besm6/micro-besm/README.md

# micro-besm
Replica of micro-BESM computer

Visit the [Wiki section](https://github.com/besm6/micro-besm/wiki) for details.
