besm6/micro-besm/doc/microbesm-spec.odt

| | | | | | | | | | Микро-БЭСМ Технический проект Ревизия Дата A0 9 октября 2016 г. Авторы: Сергей Вакуленко

# Назначение

Микро-БЭСМ, она же МКБ-8601, она же Ретро-86 — настольный компьютер конца 80-х, совместимый по архитектуре с ЭВМ БЭСМ-6. Он был разработан в конце 80-х в Лаборатории Вычислительной Техники и Автоматизации ОИЯИ в Дубне под руководством Левчановского Ф.В. и Силина И.Н. МКБ-8601 был способен выполнять все программы оригинальной БЭСМ-6, от теста АУ/УУ и до фортранного транслятора. Имел собственную ОС, способную интерпретировать экстракоды ОС Дубна и ОС Диспак. Система команд включала команды старой Б6 и собственный оригинальный набор. Процессор был построен на микросхемах серии K1804 (аналог Am2900).

Настоящий проект ставит задачу повторить микро-БЭСМ на современной элементной базе (FPGA), используя сохранившиеся исходные тексты микрокоманд, тестов и операционной системы.

Миссия проекта:

- Сохранение исторического наследия советской инженерной школы и, в частности, архитектурной линии БЭСМ-6.

Требования к проекту:

- Сохранение программной совместимости, с БЭСМ-6 на уровне системы команд и мониторной системы «Дубна».
- Поддержка 64-битного режима процессора как расширения архитектуры БЭСМ-6.
- Реализация схемотехнической части на языке Verilog (SystemVerilog) и возможность запуска всей системы на симуляторе, включая операционную систему.
- Возможность запуска на современных широко доступных платах FPGA.
- Ценовая доступность компонентов нового БК по цене. Предполагается упор на продажу в виде недорогих комплектов для самостоятельной сборки (конструкторов).
- Открытые исходные тексты и техническая документация;

# Блок-схема процессора

════════100═разрядов═════════════Общая═шина═══════════════════

▲ ▲

х │8 х │64

▼ ▼

┌──────┐ ┌───────────────────────────────┐ ┌────────┐

│ БОИ │ │ Б О И │ │ │

│ тег: │ │ RG0 │ RG1 │ RG2 │ RG3 │ │ ППЗУ │

│1-ком.│ │ физ. │команда│операнд│резуль-│ │ кон- │

│2-oпep│ │ адрес │ л,п │ │ тат │ │ стант │

│3-рез.│ └───────────────────────────────┘ └───┬────┘

└┬───В─┘ ▲ С ▲ В ▲ А │

С│▲ ▲ ┌───┐ │64 │64 │64 │64

││ │ │кэш├─┤ │ ▼ ▼

▼▼ │ └───┘ ▼ ══════Шина═D═══════════════64═разряда════════

прер.│ ┌───────┐ ▲ │ │ ▲ ▲ ▲ ▲

по │ │ станд.│ │ │ │64 │32 │64 │7 │7

тегу │ │команд │ │ │ ▼ │ │ │ │

│ └┬─┬──┬─┘ │ │ ┌─────────┐ ┌─┴─┐ ┌──┴──┐ ┌──┴──┐ ┌──┴──┐

│ │ │ │ 32│ │ │ МПС │ │OЗY│ │сдвиг│ │поиск│ │номер│

│ │4│ │ │ │ │ РЗУ:АЛУ │ │moд│ │ │ │л.ед.│ │ ед. │

│ ▼ │ │20 │ │ ├─────┬┬┬┬┘ └───┘ └─────┘ └─────┘ └─────┘

│ ИP│ ▼ │ │ │ ││││ ▲ ▲ ▲ ▲ ▲

│ │ ┌───┤ │ │ ▼▼▼▼ │ │ │ │ │

│ │ │АК │ │ │ D ┌────┐ │ │ ┌┴─┐ │ │

│8 │8 └───┘ │ │ ◄─┤CYCC│ │32 │64│ПC│ │64 │32

│ │ │ │64 └────┘ │ │ └──┘ │ │

│ │ │ │ ▲ │ │ ▲ │ │

▼ │ ▼ ▼ │4 │ │ │7 │ │

╤═╤════════════Шина═Y═══╤═══╤╧═══╤═╧═64═разряда═══╧═══════╧═══

│ │ ▲ │ ▲ │ │ │ ▲

│ │32 │ └────────│────│───│──┐ │ ┌───┐ │

│ │ │ │ ▼8 │5 │ └►│ ШФ├──┬────┐ ▼

│ │ ┌─┴─┐ ┌───┐ │ ┌───┐ │ │ ├───┤ │ ▼12 ┌──────┐

│ │ │РГ.│ │ │ │ │PHП│ │ └──►│ПHA│ │ ┌────┐ │ ОЗУ │

│ └►│иcп├──►│OЗY│◄─┘ └─┬─┘ ▼ │KOП├──┤ │CYAM│ │oбмена│

│ │aдp│ │пр.│ │ ┌───┐ ├───┤ │ └────┘ └──────┘

│ └─┬─┘ └───┘ ▼ │PHГ│ │ПHA│ │ │◄───┐ ▲

│ │ ┌──────────┐ D └─┬─┘ │i/o├──┤ ▼ │ │

│ └─►│ост.по aдp├──► │ ├───┤ │ ┌────┐ │ ▼

│10 └──────────┘halt 6▼ ┌──►│ПHA│ │ │ППЗY│ │ ┌──────┐

│ ┌►D D vect│int├──┤ │ OЗY│ │ │ блок │

│ │ ┌──────┐ ├───┤ │ │ МП │ ├─┤ связи│

│ │ │ БОБР │ 2 │ПHA│ │ └─┬──┘ │ │ с ПП │

│ ┌──┴──┐ │ БИЗМ │◄───►D │гр.├──┘ │◄───┘ └───┬──┘

└►│ РФС ├──►│──────│ 1 └───┘ ▼ │

└──┬──┘ │ БМСП │◄───►D ┌────┐ ▼

│ └──────┘ │ КР │ к ПП

│ ┌─────┐ ├────┤

│ │ ОЗУ │◄───Y │....│

└─────►│пpиop├───►D ▼....▼

│ стр.│ управление

└─────┘

┌────┐ Y ┌─────┐ КОП ┌──────┐ упр-е

──►│блoк│ ──►│ тай-│ арб.│ │ БОИ,

...│пре-│ │ мер,├─►D ───►│apбитр├──────►

──►│рыв.├───► │часы ├──► │ │магист-

└────┘vест └─────┘прер. └──────┘ ралью

# Формат микрокомандного слова

112 | 111 | 110 | 109 | 108 | 107 | 106 | 105 | 104 | 103 | 102 | 101 | 100 | 99 | 98 | 97 | 96 | 95 | 94 | 93 | 92 | 91 | 90 | 89 | 88 | 87 | 86 | 85
SQI | | | | А | | | | | | | | | | | | МАР | | ALU | ALUD | | | FUNC | | | ALUS

84 | 83 | 82 | 81 | 80 | 79 | 78 | 77 | 76 | 75 | 74 | 73 | 72 | 71 | 70 | 69 | 68 | 67 | 66 | 65 | 64 | 63 | 62 | 61 | 60 | 59 | 58 | 57 | 56
Н | RВ | | | | RА | | | | CI | | SHMUX | | | | SТОРС | | | | | | MOD | MNSA | | MODNM
| | | | | | | | | | | | | | | | | | | | | | PSHF

55 | 54 | 53 | 52 | 51 | 50 | 49 | 48 | 47 | 46 | 45 | 44 | 43 | 42 | 41 | 40 | 39 | 38 | 37 | 36 | 35 | 34 | 33 | 32 | 31 | 30 | 29
DSRC RTIME WTIME | | | | YDST | | | | SHF | | ARBI | | | | RLD | LЕТС | CYSTR | | | SCI | ICI | IСС | ISE | СЕМ | CEN | CSM | WЕМ

28 | 27 | 26 | 25 | 24 | 23 | 22 | 21 | 20 | 19 | 18 | 17 | 16 | 15 | 14 | 13 | 12 | 11 | 10 | 9 | 8 | 7 | 6 | 5 | 4 | 3 | 2 | 1
ЕСВ | WRB | BRA | | ЕСА | WRA | ARA | | YDEV YDEVT | | | WRY | DDEV YDTIM | | | WRD | IОМР | FFCNT | | | | | COND | | | | | MPS
| | | | | | | | | | | | | | | | | | MPADR

Описание полей микрокомандного слова:

Поле | Биты | Ширина | Описание

SQI

112-109

4

Код операции селектора адреса микропрограмм (СУАМ).

0 — JZ, переход по нулевому адресу;

1 — CJS, условный переход к подпрограмме по адресу, подаваемому на вход D СУАМ;

2 — JМАР, переход по адресу D, выработка сигнала /МЕ;

3 — CJP, условный переход по адресу, подаваемому на вход D СУАМ;

4 — PUSH, загрузка стека и условная загрузка счетчика;

5 — JSRP, условный переход к подпрограмме по адресу, выбираемому из регистра/счетчика или со входа D СУАМ;

6 — CJV, условный переход по адресу D, выработка сигнала /VЕ;

7 — JRP, усл. переход по адресу, выбираемому из регистра/счетчика или со входа D СУАМ;

8 — RFCT, повторение цикла, если счетчик не равен 0;

9 — RРСТ, повторение по адресу, подаваемому на вход D СУАМ, если счетчик не равен 0;

10 — CRTN, условный возврат из подпрограммы;

11 — CJPP, условный переход по адресу, подаваемому на вход D СУАМ, и извлечение из стека;

12 — LDCT, загрузка счетчика и последовательная выборка;

13 — LООР, проверка условия окончания цикла;

14 — CONT, последовательная выборка;

15 — TWB, переход по одному из 3 адресов.
A | 108-97 | 12 | Адрес следующей микрокоманды или адрес ПЗУ констант.
МАР | 96-95 | 2 | Выбор источника адреса, поступающего на вход D СУАМ. 0 — РЕ, конвейерный регистр; 1 — МЕ, ПНА КОП основного или дополнительного формата, в зависимости от КОП основного формата (3FН = 077В); 2 — GRP, ПНА групп и микропрограммные признаки "След0" И "След1"; 3 — не используется (по умолчанию).
ALU | 94 | 1 | Разрешение выдачи информации из МПС на шину Y. По умолчанию — нет вывода (0).
ALUD | 93-91 | 3 | Управление приемниками результата АЛУ МПС. По умолчанию — нет загрузки в регистры (1). 0 — Q, загрузка в регистр Q; 1 — NО, выдача результата только на выход У, содержитое регистров не изменяется; 2 — ВА, загрузка в регистр в рзу, на выход У подается значение регистра А; 3 — В, загрузка в регистр в РЗУ; 4 — RSBQ, сдвиг вправо, загрузка F/2 в В, Q/2 в Q; 5 — RSB, сдвиг вправо, загрузка F/2 в В; 6 — LSBQ, сдвиг влево, загрузка 2F в В, 2Q в Q; 7 — LSB, сдвиг влево, загрузка 2F в В.
FUNC | 90-88 | 3 | Код операции АЛУ МПС. 0 — ADD, R + S + С0; 1 — SUBR, S − R − 1 + С0; 2 — SUBS, R − S − 1 + С0; 3 — OR, R | S; 4 — AND, R & S; 5 — NOTRS, ~R & S; 6 — EXOR, R ^ S; 7 — EXNOR, ~(R ^ S).
ALUS | 87-85 | 3 | Управление источниками операндов на входы АЛУ. 0 — AQ; 1 — АВ; 2 — ZQ; 3 — ZВ; 4 — ZА; 5 — DА; 6 — DQ; 7 — DZ.
Н | 84 | 1 | Управление числом разрядов, участвующих в операции АЛУ: 32 или 64. По умолчанию — 32 разряда (0).
RВ | 83-80 | 4 | Адрес регистра канала B МПС. По умолчанию — регистр WR6 (10). 64-разрядные регистры: 0 — А, сумматор; 1 — У, регистр младших разрядов; 2 — INTR, ГРП; 32-разрядные регистры (старшие 32 разряда не используются): 3 — РС, СЧАС; 4 — РССОРУ, РОП; 5 — DADR, ИАОП; Рабочие константы микропрограмм: 6 — HALF, FFFF_FFFF_0000_0000; 7 — ВУТЕ, 0000_0000_0000_00FF; 8 — EXPN, FFF0_0000_0000_0000; 9 — MANT, 000F_FFFF_FFFF_FFFF; Рабочие регистры микропрограмм: 10 — WR6, номер прерывания при внутренних прерываниях; 11 — WR5, данные при чт/зп в часы, таймеры СВ; 12 — WR4; 13 — WR3; 14 — WR2; 15 — WR1.
RА | 79-76 | 4 | Адрес регистра канала A МПС. (Аналогично RB выше)
CI | 75-74 | 2 | Управление входным переносом C0 АЛУ МПС, разряды I12-I11. 0 — CI0, С0 МПС = 0; 1 — CI1, С0 МПС = 1; 2 — CIX, С0 МПС = СХ; 3 — CIC, входной перенос с0 принимает значения NС, /NС, МС, /МС в зависимости от кодов операции I5-I1 СУСС.

SHMUX

73-70

4

Управление организацией сдвигов в МПС, разряды I9-I6 КОП СУСС.

Направление сдвига I10 задается разрядом I7 МПС.

Сдвиги вправо при I10=0:

0 — LSLSL, логический сдвиг вправо одинарный, освобождающийся разряд заполняется "0", МС не изменяется;

1 — NSNSL, сдвиг вправо одинарный, МС не изменяется, освобождающийся разряд заполняется "1";

2 — ASLLS, РЗУ: логический сдвиг вправо, освобождающийся разряд заполняется "0", выдвинутый бит попадает в МС; Q: арифметический сдвиг вправо, освобождающийся разряд заполняется значением MN; используется с К1804ВС2 при операции нормализации чисел обычной длины в качестве последнего шага нормализации (сдвиг в сторону младших разрядов);

3 — NDNS, сдвиг вправо двойной, освобождающиеся разряды заполняются "1", МС не изменяется;

4 — CDLDL, сдвиг вправо двойной, освобождающиеся разряды заполняются значением МС, МС не изменяется;

5 — ADNDL, арифметический сдвиг вправо двойной, МС не изеняется, освобождающиеся разряды заполняются значением MN; используется с К1804ВС2 при нормализации чисел двойной длины;

6 — LDLD, логический сдвиг вправо двойной, освобождающиеся разряды заполняются "0", МС не изменяется;

7 — LDLND, логический сдвиг вправо двойной, освобождающиеся разряды заполняются "0", выдвинутый из Q бит записывается в МС;

8 — RSLRSL, циклический сдвиг вправо одинарный, выдвинутый из РЗУ бит записывается в МС;

9 — RSSRSS, РЗУ: циклический сдвиг вправо совместно с содержимым МС, освобождающийся разряд заполняется значением МС, выдвинутый бит попадает в МС; Q: циклический сдвиг вправо;

10 — RSRS, циклический сдвиг вправо одинарный, МС не изменяется;

11 — IDCS, двойной сдвиг вправо с загрузкой в освобождающийся разряд значения IС (выходной перенос МПС), МС не изменяется; используется в повторяющихся микрокомандах сложения и сдвига при умножении и усреднении в арифметике без знака;

12 — RDSRDS, циклический сдвиг вправо двойной совместно с содержимым МС, освобождающийся разряд заполняется значением МС, выдвинутый разряд попадает в МС;

13 — RDLRDL, Циклический сдвиг вправо двойной, выдвинутый из Q разряд попадает в МС и старший разряд РЗУ;

14 — VDCD, двойной сдвиг вправо с загрузкой значения IN^IV в освобождающийся разряд, МС не изменяется; используется в повторяющихся микрокомандах сложения и сдвига в двоичной дополнительной арифметике (при умножении);

15 — RDRD, циклический сдвиг вправо двойной, МС не изменяется.

Сдвиги влево при I10=1:

0 — LSLSL, логический сдвиг влево одинарный с загрузкой МС, освобождающийся разряд заполняется "0";

1 — NSNSL, сдвиг влево одинарный с загрузкой МС, освобождающийся разряд заполняется "1";

2 — ASLLS, логический сдвиг влево одинарный, МС не изменяется, освобождающиеся разряды заполняются "0";

3 — NDNS, сдвиг влево одинарный, освобождающиеся разряды заполняются "1", МС не изменяется;

4 — CDLDL, сдвиг влево двойной с загрузкой МС, освобожд. разряды заполняются "0";

5 — ADNDL, сдвиг влево двойной с загрузкой МС, освобожд. разряды заполняются "1";

6 — LDLD, сдвиг влево двойной, освобождающиеся разряды заполняются "0", МС не изменяется;

7 — LDLND, сдвиг влево двойной, освобождающиеся разряды заполняются "1", MC не изменяется;

8 — RSLRSL, циклический сдвиг влево одинарный с загрузкой MC;

9 — RSSRSS, циклический сдвиг влево одинарный совместно с MC, освобождающийся разряд заполняется значением MC, выдвинутый разряд попадает в MC;

10 — RSRS, циклический сдвиг влево одинарный, MC не изменяется;

11 — IDCS, сдвиг влево одинарный, MC не изменяется, РЗУ: освобождающийся разряд заполняется значением MC; Q: освобождающийся разряд заполняется "0";

12 — RDSRDS, циклический сдвиг влево двойной совместно с содержимым MC, освобождающийся разряд заполняется значением MC, выдвинутый разряд попадает в MC;

13 — RDLRDL, циклический сдвиг влево двойной, выдвинутый бит попадает в MC и в освобождающийся разряд Q;

14 — VDCD, сдвиг влево двойной, MC не изменяется, освобождающиеся разряды заполняются значением MC;

15 — RDRD, циклический сдвиг влево двойной, MC не изменяется.

SТОРС

69-64

6

Разряды I5-I0 КОП СУСС, управляющие:

- микромашинным статусным регистром N;

- машинным статусным регистром М;

- выходом У;

- выходом кода условия;

- входным переносом С0 АЛУ МПС.

0 — УТОМ, MTON;

1 — SЕТМ, SETN;

2 — MCN, NСМ;

3 — CLRN, CLRM;

5 — INVM;

7 — ОРС7;

8 — CLRNZ;

9 — SETNZ;

10 — CLRNC;

11 — SETNC;

12 — CLRNN;

13 — SETNN;

14 — CLRNV;

15 — SETNV;

18 — ОРС18;

19 — ОРС19;

20 — NZ, по умолчанию;

21 — /NZ;

22 — NV;

23 — /NV;

26 — NС;

27 — /NС;

30 — NN;

31 — /NN;

32 — ОРС32;

33 — ОРС33;

34 — ОРС34;

36 — MZ;

37 — /MZ;

38 — MV;

39 — /MV;

42 — МС;

43 — /МС;

46 — MN;

47 — /MN;

52 — IZ;

53 — /IZ;

54 — IV;

55 — /IV;

58 — IС;

59 — /IС;

62 — IN;

63 — /IN.
MOD | 63 | 1 | Режим привилегированных команд 002 и 032, разрешающий обращение к специальным регистрам.
PSHF | 62-56 | 7 | Параметр сдвига сдвигателя, задающий число сдвигов и направление. 0x40 - SН0, параметр сдвига на 0 разрядов
MNSA | 62-61 | 2 | Адрес источника номера модификатора. По умолчанию — отсутствующий источник (2). 0 — U, регистр исполнительного адреса; 1 — IRA, поле модификатора команды; 3 — МР, микропрограмма.

MODNM

60-56

5

Номер модификатора в группе регистров, используемый в микропрограмме. Регистры 8-3 - область упрятывания регистров общего назначения и рабочие регистры микропрограмм.

0 — MREZ, резерв;

1 — PROCNC, номер процесса, равен содержимому РНП у активного процесса;

2 — SVFA, регистр адреса поля упрятывания;

3 — РССС, РОП;

4 — РСС, СЧаС;

5 — YCR, правая половина РМР;

6 — YCL, левая половина РМР;

7 — ACR, правая половина сумматора;

8 — ACL, левая половина сумматора;

9 — CTR, регистр счетного времени процесса, правая половина;

10 — CTL, регистр счетного времени процесса, левая половина;

11 — СТТ, таймер счетного времени процесса;

12 — SPRADR, указатель стека адресов возврата из подпрограмм РАВ;

13 — RRR, расширение регистра режимов, содержащее область упрятывания тега результата, номер предыдущей группы регистров и номер резервной группы регистров;

14 — RR, регистр режимов;

15 — С, регистр изменения адреса;

16 — SР, указатель магазина;

17 — М14;

18 — М13;

19 — М12;

20 — М11;

21 — М10;

22 — М9;

23 — М8;

24 — М7;

25 — М6;

26 — М5;

27 — М4;

28 — М3;

29 — М2;

30 — М1;

31 — М0.
DSRC | 55-52 | 4 | Управление источниками информации на шину D. 1 — MODGN, регистр номера группы ОЗУ модификаторов; 2 — PROCN, регистр номера процесса; 3 — CNT, триггеры признаков; 4 — PHYSPG, регистр физической страницы; 5 — ARBOPC, регистр КОП арбитра (для анализа при прерываниях); 8 — СОМА, адресная часть команды; 9 — SHIFT, результат сдвига; 10 — ОРС, код операции команды; 11 — LOS, результат поиска левой единицы; 12 — PROM, ППЗУ констант.
RTIME | 55-52 | 4 | Управление чтением информации с часов и таймера счетного времени. 14 — RТ, сигнал чтения часов, таймеров на шину У.
WTIME | 55-52 | 4 | Управление записью информации в часы и таймер счетного времени. 15 — WТ, сигнал записи в часы, таймеры с шины У (совместно с сигналом WRD).
YDST | 51-48 | 4 | Управление приемниками информации с шины Y ЦП. 1 — MODGN, регистр номера группы ОЗУ модификаторов; 2 — PROCN, регистр номера процесса РНП; 3 — CNT, регистр режимов и триггеры признаков; 4 — PHYSPG, регистр физической страницы РФС; 5 — ARBOPC, КОП арбитра (для пультового останова); 8 — ADRREG, регистр исполнительного адреса (запись); 9 — PSHIFT, регистр параметра сдвига (только запись); 10 — CCLR, запуск сброса кэша.
SHF | 47-46 | 2 | Код операции сдвигателя. 0 — CICL, циклический сдвиг вправо; 1 — LOG, логический сдвиг; 2 — ARIPH, арифметический сдвиг; 3 — EMULF, "расхлопывание" - переход к формату БЭСМ-6.
ARBI | 45-42 | 4 | Код операции арбитра общей шины. 1 — CCRD, чтение кэша команд; 2 — CCWR, запись в кэш команд; 3 — DCRD, чтение кэша операндов; 4 — DCWR, запись в кэш операндов; 8 — FЕТСН, чтение команды; 9 — DRD, чтение операнда; 10 — DWR, запись результата (не используется); 11 — RDMWR, чтение-модификация-запись (семафорная); 12 — BTRWR, запись в режиме блочной передачи; 13 — BTRRD, чтение в режиме блочной передачи; 14 — BICLR, сброс прерываний на шине; 15 — BIRD, чтение прерываний с шины.
RLD | 41 | 1 | Управление загрузкой регистра селектора адреса СУАМ и ШФ шин У ЦП и D СУАМ.
LЕТС | 40 | 1 | Управление прохождением признака ПИА на вход ПНА команд.
CYSTR | 39-37 | 3 | Управление длительностью тактового импульса. 1 — NТ3, 3 нанотакта; 0 — NТ4, 4 нанотакта; 4 — NТ5, 5 нанотактов; 6 — NТ6, 6 нанотактов; 2 — NТ7, 7 нанотактов; 3 — NТ8, 8 нанотактов; 7 — NТ9, 9 нанотактов; 5 — NТ10, 10 нанотактов = 500 нсек (по умолчанию).
SCI | 36 | 1 | Управление передачей условия на вход инкрементора регистра адреса микропрограммы. Условие, выбираемое полем COND, подается на вход CI СУАМ ("жду").
ICI | 35 | 1 | Инверсия условия, передаваемого на вход инкрементора регистра адреса микропрограммы (CI) СУАМ.
IСС | 34 | 1 | Инверсия условий, выбираемых полем COND, управляющих последовательностью исполнения микрокоманд.
ISE | 33 | 1 | Разрешение внешних и внутренних прерываний. Признак последней микроинструкции, разрешающий прохождение некоторых прерываний и копирование ТКК в ППК.
СЕМ | 32 | 1 | Разрешение записи в машинный регистр состояния М СУСС.
CEN | 31 | 1 | Разрешение записи в микромашинный регистр состояния N СУСС.
CSM | 30 | 1 | Управление обращением к ОЗУ модификаторов.
WЕМ | 29 | 1 | Разрешение записи в ОЗУ модификаторов.
ЕСВ | 28 | 1 | Выбор канала B БОИ данных.
WRB | 27 | 1 | Запись по каналу B в БОИ данных и БОИ тега.
BRA | 26-25 | 2 | Адрес регистра канала B БОИ даннных и БОИ тега. По умолчанию — 3 (чтобы не было случайной записи в RG0). 0 — RG0, физический адрес, в БОИ тега не используется; 1 — RG1, регистр левой-правой команды, в БОИ тега - тег команды; 2 — RG2, регистр операнда, в БОИ тега - тег операнда; 3 — RG3, регистр результата, в БОИ тега - тег результата (сумматора).
ЕСА | 24 | 1 | Выбор канала A БОИ данных.
WRA | 23 | 1 | Запись по каналу A в БОИ данных.
ARA | 22-21 | 2 | Адрес регистра канала A БОИ даннных. По умолчанию — 3 (чтобы не было случайной записи в RG0). 0 — RG0, физический адрес; 1 — RG1, регистр левой-правой команды; 2 — RG2, регистр операнда; 3 — RG3, регистр результата.
YDEV | 20-18 | 3 | Выбор источника или приемника информации с шины Y, управление — WRY. 2 — PHYSAD, физический адрес (только на чтение); 3 — RADRR, регистр исполнительного адреса (чтение); 4 — PSMEM, ОЗУ приписок (CS); 5 — МРМЕМ, ОЗУ обмена с ПП; 6 — SТОРМ0, ОЗУ останова 0 (только на запись); 7 — SТОРМ1, ОЗУ останова 1 (только на запись). Выборка ОЗУ останова совмещена с сигналом записи.
YDEVT | 20-18 | 3 | Выбор регистров БОИ тега, управление — WRB. 1 — ECBTAG, канал B БОИ тега (сигнал ЕСВ БОИ).
WRY | 17 | 1 | Запись в источники или приемники шины Y.
DDEV | 16-14 | 3 | Выбор источника или приемника информации с шины D, управление — WRD. 1 — ВВ, БОБР, БИЗМ; 2 — MODB, БМСП; 3 — CLRCD, сброс ПИА, дополнительный сигнал; 5 — STATUS, СУСС; 6 — РРМЕМ0, ОЗУ приоритетов страниц 0; 7 — РРМЕМ1, ОЗУ приоритетов страниц 1.
YDTIM | 16-14 | 3 | Выбор часов и таймера счетного времени, управление — RTIME, WTIME, WRD. 4 - CTIME, регистр и таймер счетного времени (сигнал CS).
WRD | 13 | 1 | Управление записью в источники или приемники шины D.
IОМР | 12 | 1 | Выбор дешифратора триггеров признаков или блока обмена с ПП, управляющих сигналов часов и таймера счетного времени (YDTIM=CTIME). 0 — Работает дешифратор триггеров признаков (FFCNT); 1 — Обмен с ПП в соответствии с MPADR, а также обращение к часам и таймеру счетного времени (при YDTIM=CTIME).

FFCNT

11-7

5

Установка/сброс триггеров признаков или управляющие сигналы А1, А0 для обращения к часам и таймеру.

1 — LOGGRP, установка логической группы;

2 — MULGRP, установка группы умножения;

3 — ADDGRP, установка группы сложения;

5 — SЕТС, установка триггера ПИА;

6 — CLRRCB, сброс триггера ППК;

7 — SETRCB, установка триггера ППК;

8 — CLRJMP, сброс триггера ППУ;

9 — SETJMP, установка триггера ППУ;

10 — SETEI, сброс маски прерываний (разрешение прерываний);

11 — CLREI, установка маски прерываний (запрет прерываний);

12 — CLRTR0, сброс микропрограммного признака "След0";

13 — SETTR0, установка мп признака "След0";

14 — CLRTR1, сброс мп признака "След1";

15 — SETTR1, установка мп признака "След1";

16 — CLRCT, сброс прерывания от часов счетного времени;

17 — CLRCTT, сброс прерывания от таймера счетного времени;

18 — CLRTKK, сброс триггера коммутации команд - ТКК (ППК стандартизатора);

19 — SЕТТКК, установка ТКК;

20 — SETNR, установка НР;

21 — STRTLD, запуск загрузки ОЗУ БМСП единицами;

22 — SETER, установка РЭ;

23 — СНТКК, переброс ТКК (работает в счетном режиме!);

24 — SETHLT, установка триггера "Останов" (Halt);

25 — CLRINT, сброс прерываний (кроме прерываний от таймеров);

26 — CLRRUN, сброс триггера "Пуск";

27 — RDMPCP, установка признака "ОЗУ обмена ПП -> ЦП прочитано";

28 — LDMPCP, установка признака "в ОЗУ обмена ПП -> ЦП есть информация";

29 — LDCPMP, установка признака "в ОЗУ обмена ЦП -> ПП есть информация";

30 — PRGINT, установка программного прерывания с номером 31;

31 — EXTINT, установка внешнего прерывания на магистраль.
MPADR | 10-7 | 4 | Адрес регистра в блоке обмена с ПП. Информационные байты обращений ЦП к ПП (используются ОС через WMOD): 0 — INFB1; 1 — INFB2; 2 — FСР, флаг для ПП по инициативе ЦП; 3 — FМР, флаг ПП-ЦП по инициативе ПП. Байты адреса регистра или внутренней памяти ЦП при обращениях ПП (в младшем по номеру регистре - старший байт адреса): 4 — ADRB1; 5 — ADRB2; 6 — ADRB3; 7 — ADRB4. Байты данных при обращениях ПП (в младшем по номеру регистре - старший байт данных): 8 — DАТАВ1; 9 — DАТАВ2; 10 — DАТАВ3; 11 — DАТАВ4; 12 — DАТАВ5; 13 — DАТАВ6; 14 — DАТАВ7; 15 — DАТАВ8.

COND

6-2

5

Выбор условия, подлежащего проверке.

0 — YES, "да";

1 — NORMB, блокировка нормализации (БНОР);

2 — RNDB, блокировка округления (БОКР);

3 — OVRIB, блокировка прерывания по переполнению (БПП);

4 — BNB, блокировка выхода числа за диапазон БЭСМ-6 (ББЧ);

5 — OVRFTB, блокировка проверки переполнения поля упрятывания (БППУ);

6 — DRG, режим диспетчера;

7 — EMLRG, режим эмуляции;

8 — RСВ, ППК;

9 — СВ, ПИА;

10 — CEMLRG, РЭС, 20-й разряд РР (резерв);

11 — СТ, сигнал СТ СУСС;

12 — TR1, След1;

13 — INTSTP, ПОП;

14 — IR15, ИР15;

15 — ТККВ, ТКК;

16 — RUN, "пуск" от ПП;

17 — NMLRDY, отсутствие готовности умножителя;

19 — INT, признак наличия прерываний;

20 — FULMEM, ОЗУ БМСП единицами заполнено;

21 — ARBRDY, готовность арбитра;

22 — TR0, След0;

23 — СРМР, ОЗУ обмена "ЦП -> ПП" свободно.
MPS | 1 | 1 | Управление выбором источника параметра сдвига. Задание параметра сдвига из микропрограммы, 56-62 разряды (1) или из регистра параметра сдвига (0).
