besm6/micro-besm/doc/schematics/page5a.pdf

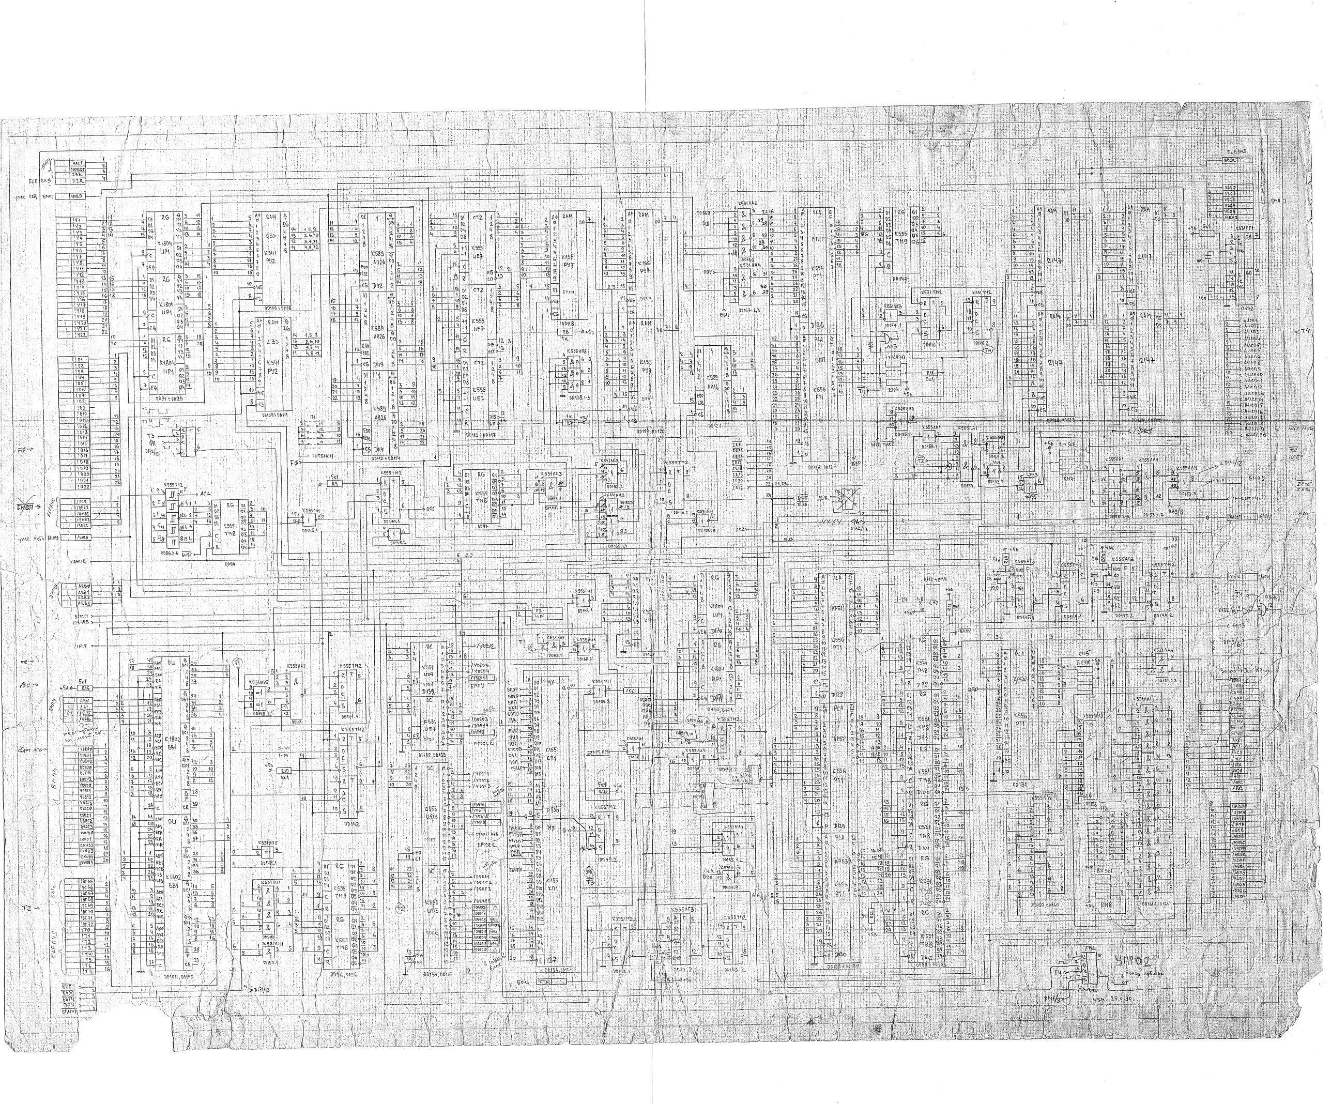
[picture p1: page 1]
