besm6/micro-besm/doc/schematics/page5b.pdf

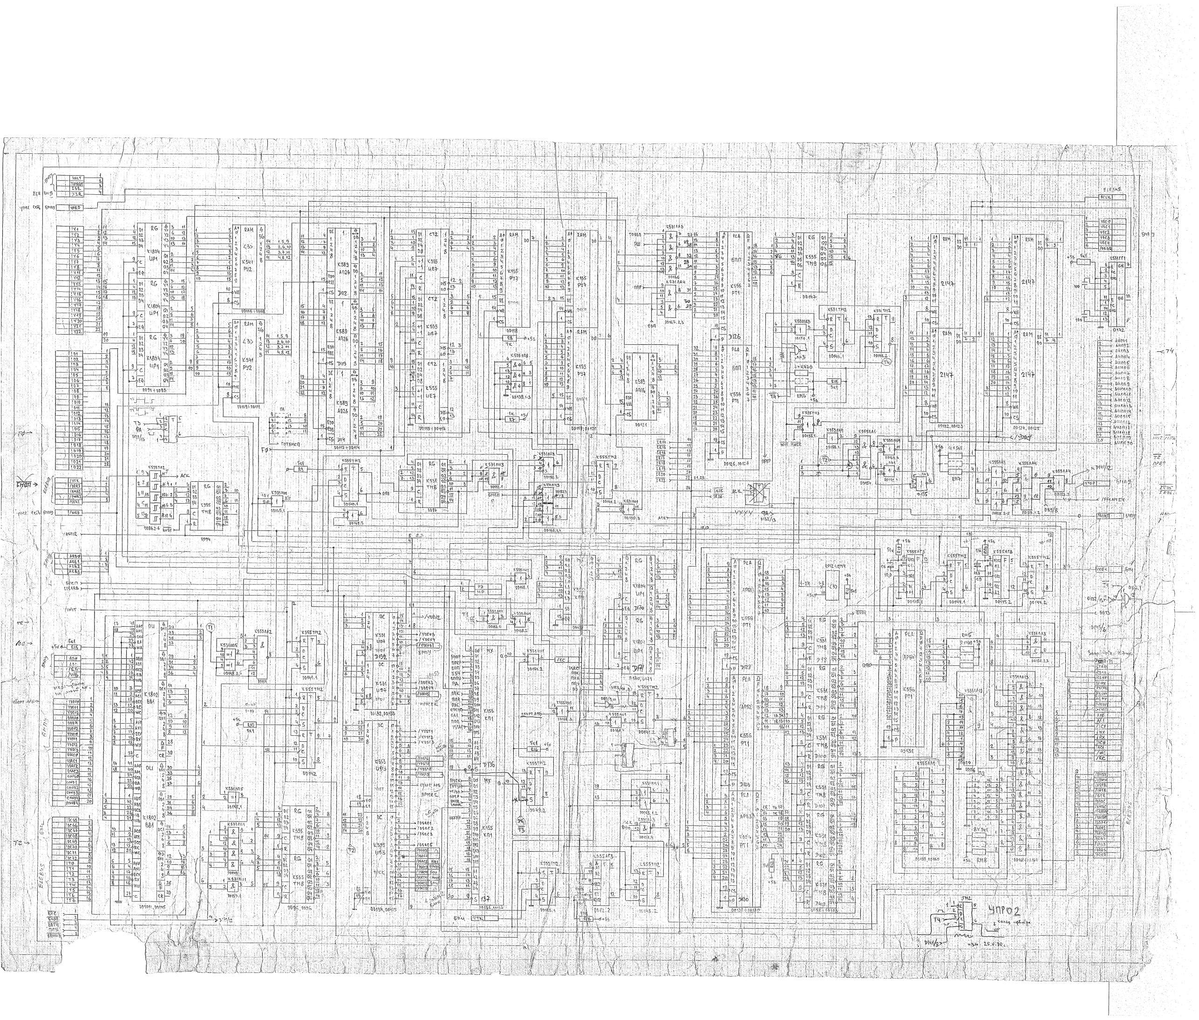
[picture p2: page 1]
