besm6/micro-besm/doc/schematics/page6.pdf

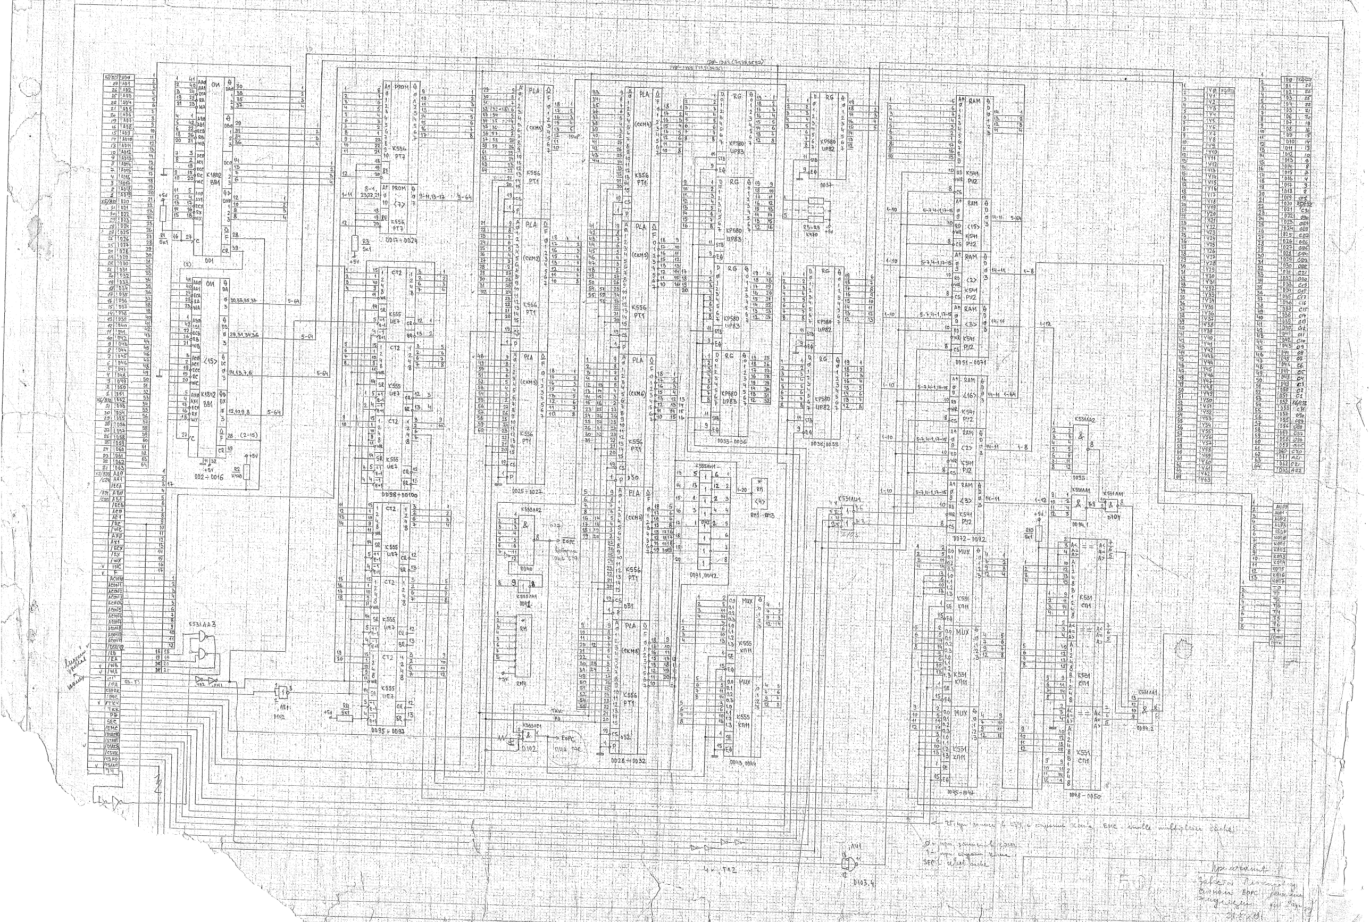
[picture p3: page 1]
