besm6/micro-besm/doc/schematics/page7.pdf

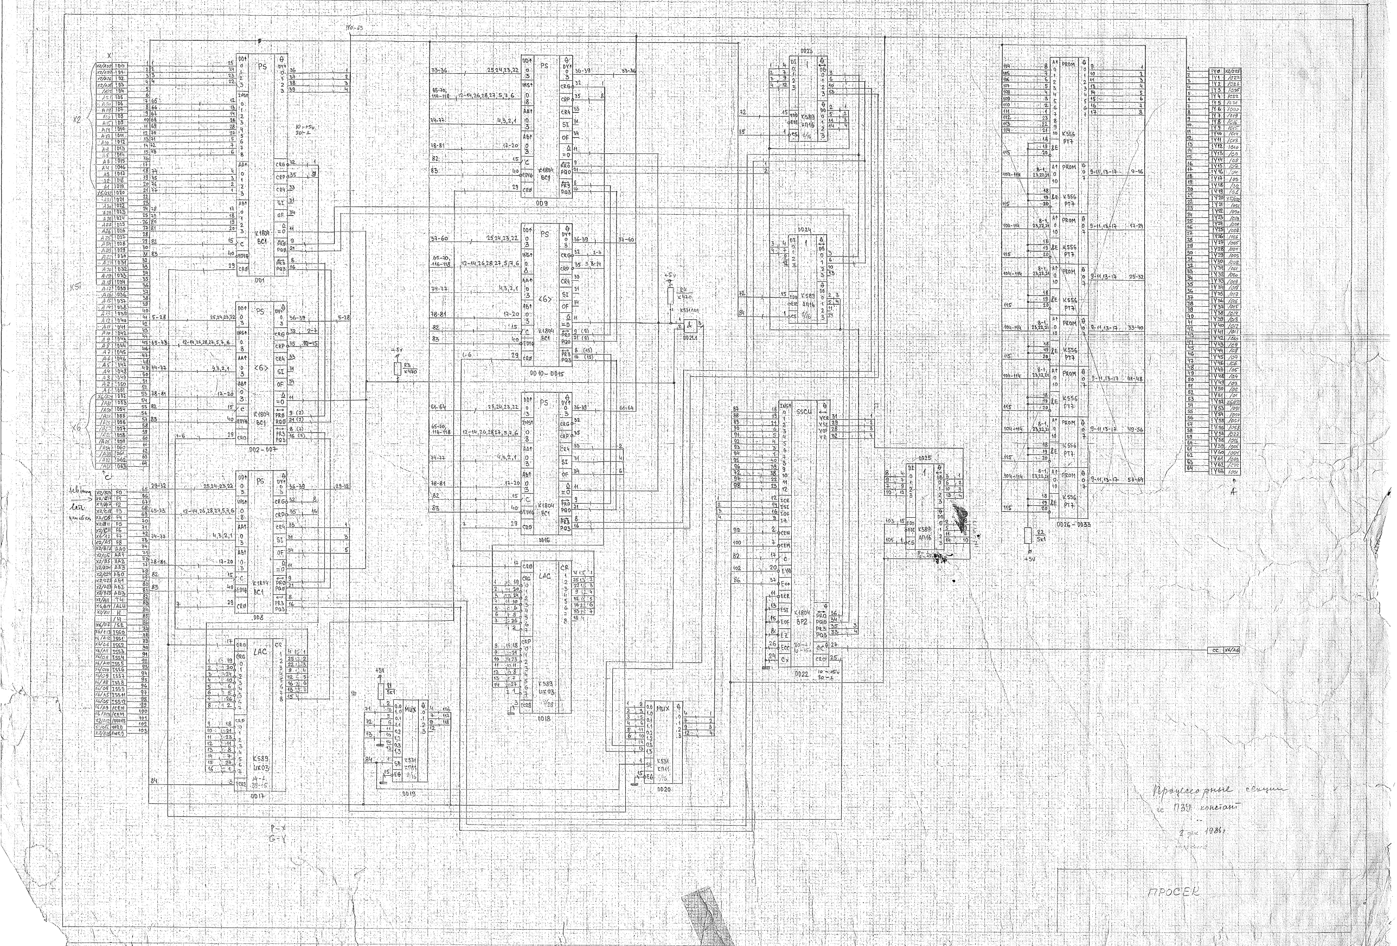
[picture p4: page 1]
