besm6/micro-besm/doc/schematics/page8a1.pdf

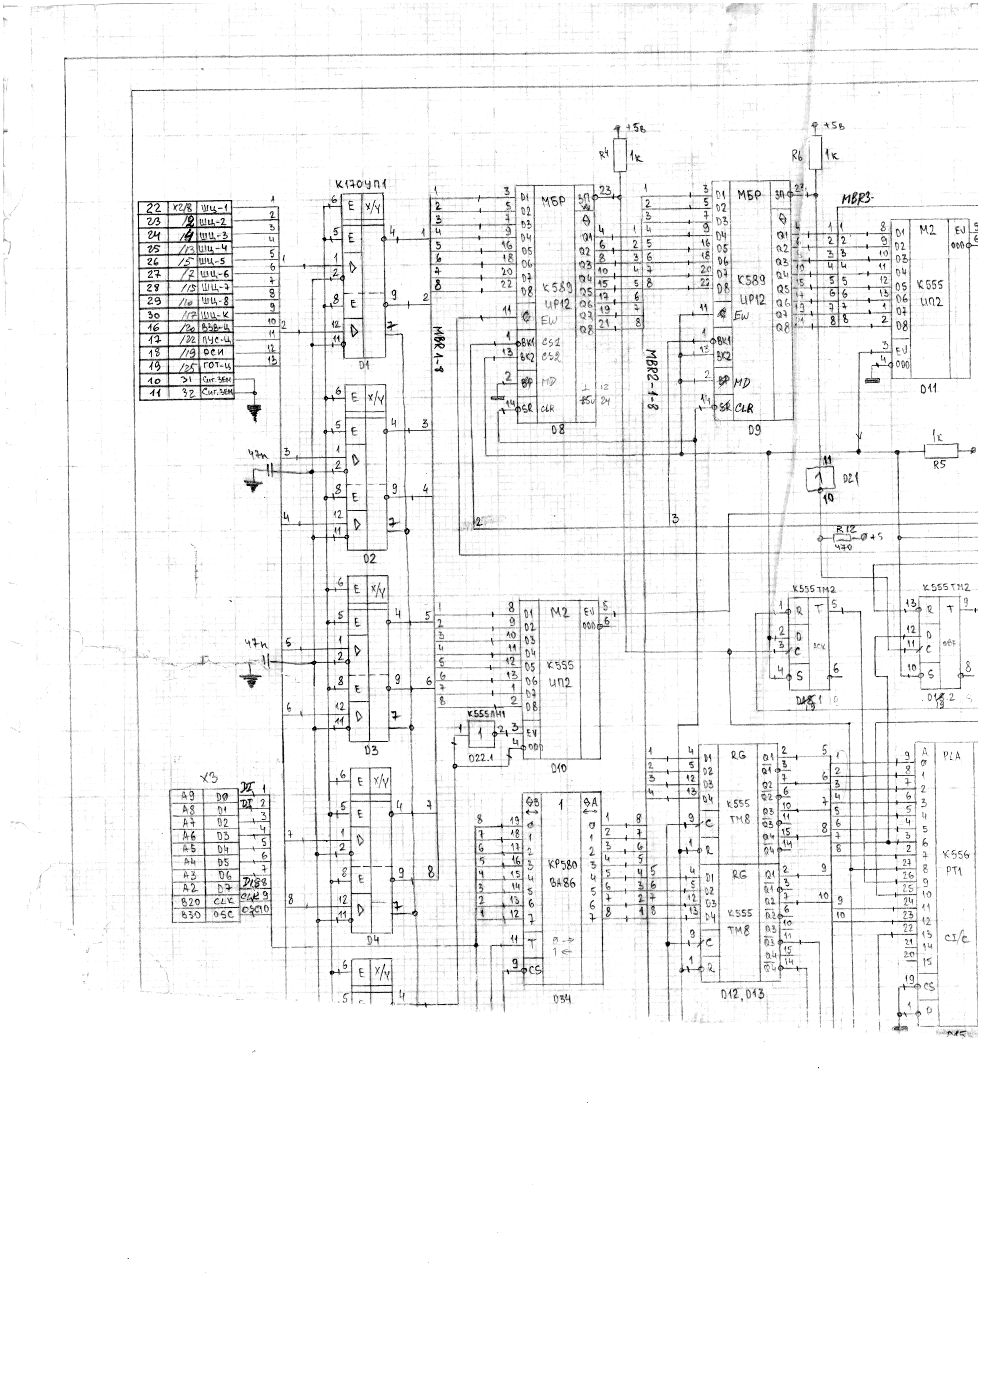
[picture p5: page 1]
