besm6/micro-besm/doc/schematics/page8a2.pdf

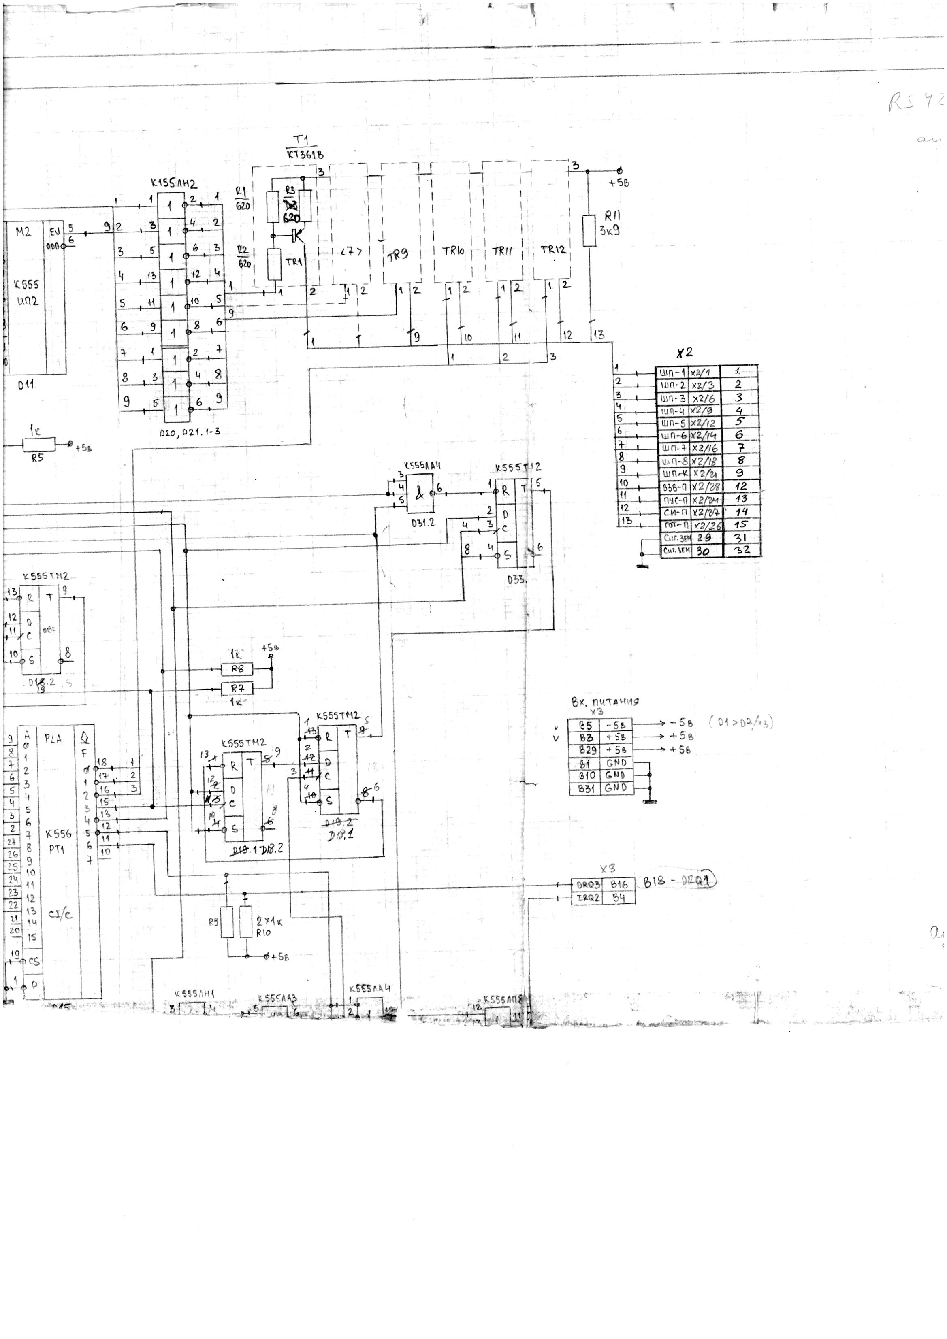
[picture p6: page 1]
