besm6/micro-besm/doc/schematics/page8a3.pdf

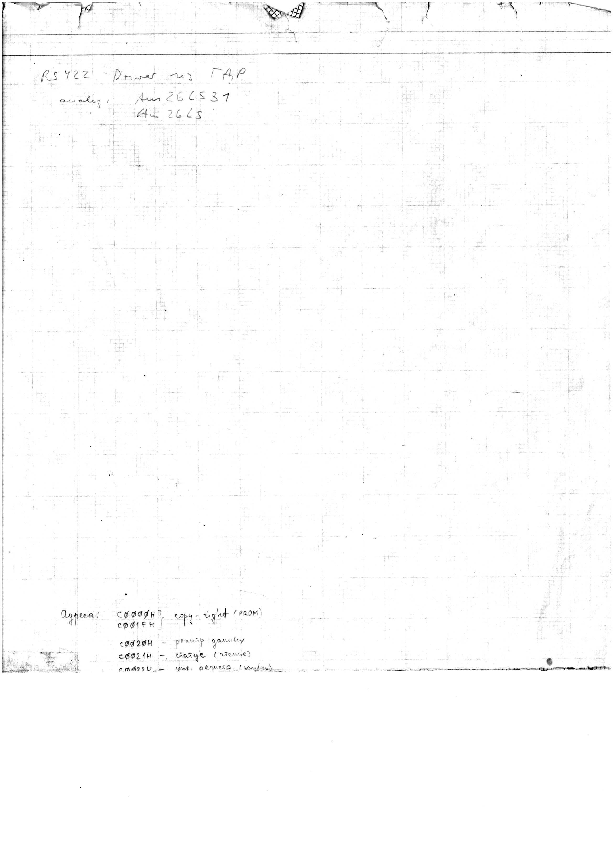
[picture p7: page 1]
