besm6/micro-besm/doc/schematics/page8b1.pdf

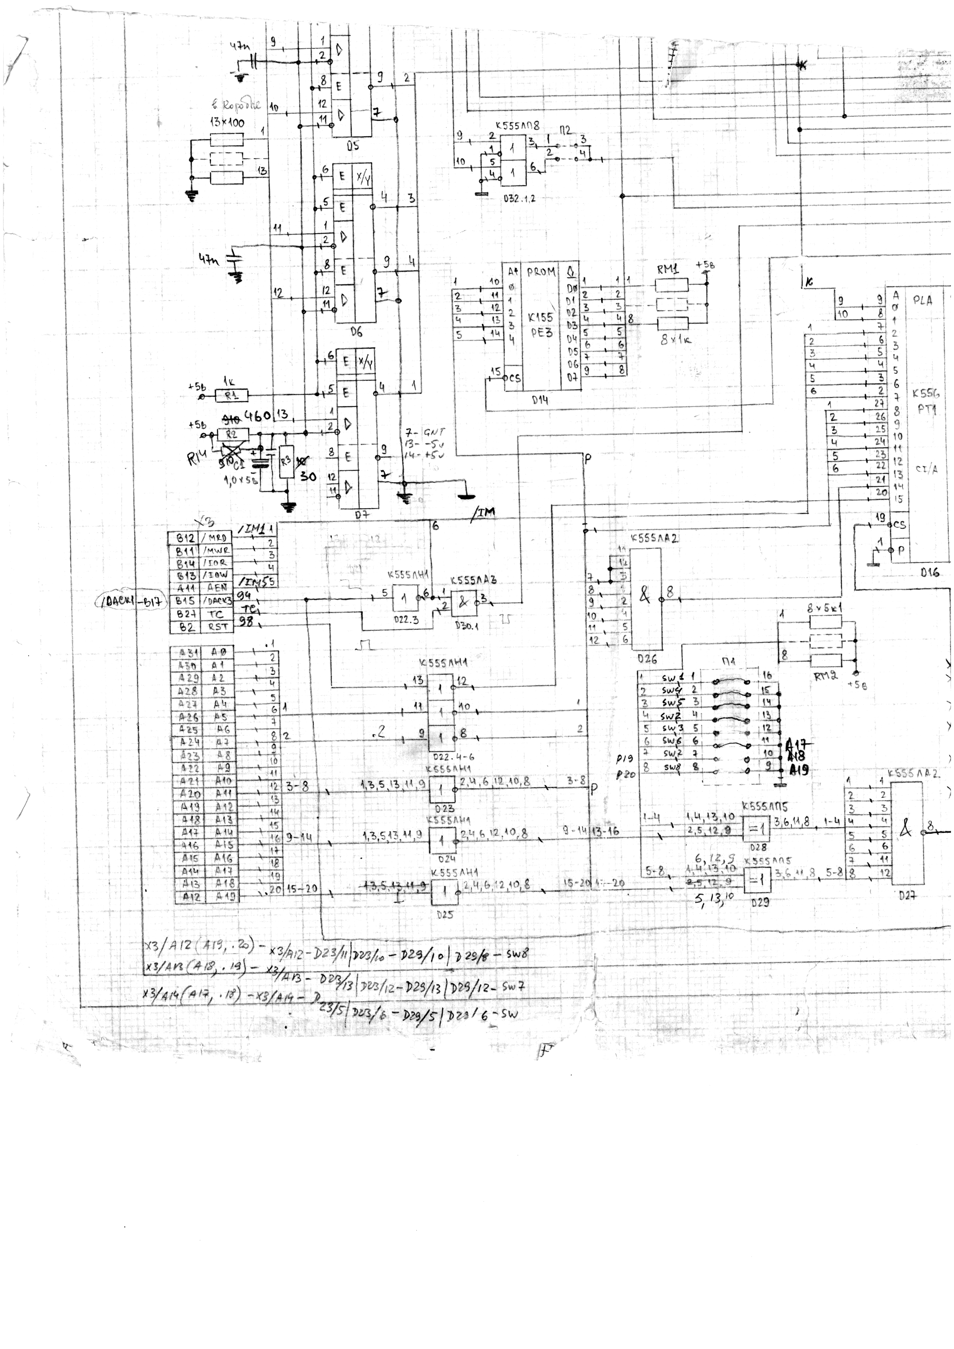
[picture p8: page 1]
