besm6/micro-besm/doc/schematics/page8b2.pdf

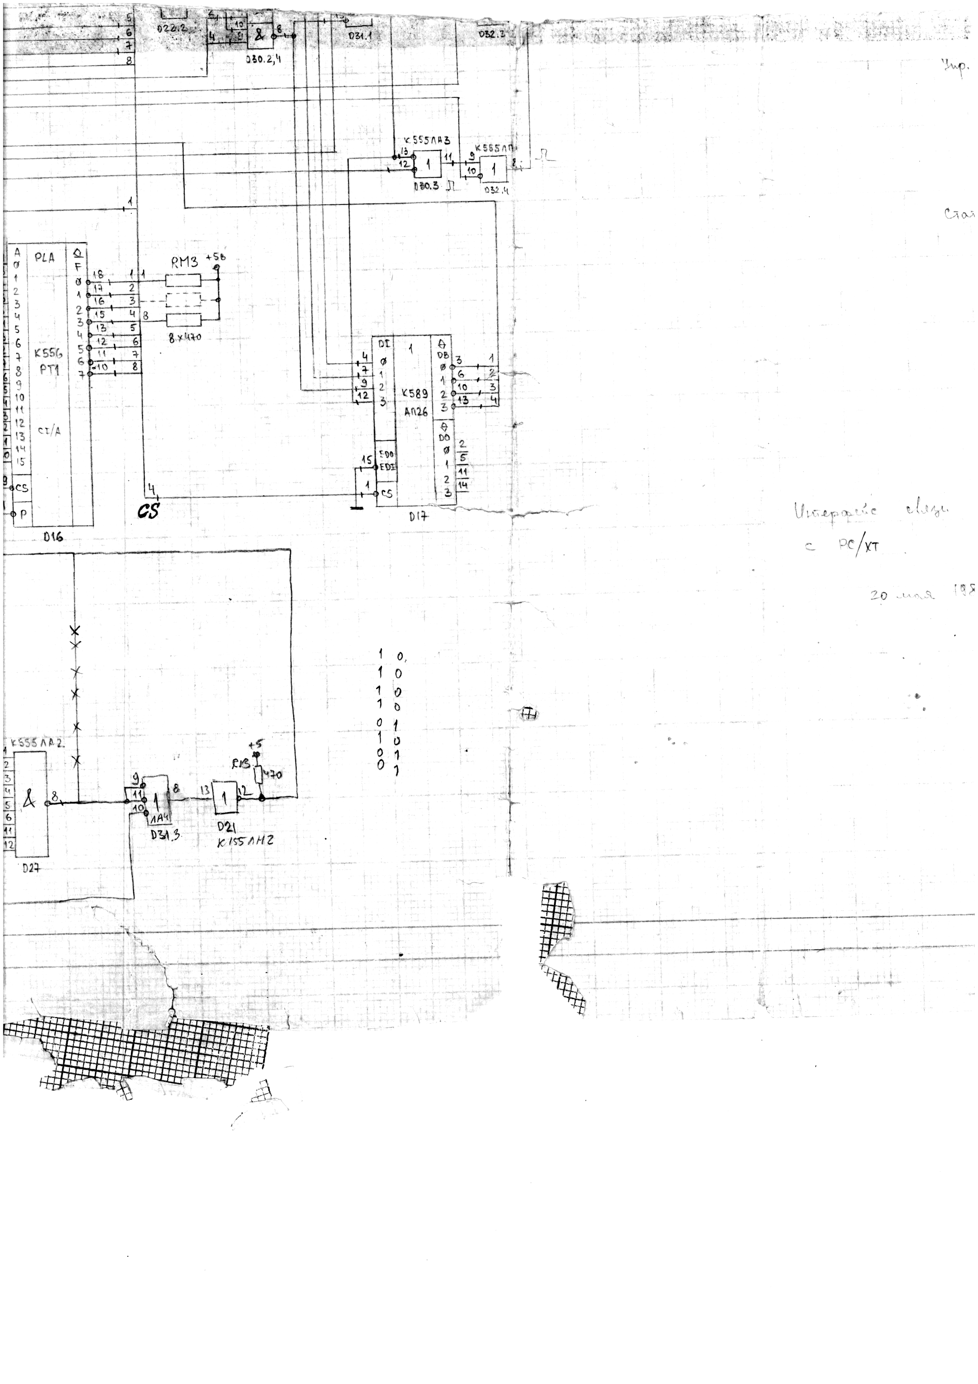
[picture p9: page 1]
