besm6/micro-besm/doc/schematics/page8b3.pdf

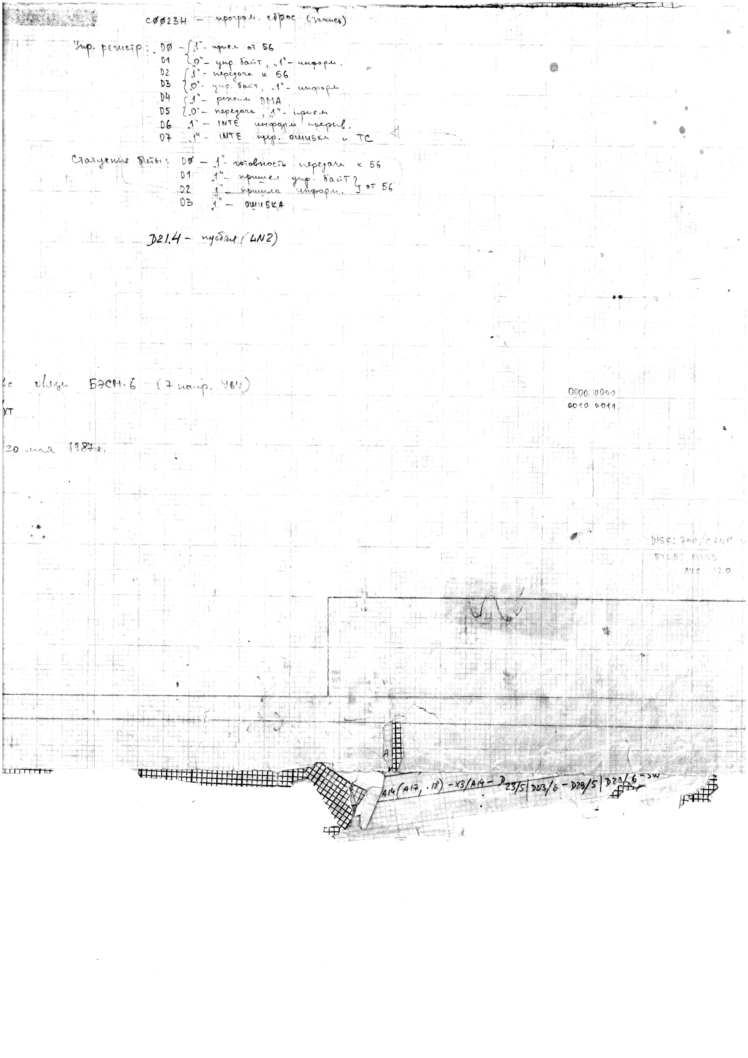
[picture p10: page 1]
