besm6/micro-besm/doc/schematics/page1a1.pdf

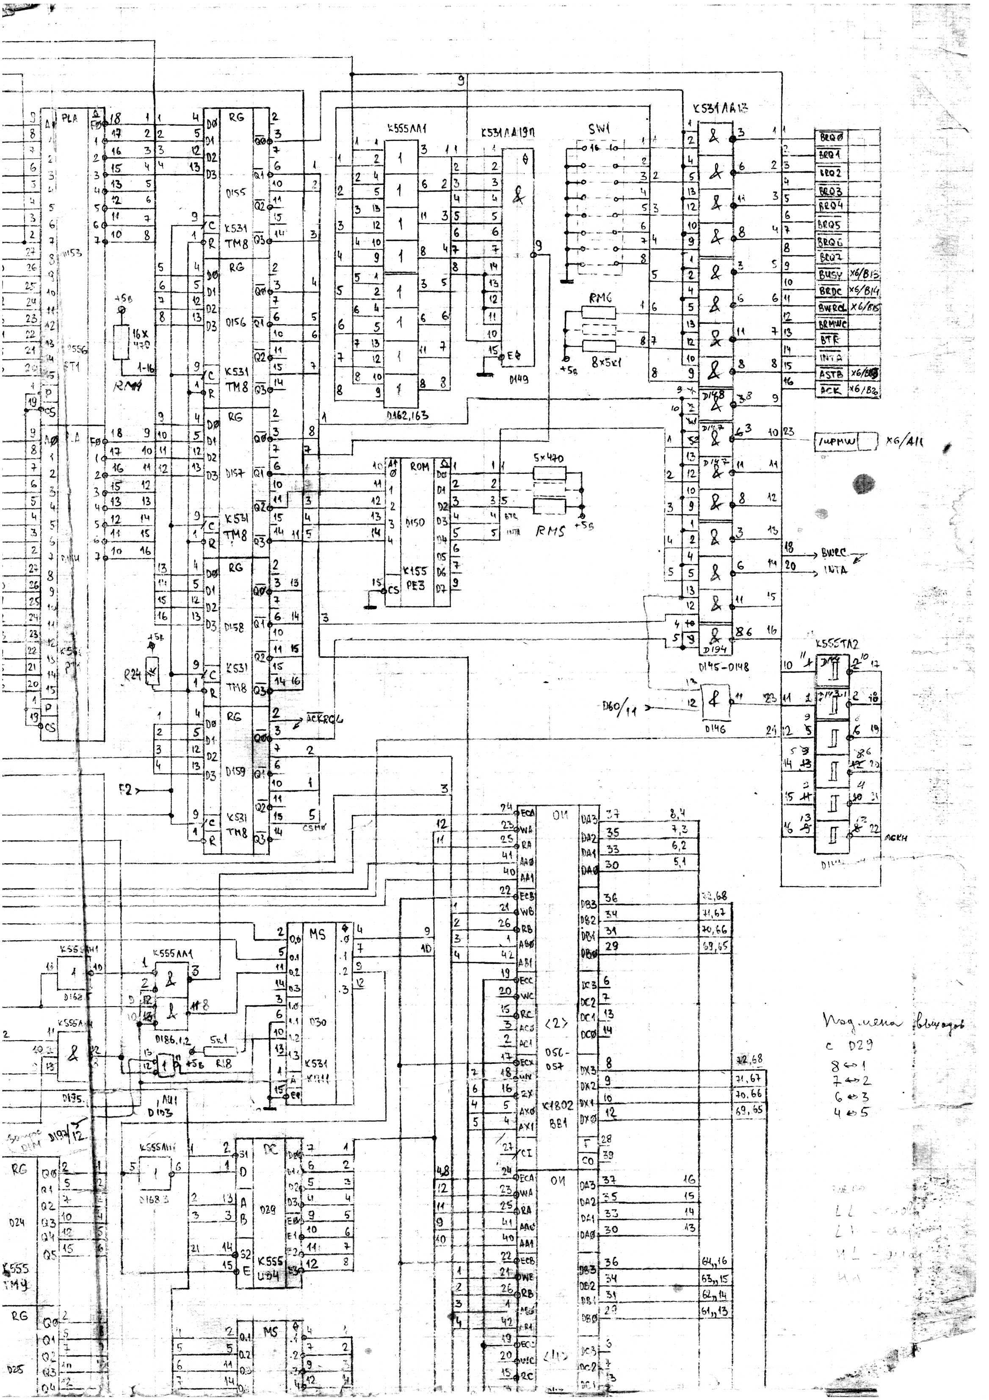
[picture p11: page 1]
