besm6/micro-besm/doc/schematics/page1a2.pdf

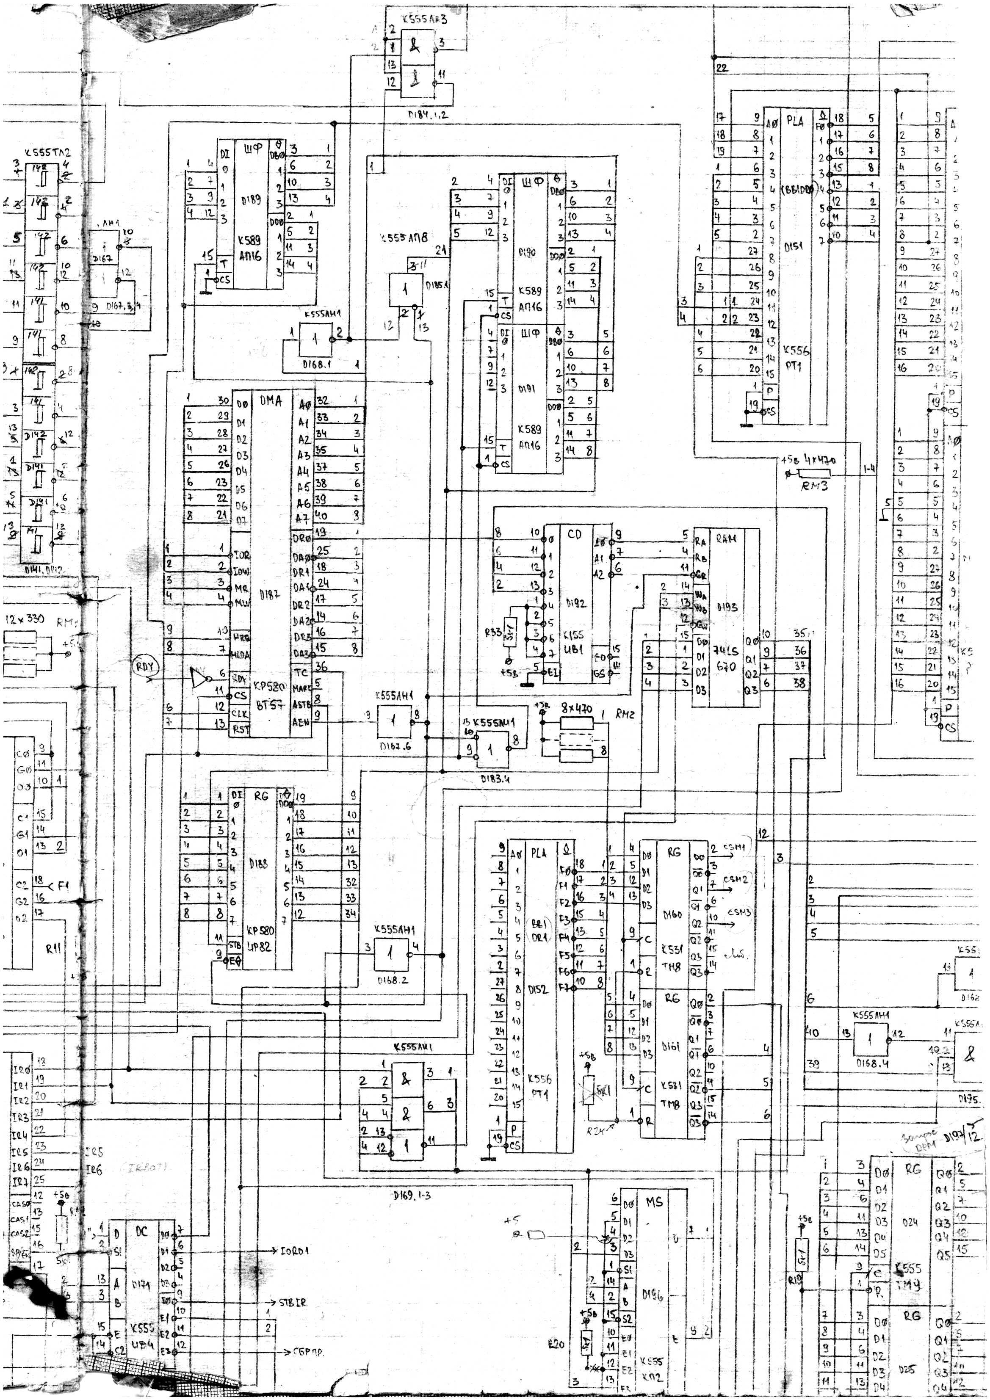
[picture p12: page 1]
