besm6/micro-besm/doc/schematics/page1a3.pdf

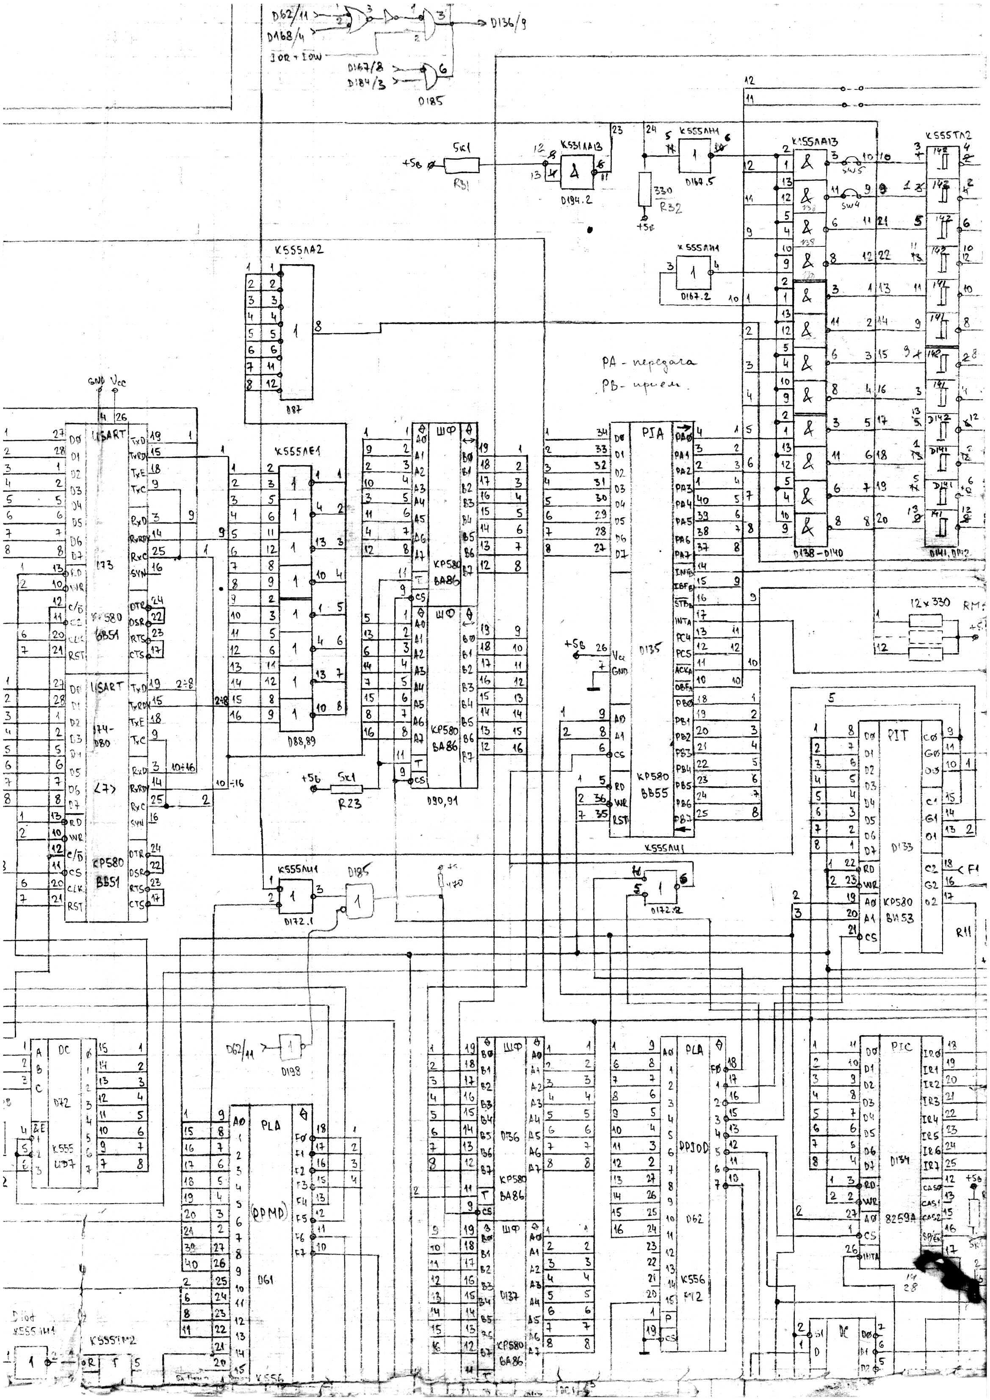
[picture p13: page 1]
