besm6/micro-besm/doc/schematics/page1a4.pdf

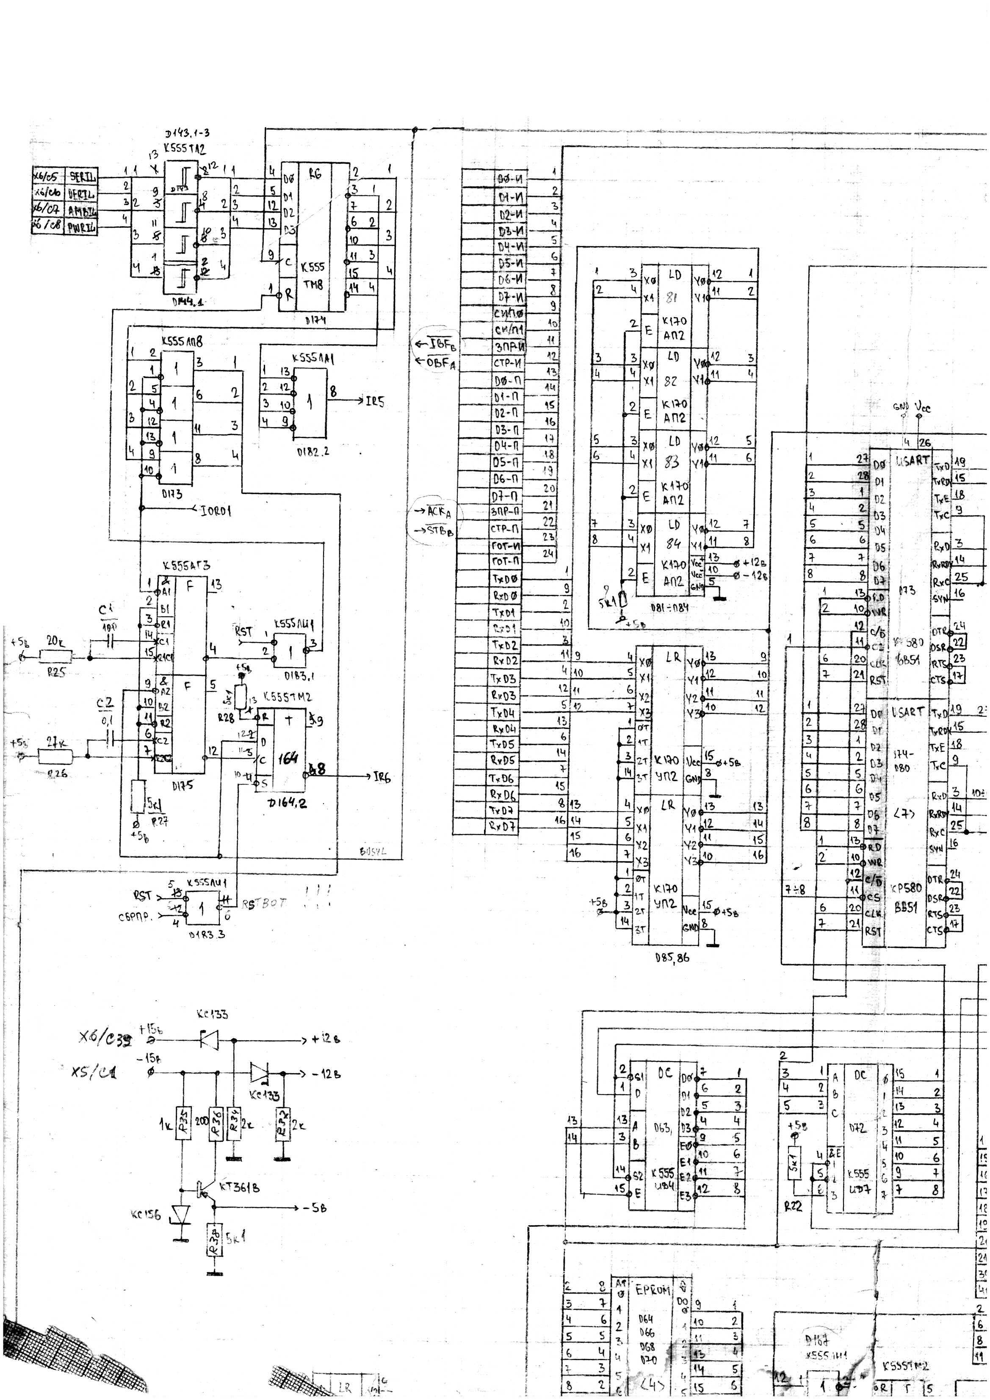
[picture p14: page 1]
