besm6/micro-besm/doc/schematics/page1b1.pdf

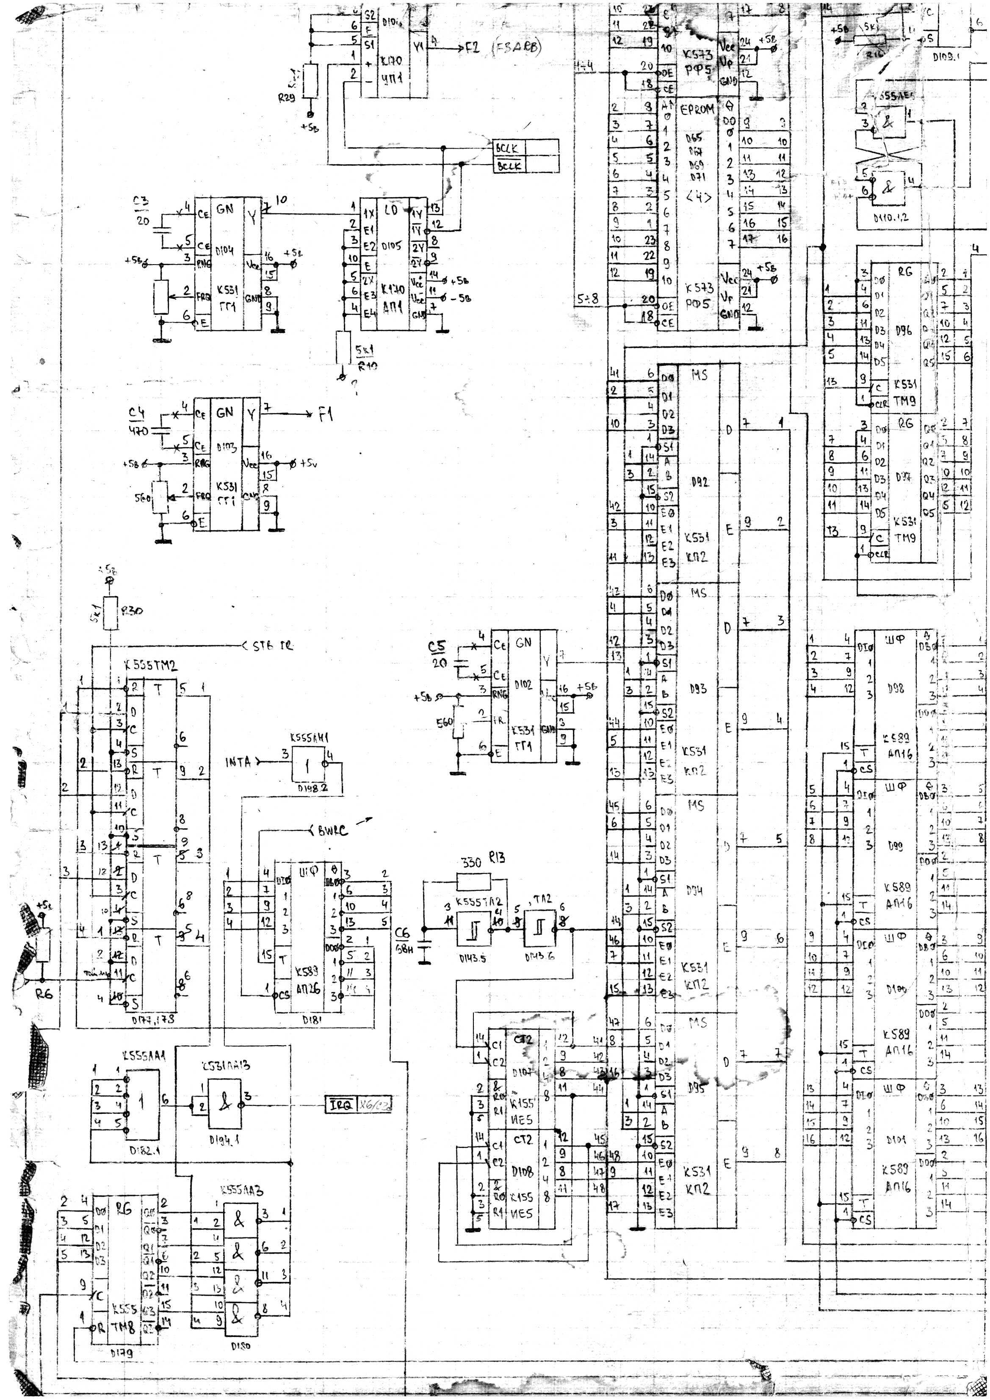
[picture p15: page 1]
