besm6/micro-besm/doc/schematics/page1b2.pdf

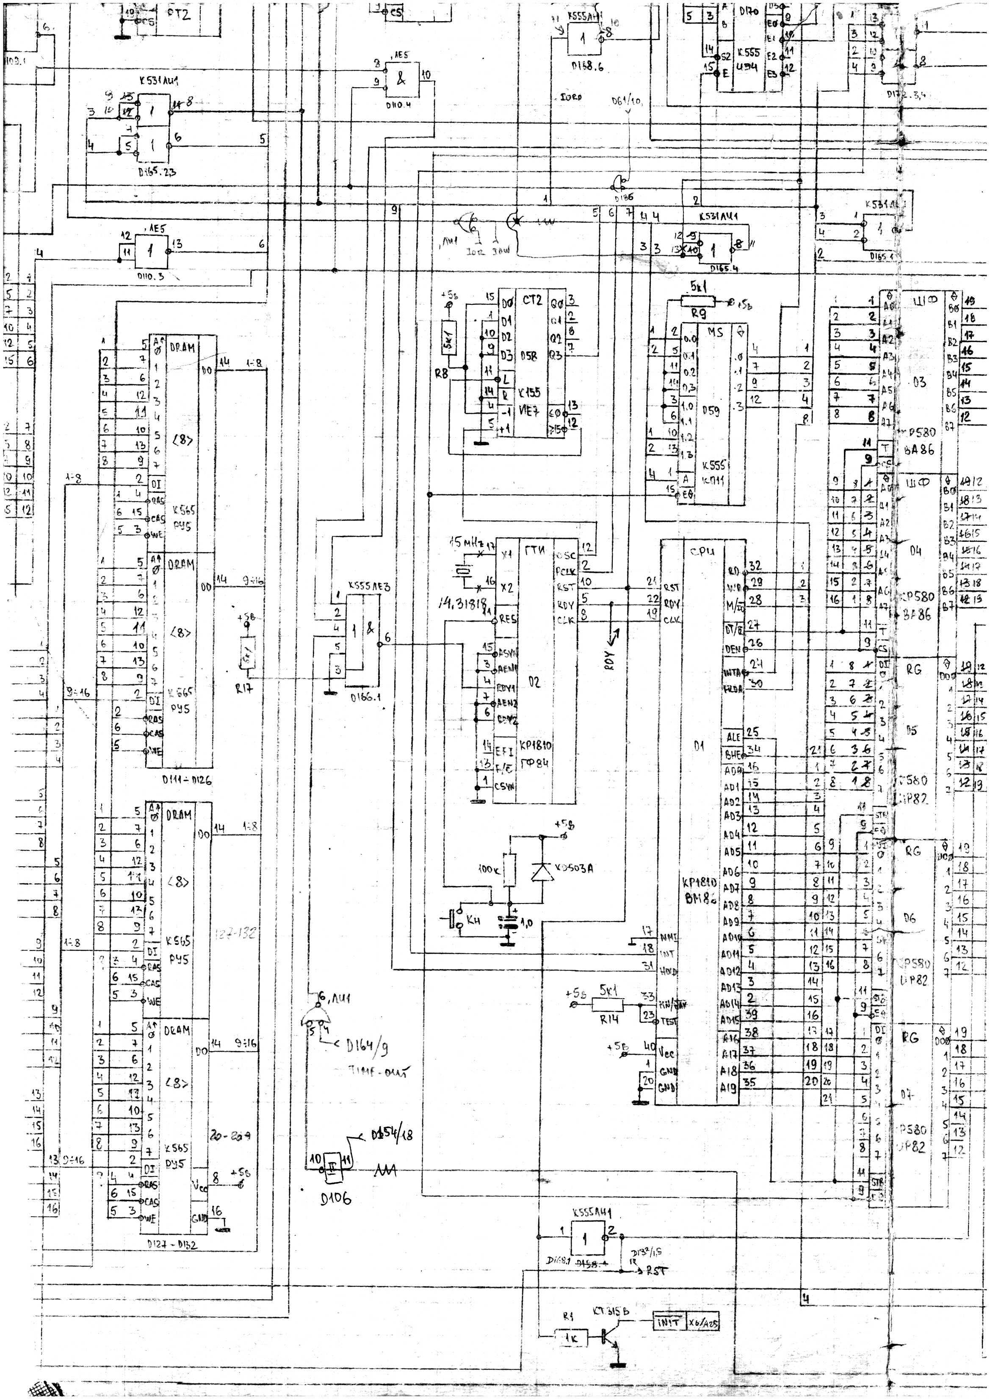
[picture p16: page 1]
