besm6/micro-besm/doc/schematics/page1b3.pdf

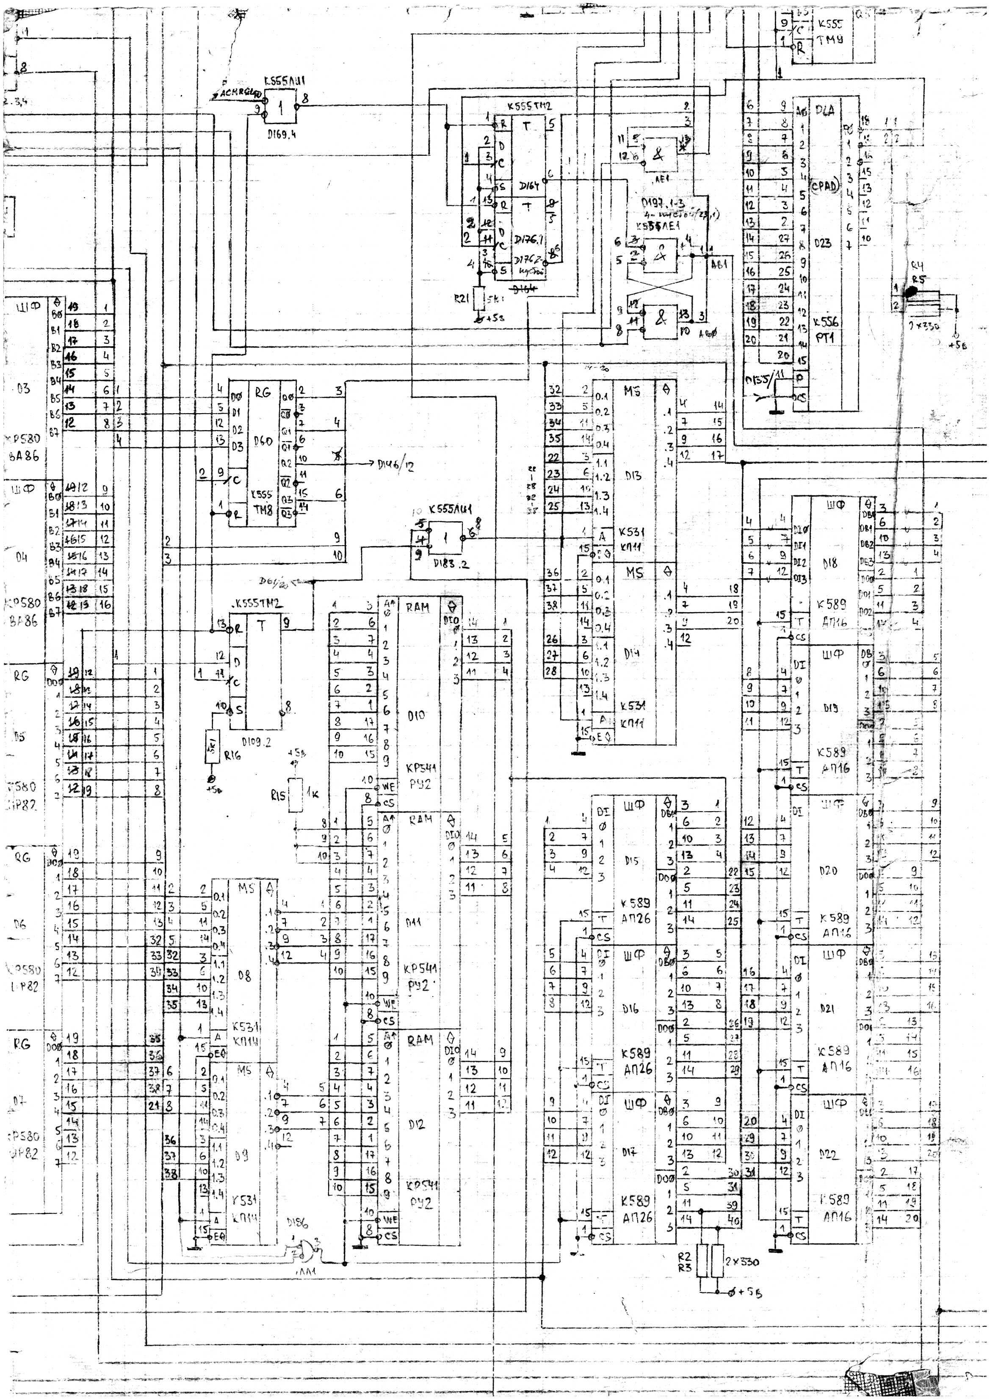
[picture p17: page 1]
