besm6/micro-besm/doc/schematics/page1b4.pdf

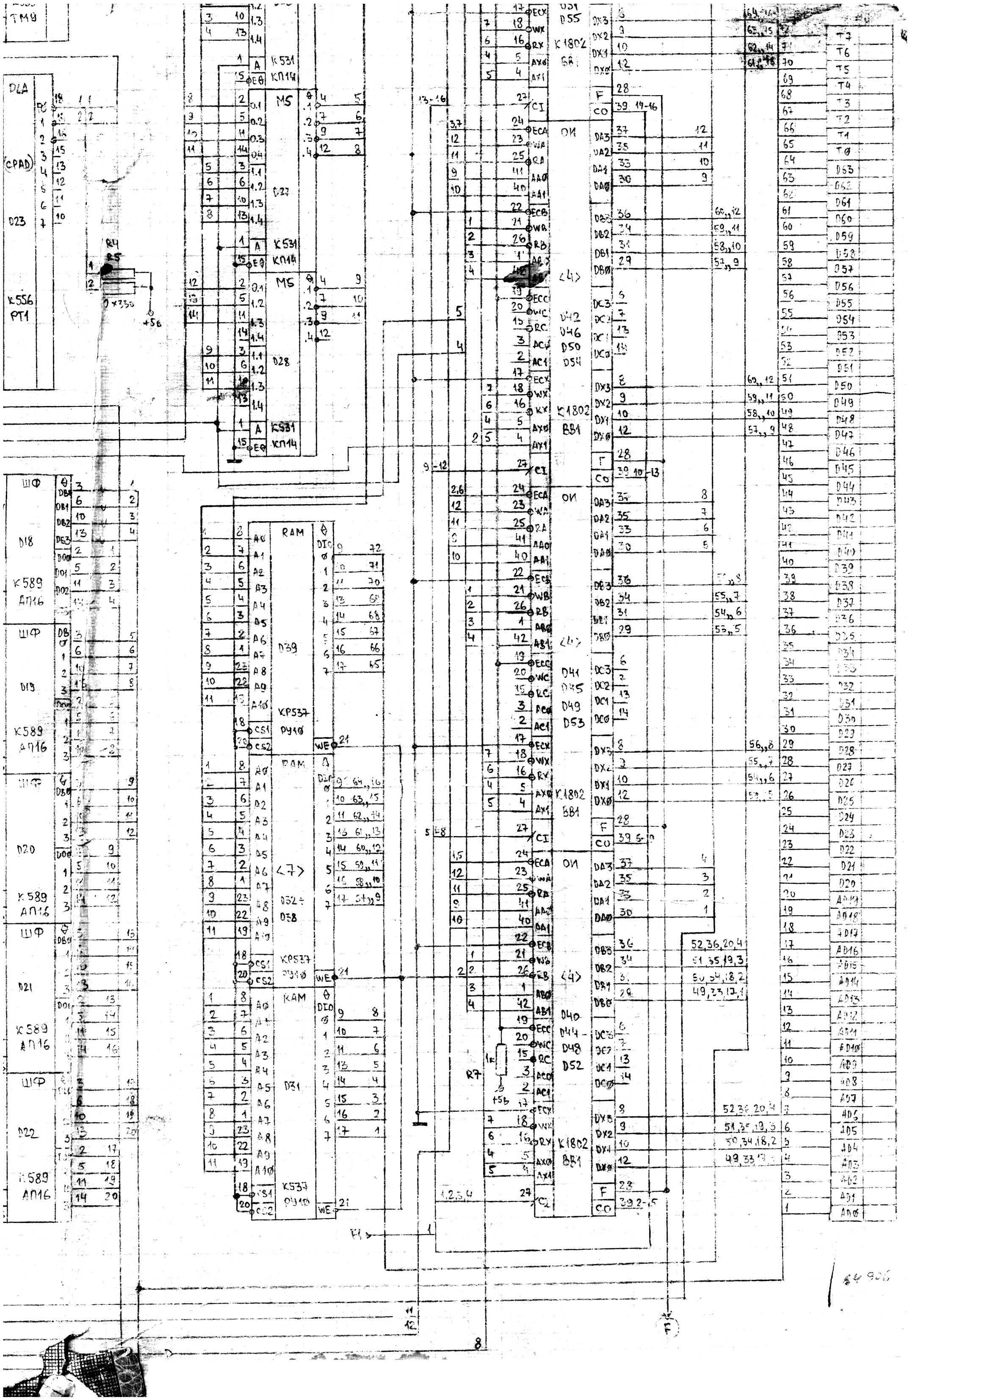
[picture p18: page 1]
