besm6/micro-besm/doc/schematics/page2a.pdf

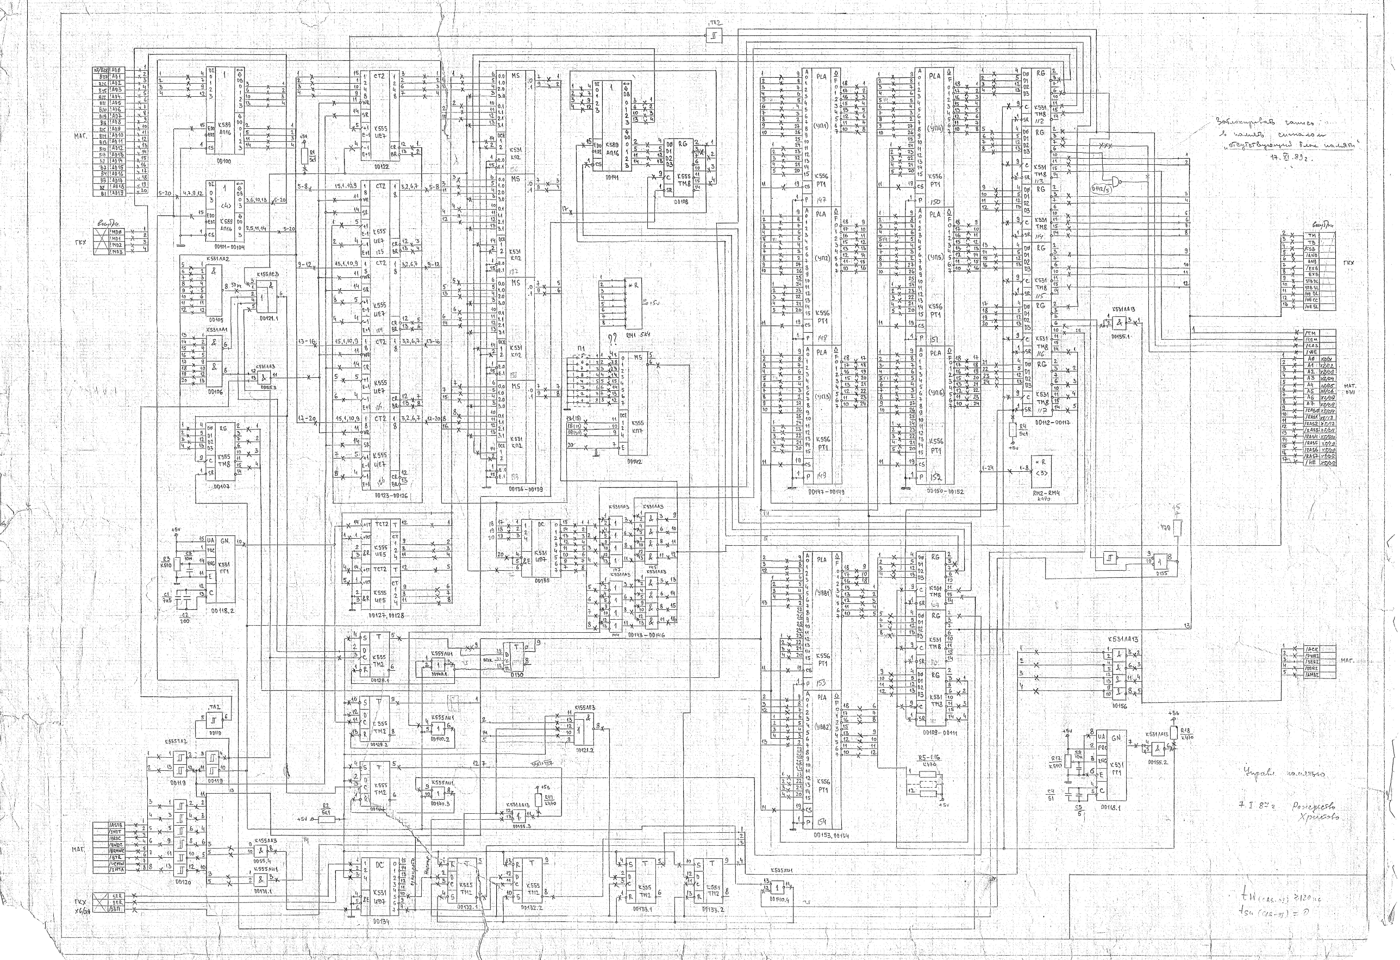
[picture p19: page 1]
