besm6/micro-besm/doc/schematics/page2b.pdf

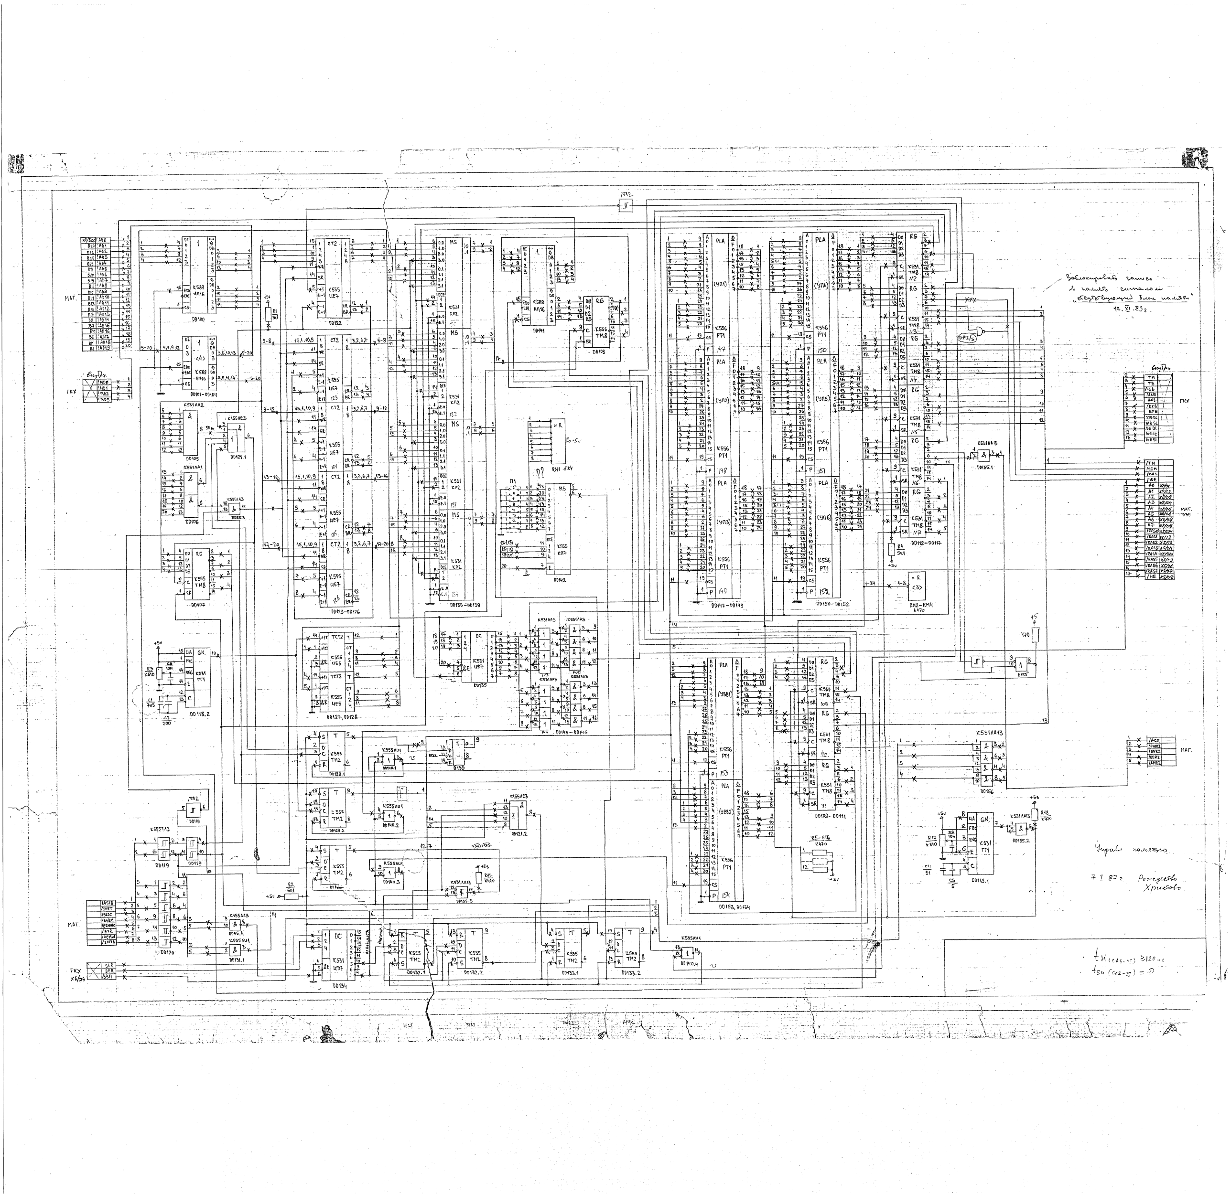
[picture p20: page 1]
