besm6/micro-besm/doc/schematics/page3a.pdf

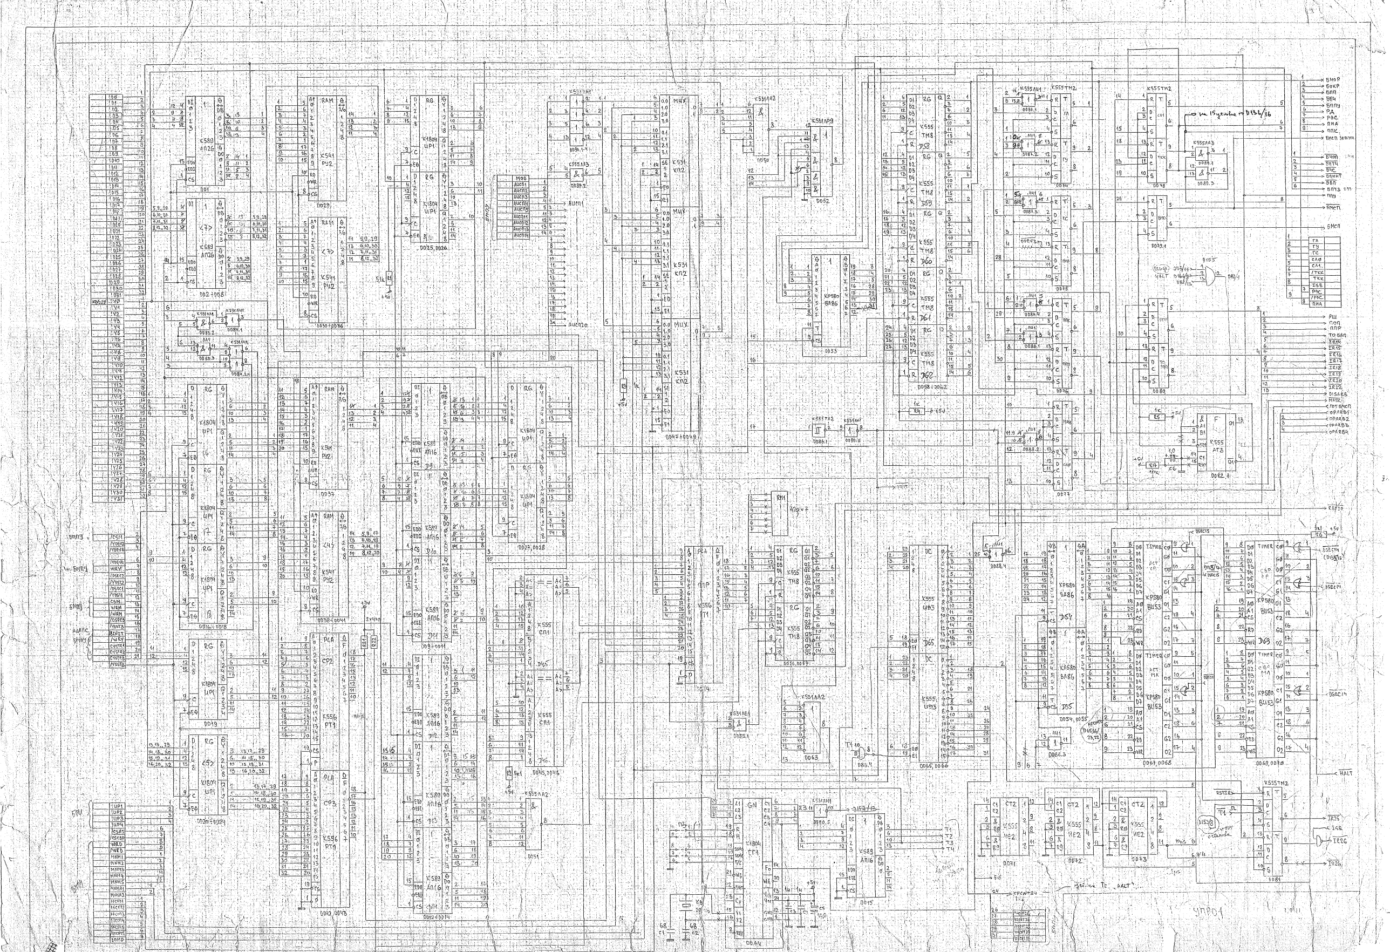
[picture p21: page 1]
