besm6/micro-besm/doc/schematics/page3b.pdf

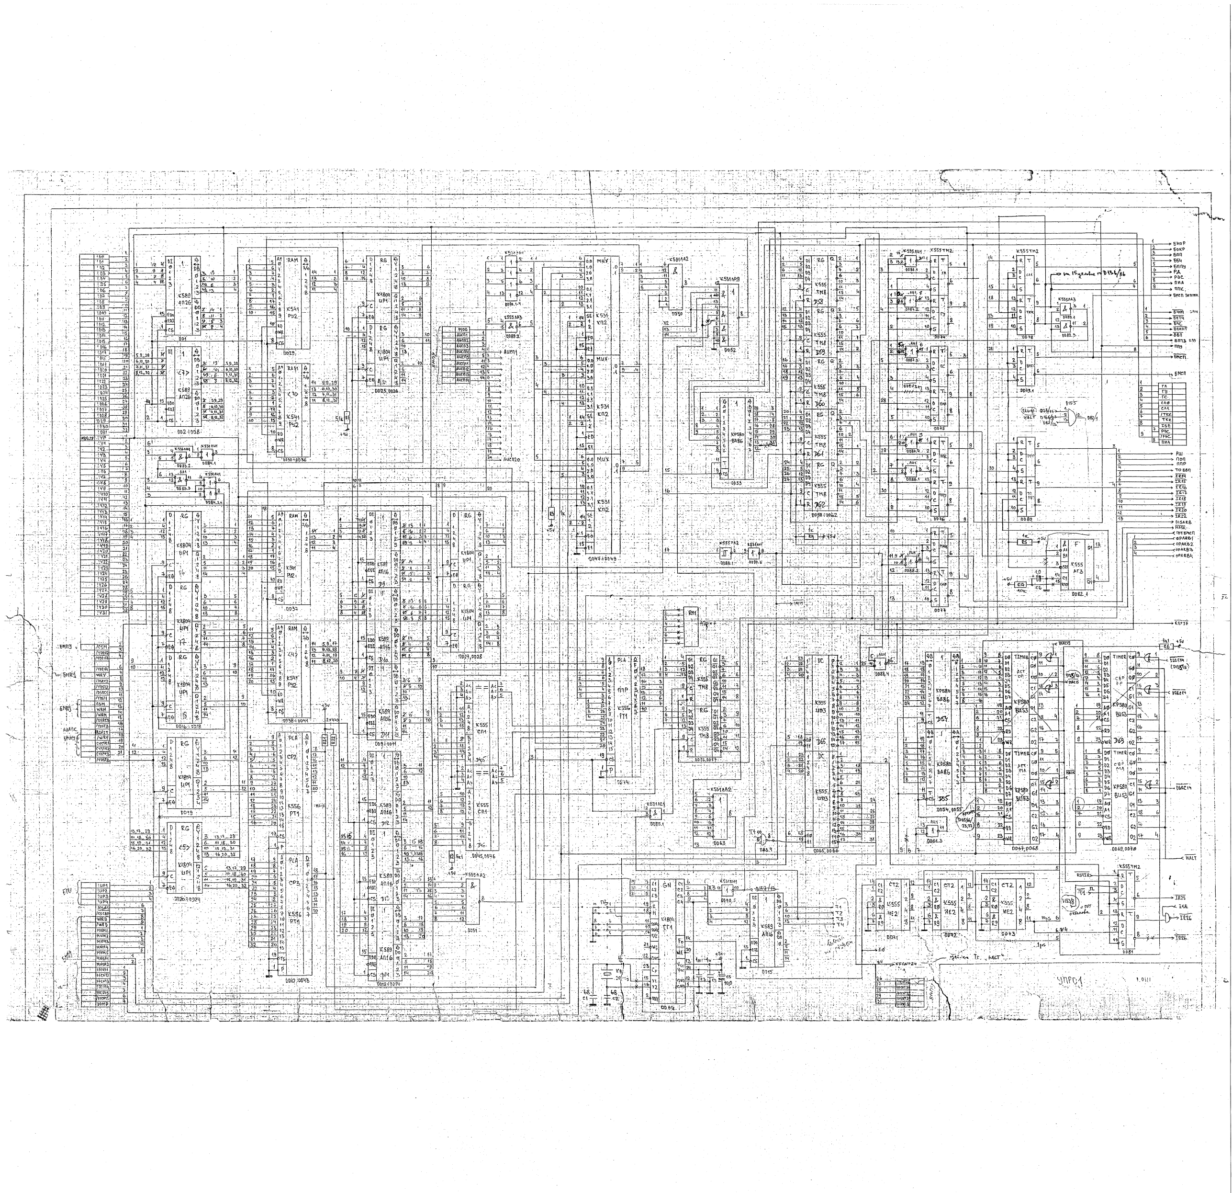
[picture p22: page 1]
