besm6/micro-besm/doc/schematics/page4a.pdf

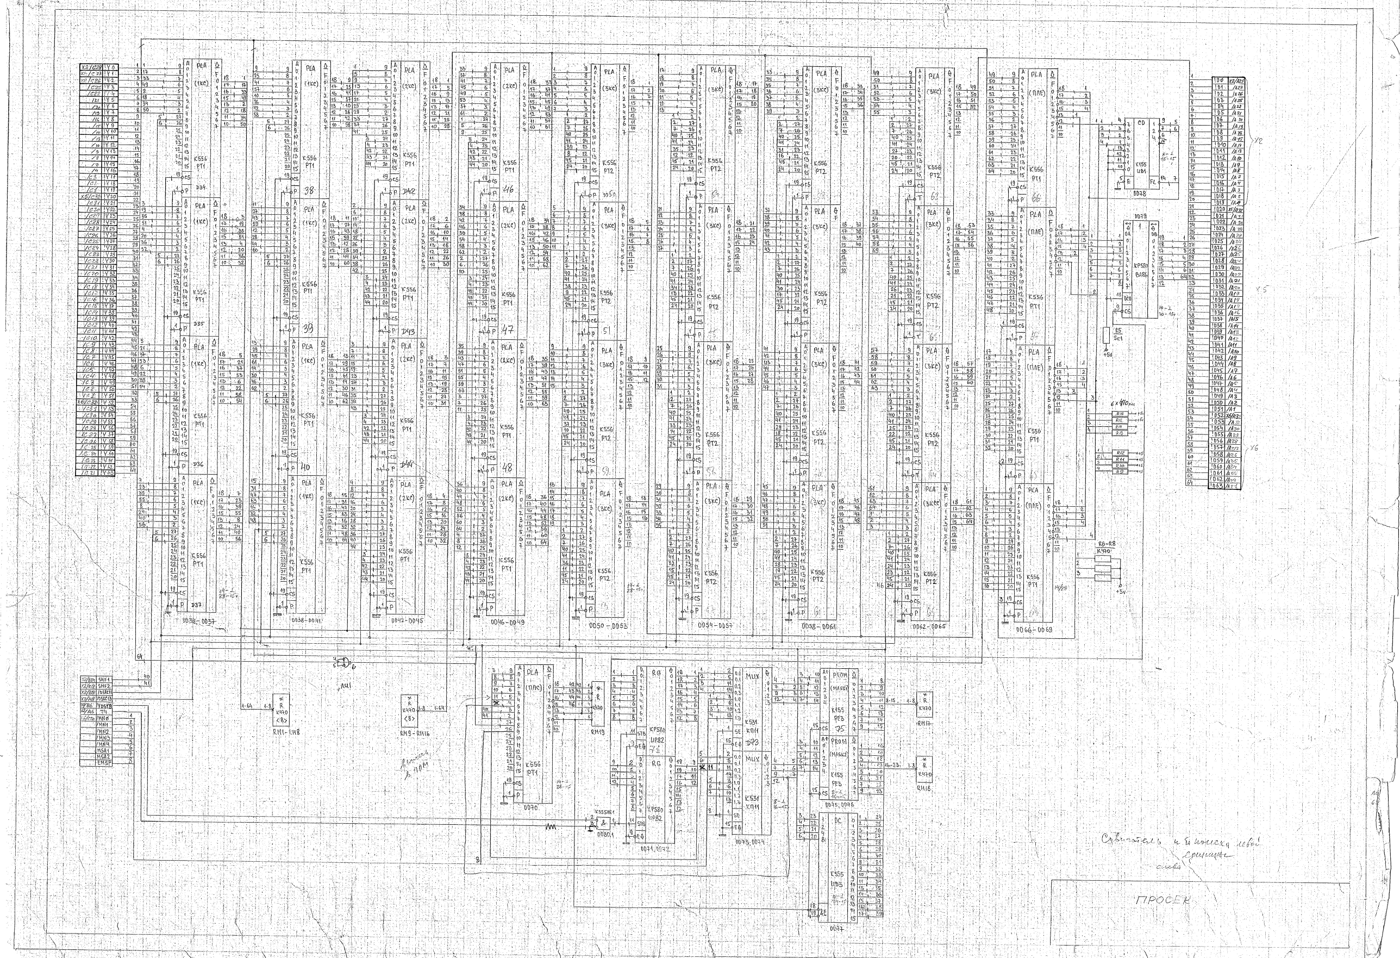
[picture p23: page 1]
