besm6/micro-besm/doc/schematics/page4b.pdf

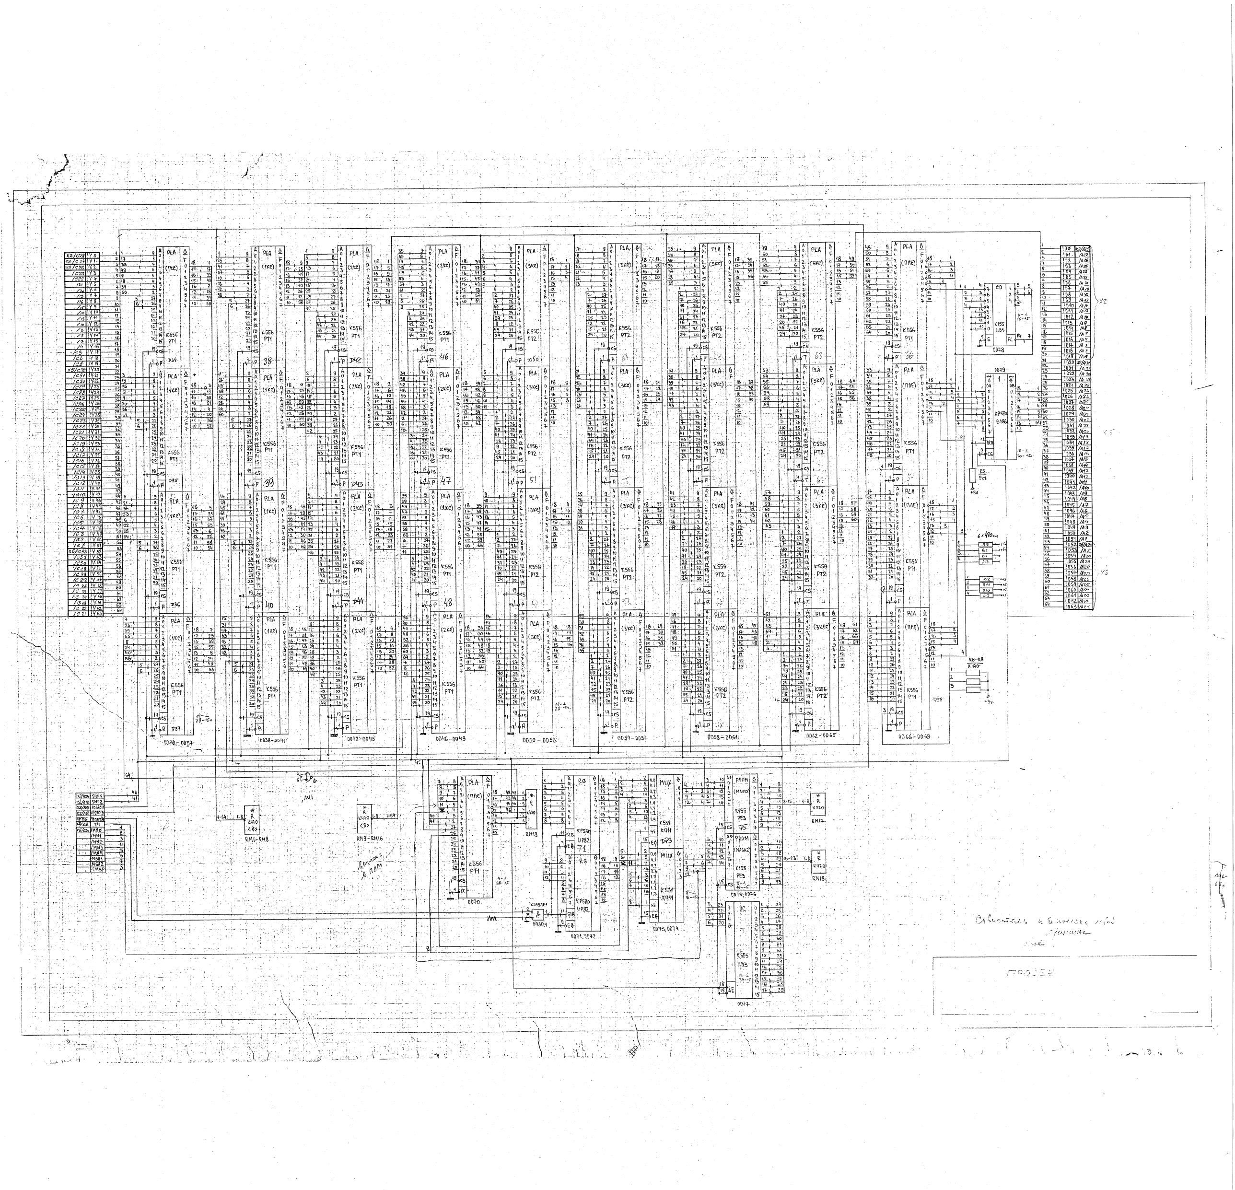
[picture p24: page 1]
