besm6/micro-besm/doc/schematics/page9/tile1a.pdf

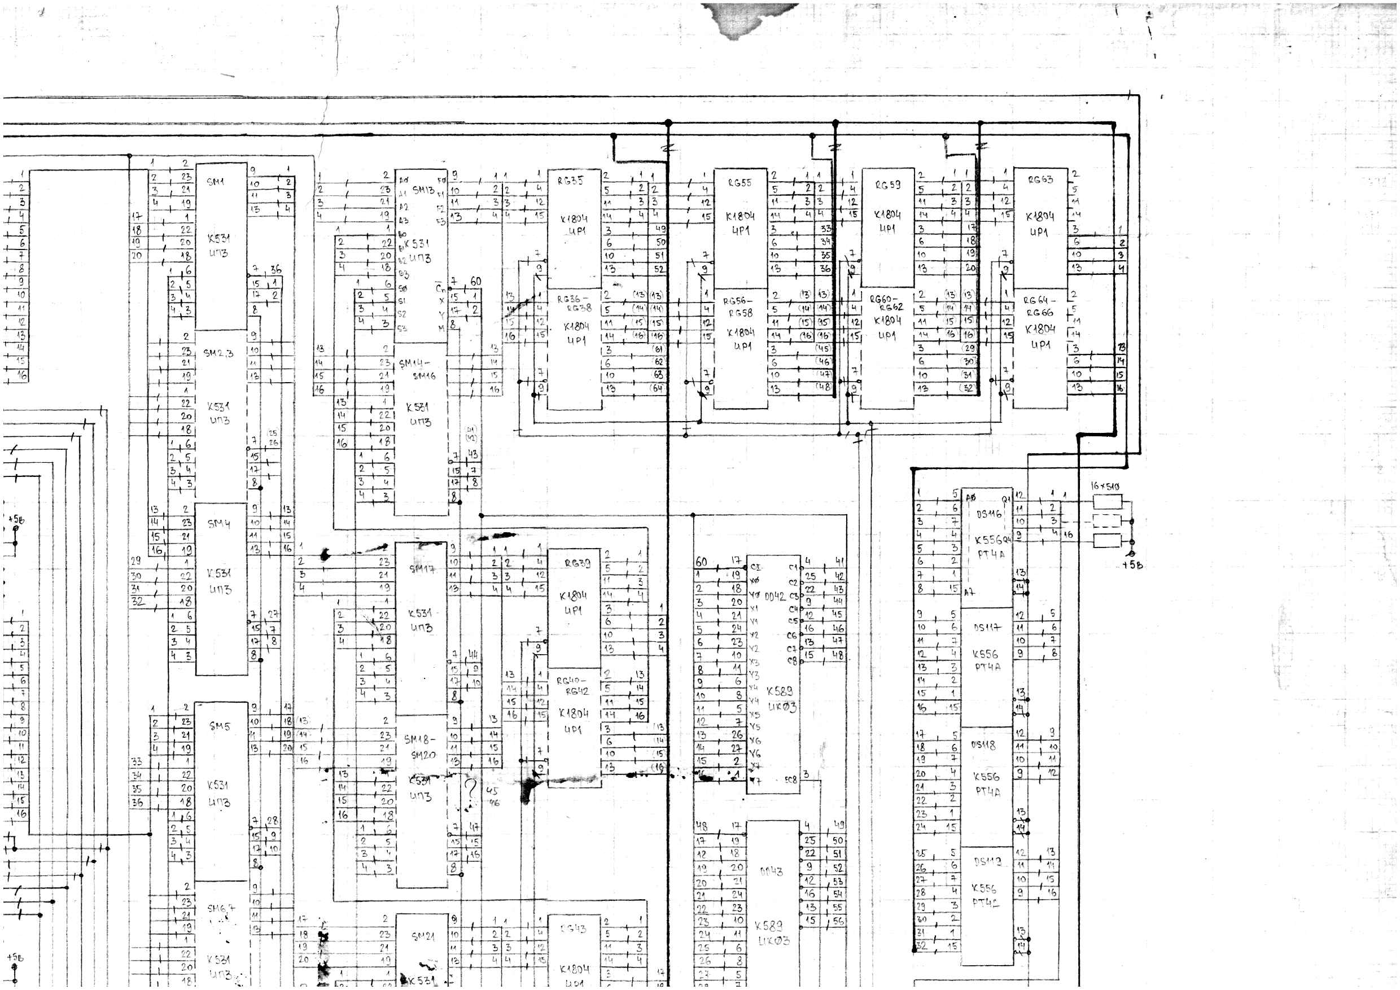
[picture p25: page 1]
