besm6/micro-besm/doc/schematics/page9/tile1b.pdf

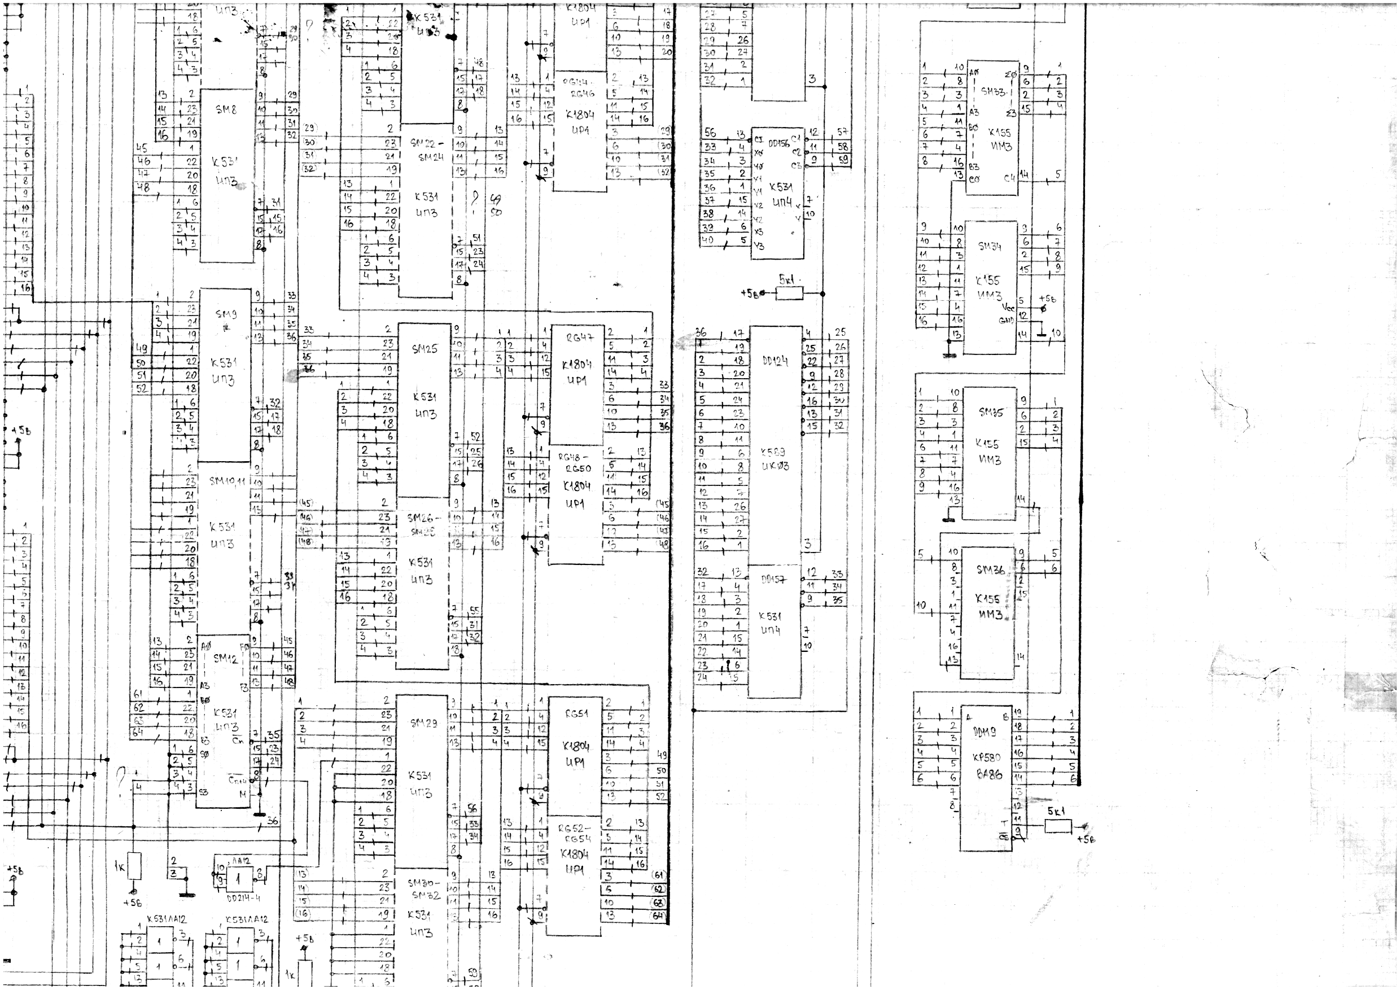
[picture p26: page 1]
