besm6/micro-besm/doc/schematics/page9/tile1c.pdf

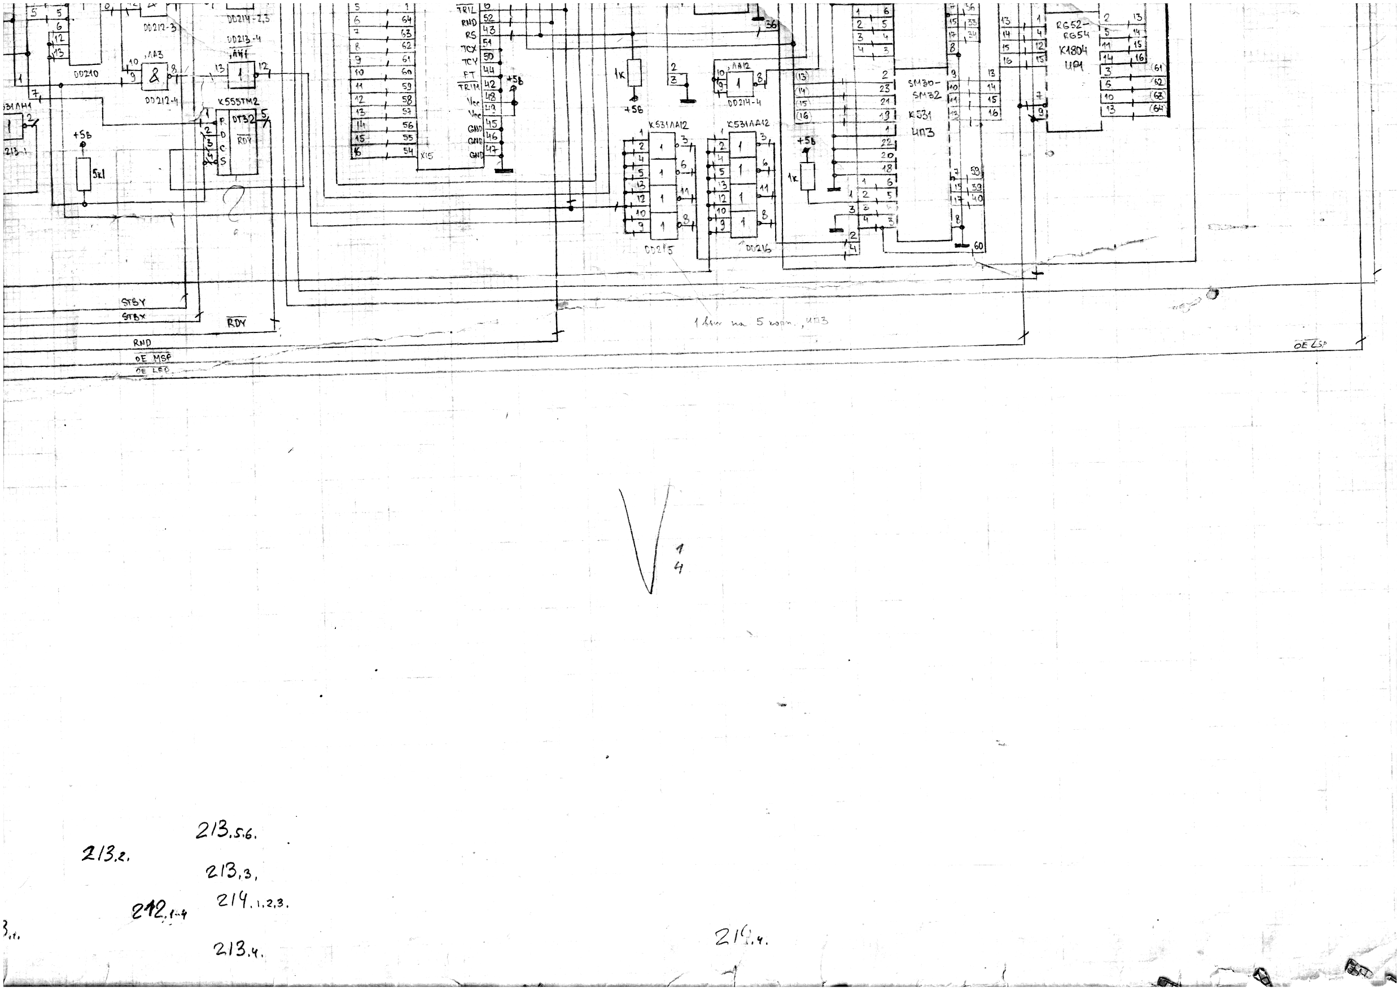
[picture p27: page 1]
