besm6/micro-besm/doc/schematics/page9/tile2a.pdf

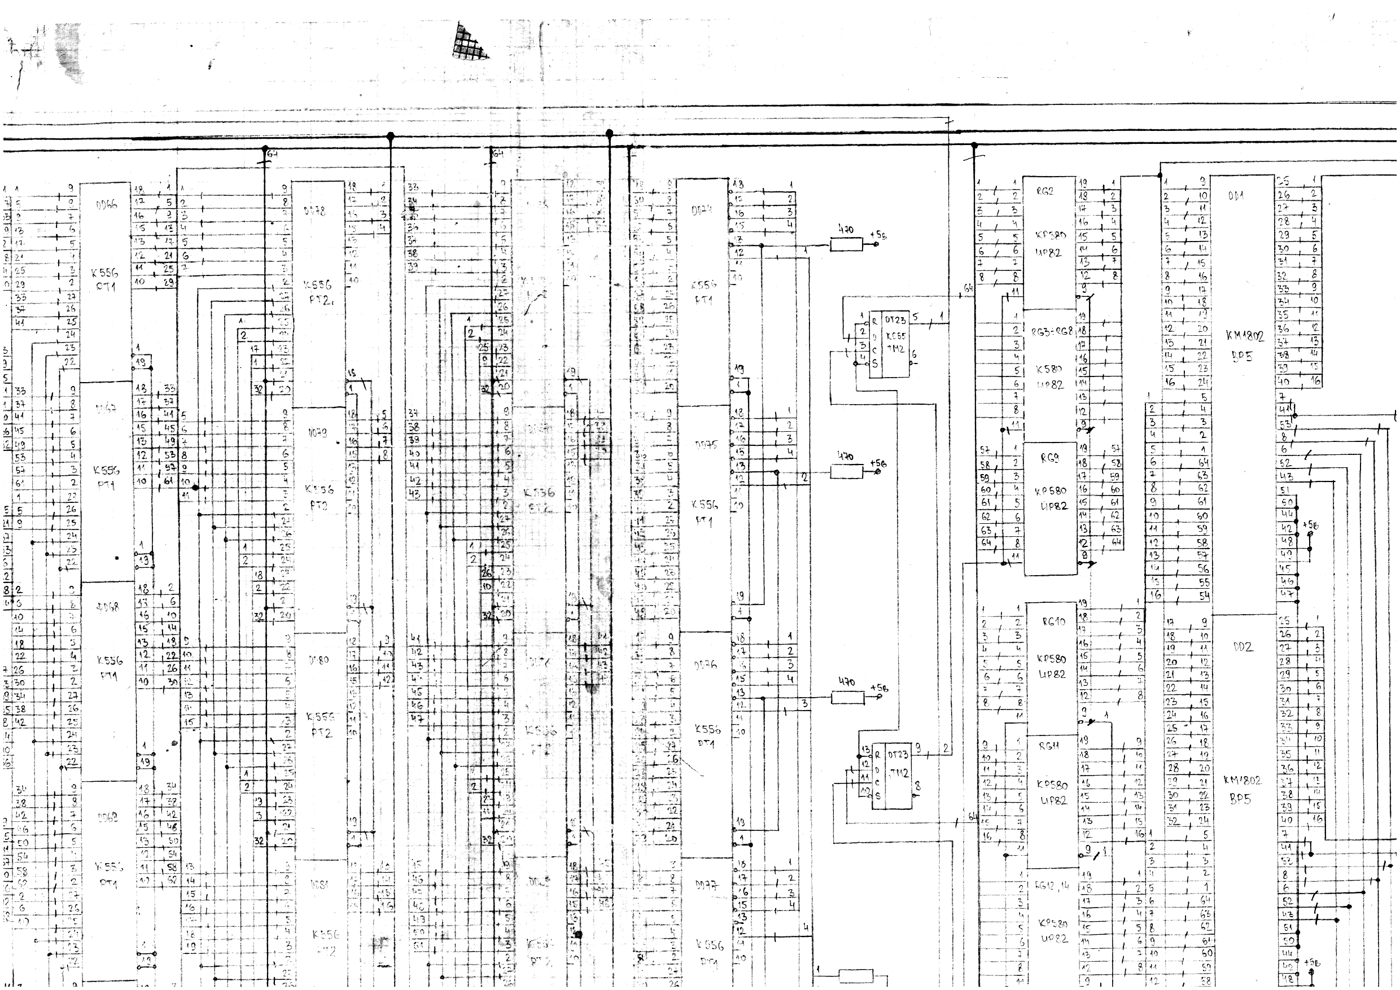
[picture p28: page 1]
