besm6/micro-besm/doc/schematics/page9/tile2b.pdf

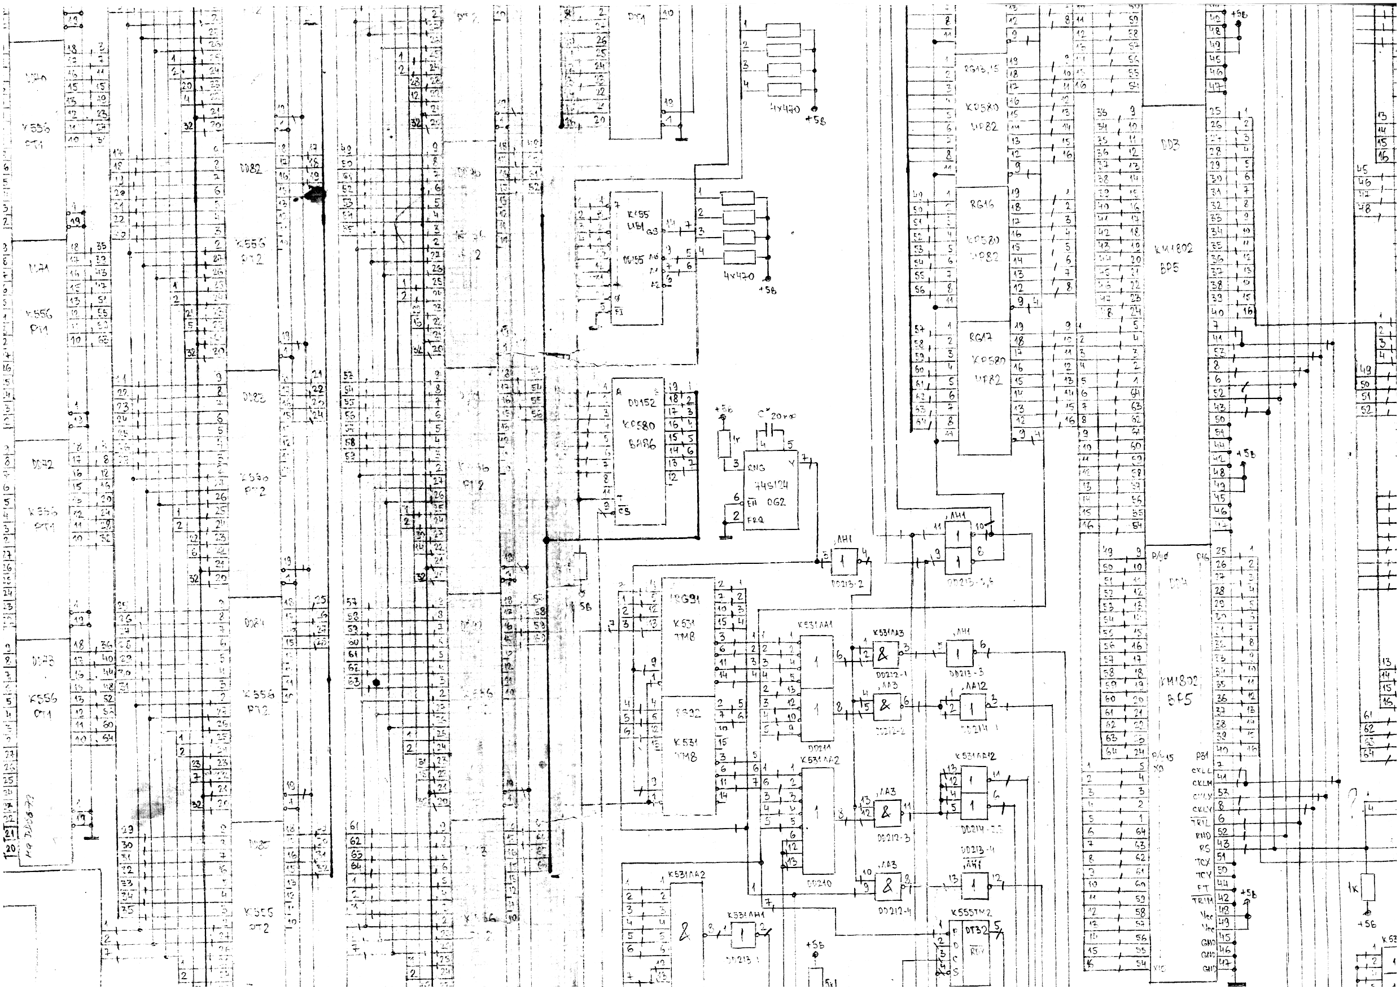
[picture p29: page 1]
