besm6/micro-besm/doc/schematics/page9/tile2c.pdf

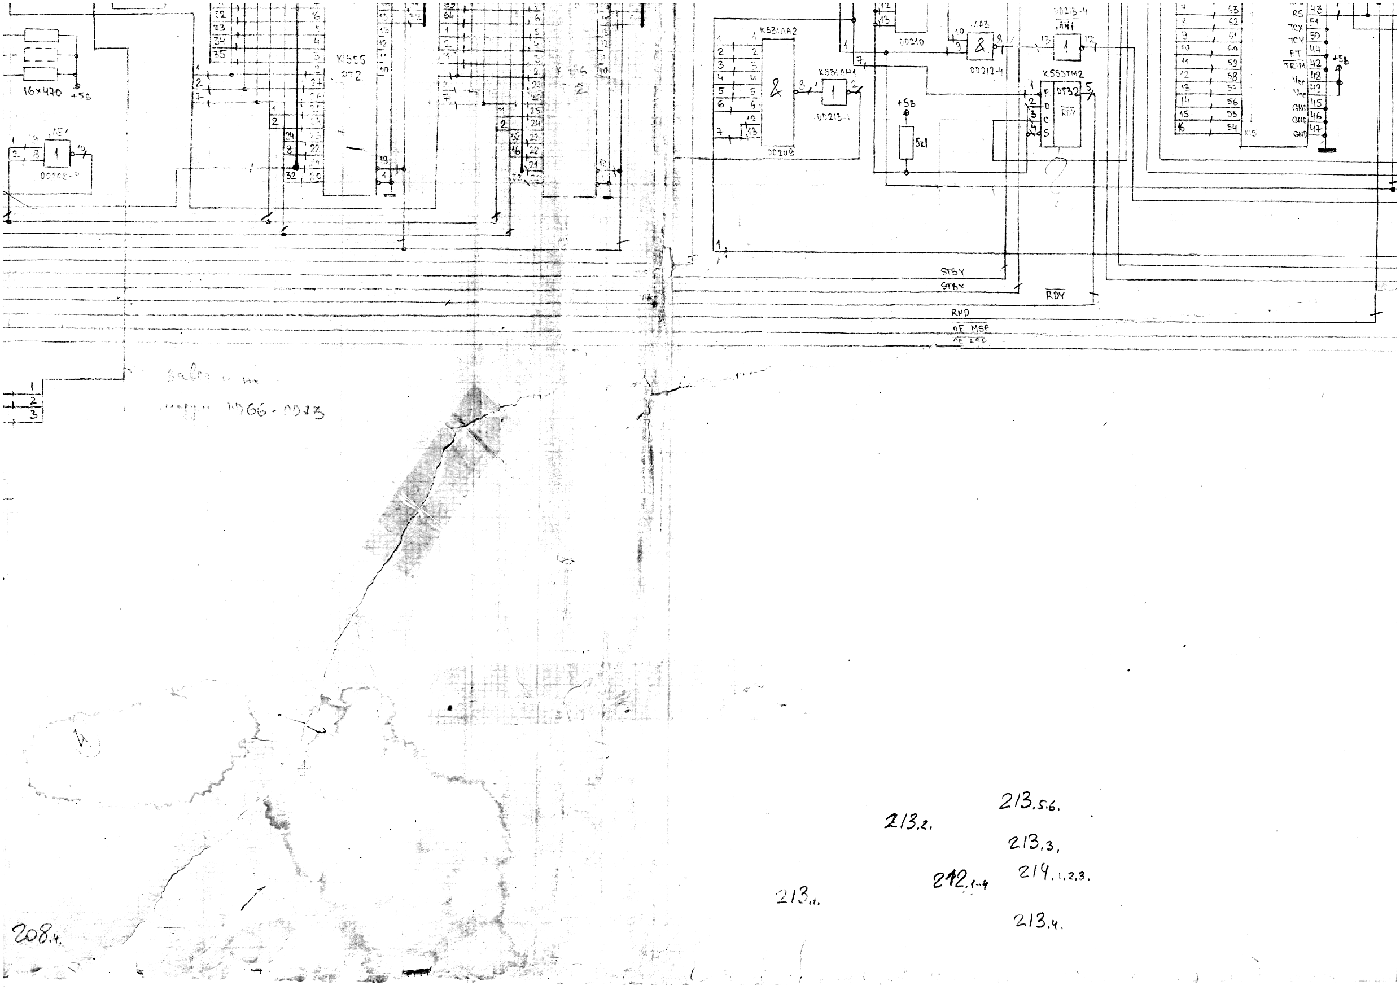
[picture p30: page 1]
