besm6/micro-besm/doc/schematics/page9/tile3a.pdf

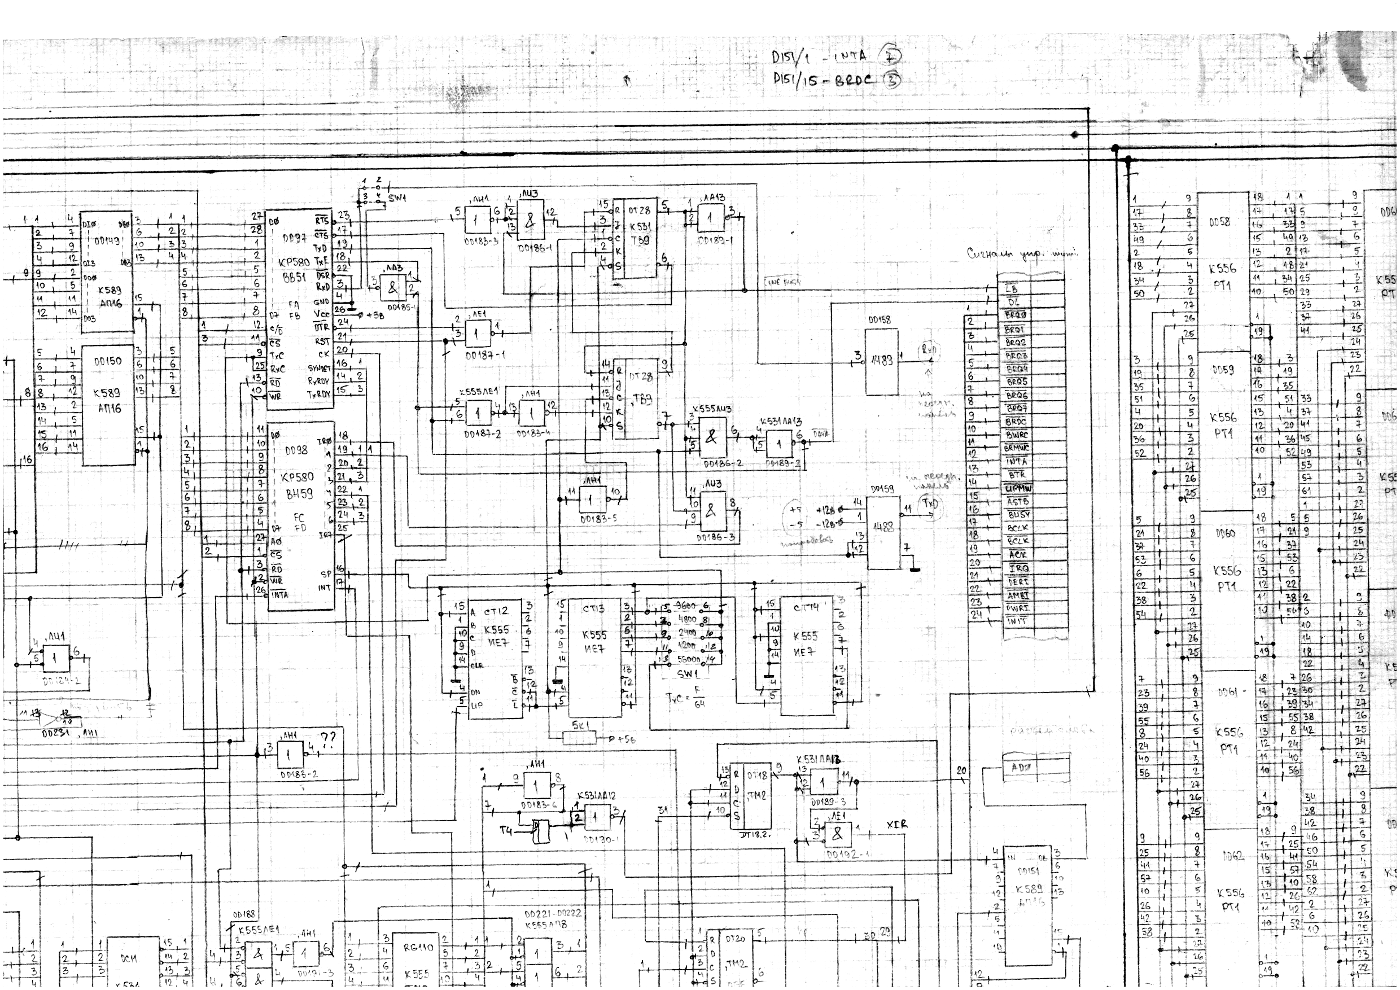
[picture p31: page 1]
