besm6/micro-besm/doc/schematics/page9/tile3b.pdf

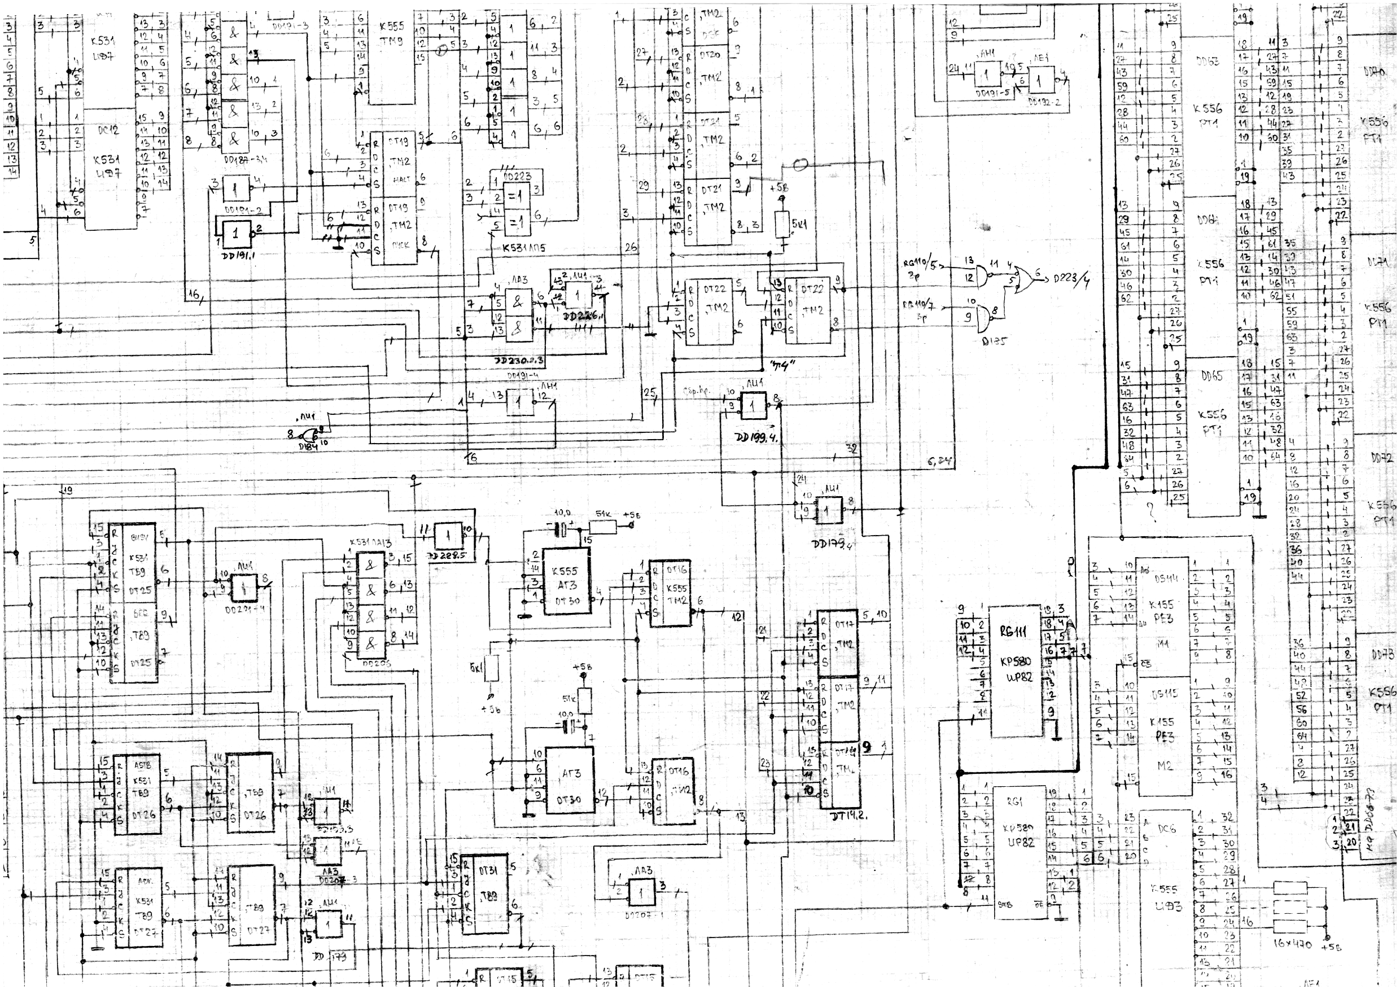
[picture p32: page 1]
