besm6/micro-besm/doc/schematics/page9/tile3c.pdf

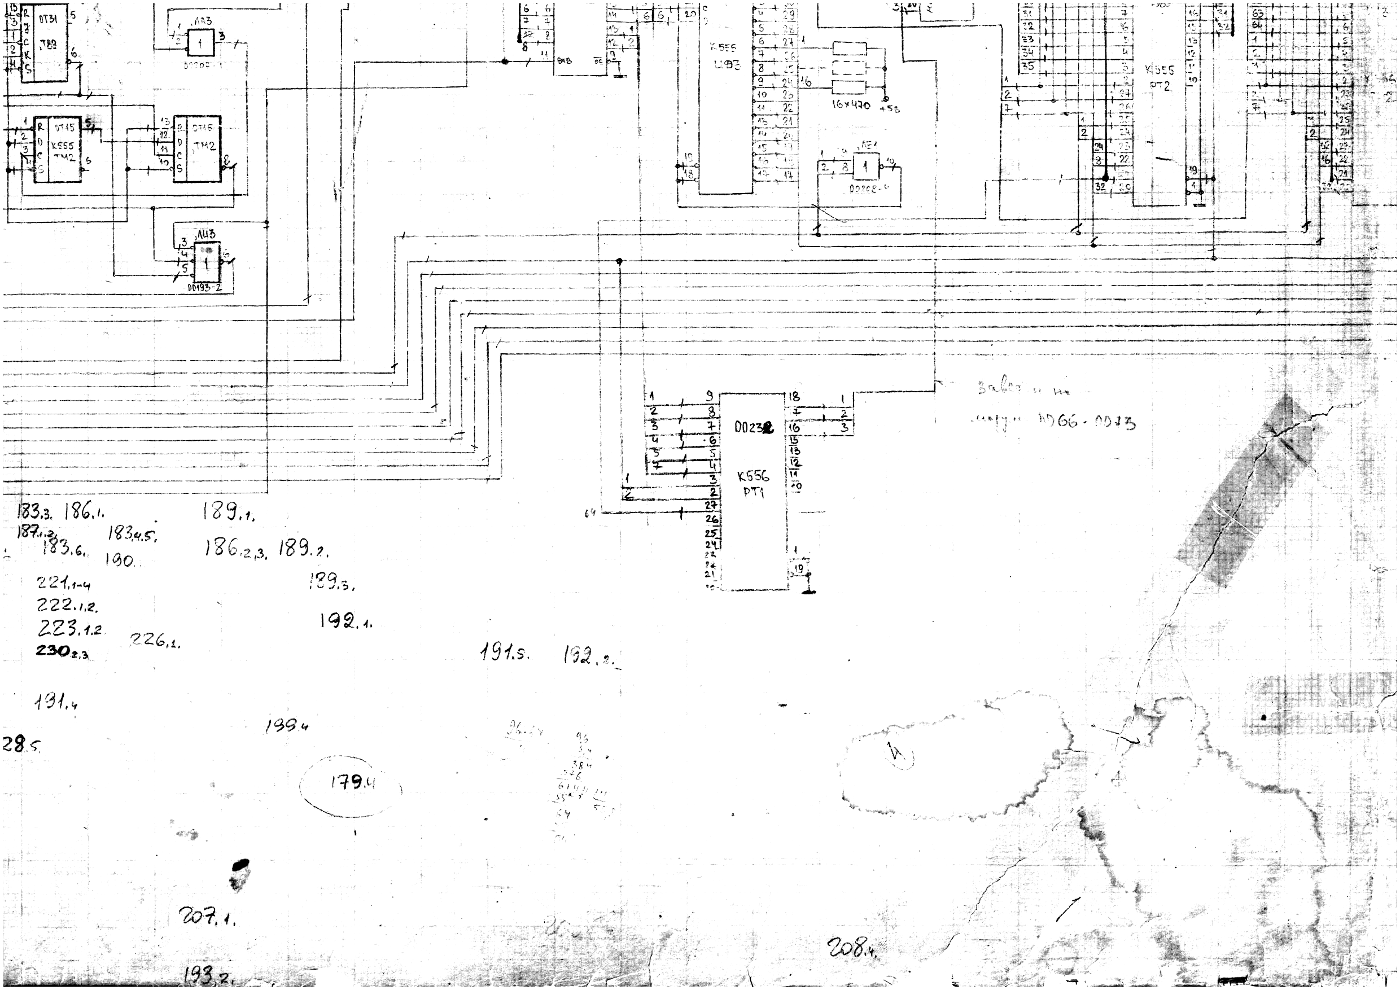
[picture p33: page 1]
