besm6/micro-besm/doc/schematics/page9/tile4a.pdf

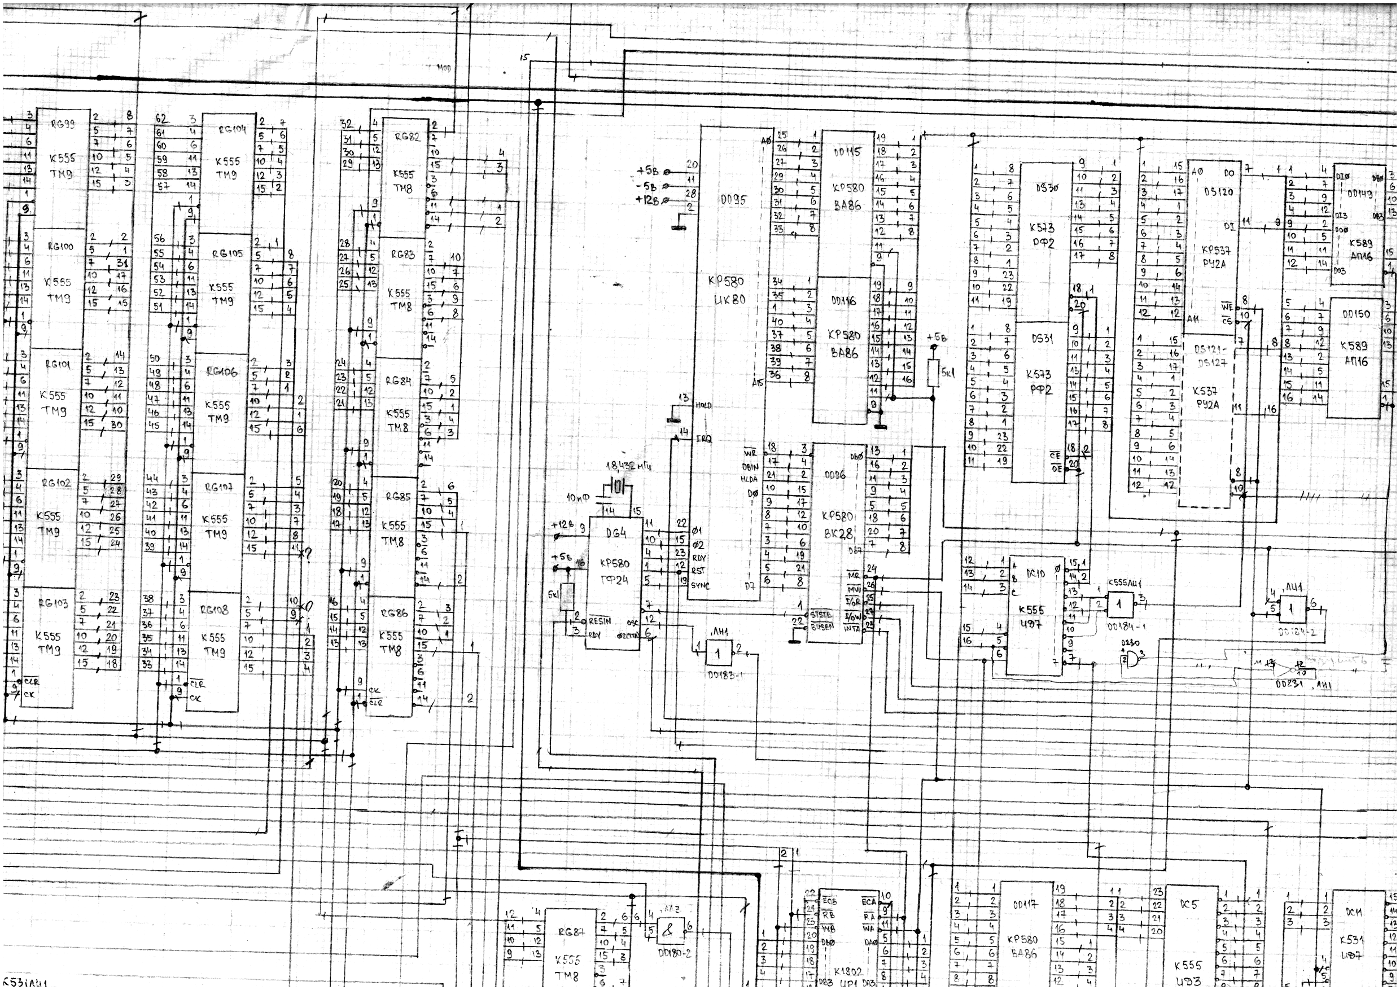
[picture p34: page 1]
