besm6/micro-besm/doc/schematics/page9/tile4b.pdf

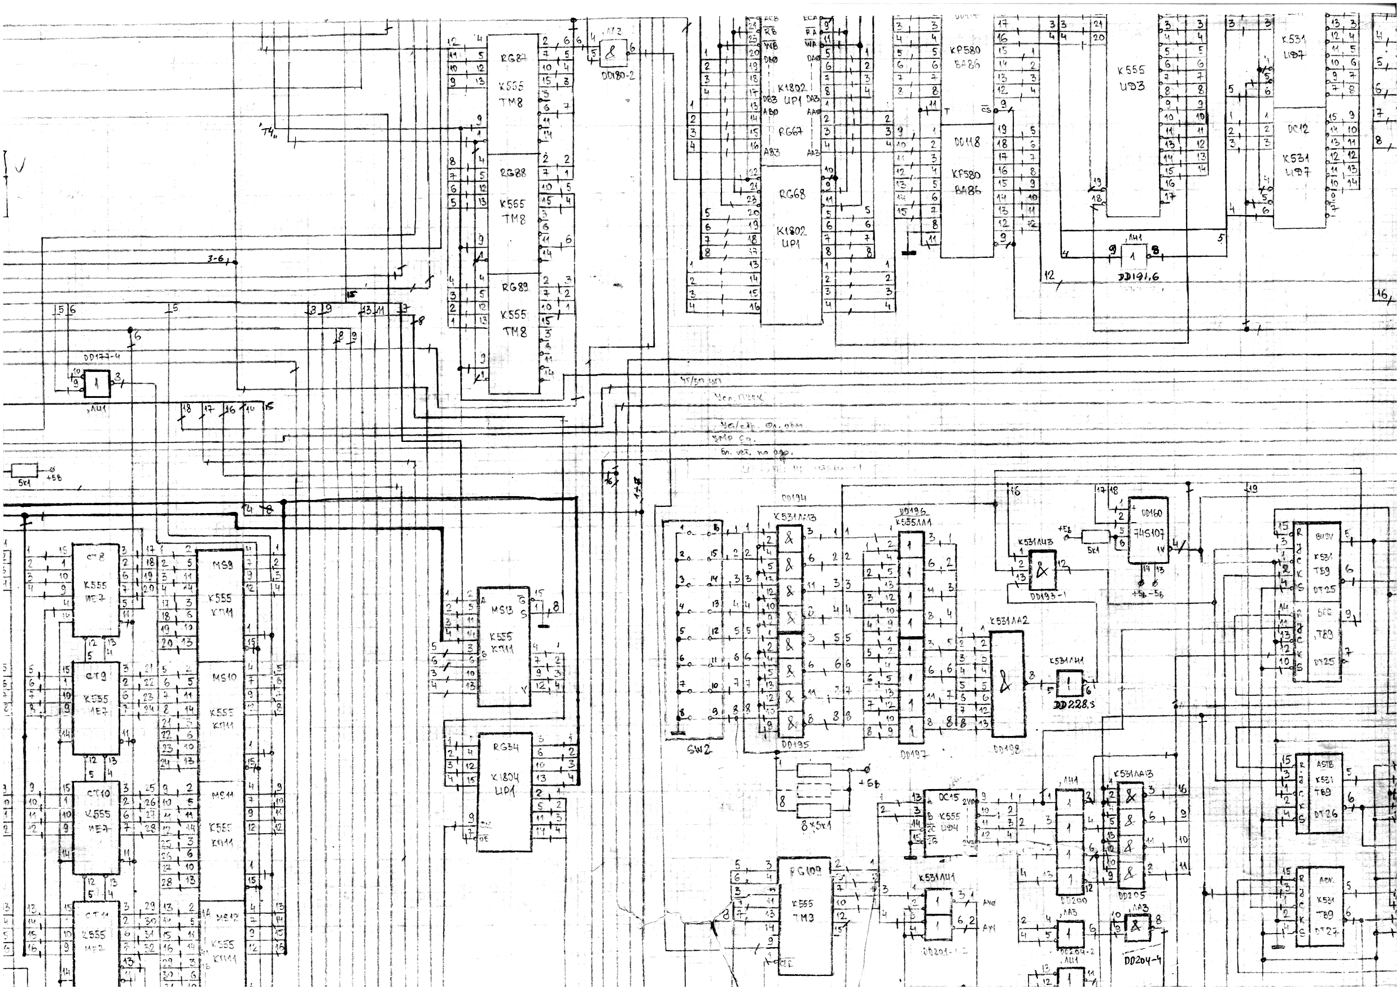
[picture p35: page 1]
