besm6/micro-besm/doc/schematics/page9/tile4c.pdf

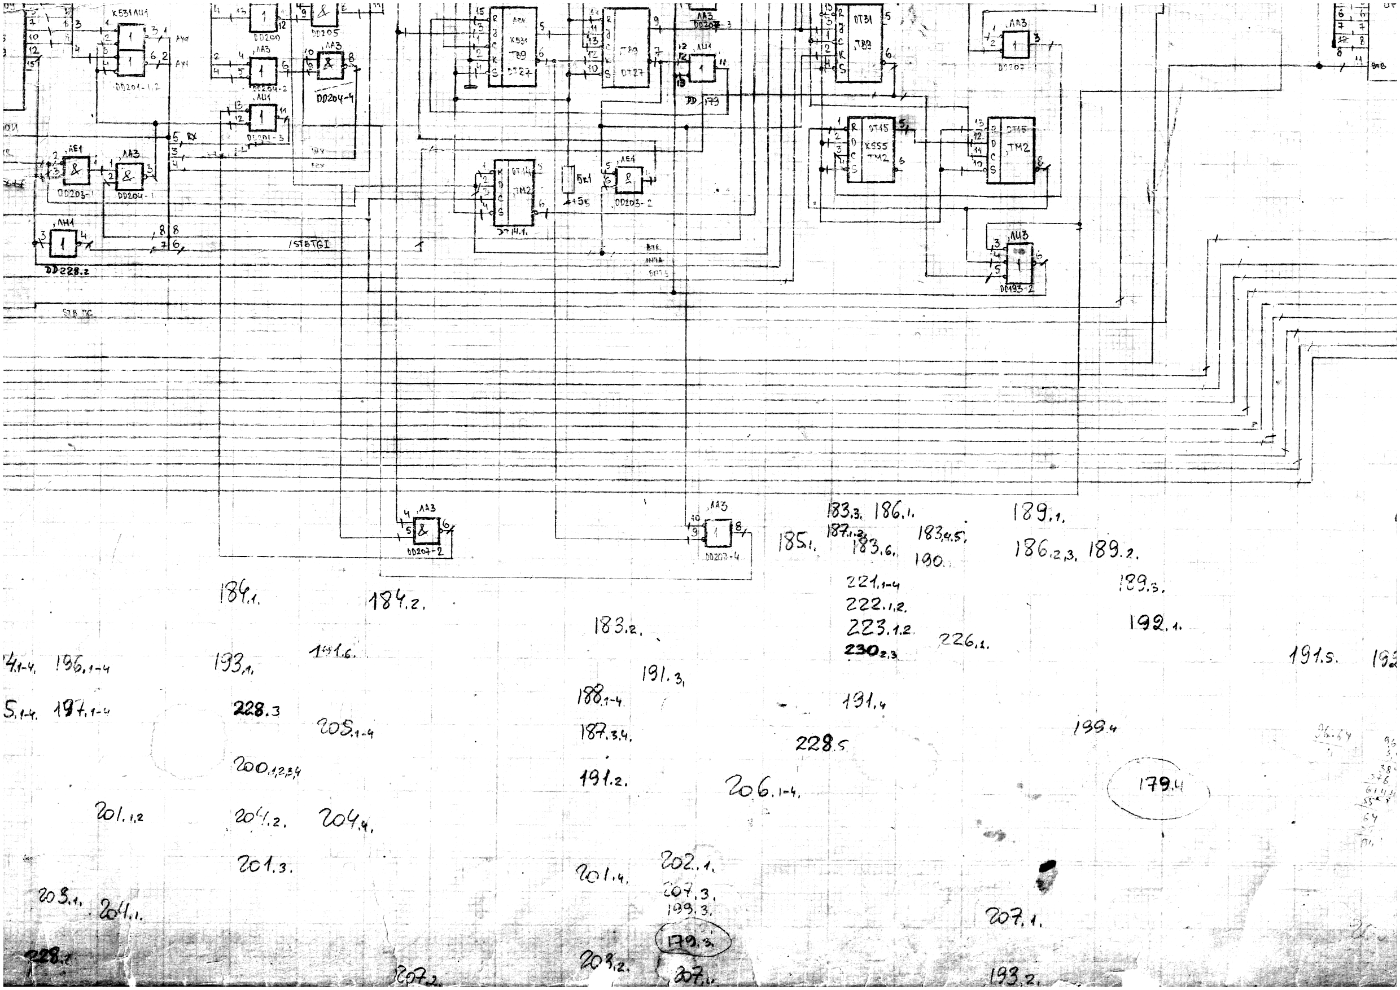
[picture p36: page 1]
