besm6/micro-besm/doc/schematics/page9/tile5a.pdf

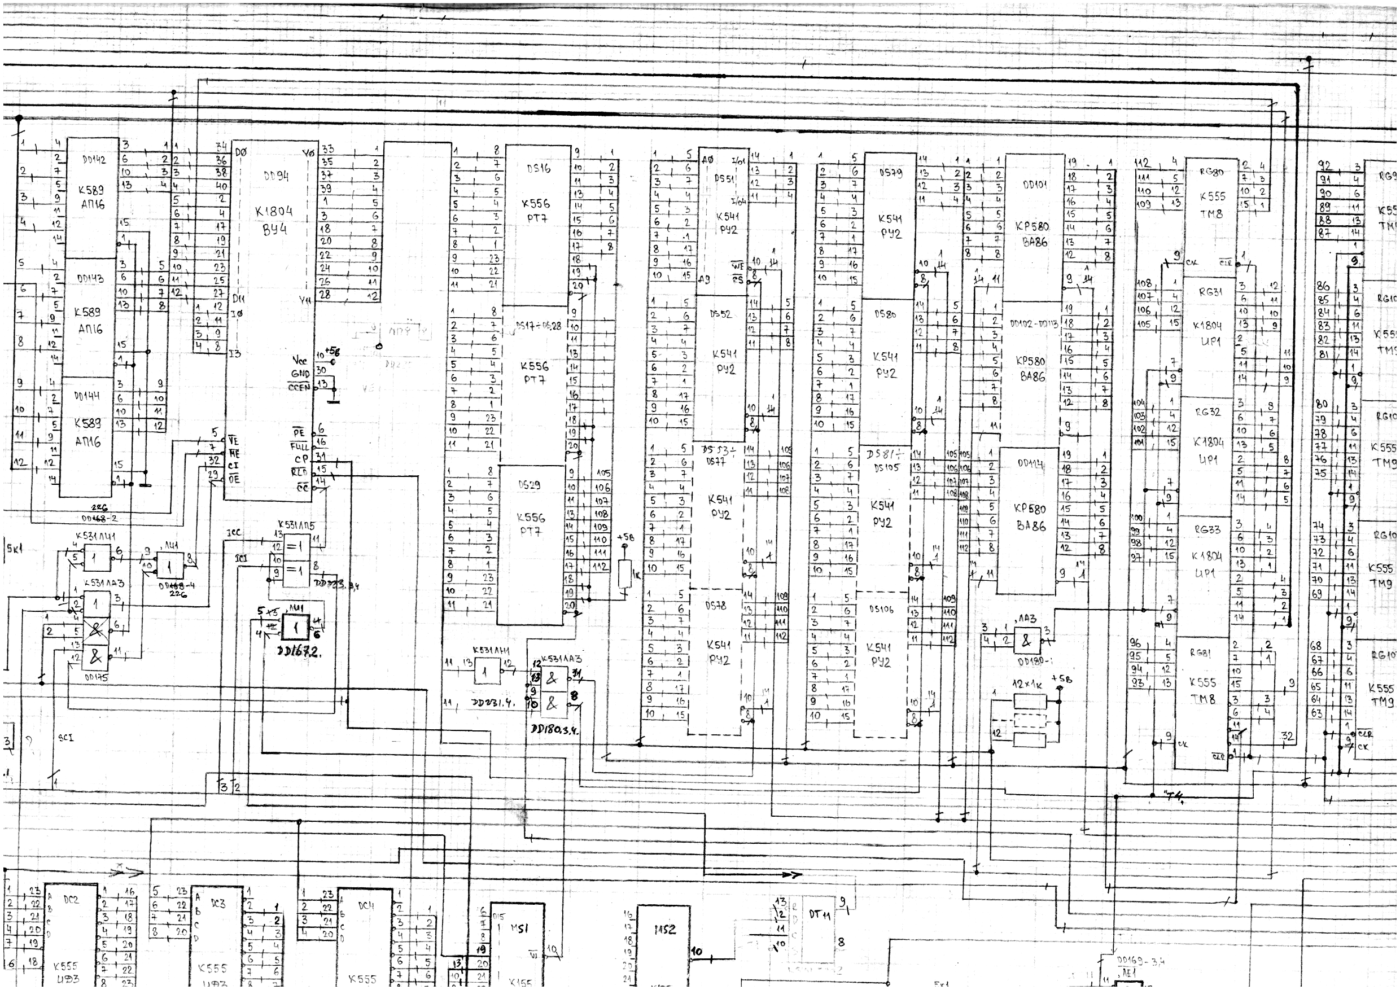
[picture p37: page 1]
