besm6/micro-besm/doc/schematics/page9/tile5b.pdf

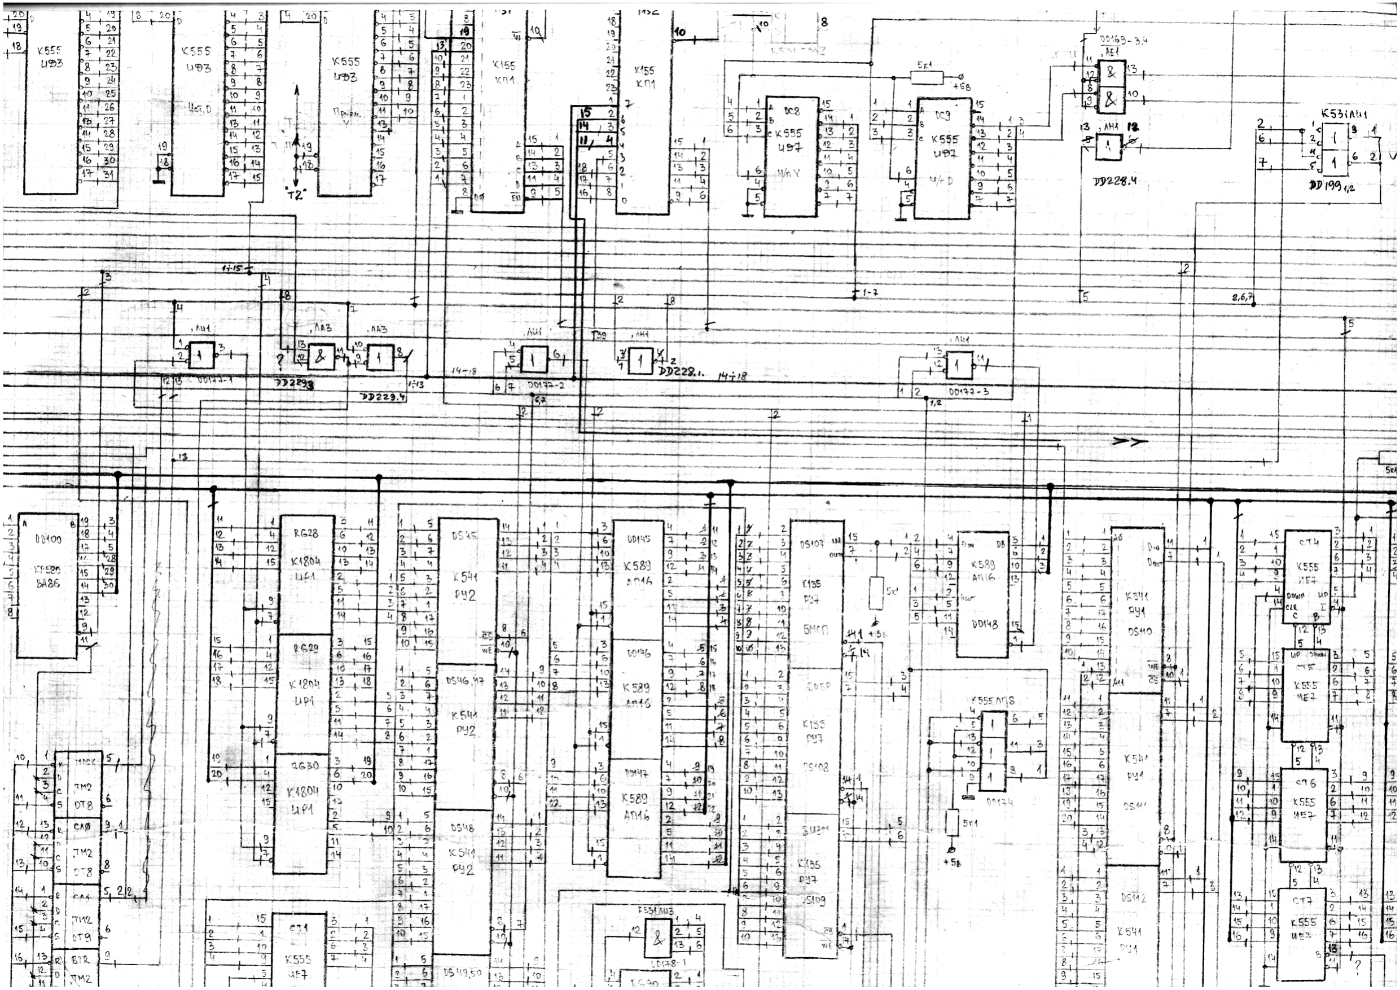
[picture p38: page 1]
