besm6/micro-besm/doc/schematics/page9/tile5c.pdf

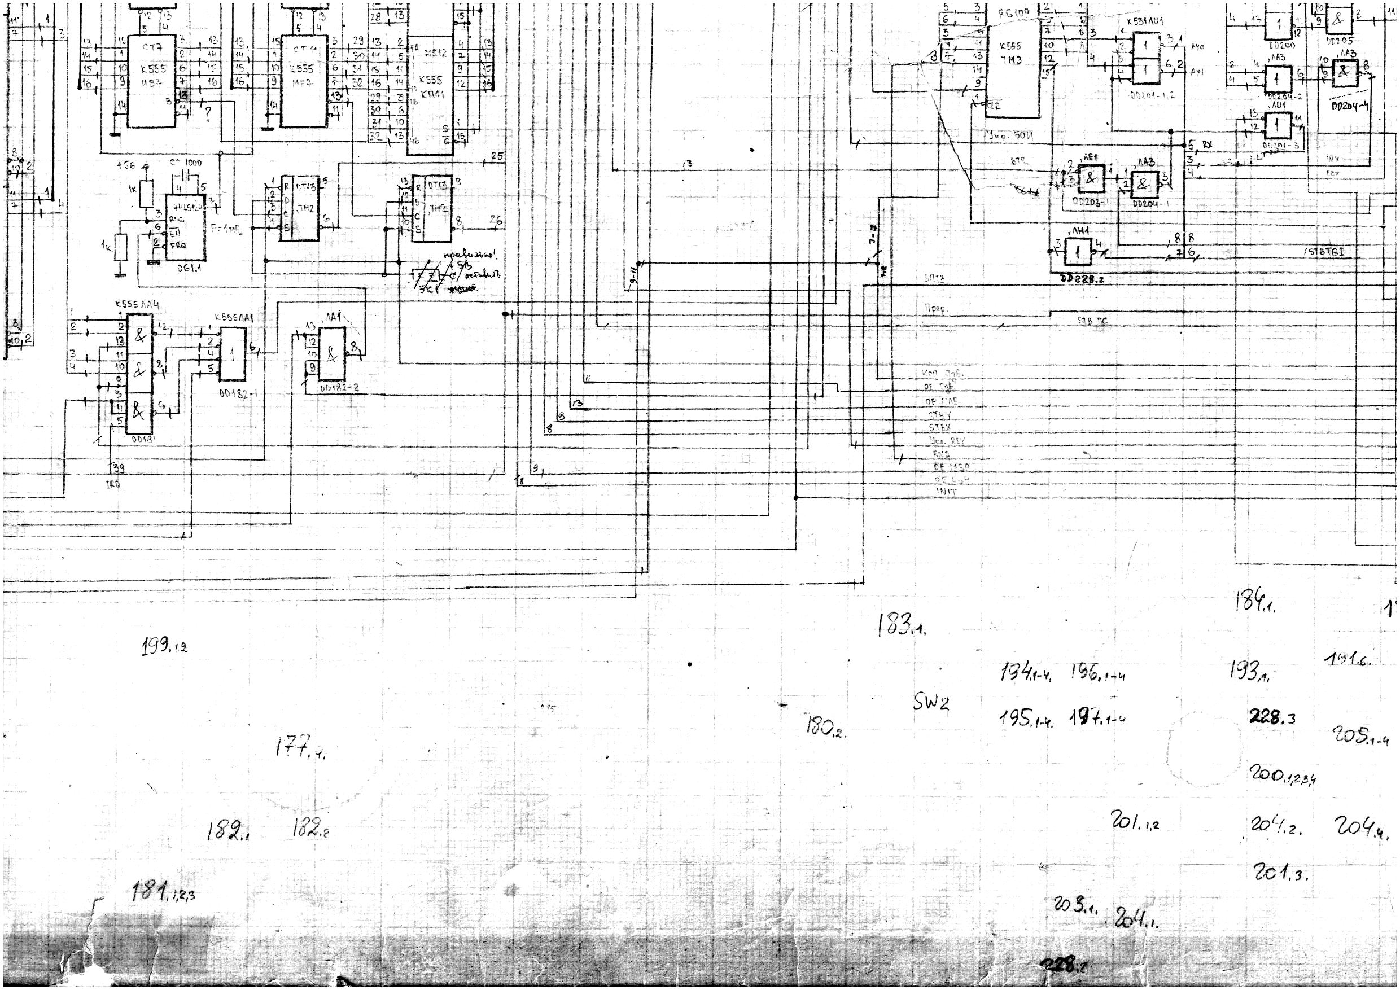
[picture p39: page 1]
