besm6/micro-besm/doc/schematics/page9/tile6a.pdf

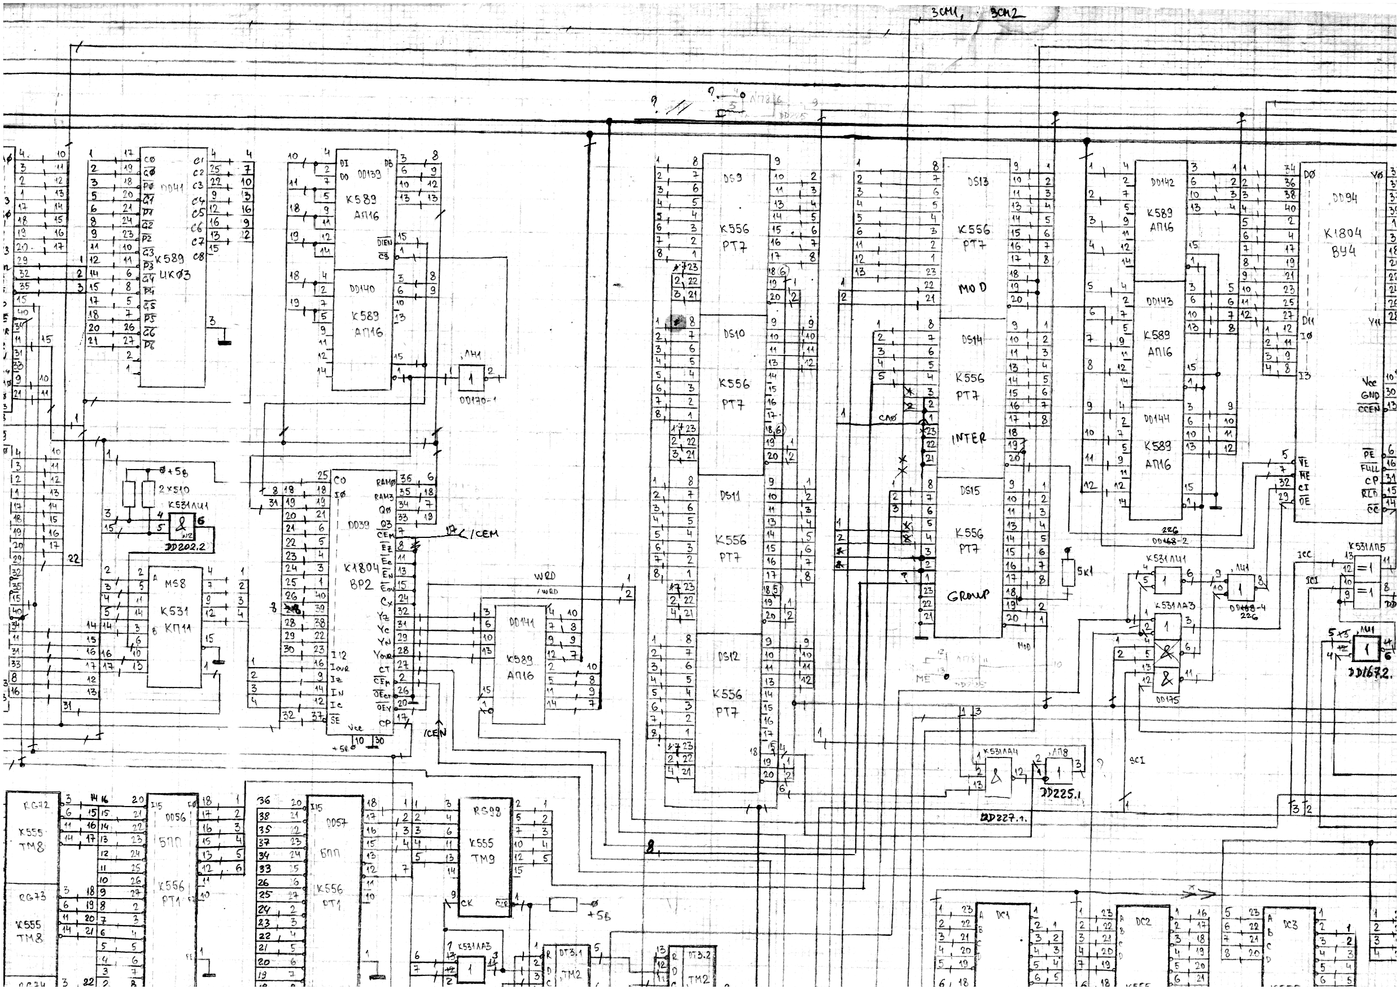
[picture p40: page 1]
