besm6/micro-besm/doc/schematics/page9/tile6b.pdf

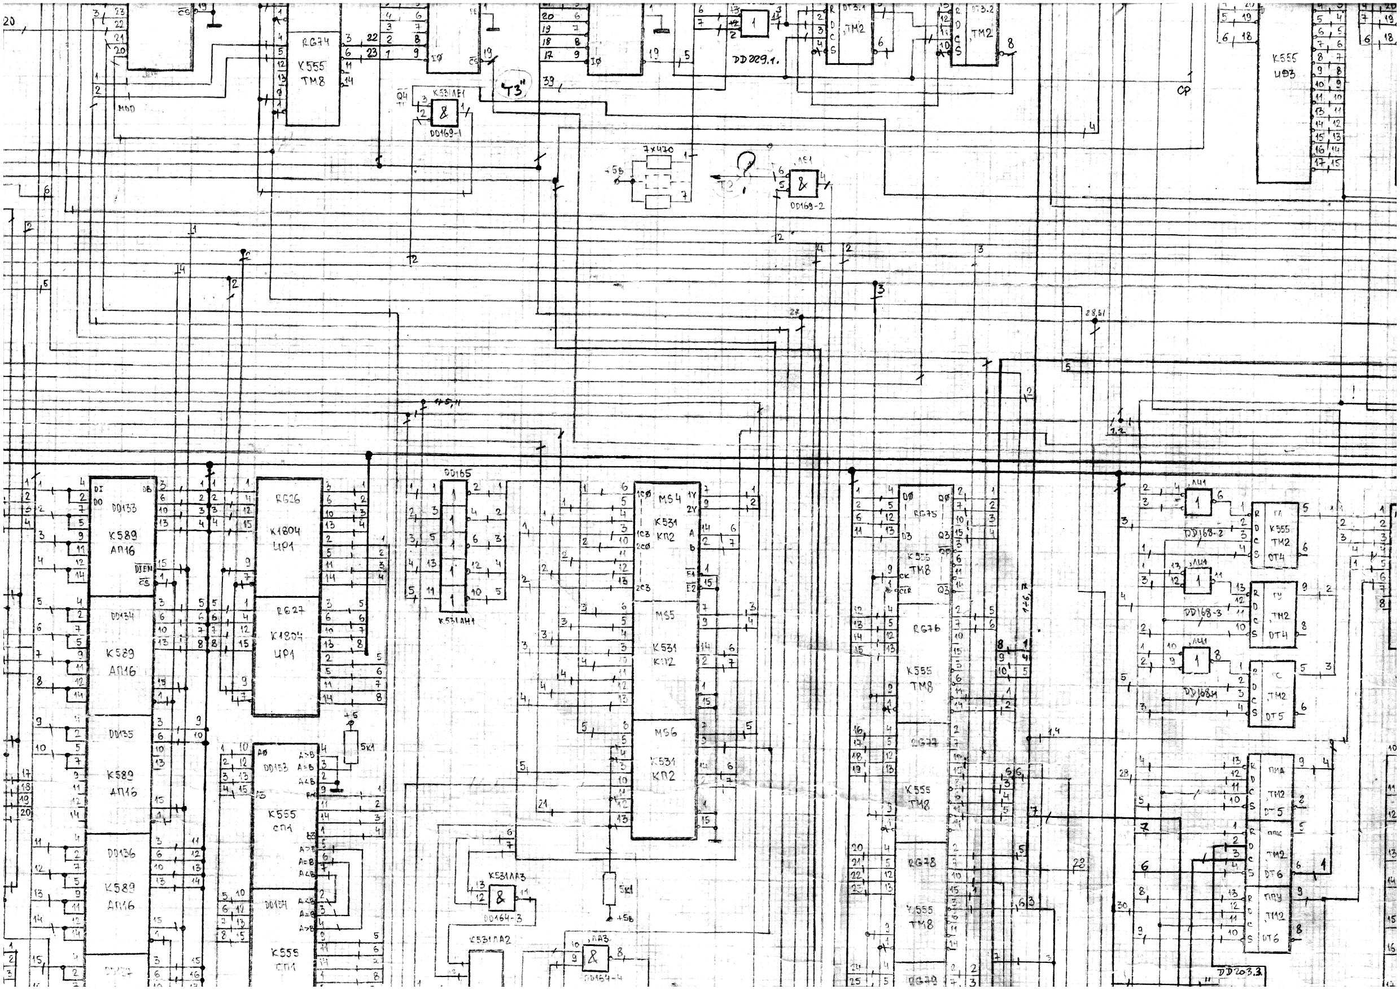
[picture p41: page 1]
