besm6/micro-besm/doc/schematics/page9/tile6c.pdf

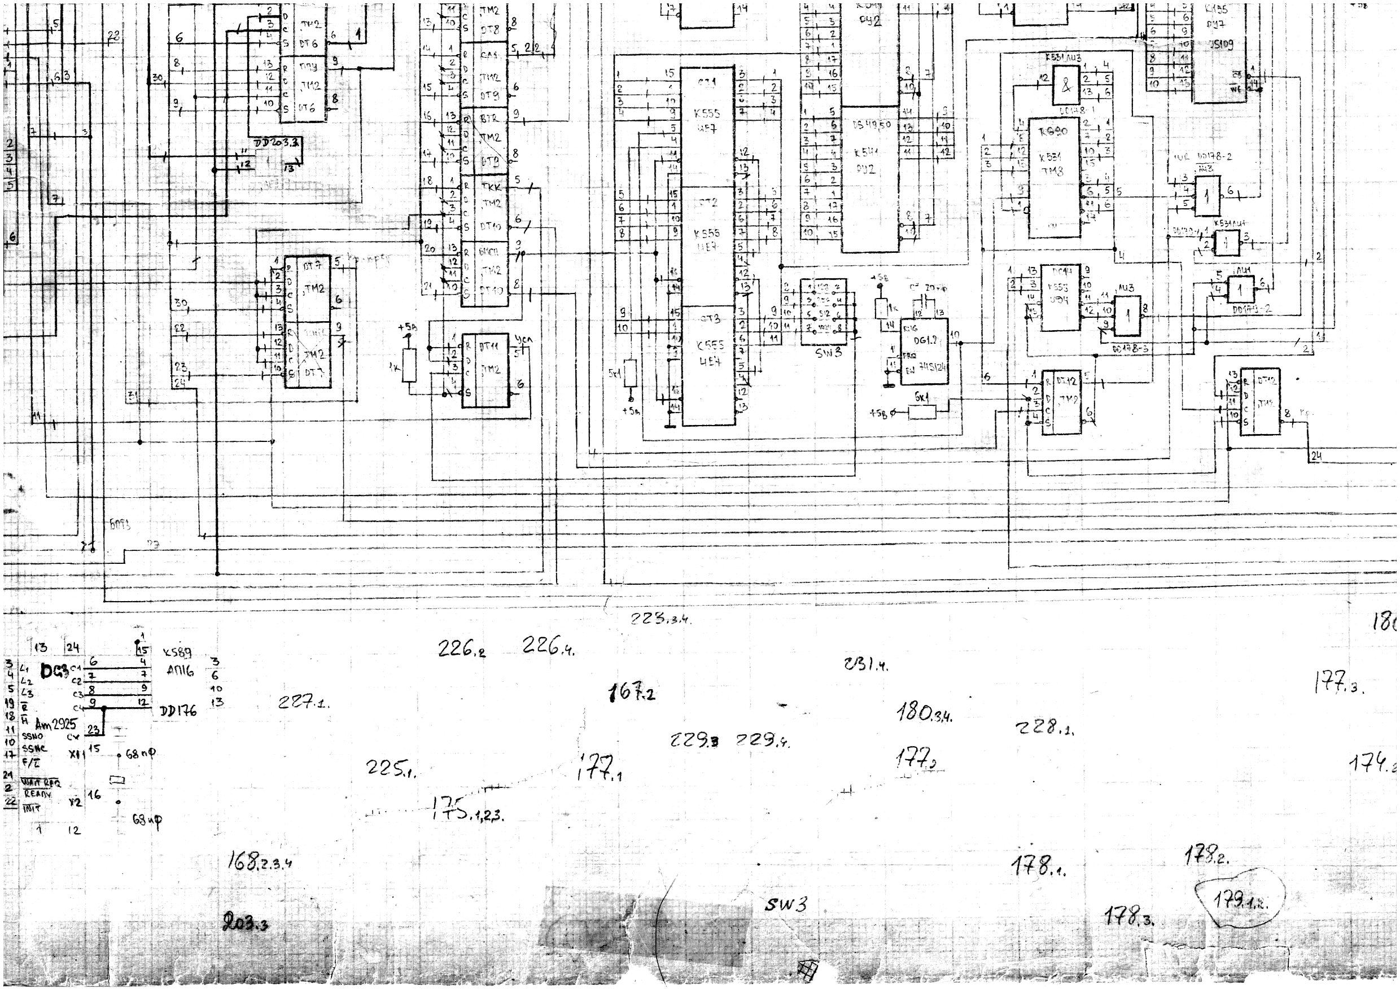
[picture p42: page 1]
