besm6/micro-besm/doc/schematics/page9/tile7a.pdf

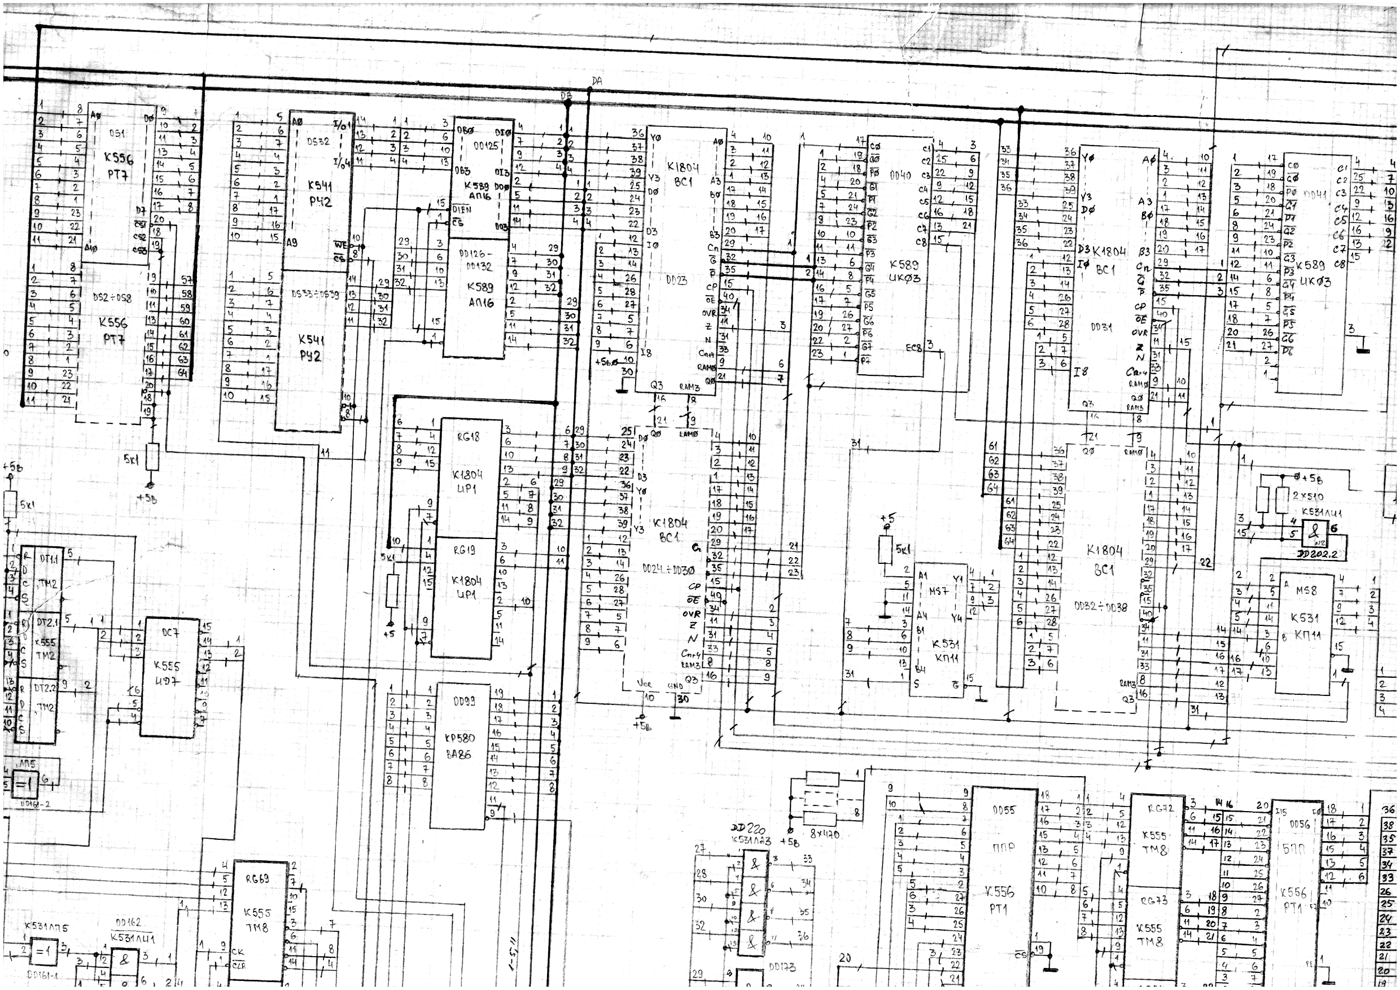
[picture p43: page 1]
