besm6/micro-besm/doc/schematics/page9/tile7b.pdf

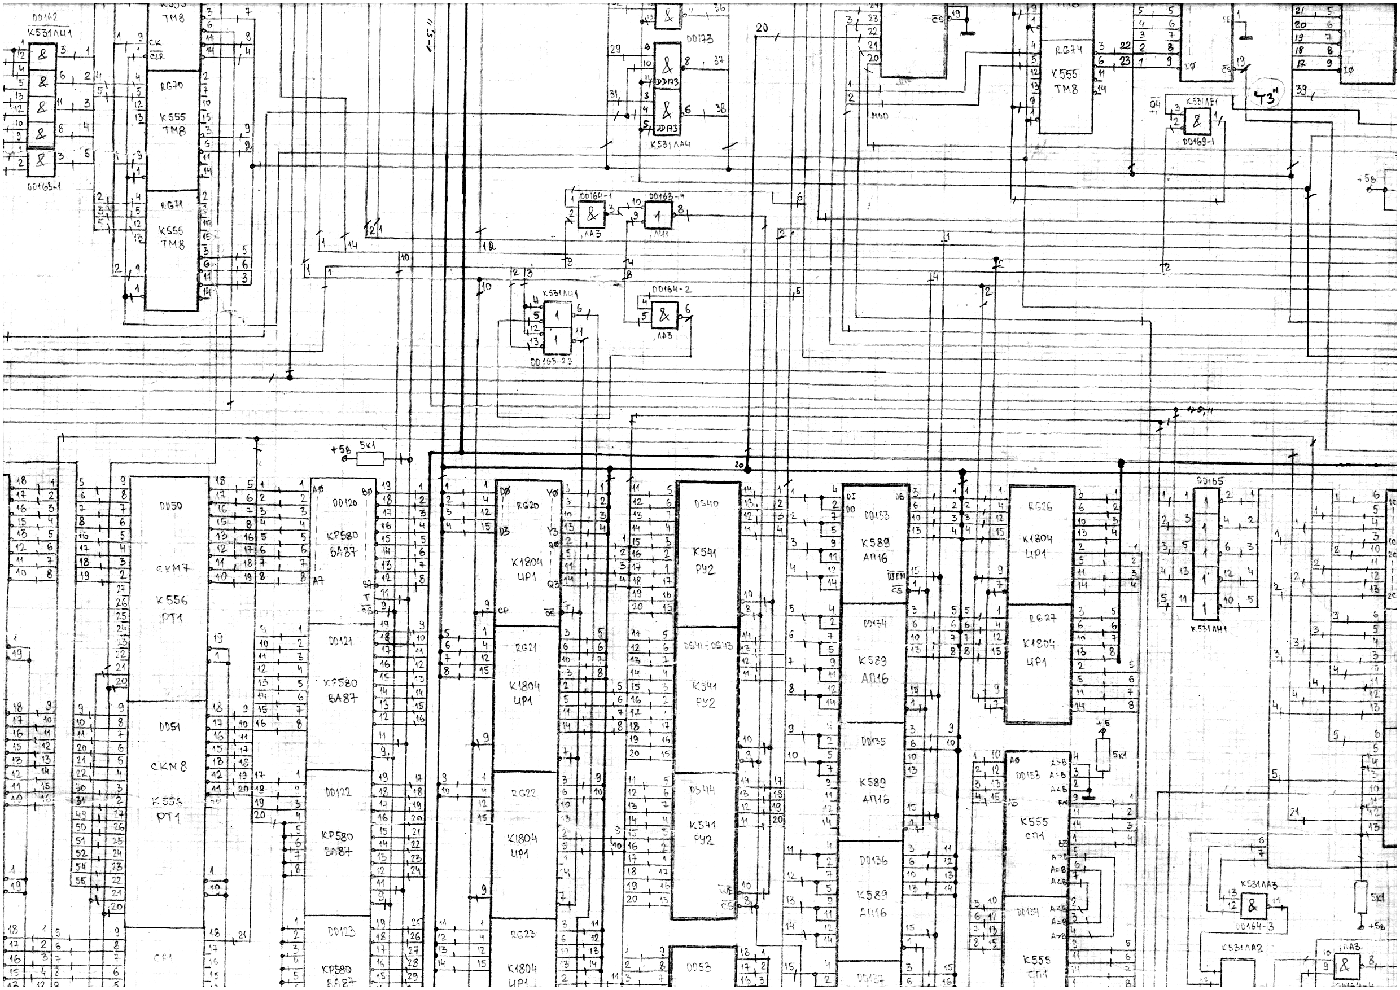
[picture p44: page 1]
