besm6/micro-besm/doc/schematics/page9/tile7c.pdf

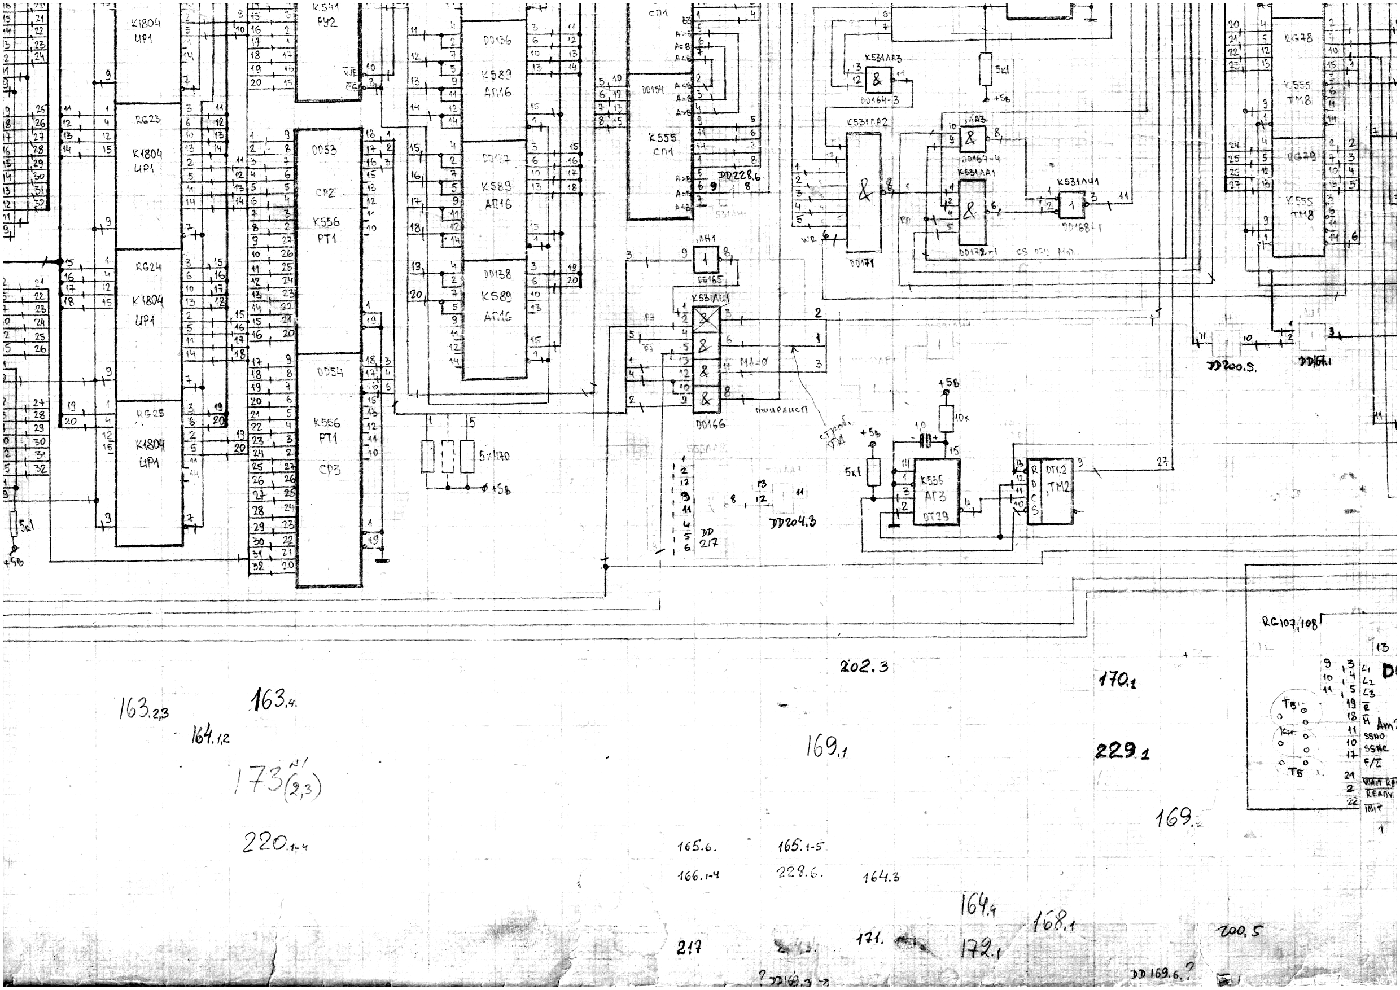
[picture p45: page 1]
