besm6/micro-besm/doc/schematics/page9/tile8a.pdf

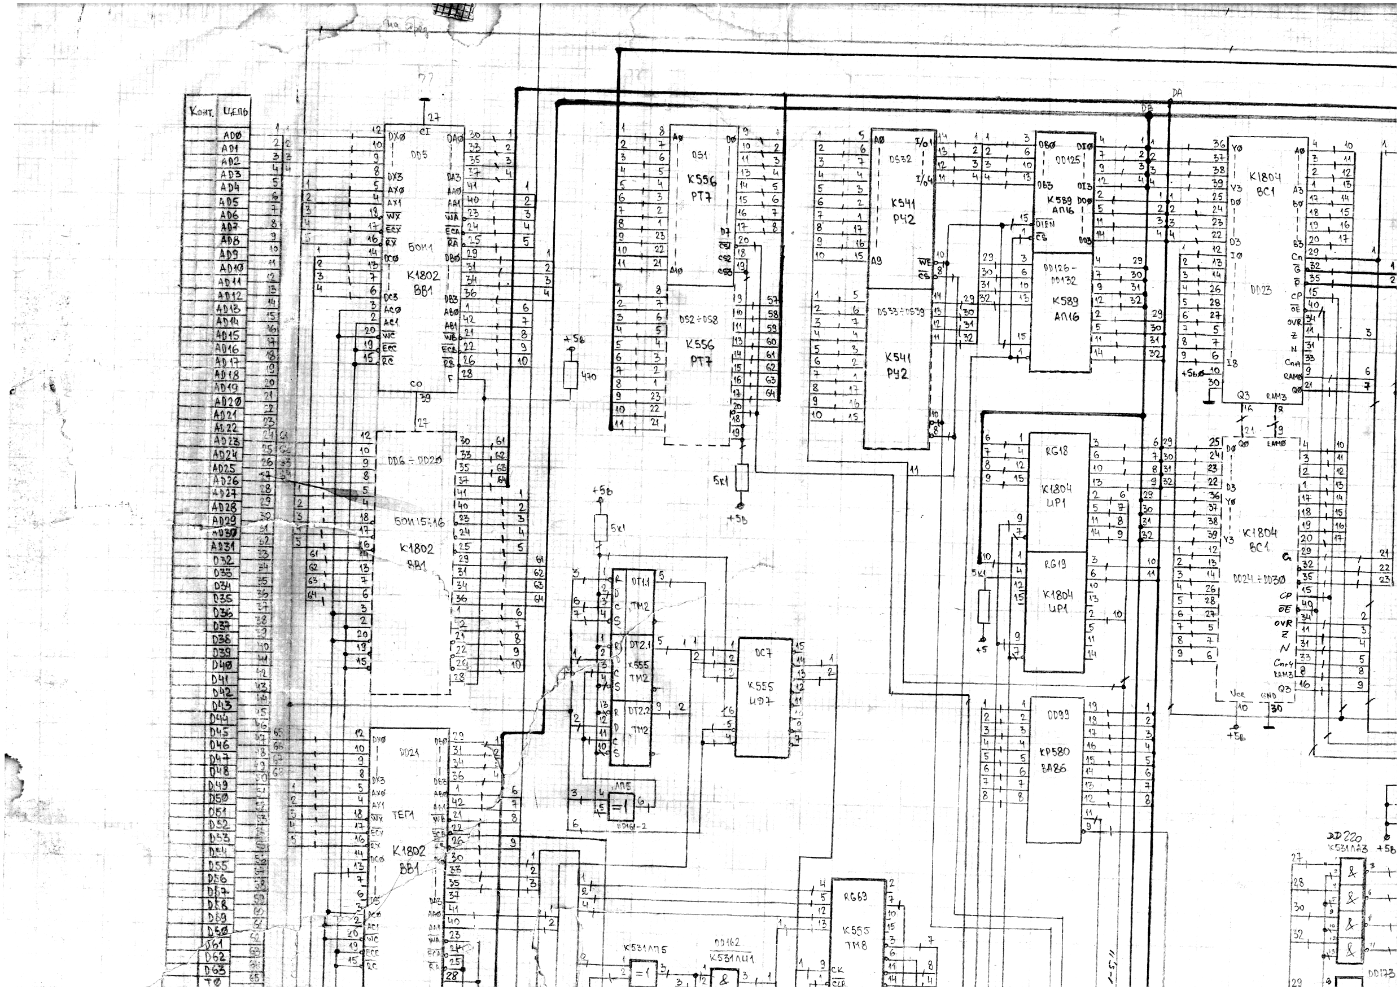
[picture p46: page 1]
