besm6/micro-besm/doc/schematics/page9/tile8b.pdf

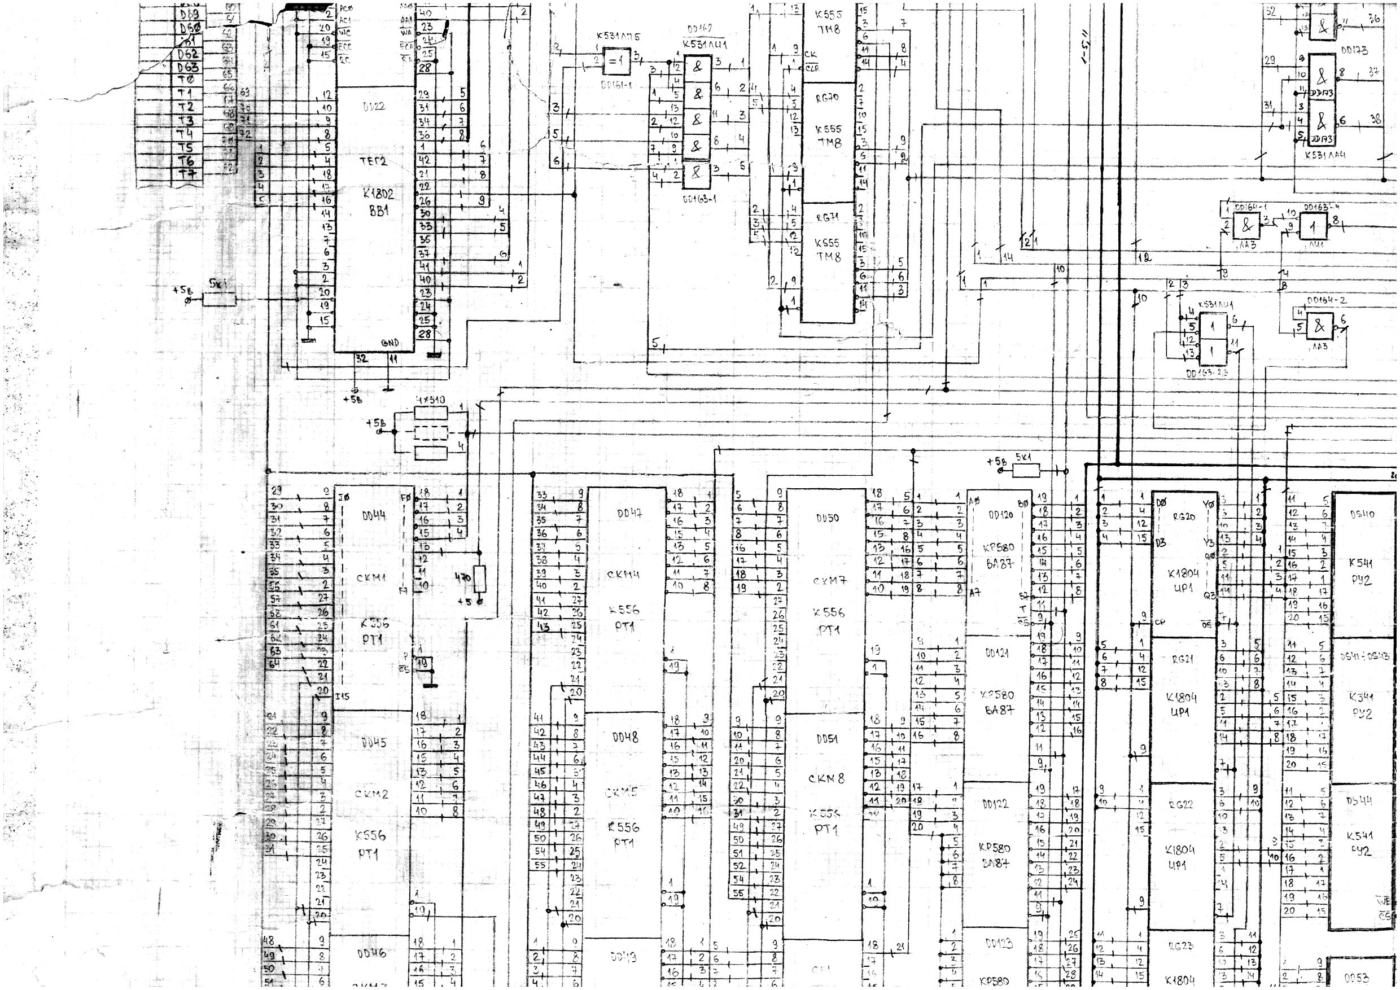
[picture p47: page 1]
