besm6/micro-besm/doc/schematics/page9/tile8c.pdf

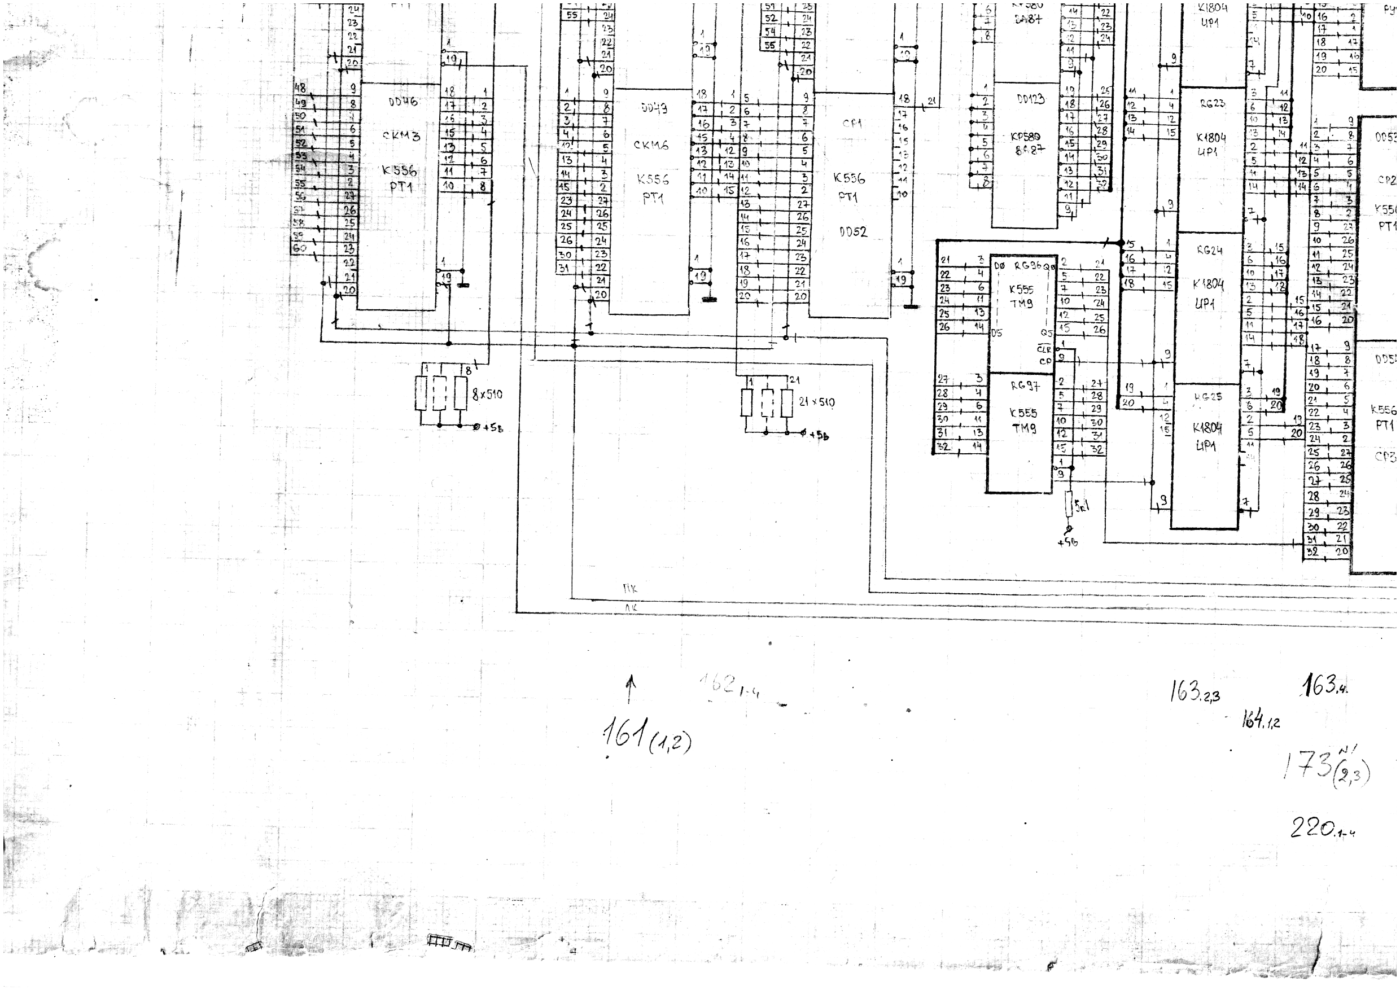
[picture p48: page 1]
