besm6/micro-besm/tests/2901/vhdl/README.md

Sources downloaded from Hamburg VHDL archive:

https://tams-www.informatik.uni-hamburg.de/vhdl/vhdl.html

https://tams-www.informatik.uni-hamburg.de/vhdl/models/29xx/2901.tar.gz
