besm6/micro-besm/microcode/tests/tests.odt

Исходная версия тестов, 1990 г.

Файл | Программы | Что проверяет
arbtest | ARB | Регистр КОП арбитра

iniabt

INIABT

Проверка команд БМПУ

Условные переходы по CT СУСС

Проверка секций МПС + СУСС

32-битный режим МПС

Дополнительные тесты МПС

Проверка регистров/триггеров признаков и условий

ПЗУ констант

Сдвиги в сдвигателе и МПС+СУСС

Поиск левой единицы

Регистр номера группы и память модификаторов

Регистр номера процесса

Регистр исполнительного адреса

Регистр физической страницы

Регистры приписки

БОБР, БИЗМ

БМСП

Память приоритетов страниц

БОИ тега

Регистр КОП арбитра

БОИ данных

БОИ данных и тега

Стандартизатор команд

Память модификаторов с БОИ

Изменение регистра КОП арбитра после физ.адреса

Физ.адрес + запись номера страницы в РФС + изменение БОБР, БИЗМ
initest | INI | Проверка последовательности исполнения команд в БМПУ Проверка всех сигналов, вырабатываемых микропрограммой Проверка дешифраторов, условий, регистров признаков и т.д. на плате УПРО МПС + БОПП ПЗУ Сдвигатель Чтение, запись блока обмена с ПП Автоматические тесты с использованием МПС, СУСС, сдвигателя, БОПП, ПЗУ: Проверка команд БМПУ Условные переходы по CT СУСС Проверка секций МПС + СУСС 32-битный режим МПС Дополнительные тесты МПС Проверка регистров/триггеров признаков и условий ПЗУ констант Сдвиги в сдвигателе и МПС+СУСС
memtest | МЕМ | Статусный регистр ОЗУ Регистр адреса ОЗУ Проверка ОЗУ Кэш команд, кэш данных Режим блочной передачи (BTR) Чтение — модификация — запись Проверка генератора Хемминга
octtest | OCT | БОИ данных БОИ данных и тега Стандартизатор команд Память модификаторов с БОИ Изменение регистра КОП арбитра после физ.адреса Физ.адрес + запись номера страницы в РФС + изменение БОБР, БИЗМ
sectest | SEC | Поиск левой единицы Регистр номера группы и память модификаторов Регистр номера процесса (РНП) Регистр исполнительного адреса Регистр физической страницы (РФС) Регистры приписки БОБР, БИЗМ БМСП Память приоритетов страниц БОИ тега Регистр КОП арбитра Часы и таймер счётного времени Проверка триггеров связи с пультовым процессором

Вторая версия тестов, 1992 г.

Файл | Программы | Что проверяет
cashtest.mak | CASH | Регистр КОП арбитра Статусный регистр ОЗУ Регистр адреса ОЗУ Запись, чтение ОЗУ Кэш команд, кэш данных
iniabt.mak | А1/ | Проверка команд БМПУ Условные переходы по CT СУСС Проверка секций МПС + СУСС 32-битный режим МПС Дополнительные тесты МПС Проверка регистров/триггеров признаков и условий
initest.mak | INI | Проверка триггеров связи с пультовым процессором Чтение, запись блока обмена с ПП Проверка команд БМПУ Условные переходы по CT СУСС Проверка секций МПС + СУСС 32-битный режим МПС Дополнительные тесты МПС Проверка регистров/триггеров признаков и условий
intrtest.mak | INTRPT CTTWR RINT INTINP | Прерывания
memtest.mak | МЕМ | Проверка ОЗУ
modftest.mak | MODF | Регистр номера группы (РНГ) + память модификаторов
octtest.mak | ОСТ | Тесты памяти ПП, доступной ЦП Часы и таймер астрономического времени Дополнительные тесты Память останова
phystest.mak | PHYS | Регистр номера процесса (РНП) Регистр исполнительного адреса Регистр физической страницы (РФС) Регистры приписки БОБР, БИЗМ БМСП Память приоритетов страниц Физ.адрес + запись номера страницы в РФС + изменение БОБР, БИЗМ
shfttest.mak | SHFT | Сдвиги в сдвигателе и МПС+СУСС Поиск левой единицы
stndtest.mak | STND | ПЗУ констант БОИ данных и тега Стандартизатор команд
timetest.mak | TIME | Часы и таймер счётного времени
xemtest.mak | ХЕМ | Одиночная запись, чтение ОЗУ Режим блочной передачи (BTR) Чтение — модификация — запись Проверка генератора Хемминга

Дополнительные файлы

Файл | Программы | Что проверяет
define.mak | --- | Общие определения, с модификациями для умножителя (недоделано).
iotest | --- | Подпрограммы ввода/вывода для остальных тестов
jmpopc.old | --- | Специальная версия икропрограммного переключателя команд для отладки, вместо ПНА
ldtest | --- | Вспомогательный скрипт
tkt | --- | Вспомогательная процедура сравнения
tktest | TAK | Подбор длительности такта
tktest1 | TAK1 CMP | Подбор длительности такта, часть 1
tktest2 | TAK2 | Подбор длительности такта, часть 2
tktest3 | TAK3 | Подбор длительности такта, часть 3
tktest4 | TAK4 | Подбор длительности такта, часть 4
