besm6/micro-besm/tests/2901/am2901.pdf

# Block diagram of Am 2901

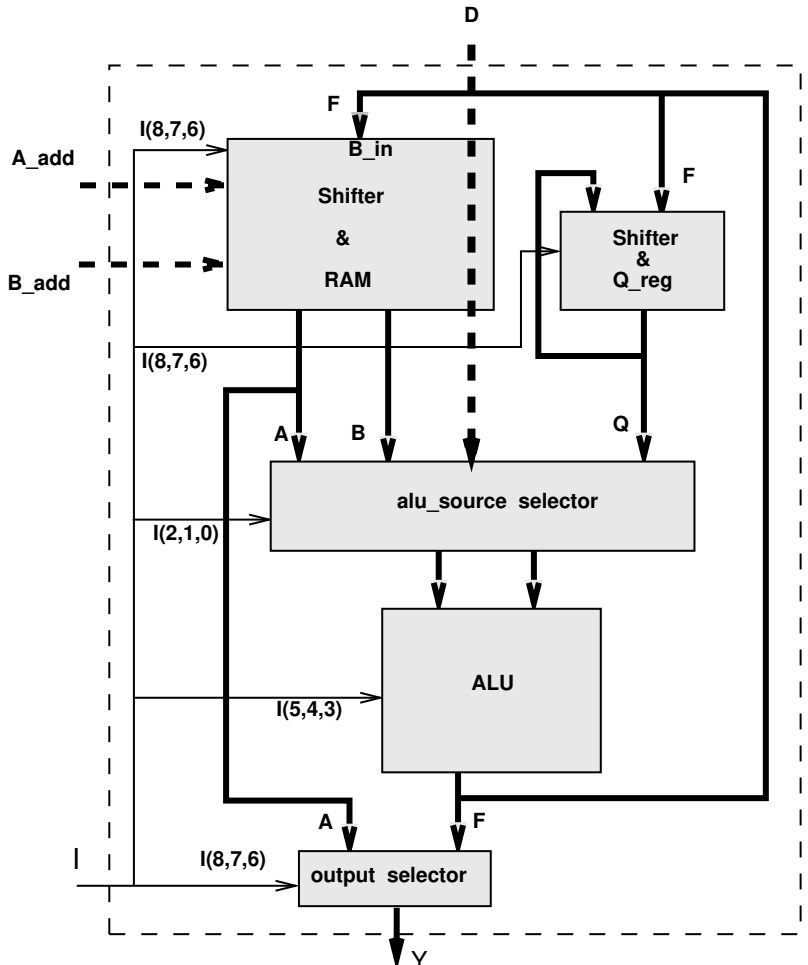
[picture p49: figure]
Shifter; RAM; Shifter & Q_reg; alu_source selector; ALU; output selector; A_add; B_add

Y
