besm6/micro-besm/tests/2910/am2910.pdf

# Am2910 Block Diagram

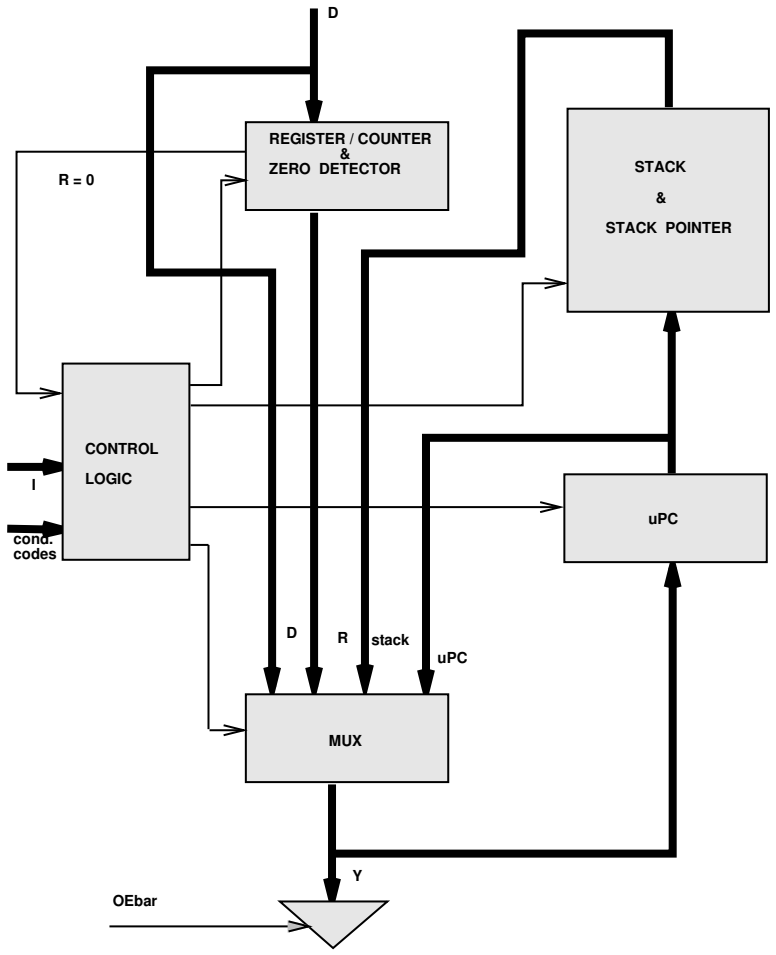
[picture p50: figure]
cond. codes; MUX; uPC; CONTROL; LOGIC; REGISTER / COUNTER &; ZERO DETECTOR; STACK; STACK POINTER; stack; OEbar
