besm6/micro-besm/microcode/microcode.v

// JINIC
       0: 112'hb6510405000a20000050033002c0,    // a= INIC
// INT/IN
       1: 112'h18690405000a20000050033002c0,    // a= INT/RE
// EXT/
       2: 112'h30070e7a800a2000005003300000,    // a= PSEXT.EXT/
// EXT6
       3: 112'h30071e7a806a2000005003300000,    // a= PSEXT.EXT/
// EXTC
       4: 112'he068cc7a800a2060005003300000,
       5: 112'h30070405000a2000005003300000,    // a= PSEXT.EXT/
// EXTDR
       6: 112'he05fcc7a800a2060005003300000,
// PSEXT.EXT/
       7: 112'he000c065000a1000005023300000,
       8: 112'he000e475000a3450005033300000,
       9: 112'he000ce5fb00a3680005023300200,
      10: 112'he056ce5f780a2060005043300500,
      11: 112'he000e875980a3218005033300000,
      12: 112'h30410c75000ab700005023300016,    // a= SMOD.EXT/
      13: 112'he0e1ce56500a2060005003300000,
      14: 112'he1ace5d5600a3761805033300000,
      15: 112'he000ee5eb00a3104005023300000,
      16: 112'he013e475000a2060005007320000,
      17: 112'he000c405000a3f00005023e00000,
      18: 112'he000ce5e300a3e80005023300000,
      19: 112'he000cdde600a104820500a300001,
      20: 112'he000e44d600a3e0000502fe00000,
      21: 112'he000ce5e300a3d8018502c340000,
      22: 112'he0d5ce5d500a2060005003300000,
      23: 112'he0d3ce55d80a2060005003300000,
// W3.EXT/
      24: 112'h30180dde600a104820520a30002b,    // a= W3.EXT/
      25: 112'he000e44d600a3d0000502fe00000,
      26: 112'he000ce5e300a3c80185023340000,
      27: 112'he000cd95580a2000005003300000,
// W5.EXT/
      28: 112'h301c0dde600a104820520a30002b,    // a= W5.EXT/
      29: 112'he000e44d600a3c0000502fe00000,
      30: 112'he000ce5e300a3b80185023340000,
// W7.EXT/
      31: 112'h301f0dde600a104820520a30002b,    // a= W7.EXT/
      32: 112'he000e44d600a3b0000502fe00000,
      33: 112'he000ce5e300a3a80185023340000,
// W9.EXT/
      34: 112'h30220dde600a104820520a30002b,    // a= W9.EXT/
      35: 112'he000e44d600a3a0000502fe00000,
      36: 112'he000ce5e300a3980185023340000,
// W11.EXT/
      37: 112'h30250dde600a104820520a30002b,    // a= W11.EXT/
      38: 112'he000e44d600a390000502fe00000,
      39: 112'he000ce5e300a3880185023340000,
// W13.EXT/
      40: 112'h30280dde600a104820520a30002b,    // a= W13.EXT/
      41: 112'he000e44d600a380000502fe00000,
      42: 112'he000ce5e300a3600185023340000,
// W15.EXT/
      43: 112'h302b0dde600a104820520a30002b,    // a= W15.EXT/
      44: 112'he000e87de010200000500f30a000,
      45: 112'he0d4ce55d80a2060185003340000,
      46: 112'he000ce1a300a2000005003300000,
// WPC.EXT/
      47: 112'h302f287e180a104820520330002b,    // a= WPC.EXT/
      48: 112'he000e59e200a200000500f300000,
      49: 112'he000cd9d580a2000185003340000,
// WRR.EXT/
      50: 112'h3032287e500a104820520330002b,    // a= WRR.EXT/
      51: 112'he000e59fe00a200000500f300000,
      52: 112'he000cc76000a3700185023340000,
// WR.EXT/
      53: 112'h30350c75800a200800520330002a,    // a= WR.EXT/
      54: 112'he000c405000a2000005003340000,
      55: 112'he022e6d5600a3761805033300000,
      56: 112'he000e6750001b6800050b7320000,
// ENDE.EXT/
      57: 112'he06fe455680a3860005033300000,
      58: 112'he074ec56e80a3160005033300000,
      59: 112'h105a2425000a3880005033300000,    // a= ACTRG
      60: 112'he0e6ec59a80a2064005003300480,
      61: 112'he000c405000a3400005023f00000,
      62: 112'h38522655380a3c00005033b0000a,    // a= LCWPH
      63: 112'he05ac655680a2060005043300000,
      64: 112'h794d0405000a2000005003300016,    // a= INT36
// SMOD.EXT/
      65: 112'h105528762010318000503330a000,    // a= SAVRG
      66: 112'he000cc76800a3100005023300000,
      67: 112'he000c405000a3580005023c00000,
      68: 112'he000c405000a3480005023e00000,
      69: 112'he000c405000a3500005023f00000,
      70: 112'he000cc75800a2008005003300000,
      71: 112'he000cc76000a3600005023300000,
      72: 112'he000e87f700a25c8205003300001,
      73: 112'he000e475000a3404005023300000,
      74: 112'he000e445700a2000805003300000,
      75: 112'he000c405000a3400005033360000,
      76: 112'he000e445600a3600005033300000,
      77: 112'he000cc76000a3680005023300000,
      78: 112'he056ce5e600a35e0005038300000,
      79: 112'he0dcee5dd80a206000500c300000,
      80: 112'he000cdd6600a1ec8205008300001,
      81: 112'he000e445600a3680005037320000,
      82: 112'he0e1ce56500a34e000503a300000,
      83: 112'he1abe5d56001b7618050b3300000,
      84: 112'h30390405000a350000503b300000,    // a= ENDE.EXT/
// SAVRG
      85: 112'he0d5ce5d500a2060005003300000,
      86: 112'he0d3ce55d80a2060005003300000,
      87: 112'he000cd95580a2000005003300000,
      88: 112'he0d4ce56600a2060005003300000,
      89: 112'ha000ed95600a3700005033300000,
// ACTRG
      90: 112'he000ce56380a2048205001320001,
      91: 112'he011c655600a2060005043300000,
      92: 112'h30602445600a3c80005033300016,    // a= NRWR.EXT/
      93: 112'he000cc76000a3880005023300000,
      94: 112'he0d1e655600a38e0005033300000,
      95: 112'he0d1ce51980a2060005003300000,
// NRWR.EXT/
      96: 112'he061e876180a3960005033300000,
      97: 112'he000e655600a3980005033800000,
      98: 112'he000e655380a3a10005033300000,
      99: 112'he000e445500a3a80005033300000,
     100: 112'he000e445780a3b00005033300000,
     101: 112'he0dde655580a3be0005033300000,
     102: 112'he000ce56380a2048205002320001,
     103: 112'hc8522445600a3d00005033300000,    // a= LCWPH
     104: 112'he000ec7e000a3d80005033900000,
     105: 112'he000e87e600a3048205003300001,
     106: 112'ha000e445600a3e00005033300000,
// ATX
     107: 112'he000ec62800a1004005023300000,
     108: 112'hc8580405000a200014500c3405c0,    // a= LCW
// WA.ATX
     109: 112'h306d283d000a200000520f30002a,    // a= WA.ATX
     110: 112'h70004075000a204000510330721e,
// ATXF
     111: 112'he000ec62800a1004005023300000,
     112: 112'hc8580425000a200014504c3405c0,    // a= LCW
// PSATXF
     113: 112'h306d283d000aa00000500f300016,    // a= WA.ATX
// WAF.ATX
     114: 112'h30720075000a204000520330002a,    // a= WAF.ATX
     115: 112'h700064452a0a380000513330721e,
// STX
     116: 112'he000ec62800a1004005023300000,
     117: 112'he000c405000a200014500c340000,
     118: 112'h4858283d000a200000500f300000,    // a= LCW
     119: 112'hd0002d77800a380400502330002a,
     120: 112'h107b0c42f80a2000125c0c3405c0,    // a= RDOPER1
     121: 112'h70006878280a38000051b3a0705e,
// RDOPER
     122: 112'hc8580405000a2000125c0c3405c0,    // a= LCW
// RDOPER1
     123: 112'ha000c075000a204000580330022a,
     124: 112'ha000c405000a200000580330002a,
     125: 112'ha000c405000a200000580330002a,
     126: 112'ha000c405000a200000580330002a,
// XTS
     127: 112'he000ec72800a3804005023300000,
     128: 112'h30850c45aa0a200014500c34001c,    // a= XTSF.XTS
     129: 112'h4858283d000a200000500f300000,    // a= LCW
     130: 112'hd000ec67800a100400502330002a,
     131: 112'h107b0c42f80a2000125c0c3405c0,    // a= RDOPER1
     132: 112'h70006878580a38000051b3a0705e,
// XTSF.XTS
     133: 112'h3085283d000a200000520f30002a,    // a= XTSF.XTS
     134: 112'h107a2c02d80a2004005003300000,    // a= RDOPER
     135: 112'h70006878580a38000051b3a0705e,
// XTA
     136: 112'h107a2c62800a1004005023300000,    // a= RDOPER
     137: 112'h70004c78000a2000005183a0705e,
// XTAF
     138: 112'hc8580425000a2000005043300000,    // a= LCW
// PSXTAF
     139: 112'h30882d72800ab804005023300016,    // a= XTA
     140: 112'h107b0405000a2000125c0c3405c0,    // a= RDOPER1
     141: 112'h70006878280a38000051b3a0705e,
// AAX
     142: 112'h107a2c62800a1004005023300000,    // a= RDOPER
     143: 112'h70004e58000a2000005183a0705e,
// AAXF
     144: 112'hc8580425000a2000005043300000,    // a= LCW
     145: 112'h308e2d72800ab80400502f300016,    // a= AAX
     146: 112'h107b0405000a2000125c0c3405c0,    // a= RDOPER1
     147: 112'h70004e58000a38000051bba0705e,
// AEX
     148: 112'hc8582c62800a1004005023300000,    // a= LCW
     149: 112'h107b0c48800a2000125c0c3405c0,    // a= RDOPER1
     150: 112'h70004f58000a2000005183a0705e,
// AEXF
     151: 112'hc8580425000a2000005043300000,    // a= LCW
     152: 112'h30942d72800ab80400502f300016,    // a= AEX
     153: 112'h107b0c48800a2000125c0c3405c0,    // a= RDOPER1
     154: 112'h70004f58000a38000051bba0705e,
// ARX
     155: 112'h107a2c62800a1004005023300000,    // a= RDOPER
     156: 112'he000cc58000a2000005043a00000,
     157: 112'h70004c48060a200000518330709e,
// ARXF
     158: 112'hc8580425000a2000005043300000,    // a= LCW
     159: 112'h309b2d72800ab80400502f300016,    // a= ARX
     160: 112'h107b0405000a2000125c0c3405c0,    // a= RDOPER1
     161: 112'he000cc58000a2000005043a00000,
     162: 112'h70004c48060a38000051bb30709e,
// AOX
     163: 112'h107a2c62800a1004005023300000,    // a= RDOPER
     164: 112'h70004dd8000a2000005183a0705e,
// AOXF
     165: 112'hc8580425000a2000005043300000,    // a= LCW
     166: 112'h30a32d72800ab80400502f300016,    // a= AOX
     167: 112'h107b0405000a2000125c0c3405c0,    // a= RDOPER1
     168: 112'h70004dd8000a38000051bba0705e,
// APX
     169: 112'he000ec62800a1004005023300000,
     170: 112'he000ce7e800a380012502cf40000,
// WA.APX
     171: 112'h30ab004d0001a00000528330002a,    // a= WA.APX
     172: 112'hc8580c7f000a380000503ba005c0,    // a= LCW
// APXC
     173: 112'h30b1143f00522000005083300016,    // a= OUT.APX
     174: 112'h30b0040500152000005003300056,    // a= ISC1.APX
     175: 112'h30ad102d000a2000005003300000,    // a= APXC
// ISC1.APX
     176: 112'h30ad103e81aa2000005003300000,    // a= APXC
// OUT.APX
     177: 112'h784d0c48680a200000518330621e,    // a= JQ
// APXF
     178: 112'he000c425000a2000005043300000,
     179: 112'h30a92d72800ab80400502f300016,    // a= APX
     180: 112'h30ab0e7e800a200012500c340000,    // a= WA.APX
// AUX
     181: 112'he000ec62800a1004005023300000,
     182: 112'he000c27d000a380012502cf40000,
// WA.AUX
     183: 112'h30b70c4f800a200000520330002a,    // a= WA.AUX
     184: 112'hc03f0c7f000a380000503ba005c0,
// AUXC
     185: 112'h4000c405000a2000005203300000,
     186: 112'he000dc3f000a2000005083300200,
     187: 112'h30bd040500152000005003300056,    // a= ISC1.AUX
     188: 112'hf0be182d004a2000005203300000,    // a= OUT.AUX
// ISC1.AUX
     189: 112'h8000d83f81ea2000005003300000,
// OUT.AUX
     190: 112'h38580c28000a200000538330601e,    // a= LCW
     191: 112'h30004075000a204000d003300000,
// AUXF
     192: 112'he000c425000a2000005043300000,
     193: 112'h30b52d72800ab80400502f300016,    // a= AUX
     194: 112'h30b7027d000a200012500c340000,    // a= WA.AUX
// ACX
     195: 112'h10c62c62800a1004005023300000,    // a= ACXN.ACX
     196: 112'hc8580c58680a2000005043a00000,    // a= LCW
     197: 112'h70004c38060a200000518330705e,
// ACXN.ACX
     198: 112'he000cc4f800a200012500c3405c0,
// WAS.ACX
     199: 112'h30c70075000a204000520330002a,    // a= WAS.ACX
     200: 112'h403f0e7e8001a000005083300000,
     201: 112'hb0cb143f80522000005083300016,    // a= RET.ACX
     202: 112'h8000cc3e86122000005003300000,
// RET.ACX
     203: 112'ha000c405000a2000005003300200,
// ACXF
     204: 112'he000c425000a2000005043300000,
     205: 112'h30c30405000aa000005003300016,    // a= ACX
     206: 112'h10c62d72800a380400502f300000,    // a= ACXN.ACX
     207: 112'hc8580c58680a2000005043a00000,    // a= LCW
     208: 112'h70004c38060a38000051bb30705e,
// ANX
     209: 112'h10d32c62800a1004005023300000,    // a= ANXN.ANX
     210: 112'h70004c38060a200000518330701e,
// ANXN.ANX
     211: 112'he065cc7f000a206012500c3405c0,
     212: 112'he000e87e820a2058005003300000,
     213: 112'he000ce1ef00a2000005003300000,
     214: 112'he01ae55d6a0a2064805003300000,
     215: 112'hc8582878800a2048205003300000,    // a= LCW
// WAS.ANX
     216: 112'h30d80075000a204000520330022a,    // a= WAS.ANX
     217: 112'ha000cc58680a2000005043a00040,
// ANXF
     218: 112'he000c425000a2000005043300000,
     219: 112'h30d10405000aa000005003300016,    // a= ANX
     220: 112'h10d32d72800a380400502f300000,    // a= ANXN.ANX
     221: 112'h70004c38060a38000051bb30701e,
// ASX
     222: 112'he000ec62800a1004005023300000,
     223: 112'he000cc4f800a200012500c3405c0,
// WA.ASX
     224: 112'h30e00075000a204000520330002a,    // a= WA.ASX
// ASXS.ASX
     225: 112'hc8580c7f000a3ac840504a300001,    // a= LCW
     226: 112'he0a4e87ef00a2064805003300200,
     227: 112'h30e62878780f2048205083300056,    // a= RSH.ASX
// LSH.ASX
     228: 112'he000e41ef00a2004805003300000,
// PSSH.ASX
     229: 112'h70006878f80a204820510330701e,
// RSH.ASX
     230: 112'h30e52516f20a2004805003300000,    // a= PSSH.ASX
// ASXF
     231: 112'he000c425000a2000005043300000,
     232: 112'h30de2d72800ab804005023300016,    // a= ASX
     233: 112'he000cc4f800a200012500c3405c0,
// WALF.ASX
     234: 112'h30ea0075000a204000520330002a,    // a= WALF.ASX
     235: 112'h30e12445280a3800005033300000,    // a= ASXS.ASX
// ASN
     236: 112'hc0f12c62800a1004805023300000,    // a= RSH.ASN
     237: 112'he01ac655280a2060005043300000,
     238: 112'h50f2287f800a2048205003300216,    // a= LSH.ASN
     239: 112'hc8582878800a20482050033005c0,    // a= LCW
     240: 112'h784d0c48780a200000518330605e,    // a= JQ
// RSH.ASN
     241: 112'ha0a4e4d52a0a2064805003300000,
// LSH.ASN
     242: 112'ha0a4e455280a2064805003300000,
// ATI
     243: 112'hc84f2c62800a1004005023300000,    // a= LCWISE
     244: 112'h784e2445000a00000052333005d0,    // a= JIQ
// ITA
     245: 112'hc8582c62800a100400502330000e,    // a= LCW
// PSITA
     246: 112'h31200475000a0000005063e00200,    // a= PSUTA
// MTJ
     247: 112'he000c405000a1000005023f00000,
     248: 112'hc8582c22800a20040050033005c0,    // a= LCW
     249: 112'h70004075000a004000513b30721e,
// JDM
     250: 112'he000ec22800a1004005023f00000,
     251: 112'hc8580c77800a00000050233005c0,    // a= LCW
     252: 112'h784d2455780a0000005133b0721e,    // a= JQ
// WTC
     253: 112'h107a2c62800a1004005023300200,    // a= RDOPER
     254: 112'h784d0405000a378000513a30015e,    // a= JQ
// WTCF
     255: 112'hc8580425000a2000005043300000,    // a= LCW
     256: 112'h30fd2d72800ab804005023300016,    // a= WTC
     257: 112'h107b0405000a2000125c0c3405c0,    // a= RDOPER1
     258: 112'hc8580405000a378000503a300140,    // a= LCW
     259: 112'h70006445280a380000d13330021e,
// VTM
     260: 112'hc84f2c22800a1000005033300000,    // a= LCWISE
// JRPCH
     261: 112'h784e0405000a20000052033005d0,    // a= JIQ
// UTM
     262: 112'h31040065000a1000005023300000,    // a= VTM
// UZA
     263: 112'he000c065000a1000005023300340,
     264: 112'hc85a0405000a2000005003300380,    // a= JNNZ
     265: 112'h31a78c7f80042060005043300200,
// UIA
     266: 112'he000c065000a1000005023300300,
     267: 112'hc8560405000a20000050033003c0,    // a= JNZ
     268: 112'h31a78c7f800a2060005003300200,
// JAMP
     269: 112'h385b0065000a1000005023300000,    // a= LCWJMP
// VJM
     270: 112'h385b24451a0a1000005033300000,    // a= LCWJMP
// JMEQ
     271: 112'h38560475000a1000005063300200,    // a= JNZ
// JMNE
     272: 112'h385a0475000a1000005063300200,    // a= JNNZ
// VLM
     273: 112'hc84f0c77800a1000005063300000,    // a= LCWISE
// PSVLM
     274: 112'h31140c22800aa000005003300016,    // a= VLMJMP.VLM
     275: 112'h784e0405000a20000052033005d0,    // a= JIQ
// VLMJMP.VLM
     276: 112'h385b24457a0a1000005033300000,    // a= LCWJMP
// ADU
     277: 112'hc8582c62800a100000506e300200,    // a= LCW
// PSADU
     278: 112'h11180e5f300f2000005003a005d6,    // a= NADR
     279: 112'h784d0c18700a200000518330609e,    // a= JQ
// NADR
     280: 112'ha008cddf700a2060005003300000,
// ABU
     281: 112'hc8582c62800a100000506e300200,    // a= LCW
// PSABU
     282: 112'h11180e5f300f2000005003a005d6,    // a= NADR
     283: 112'h784d0c98720a200000518330609e,    // a= JQ
// UBA
     284: 112'hc8582c62800a100000506e300200,    // a= LCW
// PSUBA
     285: 112'h11180e5f300f2000005003a005d6,    // a= NADR
     286: 112'h784d0d18720a200000518330609e,    // a= JQ
// UTA
     287: 112'hc8582c62800a100000506e300200,    // a= LCW
// PSUTA
     288: 112'h11180e5f300f2000005003a005d6,    // a= NADR
     289: 112'h784d0c48700a200000518330605e,    // a= JQ
// AAU
     290: 112'hc8582c62800a100000506e300200,    // a= LCW
// PSAAU
     291: 112'h11180e5f300f2000005003a005d6,    // a= NADR
     292: 112'h784d0e18700a200000518330605e,    // a= JQ
// AEU
     293: 112'hc8582c62800a100000506e300200,    // a= LCW
// PSAEU
     294: 112'h11180e5f300f2000005003a005d6,    // a= NADR
     295: 112'h784d0f18700a200000518330605e,    // a= JQ
// AOU
     296: 112'hc8582c62800a100000506e300200,    // a= LCW
// PSAOU
     297: 112'h11180e5f300f2000005003a005d6,    // a= NADR
     298: 112'h784d0d98700a200000518330605e,    // a= JQ
// ACU
     299: 112'he000ec62800a100000506e300000,
     300: 112'h11180e5f300f2000005003a00016,    // a= NADR
     301: 112'he000cc4f8001a0000050833005c0,
     302: 112'h403f0e7e800a2000005003300000,
     303: 112'hb131143f80522000005083300016,    // a= PSACU
     304: 112'h8000cc3e86122000005003300000,
// PSACU
     305: 112'hc8580c1ef00a2000005003300200,    // a= LCW
     306: 112'h784d0c48680a200000518330705e,    // a= JQ
// ANU
     307: 112'he000ec62800a100000506e300000,
     308: 112'h11180e5f300f2000005003a00016,    // a= NADR
     309: 112'he000e878020a205800500f300000,
     310: 112'he065ce5e800a2060005003300000,
     311: 112'he01ae55d6a0a2064805003300000,
     312: 112'h31310c78800a204820500b3005c0,    // a= PSACU
// UTY
     313: 112'hc8582c62800a100000506e300200,    // a= LCW
     314: 112'h11180e5f300f2000005003a005d6,    // a= NADR
     315: 112'h784d0c48f00a200000510330601e,    // a= JQ
// UTS
     316: 112'he000ec72800a3804005023300000,
     317: 112'he000cc67000a100014506c340000,
     318: 112'hc858283d000a200000500f300000,    // a= LCW
     319: 112'h11180e1f300f20000050033005d6,    // a= NADR
// WA.UTS
     320: 112'h314024452a0a200000520e30006a,    // a= WA.UTS
     321: 112'h784d0c48700a38000051ba30621e,    // a= JQ
// XTY
     322: 112'h107a2c62800a1004005023300000,    // a= RDOPER
     323: 112'h70004c78800a2000005103a0701e,
// XTYF
     324: 112'hc8580425000a2000005043300000,    // a= LCW
     325: 112'h31422d72800ab804005023300016,    // a= XTY
     326: 112'h107b0405000a2000125c0c3405c0,    // a= RDOPER1
     327: 112'h70006878a80a3800005133a0701e,
// YAX
     328: 112'h107a2c62800a1004005023300000,    // a= RDOPER
     329: 112'h70004e58080a2000005183a0705e,
// YAXF
     330: 112'hc8580425000a2000005043300000,    // a= LCW
     331: 112'h31482d72800ab80400502f300016,    // a= YAX
     332: 112'h107b0405000a2000125c0c3405c0,    // a= RDOPER1
     333: 112'h70004e58080a38000051bba0705e,
// YEX
     334: 112'h107a2c62800a1004005023300000,    // a= RDOPER
     335: 112'h70004f58080a2000005183a0705e,
// YEXF
     336: 112'hc8580425000a2000005043300000,    // a= LCW
     337: 112'h314e2d72800ab80400502f300016,    // a= YEX
     338: 112'h107b0405000a2000125c0c3405c0,    // a= RDOPER1
     339: 112'h70004f58080a38000051bba0705e,
// YOX
     340: 112'h107a2c62800a1004005023300000,    // a= RDOPER
     341: 112'h70004dd8080a2000005183a0705e,
// YOXF
     342: 112'hc8580425000a2000005043300000,    // a= LCW
     343: 112'h31542d72800ab80400502f300016,    // a= YOX
     344: 112'h107b0405000a2000125c0c3405c0,    // a= RDOPER1
     345: 112'h70004dd8080a38000051bba0705e,
// YTX
     346: 112'he000ec62800a1004005023300000,
     347: 112'hc8580405000a200014500c3405c0,    // a= LCW
// WA.YTX
     348: 112'h315c283d080a200000520f30002a,    // a= WA.YTX
     349: 112'h70004075000a204000510330721e,
// YTXF
     350: 112'he000ec62800a1004005023300000,
     351: 112'hc8580425000a200014504c3405c0,    // a= LCW
     352: 112'h315c283d080aa00000500f300016,    // a= WA.YTX
// WAF.YTX
     353: 112'h31610075000a204000520330002a,    // a= WAF.YTX
     354: 112'h700064452a0a380000513330721e,
// AAY
     355: 112'hc84f0405000a2000005003300040,    // a= LCWISE
     356: 112'h784e0e18080a20000052833005d0,    // a= JIQ
// AEY
     357: 112'hc84f0405000a2000005003300040,    // a= LCWISE
     358: 112'h784e0f18080a20000052833005d0,    // a= JIQ
// AOY
     359: 112'hc84f0405000a2000005003300040,    // a= LCWISE
     360: 112'h784e0d98080a20000052833005d0,    // a= JIQ
// MCJ
     361: 112'he000ec22800a1004005023f00000,
     362: 112'he000c405000a0000005023e00000,
     363: 112'hc84f0405000a100000503a300000,    // a= LCWISE
     364: 112'h784e0405000a000000523b3005d0,    // a= JIQ
// MSN
     365: 112'he000ec22800a1004805023f00000,
     366: 112'he000cc7f800a104820500b300001,
     367: 112'he000e87ff80a2048405003300000,
     368: 112'hc84f287ff80a3048205003300001,    // a= LCWISE
// PSMSN
     369: 112'h31052445780a1000005033300000,    // a= JRPCH
// JBM
     370: 112'he000ec22800a1004005023f00000,
     371: 112'hc8580c77800a00000050233005c0,    // a= LCW
     372: 112'h784d24d57a0a0000005133b0721e,    // a= JQ
// VTMH
     373: 112'he000ec22800a1048205003f00001,
     374: 112'hc84f0c7f800a1fc840500b300001,    // a= LCWISE
// PSVTMH
     375: 112'h3171287ff80a3048205003300001,    // a= PSMSN
// VTMQ
     376: 112'hc84f2c22800a1048205003f00001,    // a= LCWISE
     377: 112'h31770c7f800a1f4840500b300001,    // a= PSVTMH
// VTMB
     378: 112'hc84f2c22800a1048205003f00001,    // a= LCWISE
     379: 112'h31770c7f800a1ec840500b300001,    // a= PSVTMH
// VTMF
     380: 112'hc84f2c22800a1048205003f00001,    // a= LCWISE
     381: 112'h31770c7f800a1d4840500b300001,    // a= PSVTMH
// UTCS
     382: 112'he000cc62800a1000005023300200,
     383: 112'hc858287fa80a18482050033005c1,    // a= LCW
     384: 112'h784d2835780a378000513330015e,    // a= JQ
// MPAC
     385: 112'he000ec62800a1004005023300000,
     386: 112'he000cc76000a0000005023300000,
     387: 112'he000ec47aa0a2004005003300000,
     388: 112'he000c25d300a0000005023300000,
     389: 112'he000e9e8600a1048205083300041,
     390: 112'he000ec37820a2004005003300000,
     391: 112'he000cc76000a0000005023300000,
     392: 112'he000e437820a2004005003300000,
     393: 112'hc858025d300a00000050233005c0,    // a= LCW
     394: 112'h784d29e8e00a104820510330721f,    // a= JQ
// MUNP
     395: 112'he000ec67820a1004005023300000,
     396: 112'he0e2e475000a2064805003300000,
     397: 112'he000e87e000a0048205033300000,
     398: 112'he000ecc2f80a2004005003300000,
     399: 112'he000e445600a0000005033300000,
     400: 112'he05fe455280a2064005003300000,
     401: 112'he000e44d080a0048205033f00000,
     402: 112'hc85824457a0a20040050033005c0,    // a= LCW
     403: 112'h70004075000a004000513b30721e,
// ADI
     404: 112'hc8582c62800a1004005023300000,    // a= LCW
     405: 112'h31160475000a0000005063e00200,    // a= PSADU
// ABI
     406: 112'hc8582c62800a1004005023300000,    // a= LCW
     407: 112'h311a0475000a0000005063e00200,    // a= PSABU
// IBA
     408: 112'hc8582c62800a1004005023300000,    // a= LCW
     409: 112'h311d0475000a0000005063e00200,    // a= PSUBA
// AAI
     410: 112'hc8582c62800a1004005023300000,    // a= LCW
     411: 112'h31230475000a0000005063e00200,    // a= PSAAU
// AEI
     412: 112'hc8582c62800a1004005023300000,    // a= LCW
     413: 112'h31260475000a0000005063e00200,    // a= PSAEU
// AOI
     414: 112'hc8582c62800a1004005023300000,    // a= LCW
     415: 112'h31290475000a0000005063e00200,    // a= PSAOU
// JMGE
     416: 112'hc8580475000a1000005063300000,    // a= LCW
     417: 112'h385b0c22800fa0000050033005d6,    // a= LCWJMP
     418: 112'h70004075000a204000510330721e,
// JMLT
     419: 112'hc8580475000a1000005063300000,    // a= LCW
     420: 112'h385b0c22800f20000050033005d6,    // a= LCWJMP
     421: 112'h70004075000a204000510330721e,
// JMLE
     422: 112'hc8580575020a1000005063300000,    // a= LCW
     423: 112'h385b0c22800020000050033005d6,    // a= LCWJMP
     424: 112'h70004075000a204000510330721e,
// JMGT
     425: 112'hc8580575020a1000005063300000,    // a= LCW
     426: 112'h385b0c228000a0000050033005d6,    // a= LCWJMP
     427: 112'h70004075000a204000510330721e,
// VRM
     428: 112'hc84f0c77800a1000005063300000,    // a= LCWISE
     429: 112'h31af0c22800aa000005003300016,    // a= VRMJMP.VRM
     430: 112'h784e0405000a20000052033005d0,    // a= JIQ
// VRMJMP.VRM
     431: 112'h385b24c5780a1000005033300000,    // a= LCWJMP
// UZAS
     432: 112'he000ed72800a3804005023300300,
     433: 112'hc8580405000a200012500c340380,    // a= LCW
     434: 112'h10008065000190000050a3300000,
// WAUZAS
     435: 112'h31b304050001200000524330006a,    // a= WAUZAS
     436: 112'h385b2878280a38000050b3a005d6,    // a= LCWJMP
     437: 112'h70004075000a204000510330721e,
// UIAS
     438: 112'he000ed72800a3804005023300300,
     439: 112'hc8580405000a200012500c340380,    // a= LCW
     440: 112'h10008065000190000050a3300000,
     441: 112'h31b304050002a000005083300000,    // a= WAUZAS
// JOVR
     442: 112'h385b006500131000005023300016,    // a= LCWJMP
     443: 112'hc8580c22800a20000050033005c0,    // a= LCW
     444: 112'h70004075000a204000510330721e,
// JCRY
     445: 112'h385b006500151000005023300016,    // a= LCWJMP
     446: 112'hc8580c22800a20000050033005c0,    // a= LCW
     447: 112'h70004075000a204000510330721e,
// JAGT
     448: 112'hc85804cd020a1000005063f00000,    // a= LCW
     449: 112'h385b00650000a000005003b005d6,    // a= LCWJMP
     450: 112'h784d0c22800a200000510330621e,    // a= JQ
// JAGE
     451: 112'hc858044d000a1000005063f00000,    // a= LCW
     452: 112'h385b0065000fa000005003b005d6,    // a= LCWJMP
     453: 112'h784d0c22800a200000510330621e,    // a= JQ
// JALT
     454: 112'hc858044d000a1000005063f00000,    // a= LCW
     455: 112'h385b0065000f2000005003b005d6,    // a= LCWJMP
     456: 112'h784d0c22800a200000510330621e,    // a= JQ
// JALE
     457: 112'hc85804cd020a1000005063f00000,    // a= LCW
     458: 112'h385b006500002000005003b005d6,    // a= LCWJMP
     459: 112'h784d0c22800a200000510330621e,    // a= JQ
// JAEQ
     460: 112'hc858044d000a1000005063f00000,    // a= LCW
     461: 112'h385b0065000a2000005003b005d6,    // a= LCWJMP
     462: 112'h784d0c22800a200000510330621e,    // a= JQ
// JANE
     463: 112'hc858044d000a1000005063f00000,    // a= LCW
     464: 112'h385b0065000aa000005003b005d6,    // a= LCWJMP
     465: 112'h784d0c22800a200000510330621e,    // a= JQ
// JMPS
     466: 112'h31d82c72800a3604005023300010,    // a= RCJMPS.JMPS
     467: 112'he04fcddf980a206014500c340000,
     468: 112'he000e83d780a200000500f300000,
// PSJ.JMPS
     469: 112'he000c065000a1000005023300000,
// WAF.JMPS
     470: 112'h31d60405000a200000520330002a,    // a= WAF.JMPS
     471: 112'h385c24452a0a3600005033300480,    // a= LCWJ1
// RCJMPS.JMPS
     472: 112'he000cc479a0a200014500c340000,
     473: 112'h31d5261fb00a200000500f300000,    // a= PSJ.JMPS
// RETS
     474: 112'h107a2d72800a360400502f300380,    // a= RDOPER
     475: 112'he000c07d000a360000507ba00240,
     476: 112'h31de0c42180f2000005003306496,    // a= RCRETS.RETS
     477: 112'h38522c21800a2004005003300180,    // a= LCWPH
// RCRETS.RETS
     478: 112'he000c405000a20000050033004c0,
     479: 112'h38522c21800a20040050033001c0,    // a= LCWPH
     480: 112'h385c0075000a360000503ba00480,    // a= LCWJ1
// ASNA
     481: 112'he000ec62800a1004805023300200,
     482: 112'hc8582878000a20484050833005c0,    // a= LCW
     483: 112'h70004075000a204000510330709e,
// ADL
     484: 112'h107a2c62800a1004005023300000,    // a= RDOPER
     485: 112'h70004c58000a2000005183a0709e,
// ADLF
     486: 112'hc8580425000a2000005043300000,    // a= LCW
     487: 112'h31e42d72800ab80400502f300016,    // a= ADL
     488: 112'h107b0405000a2000125c0c3405c0,    // a= RDOPER1
     489: 112'h70004c58000a38000051bba0709e,
// ABL
     490: 112'h107a2c62800a1004005023300000,    // a= RDOPER
     491: 112'h70004cd8020a2000005183a0709e,
// ABLF
     492: 112'hc8580425000a2000005043300000,    // a= LCW
     493: 112'h31ea2d72800ab80400502f300016,    // a= ABL
     494: 112'h107b0405000a2000125c0c3405c0,    // a= RDOPER1
     495: 112'h70004cd8020a38000051bba0709e,
// LBA
     496: 112'h107a2c62800a1004005023300000,    // a= RDOPER
     497: 112'h70004d58020a2000005183a0709e,
// LBAF
     498: 112'hc8580425000a2000005043300000,    // a= LCW
     499: 112'h31f02d72800ab80400502f300016,    // a= LBA
     500: 112'h107b0405000a2000125c0c3405c0,    // a= RDOPER1
     501: 112'h70004d58020a38000051bba0709e,
// ATH
     502: 112'h31f70c67000a1000005063300380,    // a= ATHSTH
// ATHSTH
     503: 112'h11180e1f300f2000005003300016,    // a= NADR
     504: 112'he000e87af00a20c8405003300001,
     505: 112'he007e87d280a2064005003300000,
     506: 112'he000cfc7f00a200012500c340000,
     507: 112'h31fc287ff80a1dc8205003300001,    // a= ATMEM
// ATMEM
     508: 112'he0a3ce5ff80a2060005003300000,
     509: 112'he01ae5557a0a2064805003300000,
     510: 112'he000ebfdd00a2048205003300000,
     511: 112'hc8580e1d000a2000005003300000,    // a= LCW
// WA.ATH
     512: 112'h3200287e500a204820520330002a,    // a= WA.ATH
     513: 112'h32040e5dd80a200014500ca405d8,    // a= STMEM.ATH
// WAW.ATH
     514: 112'h3202259e580a200000520f30002a,    // a= WAW.ATH
     515: 112'h70004075000a204000510330721e,
// STMEM.ATH
     516: 112'h3204259e580a200000520f3003aa,    // a= STMEM.ATH
     517: 112'h107a2d72800a38040050233005c0,    // a= RDOPER
     518: 112'h70006878280a38000051b3a0705e,
// STH
     519: 112'h31f70c67000a10000050633003c0,    // a= ATHSTH
// HTA
     520: 112'h120a0c67000a1000005063300000,    // a= RDH
     521: 112'h70004c48700a200000518330709e,
// RDH
     522: 112'h11180e1f300f2000005003300016,    // a= NADR
     523: 112'he000e87af00a20c8405003300001,
     524: 112'he000ebb7280a2004005003300000,
     525: 112'he067ce5ff00a206012500c340000,
     526: 112'h4858287ff80a1dc8205003300001,    // a= LCW
     527: 112'hd01ae45d780a206480500330002a,
     528: 112'he000cc77000a204820504a3005c0,
     529: 112'h11180e1f300f2000005003300216,    // a= NADR
     530: 112'ha000c075000a2040005003300000,
// HTS
     531: 112'he000ec72800a3804005023300000,
     532: 112'he000cc45aa0a200014500c340000,
// WA.HTS
     533: 112'h3215283d000a200000520f30002a,    // a= WA.HTS
     534: 112'h120a2867580a100000506f300000,    // a= RDH
     535: 112'h70004c48700a38000051bb30709e,
// ADH
     536: 112'h120a0c67000a1000005063300000,    // a= RDH
     537: 112'h70004c18700a200000518330709e,
// ABH
     538: 112'h120a0c67000a1000005063300000,    // a= RDH
     539: 112'h70004c98720a200000518330709e,
// HBAC
     540: 112'h120a0c67000a1000005063300000,    // a= RDH
     541: 112'h70004d18720a200000518330709e,
// AAH
     542: 112'h120a0c67000a1000005063300000,    // a= RDH
     543: 112'h70004e18700a200000518330705e,
// AEH
     544: 112'h120a0c67000a1000005063300000,    // a= RDH
     545: 112'h70004f18700a200000518330705e,
// AOH
     546: 112'h120a0c67000a1000005063300000,    // a= RDH
     547: 112'h70004d98700a200000518330705e,
// ATQ
     548: 112'h32250c67000a1000005063300380,    // a= ATQSTQ
// ATQSTQ
     549: 112'h11180e1f300f2000005003300016,    // a= NADR
     550: 112'he000e87af00a2148405003300001,
     551: 112'he009e87d280a2064005003300000,
     552: 112'he000cfc7f00a200012500c340000,
     553: 112'h31fc287ff80a1e48205003300001,    // a= ATMEM
// STQ
     554: 112'h32250c67000a10000050633003c0,    // a= ATQSTQ
// QTA
     555: 112'h122d0c67000a1000005063300000,    // a= RDQ
     556: 112'h784d0c48700a200000518330605e,    // a= JQ
// RDQ
     557: 112'h11180e1f300f2000005003300016,    // a= NADR
     558: 112'hc858287af00a2148405003300001,    // a= LCW
     559: 112'he009e87d280a2064005003300000,
     560: 112'he000cfc7f00a200012500c340000,
     561: 112'h3262287ff80a1e48205003300001,    // a= RDFRAG
// QTS
     562: 112'he000ec72800a3804005023300000,
     563: 112'he000cc45aa0a200014500c340000,
// WA.QTS
     564: 112'h3234283d000a200000520f30002a,    // a= WA.QTS
     565: 112'h122d2867580a100000506f300000,    // a= RDQ
     566: 112'h784d0c48700a38000051bb30605e,    // a= JQ
// AEQ
     567: 112'h122d0c67000a1000005063300000,    // a= RDQ
     568: 112'h784d0f18700a200000518330605e,    // a= JQ
// AAQ
     569: 112'h122d0c67000a1000005063300000,    // a= RDQ
     570: 112'h784d0e18700a200000518330605e,    // a= JQ
// AOQ
     571: 112'h122d0c67000a1000005063300000,    // a= RDQ
     572: 112'h784d0d98700a200000518330605e,    // a= JQ
// ATB
     573: 112'h323e0c67000a1000005063300380,    // a= ATBSTB
// ATBSTB
     574: 112'h11180e1f300f2000005003300016,    // a= NADR
     575: 112'he000e87af00a21c8405003300001,
     576: 112'he00be87d280a2064005003300000,
     577: 112'he000cfc7f00a200012500c340000,
     578: 112'h31fc287ff80a1ec8205003300001,    // a= ATMEM
// STB
     579: 112'h323e0c67000a10000050633003c0,    // a= ATBSTB
// BTA
     580: 112'h12460c67000a1000005063300000,    // a= RDB
     581: 112'h784d0c48700a200000518330605e,    // a= JQ
// RDB
     582: 112'h11180e1f300f2000005003300016,    // a= NADR
     583: 112'hc858287af00a21c8405003300001,    // a= LCW
     584: 112'he00be87d280a2064005003300000,
     585: 112'he000cfc7f00a200012500c340000,
     586: 112'h3262287ff80a1ec8205003300001,    // a= RDFRAG
// BTS
     587: 112'he000ec72800a3804005023300000,
     588: 112'he000cc45aa0a200014500c340000,
// WA.BTS
     589: 112'h324d283d000a200000520f30002a,    // a= WA.BTS
     590: 112'h12462867580a100000506f300000,    // a= RDB
     591: 112'h784d0c48700a38000051bb30605e,    // a= JQ
// AEB
     592: 112'h12460c67000a1000005063300000,    // a= RDB
     593: 112'h784d0f18700a200000518330605e,    // a= JQ
// AAB
     594: 112'h12460c67000a1000005063300000,    // a= RDB
     595: 112'h784d0e18700a200000518330605e,    // a= JQ
// AOB
     596: 112'h12460c67000a1000005063300000,    // a= RDB
     597: 112'h784d0d98700a200000518330605e,    // a= JQ
// ATF
     598: 112'h32570c67000a1000005063300380,    // a= ATFSTF
// ATFSTF
     599: 112'h11180e1f300f2000005003300016,    // a= NADR
     600: 112'he000e87af00a2348405003300001,
     601: 112'he067e87d280a2064005003300000,
     602: 112'h31fc0fc7f00a200012500c340000,    // a= ATMEM
// STF
     603: 112'h32570c67000a10000050633003c0,    // a= ATFSTF
// FTA
     604: 112'h125e0c67000a1000005063300380,    // a= RDF
     605: 112'h784d0c48700a200000518330605e,    // a= JQ
// RDF
     606: 112'h11180e1f300f2000005003300016,    // a= NADR
     607: 112'h3274287af00a2348405003300019,    // a= SETCLR
     608: 112'he067e87d280a2064005003300000,
     609: 112'hc8580fc7f00a200012500c340000,    // a= LCW
// RDFRAG
     610: 112'h40a3ce57f80a2060005203300000,
     611: 112'hd01ae455780a206480500330022a,
     612: 112'ha000ce5f500a204820500a3005c0,
// FTS
     613: 112'he000ec72800a3804005023300000,
     614: 112'he000cc45aa0a200014500c340000,
// WA.FTS
     615: 112'h3267283d000a200000520f30002a,    // a= WA.FTS
     616: 112'h125e2867580a100000506f300380,    // a= RDF
     617: 112'h784d0c48700a38000051bb30605e,    // a= JQ
// AEF
     618: 112'h125e0c67000a1000005063300380,    // a= RDF
     619: 112'h784d0f18700a200000518330605e,    // a= JQ
// AAF
     620: 112'h125e0c67000a1000005063300380,    // a= RDF
     621: 112'h784d0e18700a200000518330605e,    // a= JQ
// AOF
     622: 112'h125e0c67000a1000005063300380,    // a= RDF
     623: 112'h784d0d98700a200000518330605e,    // a= JQ
// SETF
     624: 112'h125e0c67000a10000050633003c0,    // a= RDF
     625: 112'hc85825dd700a200000500fa005c0,    // a= LCW
// PSSETF
     626: 112'h107b0405000a2000145c0c340000,    // a= RDOPER1
     627: 112'h70004405000a200000510330701e,
// SETCLR
     628: 112'he04fe87d280a2064005003300380,
     629: 112'he0a3ce5ff00a206012500c340000,
     630: 112'h401ae45d780a2064805c03300000,
     631: 112'ha000e87f500a204820580330002a,
     632: 112'ha000c405000a200000580330002a,
     633: 112'ha000c405000a200000580330002a,
     634: 112'ha000c405000a200000580330002a,
// CLRF
     635: 112'h125e0c67000a10000050633003c0,    // a= RDF
     636: 112'hc8580fcf700a2000005003300000,    // a= LCW
     637: 112'h3272265d700a200000500fa005c0,    // a= PSSETF
// EXTF
     638: 112'he000cc62800a1000005023300000,
     639: 112'he0a3ce5f280a2060005003300000,
     640: 112'he01ae555720a2064805003300000,
     641: 112'hc858287f800a2048205003300200,    // a= LCW
     642: 112'he01ae455700a20648050033005c0,
     643: 112'h784d2878780a204840518330705e,    // a= JQ
// NTA
     644: 112'h12860c62800a1000005023300000,    // a= RDN
     645: 112'h70004c48700a200000518330705e,
// RDN
     646: 112'he0a3ce5fa80a2060005003300000,
     647: 112'hc28a2875280a15c82050433005c1,    // a= BIT0.NTA
     648: 112'h528c0075000f2040005003300016,    // a= BIT1.NTA
     649: 112'ha000e87f700a2048205003300000,
// BIT0.NTA
     650: 112'hc858167f002a2000005003300000,    // a= LCW
     651: 112'ha01ae455780a2064805003300000,
// BIT1.NTA
     652: 112'hc8581e7f002a2000005003300000,    // a= LCW
     653: 112'ha01ae5557a0a2064805003300000,
// NTSC
     654: 112'he000ec72800a3804005023300000,
     655: 112'he000cc45aa0a200014500c340000,
// WA.NTSC
     656: 112'h3290283d000a200000520f30002a,    // a= WA.NTSC
     657: 112'h12862862d80a100000502f300000,    // a= RDN
     658: 112'h70004c48700a38000051bb30705e,
// AEN
     659: 112'h12860c62800a1000005023300000,    // a= RDN
     660: 112'h70004f18700a200000518330705e,
// AAN
     661: 112'h12860c62800a1000005023300000,    // a= RDN
     662: 112'h70004e18700a200000518330705e,
// AON
     663: 112'h12860c62800a1000005023300000,    // a= RDN
     664: 112'h70004d98700a200000518330705e,
// ATD
     665: 112'he000ec62800a1004005023300000,
     666: 112'he000c405000a200014500c340000,
// WAA.ATD
     667: 112'h329b283d000a200000520f30002a,    // a= WAA.ATD
     668: 112'he000ec32820a20040050033005c0,
     669: 112'hc8580075000a204014500c340000,    // a= LCW
// WAY.ATD
     670: 112'h329e283d080a200000520f30002a,    // a= WAY.ATD
     671: 112'h70004405000a200000510330721e,
// ATDF
     672: 112'he000ec62800a1004005023300000,
     673: 112'he000c425000a200014504c340000,
     674: 112'h329b283d000aa00000500f300016,    // a= WAA.ATD
     675: 112'he000ec32820a20040050033005c0,
// WAAF.ATD
     676: 112'h32a40405000a200000520330002a,    // a= WAAF.ATD
     677: 112'hc8580075000a204014500c340000,    // a= LCW
// WAYF.ATD
     678: 112'h32a6283d080a200000520f30002a,    // a= WAYF.ATD
     679: 112'h700064452a0a380000513330721e,
// DTA
     680: 112'h107a2c62800a1004005023300000,    // a= RDOPER
     681: 112'hd000ec32820a2004005003300000,
     682: 112'h107b0c78000a2000125c8ca40000,    // a= RDOPER1
     683: 112'h70004c78800a2000005103a0705e,
// DTAF
     684: 112'hc07a0425000a2000005043300000,    // a= RDOPER
     685: 112'h52a82d72800ab804005023300016,    // a= DTA
     686: 112'he000ecb2800a2004005003300000,
     687: 112'h107b0c78800a2000125c0ca40000,    // a= RDOPER1
     688: 112'h70006878280a38000051b3a0705e,
// ATXFE
     689: 112'hc8582c62800a1004005023300000,    // a= LCW
     690: 112'he0d1c665000a206014504c3405c0,
     691: 112'h3071283d000a200000500f300000,    // a= PSATXF
// RMOD
     692: 112'h30062c67800a100400522330038c,    // a= EXTDR
     693: 112'hc8580c42f80a2000005003300300,    // a= LCW
     694: 112'he000c405000a20000050033005c0,
     695: 112'h2000c075000a2040005003300200,
// XTAFE
     696: 112'hc8580c25000a2000005003300000,    // a= LCW
     697: 112'h308b287d500a07c8205043300001,    // a= PSXTAF
// STI
     698: 112'he000cc65800a1000005023300000,
     699: 112'he073cf56580a2060005003300000,
     700: 112'h32c4287e600a024820504330000f,    // a= STIE
     701: 112'h32c22d72800a38040050233005d6,    // a= IA15.STI
     702: 112'he000c075000a204012500c340000,
// WALF.STI
     703: 112'h32bf2445580a200400520330002a,    // a= WALF.STI
     704: 112'hc8582445000a0000005033300200,    // a= LCW
     705: 112'h70006878280a38000051b3a0705e,
// IA15.STI
     706: 112'h107a2c42800a20040050033005c0,    // a= RDOPER
     707: 112'h70006878280a38000051b3a0705e,
// STIE
     708: 112'he000e87f800a2648205003300001,
     709: 112'h32ca2d72800a38040050233005d6,    // a= IA15E.STIE
     710: 112'he000c075000a204012500c340000,
// WF.STIE
     711: 112'h32c72445580a200400520330002a,    // a= WF.STIE
     712: 112'hc8582445780a0000005033300200,    // a= LCW
     713: 112'h70006878280a38000051b3a0705e,
// IA15E.STIE
     714: 112'he000ec42f80a2004005003300000,
     715: 112'he000c075000a204012500c340000,
// WAF.STIE
     716: 112'h32cc0405000a200000520330002a,    // a= WAF.STIE
     717: 112'hc8582445780a3800005033300200,    // a= LCW
     718: 112'h70004878280a2000005183a0705e,
// ITS
     719: 112'he000ec72800a3804005023300000,
     720: 112'hc8580405000a200014500c340000,    // a= LCW
     721: 112'h42d4283d000a200000500f30000e,    // a= ITSE
     722: 112'hd000e465000a100400502330002a,
     723: 112'h70f624452a0a380000523330000e,    // a= PSITA
// ITSE
     724: 112'he0d1cc7f800a2060005003300000,
     725: 112'he000ce5ff80a0000005023300200,
     726: 112'hc8582878780a1a482050033005c1,    // a= LCW
     727: 112'he0cccdd8000a2060005083300040,
     728: 112'h70004075000a204000510330701e,
// UTC
     729: 112'he000cc62800a1000005023300200,
     730: 112'hc8582445280a37800050333005c0,    // a= LCW
     731: 112'h784d0405000a200000510330015e,    // a= JQ
// XTR
     732: 112'h12de2c62800a1004005023300000,    // a= SXTR.XTR
     733: 112'h784e2597780a370180503330001e,    // a= JIQ
// SXTR.XTR
     734: 112'hc84f0c77800a370012502c3405c0,    // a= LCWISE
     735: 112'he0d7ce57f80a2060005003300000,
     736: 112'he064cc76800a2060005003300000,
// WA.XTR
     737: 112'h32e10075000a204000520330002a,    // a= WA.XTR
     738: 112'ha000ce57680a3ac820500a300001,
// XTRF
     739: 112'he000c425000a2000005043300000,
     740: 112'h32dc0405000aa000005003300016,    // a= XTR
     741: 112'h12de2d72800a3804005023300000,    // a= SXTR.XTR
     742: 112'hc8582597780a3701805033300000,    // a= LCW
     743: 112'h70006445280a380000d13330001e,
// NTR
     744: 112'hc84f0c77800a3700005023300000,    // a= LCWISE
     745: 112'he0d7ce57f80a2060005003300000,
     746: 112'he000cc62800a1000005023300000,
     747: 112'he064c255280a20600050033005c0,
     748: 112'h784e2585780a370180503330001e,    // a= JIQ
// RTE
     749: 112'he000cc62800a1000005023300000,
     750: 112'he064c255280a2060005003300000,
     751: 112'he000cc77800a2018005003300000,
     752: 112'he080ce57f80a2060005003300000,
     753: 112'he000cc77000a3700005023300000,
     754: 112'he087ce57700a2060005003300000,
     755: 112'hc8580d97780a2000005003300200,    // a= LCW
     756: 112'h12f60e07700a20000050033005ce,    // a= PSEM.RTE
     757: 112'h784d2878700a05c820518330701f,    // a= JQ
// PSEM.RTE
     758: 112'ha0d4cddf700a2060005003300000,
// AAXE
     759: 112'h18392c62800a1004005023300380,    // a= LOGER
     760: 112'he000ce1f780a2000005003300000,
// PSAAXE
     761: 112'h70006878700a224860518330701f,
// AAXFE
     762: 112'he0d1c665000a2060005043300000,
     763: 112'h32f70405000aa000005003300016,    // a= AAXE
     764: 112'h18392d72800a380400502f300380,    // a= LOGER
     765: 112'h32f90e1f780a380000503b300000,    // a= PSAAXE
// AEXE
     766: 112'he000ec62800a1004005023300000,
     767: 112'h18390c48800a2000005003300380,    // a= LOGER
     768: 112'h32f90f1f780a2000005003300000,    // a= PSAAXE
// AEXFE
     769: 112'he0d1c665000a2060005043300000,
     770: 112'h32fe0405000aa000005003300016,    // a= AEXE
     771: 112'he000ed72800a380400502f300000,
     772: 112'h18390c48800a2000005003300380,    // a= LOGER
     773: 112'h32f90f1f780a380000503b300000,    // a= PSAAXE
// ARXE
     774: 112'h18392c62800a1004005023300380,    // a= LOGER
     775: 112'he000cc1f780a2000005043300080,
// PSARXE
     776: 112'he001cc78060a2060005003300000,
     777: 112'he000e878000a1848205003300001,
     778: 112'h32f90c1f000a2000005003300000,    // a= PSAAXE
// ARXFE
     779: 112'he0d1c665000a2060005043300000,
     780: 112'h33060405000aa000005003300016,    // a= ARXE
     781: 112'h18392d72800a380400502f300380,    // a= LOGER
     782: 112'h33080c1f780a380000507b300080,    // a= PSARXE
// AOXE
     783: 112'h18392c62800a1004005023300380,    // a= LOGER
     784: 112'h32f90d9f780a2000005003300000,    // a= PSAAXE
// AOXFE
     785: 112'he0d1c665000a2060005043300000,
     786: 112'h330f0405000aa000005003300016,    // a= AOXE
     787: 112'h18392d72800a380400502f300380,    // a= LOGER
     788: 112'h32f90d9f780a380000503b300000,    // a= PSAAXE
// APXE
     789: 112'h18392c62800a1004005023300380,    // a= LOGER
     790: 112'he000ce7e800a2000005003300000,
// APXCC.APXE
     791: 112'he000e87ff80a2848205003300001,
     792: 112'he000c04d7801a000005083300000,
     793: 112'he000e87f700a2848205003300001,
// APXCE.APXE
     794: 112'h331e143f00522000005083300016,    // a= PSAPXE
     795: 112'h331d040500152000005003300016,    // a= ISC1E.APXE
     796: 112'h331a102d000a2000005003300000,    // a= APXCE.APXE
// ISC1E.APXE
     797: 112'h331a103e81aa2000005003300000,    // a= APXCE.APXE
// PSAPXE
     798: 112'h784d2878680a224860518330701f,    // a= JQ
// APXFE
     799: 112'he0d1c665000a2060005043300000,
     800: 112'h33150405000aa000005003300016,    // a= APXE
     801: 112'h18392d72800a380400502f300380,    // a= LOGER
     802: 112'h33170e7e800a380000503b300000,    // a= APXCC.APXE
// AUXE
     803: 112'h18392c62800a1004005023300380,    // a= LOGER
     804: 112'he000c27d000a2000005003300000,
// AUXCE.AUXE
     805: 112'h402f0405000a2000005003300000,
     806: 112'he000dc3f000a2000005083300000,
     807: 112'h3329040500152000005003300016,    // a= ISC1E.AUXE
     808: 112'hf32a182d004a2000005203300000,    // a= OUTE.AUXE
// ISC1E.AUXE
     809: 112'h8000d83f81ea2000005003300000,
// OUTE.AUXE
     810: 112'hc8580c2e800a2000005003300000,    // a= LCW
     811: 112'h331e287ee80a1848205003300001,    // a= PSAPXE
// AUXFE
     812: 112'he0d1c665000a2060005043300000,
     813: 112'h33230405000aa000005003300016,    // a= AUXE
     814: 112'h18392d72800a380400502f300380,    // a= LOGER
     815: 112'h3325027d000a380000503b300000,    // a= AUXCE.AUXE
// ACXE
     816: 112'h18392c62800a1004005023300380,    // a= LOGER
// ACXNE.ACXE
     817: 112'h402f0e7e8001a000005083300000,
     818: 112'hb3341c3f80122000005083300016,    // a= PSACXE
     819: 112'h8000cc3e86122000005003300000,
// PSACXE
     820: 112'hc858287fe80a1848205003300001,    // a= LCW
     821: 112'h33080c1f780a2000005043300000,    // a= PSARXE
// ACXFE
     822: 112'he0d1c665000a2060005043300000,
     823: 112'h33300405000aa000005003300016,    // a= ACXE
     824: 112'h18392d72800a380400502f300380,    // a= LOGER
     825: 112'h33310405000a380000503b300000,    // a= ACXNE.ACXE
// ANXE
     826: 112'h18392c62800a1004005023300380,    // a= LOGER
// ANXNE.ANXE
     827: 112'he000e87efa0a2058005003300000,
     828: 112'he065ce5ee80a2060005003300000,
     829: 112'he01ae55d6a0a2064805003300000,
     830: 112'he000e878f80a2048205003300000,
     831: 112'h33342878880a2248605003300001,    // a= PSACXE
// ANXFE
     832: 112'he0d1c665000a2060005043300000,
     833: 112'h333a0405000aa000005003300016,    // a= ANXE
     834: 112'h18392d72800a380400502f300380,    // a= LOGER
     835: 112'h333b0405000a380000503b300000,    // a= ANXNE.ANXE
// ASXE
     836: 112'h18392c62800a1004005023300380,    // a= LOGER
// ASXSE
     837: 112'he000cc7f000a3ac840504a300001,
     838: 112'he094e87ef00a2064805003300000,
     839: 112'h334e2878780f2048205083300016,    // a= RSHE.ASXE
     840: 112'he000e41ef00a2004805003300000,
// PSSHE.ASXE
     841: 112'hc8582878f80a2048205003300000,    // a= LCW
     842: 112'he00ace58000a2060005003300000,
     843: 112'he00ace58880a2060005003300000,
     844: 112'he000e878000a2248605003300001,
     845: 112'h70006878880a224860510330701f,
// RSHE.ASXE
     846: 112'h3349251ef20a2004805003300000,    // a= PSSHE.ASXE
// ASXFE
     847: 112'he0d1c665000a2060005043300000,
     848: 112'h33440405000aa000005003300016,    // a= ASXE
     849: 112'h18392d72800a380400502f300380,    // a= LOGER
     850: 112'h33452445280a3800005033300000,    // a= ASXSE
// ASNE
     851: 112'he0decedf800a2060005043300000,
     852: 112'he000cc62800a10000050233003c0,
     853: 112'h183a244d280a03c8205003f005c1,    // a= LOGER1
     854: 112'h33450405000a224860500be00381,    // a= ASXSE
// ATIE
     855: 112'he000ec62800a1004005023300000,
     856: 112'hc858244d000a2648205003f005c1,    // a= LCW
     857: 112'h70004075000a004000513b30721e,
// ITAE
     858: 112'he000ec62800a1004005023300000,
     859: 112'hc8580c77800a0000005023300200,    // a= LCW
     860: 112'he0d1ce5ff80a2060005003300000,
     861: 112'he0ccc07d000a20600050033005c0,
     862: 112'h784d29e8780a1a4820518330705f,    // a= JQ
// WTCE
     863: 112'h107a2c62800a1004005023300000,    // a= RDOPER
// PSWTCE.WTCE
     864: 112'hc8580c7f800a264820500a300141,    // a= LCW
     865: 112'h70006445780a378000d13330001e,
// WTCFE
     866: 112'he0d1c665000a2060005043300000,
     867: 112'h335f2d72800ab804005023300016,    // a= WTCE
     868: 112'h107b0405000a2000125c0c3405c0,    // a= RDOPER1
     869: 112'h33602445280a3800005033300000,    // a= PSWTCE.WTCE
// JMEQE
     870: 112'he0d1cc7f800a2060005003300000,
     871: 112'h38560655780a1000005063300200,    // a= JNZ
// JMNEE
     872: 112'he0d1cc7f800a2060005003300000,
     873: 112'h385a0655780a1000005063300200,    // a= JNNZ
// VLME
     874: 112'hc84f0c77800a1000005023300000,    // a= LCWISE
     875: 112'h3112287d780a07c8205043300001,    // a= PSVLM
// WMOD
     876: 112'h30062c67800a100400522330038c,    // a= EXTDR
     877: 112'hc8580c42f80a2000005003300340,    // a= LCW
     878: 112'he000c405000a20000050033005c0,
     879: 112'h2000c075000a2040005003300200,
// SETR
     880: 112'h13720c62800a1000005023300000,    // a= CHRR
     881: 112'h784e2597780a370180503330001e,    // a= JIQ
// CHRR
     882: 112'hb006287fa80a1b4820520330000d,    // a= EXTDR
     883: 112'he000cc77000a3700005023300000,
     884: 112'he0d5ce57700a2060005003300000,
     885: 112'hc84f0c76800a2018005003300000,    // a= LCWISE
     886: 112'he0d3ce56e80a2060005003300000,
     887: 112'ha000cd97680a20000050033005c0,
// CLRR
     888: 112'h13720c62800a1000005023300000,    // a= CHRR
// PSCLRR
     889: 112'he05acdd7f80a2060005003300000,
     890: 112'h784e2617780a370180503330001e,    // a= JIQ
// SEMR
     891: 112'h30062c628001100400526330000c,    // a= EXTDR
     892: 112'h484e0e5f3805201016504c340200,    // a= JIQ
     893: 112'hd047cc7f8001206000508330002a,
     894: 112'h484f065d780a2000005043a005d0,    // a= LCWISE
     895: 112'hb385287f700a2448005003300017,    // a= ZAX.SEMR
     896: 112'hd000cf5ef00a2000005003a00000,
     897: 112'he000e87ee80a3c48205043300001,
     898: 112'h73830405000a2000005003300016,    // a= MIP.SEMR
// MIP.SEMR
     899: 112'he000cc758010200000500330a000,
     900: 112'h7017e5d55800206000528330b000,
// ZAX.SEMR
     901: 112'h485804050001200014504c340000,    // a= LCW
     902: 112'hd000e59f7805a00000504f30002a,
     903: 112'h700040750001204000518330701e,
// SEMW
     904: 112'h30062c62800a100400522330000c,    // a= EXTDR
     905: 112'h484e0e5f380a201012500c340200,    // a= JIQ
     906: 112'hd000e87ef00a244800500330002b,
     907: 112'h484f0f5ee80a2000005003a005d0,    // a= LCWISE
     908: 112'hd000e87ee80a3c48205043300001,
     909: 112'h738e0405000a2000005003300016,    // a= MIP.SEMW
// MIP.SEMW
     910: 112'h48580075000a204014500c340000,    // a= LCW
     911: 112'hd000e67d000a200000500f30002a,
     912: 112'h70004405000a200000510330701e,
// SMON
     913: 112'h13720c62800a1000005023300000,    // a= CHRR
     914: 112'he1aae5d5700a3761805033300000,
     915: 112'he0e5ec72800a2064005003300000,
// PHA.SMON
     916: 112'h4000ce5e380a201016500c340000,
     917: 112'hd047cc7e800a206000500330002a,
     918: 112'he000c65d680a2000005043a00000,
     919: 112'h339b287e600a2448005003300017,    // a= ZAX.SMON
     920: 112'hc3940f5de00a2000005003a00000,    // a= PHA.SMON
     921: 112'he000e87dd80a3c48205043300001,
     922: 112'h739d0405000a2000005003300016,    // a= WRR.SMON
// ZAX.SMON
     923: 112'he000c405000a200014500c340000,
// WAW.SMON
     924: 112'h339c259e680a200000520f30002a,    // a= WAW.SMON
// WRR.SMON
     925: 112'he021cdd7f80a2060005003300000,
     926: 112'h384f2597780a370180523330001e,    // a= LCWISE
     927: 112'h30004075000a2040005103307200,
// CMON
     928: 112'h13720c62800a1000005023300000,    // a= CHRR
     929: 112'he1aae5d5700a3761805033300000,
     930: 112'he0e5ec72800a2064005003300000,
// PHA.CMON
     931: 112'h4000ce5e380a201012500c340000,
     932: 112'hd000e87de00a244800500330002b,
     933: 112'he000cf5dd80a2000005003a00000,
     934: 112'he000e87dd80a3c48205043300001,
     935: 112'h33aa0405000aa000005003300016,    // a= WRR.CMON
     936: 112'he000c405000a200014500c340000,
// WAW.CMON
     937: 112'h33a9267d000a200000520f30002a,    // a= WAW.CMON
// WRR.CMON
     938: 112'he021ced6f00a20601e5003340000,
// WAEX.CMON
     939: 112'h33ab2445680a370180523330002a,    // a= WAEX.CMON
     940: 112'hc8582c7d800a200000500fa00000,    // a= LCW
     941: 112'h41a9ceddd80a20601c5203340000,
     942: 112'hd05acdd7f80a206000500330002a,
     943: 112'he000e617780a3701805033300000,
     944: 112'h784d0d99580a200000510330721e,    // a= JQ
// TTX
     945: 112'h3006244d000a200000520f30000c,    // a= EXTDR
     946: 112'he000ec62800a1004005023300000,
     947: 112'hc8580405000a200014500c3405c0,    // a= LCW
     948: 112'he000e835080a2000005007320000,
// WW.TTX
     949: 112'h33b50075000a204000520330002a,    // a= WW.TTX
     950: 112'h70006475000a368000512732721e,
// TTXF
     951: 112'h3006244d000a200000520f30000c,    // a= EXTDR
     952: 112'he000ec62800a1004005023300000,
     953: 112'he000c425000a200014504c3405c0,
     954: 112'h33b52835080aa000005007320016,    // a= WW.TTX
// WWF.TTX
     955: 112'h33bb0075000a204000520330002a,    // a= WWF.TTX
     956: 112'hc8582475000a3680005027320000,    // a= LCW
     957: 112'h700064452a0a380000513330721e,
// TTA
     958: 112'h30062c62800a100400522330000c,    // a= EXTDR
     959: 112'he000c405000a200012500c3405c0,
// WA.TTA
     960: 112'h33c00075000a204000520330002a,    // a= WA.TTA
     961: 112'hc8580e58b80a2048205002320201,    // a= LCW
     962: 112'h70004c78000a2000005183a0705e,
// TTAF
     963: 112'h30060425000a200000524330000c,    // a= EXTDR
     964: 112'h33be2d72800ab804005023300016,    // a= TTA
     965: 112'he000c405000a200012500c3405c0,
// WALF.TTA
     966: 112'h33c60075000a204000520330002a,    // a= WALF.TTA
     967: 112'hc8580e58b80a2048205002320201,    // a= LCW
     968: 112'h70006878280a38000051b3a0705e,
// HLT
     969: 112'h30060c62800a100000522330020c,    // a= EXTDR
     970: 112'he0dece52a80a20600050433075c0,
     971: 112'h33d00c75800a20482050033a0897,    // a= NOHLT.HLT
     972: 112'he011e5d5580a20600050033b0880,
// FATHLT
     973: 112'he000c405000a2000005003300680,
     974: 112'he000c405000a2000005003300600,
// WRUN.HLT
     975: 112'h33cf0405000a2000005203300020,    // a= WRUN.HLT
// NOHLT.HLT
     976: 112'h30004075000a204000d10330001e,
     977: 112'h38522c31820a2004005003300380,    // a= LCWPH
// JOPC
     978: 112'h368d0405000a20000050033002c0,    // a= JMPOPC
// RET
     979: 112'h30060e5fb00a368000522330000c,    // a= EXTDR
     980: 112'he0adce5f780a2060005043300000,
     981: 112'h33fa2877700aa1c8205003300017,    // a= SMOD.RET
     982: 112'he000cc76800a3100005023300000,
     983: 112'he074ecdeea0a3164005033300000,
     984: 112'h4000c405000a20001a500c340000,
     985: 112'hd0e2e475000a206480500330002a,
     986: 112'he000cc7e000a20001a5003a40000,
     987: 112'he000e87e600a3ec8205033300000,
// W3.RET
     988: 112'h33dc2445600a3f0000523330002a,    // a= W3.RET
     989: 112'he000cc7e000a20001a5003a40000,
     990: 112'he000e87e600a3dc8205033300000,
// W5.RET
     991: 112'h33df2445600a3e0000523330002a,    // a= W5.RET
     992: 112'he000cc7e000a20001a5003a40000,
     993: 112'he000e87e600a3cc8205033300000,
// W7.RET
     994: 112'h33e22445600a3d0000523330002a,    // a= W7.RET
     995: 112'he000cc7e000a20001a5003a40000,
     996: 112'he000e87e600a3bc8205033300000,
// W9.RET
     997: 112'h33e52445600a3c0000523330002a,    // a= W9.RET
     998: 112'he000cc7e000a20001a5003a40000,
     999: 112'he000e87e600a3ac8205033300000,
// W11.RET
    1000: 112'h33e82445600a3b0000523330002a,    // a= W11.RET
    1001: 112'he000cc7e000a20001a5003a40000,
    1002: 112'he000e87e600a39c8205033300000,
// W13.RET
    1003: 112'h33eb2445600a3a0000523330002a,    // a= W13.RET
    1004: 112'he000cc7e000a20001a5003a40000,
    1005: 112'he000e87e600a38c8205033300000,
// WSP.RET
    1006: 112'h33ee2445600a390000523330002a,    // a= WSP.RET
    1007: 112'he000cc7e000a20001a5003a40000,
    1008: 112'he000e87e600a3648205033300000,
// WP.RET
    1009: 112'h33f12445600a380000523330002a,    // a= WP.RET
    1010: 112'he000cc7a000a20001a5003a40000,
// WR.RET
    1011: 112'h33f32879a00a304820520330002b,    // a= WR.RET
    1012: 112'he000cc7e000a2000005003a40000,
    1013: 112'he000e87e600a36c8205037320000,
    1014: 112'he02ce755600037618050b330b000,
    1015: 112'h33f90405000a2000005203300010,    // a= LC.RET
    1016: 112'h38522445180a20040050033064c0,    // a= LCWPH
// LC.RET
    1017: 112'h38522c31820a2004005003306480,    // a= LCWPH
// SMOD.RET
    1018: 112'he000cc76000a3580005023300000,
    1019: 112'he000cc75800a3480005023300000,
    1020: 112'he000cc75000a3500005023300000,
    1021: 112'he000e445700a2000805003300000,
    1022: 112'he000e445600a3580005033300000,
    1023: 112'he000e445580a3480005033300000,
    1024: 112'he000e445500a3500005033300000,
    1025: 112'he000cc76800a3700005023300000,
    1026: 112'he02cef56e80037618050b330b000,
    1027: 112'he000e475000a3680005027320000,
    1028: 112'h34060c72000a3180005223300010,    // a= LCM.RET
    1029: 112'h38522c71800a32040050233074c0,    // a= LCWPH
// LCM.RET
    1030: 112'h38522c71820a3204005023307480,    // a= LCWPH
// IJP
    1031: 112'h30060c77800a348000522330000c,    // a= EXTDR
    1032: 112'he00ace57f80a2060005003300000,
    1033: 112'h142e2c62800a100000502e300000,    // a= CTRD
    1034: 112'he0dcc655280a2060005043300000,
    1035: 112'h340e2595f80ab480005033300016,    // a= AIS.IJP
    1036: 112'he000cc77000a3680005023300000,
    1037: 112'he000e445700a21c8205003e00001,
// AIS.IJP
    1038: 112'he000c405000a200080500a300000,
    1039: 112'he000e475000037018050a330b000,
    1040: 112'he000e475000a3680005027320000,
    1041: 112'he000c25d300a3380005023300000,
    1042: 112'he000cc77800a3400005023300000,
    1043: 112'he000e9e8780a1048205003300001,
    1044: 112'he000c25d300a3280005023300000,
    1045: 112'he000cc77800a3300005023300000,
    1046: 112'h18f70e5db00a3480005023300000,    // a= INICT
    1047: 112'h142229e8f80a1048205003300001,    // a= CTWR
    1048: 112'h143b0c75800a3580005063300000,    // a= CTTWR
    1049: 112'h341c0c72000ab180005023300016,    // a= NPRGI.IJP
    1050: 112'he037cdd9100a2060005003300780,
    1051: 112'h341f2445300a3580005033300440,    // a= PSRET.IJP
// NPRGI.IJP
    1052: 112'he009c655580a2060005043300000,
    1053: 112'h341f0405000aa000005003300016,    // a= PSRET.IJP
    1054: 112'he020e4d55a0a35e0005033300000,
// PSRET.IJP
    1055: 112'h34212475000a3081005023300010,    // a= RCR.IJP
    1056: 112'h38522c71800a3204005023300480,    // a= LCWPH
// RCR.IJP
    1057: 112'h38522c71800a32040050233004c0,    // a= LCWPH
// CTWR
    1058: 112'he0c3cc76000a2060005003300000,
    1059: 112'he000e445600a20780050033088c0,
    1060: 112'he000e445600a20780050033098c0,
    1061: 112'h40012445600a20780050033088c0,
    1062: 112'h8000c405000a2000005003300000,
    1063: 112'he000e445580a2078005003308800,
    1064: 112'he000e445580a2078005003309800,
    1065: 112'h40012445580a2078005003308800,
    1066: 112'h8000e87e580a2448205003300401,
    1067: 112'he000e445600a2078005003308800,
    1068: 112'hc8582445600a2078005003309800,    // a= LCW
    1069: 112'ha000e445600a2078005003308800,
// CTRD
    1070: 112'he000e645000a20780050033088c0,
    1071: 112'he000e645000a20780050033098c0,
    1072: 112'h40012645000a20780050033088c0,
    1073: 112'h8000c405000a2000005003300000,
    1074: 112'he000c405000a2000005003308800,
    1075: 112'he000c405000a2070005003308800,
    1076: 112'h40010e5db80a207000500fb08800,
    1077: 112'h8000c405000a2000005003300000,
    1078: 112'he000c405000a2000005003308800,
    1079: 112'he000c405000a2070005003308800,
    1080: 112'he000ce5e380a207000500fb08800,
    1081: 112'hc858287e600a1c48205003300001,    // a= LCW
    1082: 112'ha000cd9de00a2000005003300000,
// CTTWR
    1083: 112'he0c5cc76000a2060005003300000,
    1084: 112'he000e445600a20780050033088c0,
    1085: 112'he000e445600a20780050033098c0,
    1086: 112'h40012445600a20780050033088c0,
    1087: 112'h8000c405000a2000005003300000,
    1088: 112'he000e445580a2078005003308880,
    1089: 112'he000e445580a2078005003309880,
    1090: 112'h40012445580a2078005003308880,
    1091: 112'h8000e87e580a2448205003300441,
    1092: 112'he000e445600a2078005003308880,
    1093: 112'hc8582445600a2078005003309880,    // a= LCW
    1094: 112'ha000e445600a2078005003308880,
// CTTRD
    1095: 112'he0c2cc75800a2060005003300000,
    1096: 112'he000e445580a20780050033088c0,
    1097: 112'he000e445580a20780050033098c0,
    1098: 112'h40012445580a20780050033088c0,
    1099: 112'h8000c405000a2000005003300000,
    1100: 112'he000c405000a2000005003308880,
    1101: 112'he000c405000a2070005003308880,
    1102: 112'h40010e5db80a207000500fb08880,
    1103: 112'h8000c405000a2000005003300000,
    1104: 112'he000c405000a2000005003308880,
    1105: 112'he000c405000a2070005003308880,
    1106: 112'he000ce5e380a207000500fb08880,
    1107: 112'hc858287e600a1c48205003300001,    // a= LCW
    1108: 112'ha000cd9de00a2000005003300000,
// CTTSTP
    1109: 112'he0c5cc75800a2060005003300000,
    1110: 112'he000e445580a20780050033088c0,
    1111: 112'he000e445580a20780050033098c0,
    1112: 112'h40012445580a20780050033088c0,
    1113: 112'h8000c405000a2000005003300000,
    1114: 112'he000e675000a2078005003308880,
    1115: 112'hc8582675000a2078005003309880,    // a= LCW
    1116: 112'he000e675000a2078005003308880,
    1117: 112'ha000c405000a2000005003300440,
// A*U
    1118: 112'he000ec62800a100000506e300000,
// PSA*U
    1119: 112'h11180e5f300f2000005003a00016,    // a= NADR
    1120: 112'he000ce7e800a2000005003300000,
// INTMUL
    1121: 112'h1478004d000f2000005083300016,    // a= INVWR2
    1122: 112'h147b0e7800172000005003300016,    // a= INVQ.A*U
    1123: 112'he000c50d720a2000005043300000,
    1124: 112'h147d0e7d00092000005003300016,    // a= CHQWR2.A*U
    1125: 112'he000d02d00ea2000005083300000,
    1126: 112'h346804453815a000005043300016,    // a= NOD.A*U
    1127: 112'he000cc187003a000005043300000,
// NOD.A*U
    1128: 112'h403e287f700a1fc8205083300001,
    1129: 112'h147a040500172000005003300016,    // a= OROVR.A*U
    1130: 112'he000d02d00ea2000005003300000,
    1131: 112'h346d04050015a000005003300016,    // a= NOADD.A*U
    1132: 112'he000cc187003a000005043300000,
// NOADD.A*U
    1133: 112'he000c42d000a2000005083300000,
    1134: 112'h3470040500122000005003300016,    // a= ENDCKL.A*U
    1135: 112'h8000e87f700a1fc8205083300001,
// ENDCKL.A*U
    1136: 112'h147a0fcf800b20000050033005d6,    // a= OROVR.A*U
    1137: 112'he000c44d000a2000005083300000,
    1138: 112'h347404050012a000005003300016,    // a= NZR.A*U
    1139: 112'he019cdd6e80a2060005003300000,
// NZR.A*U
    1140: 112'hc85824456800200000508330b000,    // a= LCW
    1141: 112'h3477007500172040005003300016,    // a= INVA.A*U
    1142: 112'h70004405000a200000510330709e,
// INVA.A*U
    1143: 112'h70004c487a0a200000510330709e,
// INVWR2
    1144: 112'he000cd4f720a2000005043300000,
// PSINV.A*U
    1145: 112'ha018cf5ee80fa060005003300016,
// OROVR.A*U
    1146: 112'ha016cddee80a2060005003300000,
// INVQ.A*U
    1147: 112'h3479012d020a2000005043300000,    // a= PSINV.A*U
// INVY
    1148: 112'h34790d38820a2000005043300000,    // a= PSINV.A*U
// CHQWR2.A*U
    1149: 112'he000e82f700a200000500f300000,
    1150: 112'ha000c07d000a2000005003b00000,
// A*I
    1151: 112'he000ec62800a1004005023300000,
    1152: 112'h345f0475000a0000005063e00000,    // a= PSA*U
// A*L
    1153: 112'he000ec62800a1004005023300000,
    1154: 112'he000ce7e800a200012500c340000,
// WA.A*L
    1155: 112'h34830405000a200000520330002a,    // a= WA.A*L
    1156: 112'h34610c7f000a2000005043a00000,    // a= INTMUL
// A*LF
    1157: 112'he000c425000a2000005043300000,
    1158: 112'h34812d72800ab804005023300016,    // a= A*L
    1159: 112'he000ce7e800a200012500c340000,
// WAF.A*L
    1160: 112'h3488004d000a200000528330002a,    // a= WAF.A*L
    1161: 112'h3461287f280a3800005073a00000,    // a= INTMUL
// A*H
    1162: 112'h120a0c67000a1000005063300000,    // a= RDH
    1163: 112'h34610e7e800a20000050033005c0,    // a= INTMUL
// A/U
    1164: 112'he000ec62800a100000506e300000,
// PSA/U
    1165: 112'h11180e5f300f2000005003a00016,    // a= NADR
    1166: 112'he000ce7e800a2000005003300000,
// INTDIV
    1167: 112'h14780c48800f2000005083300016,    // a= INVWR2
    1168: 112'h147c027d00172000005003300016,    // a= INVY
    1169: 112'he000c44d700a2000005043300000,
    1170: 112'h34a0051f0a0a2000005083306216,    // a= OVRZ.A/U
    1171: 112'he064c07d000a2060005003300000,
    1172: 112'h34a82a6d08112058005003300016,    // a= ZRRZ.A/U
    1173: 112'h34aa2a6ff0122058005003300016,    // a= EQU.A/U
    1174: 112'he000ec9fd20a2000015003300000,
    1175: 112'he01ae55d7a0a2064805003300000,
    1176: 112'he000e87f700a2048205003300000,
    1177: 112'h4000c27d0001a000005243300000,
    1178: 112'he000cc98f20a2000005043300000,
    1179: 112'h349d0405000f2000005003300016,    // a= NEG.A/U
    1180: 112'hf49e183880ea2000005243300000,    // a= ENDCKL.A/U
// NEG.A/U
    1181: 112'hf49e1818f04a2000005243300000,    // a= ENDCKL.A/U
// ENDCKL.A/U
    1182: 112'he01ae45d7a0a2064805003300000,
    1183: 112'h34a12878880a2048205003300000,    // a= ANAN.A/U
// OVRZ.A/U
    1184: 112'he016cddee80a2060005003300000,
// ANAN.A/U
    1185: 112'hc85824456800200000508330b5c0,    // a= LCW
    1186: 112'h34a70c280017a000005003300216,    // a= NOINV.A/U
    1187: 112'he000cfb8000a2000005003300000,
    1188: 112'he000cc38020a2000005003300000,
    1189: 112'he000cfb8800a2000005003300000,
    1190: 112'he000cc38820a2000005003300000,
// NOINV.A/U
    1191: 112'h70004075000a204000510330709e,
// ZRRZ.A/U
    1192: 112'hc8580c48800a20000050033005c0,    // a= LCW
    1193: 112'h784d0e78000a200000518330009e,    // a= JQ
// EQU.A/U
    1194: 112'he000ce78800a2000005003300000,
    1195: 112'h34a1004d0a0a2000005003300000,    // a= ANAN.A/U
// A/I
    1196: 112'he000ec62800a1004005023300000,
    1197: 112'h348d0475000a0000005063e00000,    // a= PSA/U
// A/L
    1198: 112'he000ec62800a1004005023300000,
    1199: 112'he000ce7e800a200012500c340000,
// WA.A/L
    1200: 112'h34b0004d000a200000528330002a,    // a= WA.A/L
    1201: 112'h348f0c7f000a2000005043a00000,    // a= INTDIV
// A/LF
    1202: 112'he000c425000a2000005043300000,
    1203: 112'h34ae2d72800ab804005023300016,    // a= A/L
    1204: 112'he000ce7e800a200012500c340000,
// WAF.A/L
    1205: 112'h34b5004d000a200000528330002a,    // a= WAF.A/L
    1206: 112'h348f287f280a3800005073a00000,    // a= INTDIV
// A/H
    1207: 112'h120a0c67000a1000005063300000,    // a= RDH
    1208: 112'h348f0e7e800a20000050033005c0,    // a= INTDIV
// ADX
    1209: 112'h14c42c62800a1004005023300000,    // a= RDFLT
// PSADX
    1210: 112'he000cc18780a2000005003300000,
    1211: 112'he000cc1f600a2000005043300000,
    1212: 112'h34e10c48060a2000005083300380,    // a= NORMX
// ADXF
    1213: 112'h34bf0425000a2000005043300000,    // a= PSFE.ADX
// ADXFE
    1214: 112'he0d1c665000a2060005043300000,
// PSFE.ADX
    1215: 112'h34b90405000aa000005003300016,    // a= ADX
    1216: 112'h14c42d72800a3804005023300000,    // a= RDFLT
    1217: 112'he000cc18780a2000005003300000,
    1218: 112'he000cc1f600a2000005043300000,
    1219: 112'h34e128382e0a38000050b3300380,    // a= NORMX
// RDFLT
    1220: 112'he000ce7f000a200012500c340000,
    1221: 112'he000e87f800a1ac8205003300001,
    1222: 112'he000e87ff80a20c8405003300001,
// PSFLT
    1223: 112'h40cfc25d000a2060005003300000,
    1224: 112'hd04fcc6d000a206000500330002a,
    1225: 112'he000ce5dc00a2000005003a000c0,
    1226: 112'he04fcc5dd80a2060005003300000,
    1227: 112'he000cc78000a1ac820500a300001,
    1228: 112'he000e878000a20c8405003300001,
    1229: 112'hc4d4251dd20a200000504e300000,    // a= ABIG.ADX
    1230: 112'ha000ce7e000a2000005003300016,
    1231: 112'h34dd0c7e800b3ac840500a300017,    // a= OVRE.ADX
    1232: 112'h34d227cd6809a00000500f300016,    // a= PSDEL.ADX
    1233: 112'hc4d80c7e820a2000005003b00000,    // a= XBIG.ADX
// PSDEL.ADX
    1234: 112'he0a4c0dd6a0a2060005083300000,
    1235: 112'h701ae455680a2064805203f00000,
// ABIG.ADX
    1236: 112'he000e878000a204840500e300000,
    1237: 112'h34d724650010a004805003b00016,    // a= AR.ADX
    1238: 112'ha000cc7e000a204820500a300000,
// AR.ADX
    1239: 112'ha000cc7e000a204840500a300000,
// XBIG.ADX
    1240: 112'he000e87ff80a204840500e300000,
    1241: 112'he000cc4d580a2000005003300000,
    1242: 112'h34dc24650010a004805003b00016,    // a= ARX.ADX
    1243: 112'ha000cc7f000a204820500a300000,
// ARX.ADX
    1244: 112'ha000cc7f000a204840500a300000,
// OVRE.ADX
    1245: 112'h34df040500092000005003300016,    // a= NEGEA.ADX
    1246: 112'ha000ce78000a2000005003300000,
// NEGEA.ADX
    1247: 112'he000cc4d580a2000005003300000,
    1248: 112'ha000ce7f800a2000005003300000,
// NORMX
    1249: 112'h3522044d000a2000005043300382,    // a= BN.ADX
    1250: 112'h35190e7d800f2000005003300016,    // a= NEGF.ADX
    1251: 112'h3509287e800a2058005003300016,    // a= ZERFA.ADX
// PSLOSX.ADX
    1252: 112'he064ce5ee80a2060005003300000,
    1253: 112'he068cd5eea0a2060005003300000,
    1254: 112'h14fa04050001a000005083300000,    // a= CALCOR
    1255: 112'h34e904050012a000005003300016,    // a= DNO.ADX
// NODNO.ADX
    1256: 112'he067cc7e800a2060005003300000,
// DNO.ADX
    1257: 112'he06fcc5e680a2060005083300000,
    1258: 112'he01aec5e600a2064805003300000,
    1259: 112'he000e878000a204820500e300000,
    1260: 112'h34ef287f7017a04820500f300016,    // a= RSH.ADX
    1261: 112'he0a4e455600a2064805003300000,
    1262: 112'h34f10dd8000a204820500b300000,    // a= PSNOR
// RSH.ADX
    1263: 112'he0a4e4dd620a2064805003300000,
    1264: 112'he000cddf700a204820500a300000,
// PSNOR
    1265: 112'he000ce18480a2000005003300000,
    1266: 112'he04fc06d000a2060005003300000,
    1267: 112'h15310d880003a00000504330000e,    // a= EMRNOR
// OUTZ.ADX
    1268: 112'h353429e8f00a264820500330000f,    // a= BER
    1269: 112'h34f80618c80a2000005083300004,    // a= NORND
    1270: 112'h34f8040500122000005003300016,    // a= NORND
    1271: 112'he067cdd8000a2060005003300000,
// NORND
    1272: 112'hc8580405000a20000050033005c0,    // a= LCW
    1273: 112'h700040750001204000518330701e,
// CALCOR
    1274: 112'hc858059dd00a2000005043300000,    // a= LCW
    1275: 112'h3501244d680f05c8205003f00017,    // a= MBSN.ADX
    1276: 112'he000c05d500a2000005003b00000,
    1277: 112'he000c00d580a2000005043300000,
    1278: 112'ha000c405000ba000005003300016,
    1279: 112'ha000c405000a2000005003300006,
    1280: 112'hb9430405000a2000005003300000,    // a= INT33
// MBSN.ADX
    1281: 112'he000c01dd00a2000005043300000,
    1282: 112'h35060405000ba000005003300016,    // a= PSCOR.ADX
    1283: 112'he04fc07d000a2060005003300000,
    1284: 112'he000ce78000a2000005003300000,
    1285: 112'hb4f10e7f0001a000005043300000,    // a= PSNOR
// PSCOR.ADX
    1286: 112'he000c06d000a2000005043b00000,
    1287: 112'ha000c405000ba000005003300016,
    1288: 112'ha000c01dd002a0000050c3300000,
// ZERFA.ADX
    1289: 112'he000c44d700a2000005043300000,
    1290: 112'h350c287ef00aa058005003300016,    // a= PSZERF.ADX
    1291: 112'h34f4027d000a2000005003300000,    // a= OUTZ.ADX
// PSZERF.ADX
    1292: 112'he064ce5e680a2060005003300000,
    1293: 112'he1b8cc7e800a2060005003300000,
    1294: 112'h14fa04050001a000005083300000,    // a= CALCOR
    1295: 112'h34e8040500122000005003300016,    // a= NODNO.ADX
    1296: 112'he071cd5e620a2060005083300000,
    1297: 112'he01aec5e600a2064805003300000,
    1298: 112'he04fce58000a2060005003300000,
    1299: 112'he000e44d000a25c8205003f00001,
    1300: 112'he000e878700a2048205003300000,
    1301: 112'he00fce58000a2060005003300000,
    1302: 112'he000cdd8000a2000005003b00000,
    1303: 112'he0a4e4d5620a2064805003300000,
    1304: 112'h34f1287f700a2048205003300000,    // a= PSNOR
// NEGF.ADX
    1305: 112'he000cfce000a2000005083300000,
    1306: 112'h34e4287ee012a058005003300016,    // a= PSLOSX.ADX
    1307: 112'he000cfce700a2000005083300000,
    1308: 112'h350c287ee012a058005003300016,    // a= PSZERF.ADX
    1309: 112'he125cd7e820a2060005003300000,
    1310: 112'h14fa04050001a000005083300000,    // a= CALCOR
    1311: 112'h34e8040500122000005003300016,    // a= NODNO.ADX
    1312: 112'he044cc78000a2060005003300000,
    1313: 112'h34f10e7f000a2000005003300000,    // a= PSNOR
// BN.ADX
    1314: 112'he000c04d700a2000005003300000,
    1315: 112'he000d84800ca2000005003300000,
    1316: 112'h352b044d000f2000005083300016,    // a= NMAN.ADX
    1317: 112'h352d0c2f0017a000005003300016,    // a= OKBN.ADX
    1318: 112'he000d04800ca2000005003300000,
// ADDE.ADX
    1319: 112'he045cc5d500a2060005043300000,
    1320: 112'h352d0c2f000ba000005003300016,    // a= OKBN.ADX
    1321: 112'h39430405000a2000005203300006,    // a= INT33
    1322: 112'h352d0405000a2000005003300000,    // a= OKBN.ADX
// NMAN.ADX
    1323: 112'h352d0c2f00172000005003300016,    // a= OKBN.ADX
    1324: 112'h35271048006a2000005003300000,    // a= ADDE.ADX
// OKBN.ADX
    1325: 112'he000e878000a25c820500e300001,
    1326: 112'he000e87f700a25c8205003300001,
    1327: 112'he000cddf700a05c820500a300001,
    1328: 112'h34f1004d500a2000005003300000,    // a= PSNOR
// EMRNOR
    1329: 112'he000e87e000a0648205003300001,
    1330: 112'he000e87f700a2648205003300001,
    1331: 112'ha000cd9f600a2000005003300000,
// BER
    1332: 112'h35360405000a2000005203300218,    // a= PSBER.ADX
    1333: 112'h35370618c80a2000005083300000,    // a= PSPSB.ADX
// PSBER.ADX
    1334: 112'h353f287e080a14c8205083300005,    // a= BERA
// PSPSB.ADX
    1335: 112'h353d0405000a2000005203300008,    // a= BMAN.ADX
    1336: 112'he000c618c80a2000005083300000,
    1337: 112'h353f040500122000005003300016,    // a= BERA
    1338: 112'he01ccdd8000a2060005003300000,
    1339: 112'he0deced8000a2060005003300000,
    1340: 112'h35440405000a2000005003300000,    // a= DBER
// BMAN.ADX
    1341: 112'h353f040500122000005003300016,    // a= BERA
    1342: 112'he067cdd8000a2060005003300000,
// BERA
    1343: 112'h35440405000a2000005203300008,    // a= DBER
    1344: 112'he0dec655000a2060005083f00000,
    1345: 112'h35440ed800122000005003b00016,    // a= DBER
    1346: 112'h35440405000a2000005003300004,    // a= DBER
    1347: 112'he01ccdd8000a2060005003300000,
// DBER
    1348: 112'h354d044d000a2000005283300008,    // a= KEMR.ADX
    1349: 112'h354b040500172000005003300016,    // a= BIGREM.ADX
    1350: 112'he0ccce5e800a2060005003300000,
    1351: 112'he0ccc75d680a2060005083300000,
    1352: 112'h354d040500122000005003300016,    // a= KEMR.ADX
    1353: 112'he0cccc78000a2060005043300000,
    1354: 112'h354d0c48800a2000005003300000,    // a= KEMR.ADX
// BIGREM.ADX
    1355: 112'he0ccc65d000a2060005083300000,
    1356: 112'h394704050012a000005003300396,    // a= INT34
// KEMR.ADX
    1357: 112'hc8580405000a20000050033005c0,    // a= LCW
    1358: 112'h700040750001204000518330739e,
// ABX
    1359: 112'h14c42c62800a1004005023300000,    // a= RDFLT
    1360: 112'he000cfb8000a2000005003300000,
// PSABX.ABX
    1361: 112'he000cfbe000a2000005003300000,
    1362: 112'he000cc3e020a2000005043300000,
    1363: 112'h34ba0c38060a2000005003300000,    // a= PSADX
// ABXF
    1364: 112'h35560425000a2000005043300000,    // a= PSFE.ABX
// ABXFE
    1365: 112'he0d1c665000a2060005043300000,
// PSFE.ABX
    1366: 112'h354f0405000aa000005003300016,    // a= ABX
    1367: 112'h14c42d72800a3804005023300000,    // a= RDFLT
    1368: 112'h35512bb8280a3800005033300000,    // a= PSABX.ABX
// XBA
    1369: 112'h14c42c62800a1004005023300000,    // a= RDFLT
    1370: 112'he000cfbf800a2000005003300000,
// PSXBA.XBA
    1371: 112'he000cfbf000a2000005003300000,
    1372: 112'he000cc3f020a2000005043300000,
    1373: 112'h34ba0c3f860a2000005083300000,    // a= PSADX
// XBAF
    1374: 112'h35600425000a2000005043300000,    // a= PSFE.XBA
// XBAFE
    1375: 112'he0d1c665000a2060005043300000,
// PSFE.XBA
    1376: 112'h35590405000aa000005003300016,    // a= XBA
    1377: 112'h14c42d72800a3804005023300000,    // a= RDFLT
    1378: 112'h355b2bbfa80a3800005033300000,    // a= PSXBA.XBA
// AMX
    1379: 112'he000ec62800a1004005023300000,
    1380: 112'he000ce7f000a200012500c340000,
    1381: 112'he000e87f800a1ac8205043300001,
    1382: 112'h3569287ff80fa0c8405003300017,    // a= PRA.AMX
    1383: 112'he000cfbf800a2000005003300000,
    1384: 112'he000cc3f820a2000005003300000,
// PRA.AMX
    1385: 112'h14c70405000a2000005003300000,    // a= PSFLT
    1386: 112'he000c44d000a2000005043300000,
// PSAMX.AMX
    1387: 112'h34ba0fce800f2000005003300016,    // a= PSADX
    1388: 112'he000cfbe000a2000005003300000,
    1389: 112'he000cc3e020a2000005043300000,
    1390: 112'h34ba0c486e0a2000005003300000,    // a= PSADX
// AMXF
    1391: 112'h35710425000a2000005043300000,    // a= PSFE.AMX
// AMXFE
    1392: 112'he0d1c665000a2060005043300000,
// PSFE.AMX
    1393: 112'h35632d72800ab804005023300016,    // a= AMX
    1394: 112'he000ce7f000a200012500c340000,
    1395: 112'he000e87f800a1ac8205043300001,
    1396: 112'h3577287ff80fa0c8405003300017,    // a= PRAF.AMX
    1397: 112'he000cfcff80a2000005003300000,
    1398: 112'he000cc3f820a2000005003300000,
// PRAF.AMX
    1399: 112'h14c70405000a2000005003300000,    // a= PSFLT
    1400: 112'h356b2838280a3800005073300000,    // a= PSAMX.AMX
// AVX
    1401: 112'h15802c62800a1004005023300000,    // a= SUBAVX
    1402: 112'h358a0405000a2000005003300380,    // a= NORMA
// AVXF
    1403: 112'h357d0425000a2000005043300000,    // a= PSFE.AVX
// AVXFE
    1404: 112'he0d1c665000a2060005043300000,
// PSFE.AVX
    1405: 112'h35790405000aa000005003300016,    // a= AVX
    1406: 112'h15802d72800a3804005023300000,    // a= SUBAVX
    1407: 112'h358a2445280a3800005033300380,    // a= NORMA
// SUBAVX
    1408: 112'he0cece5f800a206012500c340000,
    1409: 112'he000e87ef80a1ac8205083300001,
    1410: 112'he0cecf5ef80a2060005003300000,
    1411: 112'h48580218400a2000005003300000,    // a= LCW
    1412: 112'hd04fcc6d000a206000500330002a,
    1413: 112'he000c47d000a1ac820504a300001,
    1414: 112'ha000ce7d800fa0000050033000d6,
    1415: 112'he000cc4fea0a2000005003300000,
    1416: 112'ha000ce1fc8122000005003300016,
    1417: 112'ha000c4050002a000005083300000,
// NORMA
    1418: 112'h35a3044d780a2000005043300002,    // a= BNNE.AVX
    1419: 112'h359b040500172000005003300016,    // a= NEGE.AVX
    1420: 112'h35ae287ef80a2058005003300016,    // a= ZRRZAE.AVX
// PSLOSE.AVX
    1421: 112'he064ce5ee80a2060005003300000,
    1422: 112'he071cd5eea0a2060005003300000,
    1423: 112'h14fa04050001a000005083300000,    // a= CALCOR
    1424: 112'h3594040500122000005003300016,    // a= PSNORA.AVX
    1425: 112'he01ae45d680a2064805003300000,
    1426: 112'h3594287ff80a2048205203300018,    // a= PSNORA.AVX
    1427: 112'he000e878880a2048205003300000,
// PSNORA.AVX
    1428: 112'he04fc06d000a2060005003300000,
    1429: 112'h35980e1fc80a2000005203300018,    // a= OUTE.AVX
    1430: 112'he000ce18c80a2000005003300000,
    1431: 112'he000cd88880a2000005003300000,
// OUTE.AVX
    1432: 112'h353f0d887803a00000504330000e,    // a= BERA
    1433: 112'hc8580405000a20000050033005c0,    // a= LCW
    1434: 112'h700040750001204000518330739e,
// NEGE.AVX
    1435: 112'he0cece5ef80a2060005003300000,
    1436: 112'he000e71ec80a200000504f300000,
    1437: 112'h358d0c7e800aa05800500b300016,    // a= PSLOSE.AVX
    1438: 112'he098ccfe820a2060005003300000,
    1439: 112'h14fa04050001a000005083300000,    // a= CALCOR
    1440: 112'h3594040500122000005003300016,    // a= PSNORA.AVX
    1441: 112'he044cc7f800a2060005003300000,
    1442: 112'h35940405000a2000005003300000,    // a= PSNORA.AVX
// BNNE.AVX
    1443: 112'h35a90e7e80172000005003300016,    // a= NEGBN.AVX
    1444: 112'he044c65d780a2060005043300000,
    1445: 112'h35ab0405000a2000005003300016,    // a= CORBN.AVX
// SHBN.AVX
    1446: 112'he067cc7e800a2060005003300000,
    1447: 112'h35ab144ff80a2000005203300018,    // a= CORBN.AVX
    1448: 112'h35ab1448880a2000005003300000,    // a= CORBN.AVX
// NEGBN.AVX
    1449: 112'he044c65d780a2060005043300000,
    1450: 112'h35a60405000a2000005003300016,    // a= SHBN.AVX
// CORBN.AVX
    1451: 112'h14fa04050001a000005083300000,    // a= CALCOR
    1452: 112'h359404050012a000005003300016,    // a= PSNORA.AVX
    1453: 112'he000ce7f800a2000005003300000,
// ZRRZAE.AVX
    1454: 112'h3598027d000a2000005003300000,    // a= OUTE.AVX
// A/X
    1455: 112'h15e92c62800a1004005023300000,    // a= MDXSUB
// DIVX.A/X
    1456: 112'he045cf1dc00a2060005003f00000,
    1457: 112'h35d80c5dd80a2000005003b00016,    // a= ZERMA
    1458: 112'h35b50c280012a000005003300016,    // a= PSDIV.A/X
    1459: 112'h39430405000a2000005203300006,    // a= INT33
    1460: 112'h34f804050007a000005043300000,    // a= NORND
// PSDIV.A/X
    1461: 112'he064c07d000a2060005003300000,
    1462: 112'he000ea6f000a2058005003300000,
    1463: 112'he000ea6e780a2058005003300000,
    1464: 112'he000ec9e720a2000005043300000,
    1465: 112'h35bf0c48f80fa000005003300016,    // a= PDT.A/X
    1466: 112'he01ae45d600a2064805003300000,
    1467: 112'he000e878000a2048205003300000,
    1468: 112'he000e87e600a05c8405003300001,
    1469: 112'he000cc9de20a2000005043300000,
    1470: 112'h35d80405000b2000005003300016,    // a= ZERMA
// PDT.A/X
    1471: 112'he000ea6f000a2058005003300000,
    1472: 112'he0a4e55d720a2060015003300000,
    1473: 112'he070ccdf720a2060005003300000,
    1474: 112'he000e87f700a05c8405003300001,
    1475: 112'he000cc1df00a2000005003300000,
    1476: 112'h4000c27d000a2000005203300000,
    1477: 112'he000cc98820a2000005043300000,
    1478: 112'h35c80405000f2000005003300016,    // a= NEG.A/X
    1479: 112'hf5c9184888ea2000005203300000,    // a= ENDCKL.A/X
// NEG.A/X
    1480: 112'hf5c91818804a2000005203300000,    // a= ENDCKL.A/X
// ENDCKL.A/X
    1481: 112'he000d04888ca2000005043300000,
    1482: 112'he000e82fe800200000508330b000,
    1483: 112'h358a04050017a0000050033003d6,    // a= NORMA
    1484: 112'he1b3cf5ff80a2060005003300000,
    1485: 112'he000cc3f820a2000005003300000,
    1486: 112'he1b3cf58880a2060005003300000,
    1487: 112'h358a0c38820a2000005003300000,    // a= NORMA
// A/XF
    1488: 112'h35d20425000a2000005043300000,    // a= PSFE.A/X
// A/XFE
    1489: 112'he0d1c665000a2060005043300000,
// PSFE.A/X
    1490: 112'h35af0405000aa000005003300016,    // a= A/X
    1491: 112'h15e92d72800a3804005023300000,    // a= MDXSUB
    1492: 112'h35b02445280a3800005033300000,    // a= DIVX.A/X
// A*X
    1493: 112'h15e92c62800a1004005023300000,    // a= MDXSUB
// MULX.A*X
    1494: 112'h35d80405000a2000005003300216,    // a= ZERMA
    1495: 112'h35e004050012a000005003300396,    // a= PSMUL.A*X
// ZERMA
    1496: 112'h35dd0e78800a2000005203300002,    // a= OUTZ.A*X
    1497: 112'he000c01d580a2000005043300000,
    1498: 112'he04fcc68800a2060005003300000,
    1499: 112'h35dd0405000ba000005003300016,    // a= OUTZ.A*X
    1500: 112'he0cfce58800a2060005003300000,
// OUTZ.A*X
    1501: 112'h35440c48080a200000508330000e,    // a= DBER
    1502: 112'hc8580405000a20000050033005c0,    // a= LCW
    1503: 112'h70004075000a204000510330709e,
// PSMUL.A*X
    1504: 112'h40350e780001a000005043300000,
    1505: 112'h35e3104800ed2000005083300016,    // a= ADDM.A*X
    1506: 112'hf5f80405000120000052c3300000,    // a= NORMMD
// ADDM.A*X
    1507: 112'hf5f80c18780120000052c3300000,    // a= NORMMD
// A*XF
    1508: 112'h35e60425000a2000005043300000,    // a= A*XFAN.A*X
// A*XFE
    1509: 112'he0d1c665000a2060005043300000,
// A*XFAN.A*X
    1510: 112'h35d50405000aa000005003300016,    // a= A*X
    1511: 112'h15e92d72800a3804005023300000,    // a= MDXSUB
    1512: 112'h35d62445280a3800005033300000,    // a= MULX.A*X
// MDXSUB
    1513: 112'he0cece5f800a206012504c340000,
    1514: 112'he044c65d000a2060005083300380,
    1515: 112'h15f30e7e8012a000005003300016,    // a= DOPA.A*X
    1516: 112'h40cfc25d000a2060005003300000,
    1517: 112'hd04fcc6d000a206000500330002a,
    1518: 112'he000ce5dc00a2000005003a00080,
    1519: 112'he04fccddda0a2060005003300000,
    1520: 112'hc858047d000a1ac820508a300001,    // a= LCW
    1521: 112'h15f6025d48172000005003a00016,    // a= DOPX.A*X
    1522: 112'ha000c42d000a2000005083300000,
// DOPA.A*X
    1523: 112'he000cf1fc80a2000005003300000,
    1524: 112'he000cc3f820a2000005003300000,
// PSDOP.A*X
    1525: 112'ha018cf5ee80a2060005003300000,
// DOPX.A*X
    1526: 112'he000c30d480a2000005003300000,
    1527: 112'h35f5002d020a2000005003300000,    // a= PSDOP.A*X
// NORMMD
    1528: 112'he000e4456800200000508330b380,
    1529: 112'h360d0c2f00172000005003300016,    // a= NEGRZ.A*X
    1530: 112'h3606287e000a1a48205043300003,    // a= BNN.A*X
    1531: 112'h36060405000f2000005003300016,    // a= BNN.A*X
    1532: 112'h360b287e800a2058005003300016,    // a= ZRRZA.A*X
// PSLOS.A*X
    1533: 112'he064ce5ee80a2060005003300000,
    1534: 112'he071cd5eea0a2060005083300000,
    1535: 112'h14fa04050001a000005083300000,    // a= CALCOR
    1536: 112'h34f1040500122000005003300016,    // a= PSNOR
    1537: 112'he01aec5e680a2064805003300000,
    1538: 112'he000e878000a204820500f300000,
    1539: 112'he000e87f700a204820500f300000,
    1540: 112'he0a4e455600a2064805003300000,
    1541: 112'h34f10dd8000a204820500b300000,    // a= PSNOR
// BNN.A*X
    1542: 112'h14fa0e7e8001a000005083300000,    // a= CALCOR
    1543: 112'h34f104050012a000005003300016,    // a= PSNOR
    1544: 112'he04fc07d000a2060005003300000,
    1545: 112'he000ce78000a2000005003300000,
    1546: 112'h34f10e7f000a2000005003300000,    // a= PSNOR
// ZRRZA.A*X
    1547: 112'hc5d8044d700a2000005043300000,    // a= ZERMA
    1548: 112'h7616287ef00aa058005003300016,    // a= ONSIN.A*X
// NEGRZ.A*X
    1549: 112'he1b0cf5f700a2060005003300000,
    1550: 112'he000cf18480a2000005003300000,
    1551: 112'he01bcc5f700a2060005043300000,
    1552: 112'h36060c48060a2000005003300002,    // a= BNN.A*X
    1553: 112'he043c65d000a2060005043300000,
    1554: 112'h36062718480a200000504f300016,    // a= BNN.A*X
    1555: 112'h35fd0c7e800aa05800500b300016,    // a= PSLOS.A*X
    1556: 112'he1b0e75d700a200000504f300000,
    1557: 112'h36210c7e800a205800500b300016,    // a= DBLNEG.A*X
// ONSIN.A*X
    1558: 112'he064ce5ee80a2060005003300000,
    1559: 112'he071cd5fea0a2060005003300000,
    1560: 112'he098ccfe020a2060005003300000,
    1561: 112'h14fa0d1ee201a000005083300000,    // a= CALCOR
    1562: 112'h34f1040500122000005003300016,    // a= PSNOR
    1563: 112'he01ae455780a2064805003300000,
    1564: 112'he044e65d000a206000500f300000,
    1565: 112'he000e878700a2048205003300000,
    1566: 112'he00fce58000a2060005003300000,
    1567: 112'he000cdd8000a2000005003b00000,
    1568: 112'h34f10e7f000a2000005003300000,    // a= PSNOR
// DBLNEG.A*X
    1569: 112'he1b5cc7e800a2060005003300000,
    1570: 112'h14fa04050001a000005083300000,    // a= CALCOR
    1571: 112'h34f1040500122000005003300016,    // a= PSNOR
    1572: 112'he044cc78000a2060005003300000,
    1573: 112'h34f10e7f000a2000005003300000,    // a= PSNOR
// EDX
    1574: 112'h16282c62800a1004005023300000,    // a= SUBEDX
    1575: 112'h358a0405000a2000005003300380,    // a= NORMA
// SUBEDX
    1576: 112'he0cece5f800a206012504c340380,
    1577: 112'he000e87ef80a1ac8205083300001,
    1578: 112'h48580218400a2000005003300000,    // a= LCW
    1579: 112'hd04fcc6d000a206000500330002a,
    1580: 112'he000ce5dc00a2000005003a00000,
    1581: 112'ha04fcc5dd80a2060005003300080,
// EDXF
    1582: 112'h36300425000a2000005043300000,    // a= PSFE.EDX
// EDXFE
    1583: 112'he0d1c665000a2060005043300000,
// PSFE.EDX
    1584: 112'h36260405000aa000005003300016,    // a= EDX
    1585: 112'h16282d72800a3804005023300000,    // a= SUBEDX
    1586: 112'h358a2445280a3800005033300380,    // a= NORMA
// EBX
    1587: 112'h16282c62800a1004005023300000,    // a= SUBEDX
    1588: 112'h358a0d3d820a2000005003300380,    // a= NORMA
// EBXF
    1589: 112'h36370425000a2000005043300000,    // a= PSFE.EBX
// EBXFE
    1590: 112'he0d1c665000a2060005043300000,
// PSFE.EBX
    1591: 112'h36330405000aa000005003300016,    // a= EBX
    1592: 112'h16282d72800a3804005023300000,    // a= SUBEDX
    1593: 112'h358a293daa0a3800005033300380,    // a= NORMA
// EDN
    1594: 112'h163c2c62800a100000502f300000,    // a= SUBEDN
    1595: 112'h358a0405000a2000005003300380,    // a= NORMA
// SUBEDN
    1596: 112'he0cece5f800a2060005043300380,
    1597: 112'he000e87ef80a1ac8205083300001,
    1598: 112'hc8580218400a2000005003300000,    // a= LCW
// PSEDN
    1599: 112'he04fcc6d000a2060005003300000,
    1600: 112'h36420c7d800a05c820500b30008f,    // a= SUBEML.EDN
// RETSUB.EDN
    1601: 112'ha04fcc5dd80a2060005003300080,
// SUBEML.EDN
    1602: 112'he000cc7d800a03c820500b300001,
    1603: 112'h3641287dd80a2248605003300001,    // a= RETSUB.EDN
// EBN
    1604: 112'h163c2c62800a100000502f300000,    // a= SUBEDN
    1605: 112'h358a0d3d820a2000005003300380,    // a= NORMA
// YTA
    1606: 112'he000ec62800a100000502f3003c0,
    1607: 112'hc8580405000a2000005003300340,    // a= LCW
    1608: 112'h30008405000a2000005003300000,
// YTAD
    1609: 112'he00fce5f8801a060005083300000,
    1610: 112'h163f0218400a2000005003300000,    // a= PSEDN
    1611: 112'h358a0405000a2000005003300380,    // a= NORMA
// YTAL
    1612: 112'he000cc76000a2018005003300000,
    1613: 112'he080c655600a2060005043300000,
    1614: 112'h36490405000a2000005003300016,    // a= YTAD
    1615: 112'he000cc48080a20000050033005c0,
    1616: 112'h70004075000a204000510330721e,
// INIC
    1617: 112'he0ceec7c800a2061005003300000,
    1618: 112'he0cfec7c000a2060005007320000,
    1619: 112'he015ccff020a2060005003340000,
    1620: 112'h401f2e7f800a20000050033b0880,
    1621: 112'he015ec5f700a2060805003300000,
    1622: 112'h8000e445780a3f80005033300000,
    1623: 112'he078cc7f800a2060005003300000,
// CMES.INIC
    1624: 112'he06aecdffa0a2062805043300000,
    1625: 112'h43ff2e7f000a2002005003300000,
    1626: 112'he001e445700a2064005003305000,
    1627: 112'he067e475000a20600050033d0000,
    1628: 112'he067e475000a20600050033f0000,
    1629: 112'h801aec57720a2062005003300000,
    1630: 112'hb6580405000aa000005003300016,    // a= CMES.INIC
    1631: 112'he1a5e475000037618050b330b480,
    1632: 112'he0e5ec7f820a2064005003300000,
    1633: 112'he05ae475000a2060005003390400,
    1634: 112'h14550405000a2005005003300640,    // a= CTTSTP
    1635: 112'he1a8e455780a2064005003300000,
    1636: 112'he000cc7f800a206012500c340000,
    1637: 112'he000e85f780a1e48205003300001,
    1638: 112'he000e87ff80a1ec8205003300001,
    1639: 112'he000cc1f780a2000005003300000,
    1640: 112'h412fcc5f700a2060005203300000,
// RCONST
    1641: 112'hd1aacc78000a206000500330002a,
    1642: 112'he000c75d700a2000005043a00000,
// ZLP.INIC
    1643: 112'h366b0405000aa0000050033002d6,    // a= ZLP.INIC
    1644: 112'he1a6ec79800a2064005003300000,
    1645: 112'h48520405000a20001e5003340000,    // a= LCWPH
    1646: 112'hd00bcc7b800a206000500330002a,
    1647: 112'he000ec79000a200000500fa00000,
    1648: 112'he007cc7b000a20601c5003340380,
// WA.INIC
    1649: 112'h76710405000a20000052033002aa,    // a= WA.INIC
// INIFAT
    1650: 112'hb6730405000a2000005003300440,    // a= F1.INIC
// F1.INIC
    1651: 112'hb6740405000a2000005003300400,    // a= F2.INIC
// F2.INIC
    1652: 112'hb6750405000a2000005003300640,    // a= F3.INIC
// F3.INIC
    1653: 112'hb3cd0405000a2000005003300280,    // a= FATHLT
// INIMEM
    1654: 112'hb6770405000a2000005003300000,    // a= MEM.INIC
// MEM.INIC
    1655: 112'he0a5e475000a2061805003300400,
    1656: 112'he00bcc7b800a2060005003300640,
    1657: 112'he067ec7d800a2060005007320440,
    1658: 112'he067ec7e800a2064005003300280,
// WRM.INIC
    1659: 112'he000c405000a200014500c340000,
// WAW.INIC
    1660: 112'h367c27cd680a200000520f30002a,    // a= WAW.INIC
    1661: 112'he000ec3e820a20040050033b0840,
    1662: 112'he021c755680a2060005043300000,
    1663: 112'h367b0405000aa000005003300016,    // a= WRM.INIC
    1664: 112'he067ec7e800a2064005003300000,
// RDM.INIC
    1665: 112'he000c405000a200012500c340000,
// WAR.INIC
    1666: 112'h36820fce680a200000520330002a,    // a= WAR.INIC
    1667: 112'he000cc78000a2000005003a00000,
    1668: 112'he000ce58b80a2048205002320001,
    1669: 112'he000c718600a2000005043300000,
    1670: 112'h368c0710d80aa000005083300016,    // a= ERRMEM.INIC
    1671: 112'h368c04050012a000005003300016,    // a= ERRMEM.INIC
    1672: 112'he000ec3e820a20040050033b0840,
    1673: 112'he021c755680a2060005043300000,
    1674: 112'h36810405000aa000005003300016,    // a= RDM.INIC
// STP.INIC
    1675: 112'h368b0405000a2000005003300000,    // a= STP.INIC
// ERRMEM.INIC
    1676: 112'h368c2445380a20000050033b0840,    // a= ERRMEM.INIC
// JMPOPC
    1677: 112'h401f0e5fb80a2050005003300000,
    1678: 112'h8000c405000a2000005003300000,
    1679: 112'h36e50405000a200000500330028e,    // a= EMEML.JMPOPC
    1680: 112'he1a3c755780a2060005043300000,
    1681: 112'h34070405000a2000005003300016,    // a= IJP
    1682: 112'he1a4c755780a2060005043300000,
    1683: 112'h33d30405000a2000005003300016,    // a= RET
    1684: 112'he00bc755780a2060005043300000,
    1685: 112'h33c90405000a2000005003300016,    // a= HLT
    1686: 112'h36980e57380a2a48205009300011,    // a= CO/D.JMPOPC
    1687: 112'he000ce57380a3a48205009300001,
// CO/D.JMPOPC
    1688: 112'he0a3c755700a2060005043300000,
    1689: 112'h36da0405000a2000005003300016,    // a= DOF.JMPOPC
    1690: 112'he12cc755780a2060005043300000,
    1691: 112'h348c0405000a2000005003300016,    // a= A/U
    1692: 112'he12dc755780a2060005043300000,
    1693: 112'h345e0405000a2000005003300016,    // a= A*U
    1694: 112'he144c755780a2060005043300000,
    1695: 112'h36a20405000aa000005003300016,    // a= A*LOPC.JMPOPC
    1696: 112'h34ae0405000a200000520330001c,    // a= A/L
    1697: 112'h34b20405000a2000005003300000,    // a= A/LF
// A*LOPC.JMPOPC
    1698: 112'he145c755780a2060005043300000,
    1699: 112'h36a60405000aa000005003300016,    // a= A/HOPC.JMPOPC
    1700: 112'h34810405000a200000520330001c,    // a= A*L
    1701: 112'h34850405000a2000005003300000,    // a= A*LF
// A/HOPC.JMPOPC
    1702: 112'he165c755780a2060005043300000,
    1703: 112'h34b70405000a2000005003300016,    // a= A/H
    1704: 112'he166c755780a2060005043300000,
    1705: 112'h348a0405000a2000005003300016,    // a= A*H
    1706: 112'he18bc755780a2060005043300000,
    1707: 112'h36af0405000aa000005003300016,    // a= ABXOPC.JMPOPC
// ADXE.JMPOPC
    1708: 112'h34b90405000a200000520330001c,    // a= ADX
    1709: 112'h34be0405000a200000500330000e,    // a= ADXFE
    1710: 112'h34bd0405000a2000005003300000,    // a= ADXF
// ABXOPC.JMPOPC
    1711: 112'he18cc755780a2060005043300000,
    1712: 112'h36b40405000aa000005003300016,    // a= XBAOPC.JMPOPC
// ABXE.JMPOPC
    1713: 112'h354f0405000a200000520330001c,    // a= ABX
    1714: 112'h35550405000a200000500330000e,    // a= ABXFE
    1715: 112'h35540405000a2000005003300000,    // a= ABXF
// XBAOPC.JMPOPC
    1716: 112'he18dc755780a2060005043300000,
    1717: 112'h36b90405000aa000005003300016,    // a= AMXOPC.JMPOPC
// XBAE.JMPOPC
    1718: 112'h35590405000a200000520330001c,    // a= XBA
    1719: 112'h355f0405000a200000500330000e,    // a= XBAFE
    1720: 112'h355e0405000a2000005003300000,    // a= XBAF
// AMXOPC.JMPOPC
    1721: 112'he18ec755780a2060005043300000,
    1722: 112'h36be0405000aa000005003300016,    // a= AVXOPC.JMPOPC
// AMXE.JMPOPC
    1723: 112'h35630405000a200000520330001c,    // a= AMX
    1724: 112'h35700405000a200000500330000e,    // a= AMXFE
    1725: 112'h356f0405000a2000005003300000,    // a= AMXF
// AVXOPC.JMPOPC
    1726: 112'he18fc755780a2060005043300000,
    1727: 112'h36c30405000aa000005003300016,    // a= A/XOPC.JMPOPC
// AVXE.JMPOPC
    1728: 112'h35790405000a200000520330001c,    // a= AVX
    1729: 112'h357c0405000a200000500330000e,    // a= AVXFE
    1730: 112'h357b0405000a2000005003300000,    // a= AVXF
// A/XOPC.JMPOPC
    1731: 112'he072c755780a2060005043300000,
    1732: 112'h36c80405000aa000005003300016,    // a= A*XOPC.JMPOPC
// A/XE.JMPOPC
    1733: 112'h35af0405000a200000520330001c,    // a= A/X
    1734: 112'h35d10405000a200000500330000e,    // a= A/XFE
    1735: 112'h35d00405000a2000005003300000,    // a= A/XF
// A*XOPC.JMPOPC
    1736: 112'he190c755780a2060005043300000,
    1737: 112'h36cd0405000aa000005003300016,    // a= EDXOPC.JMPOPC
// A*XE.JMPOPC
    1738: 112'h35d50405000a200000520330001c,    // a= A*X
    1739: 112'h35e50405000a200000500330000e,    // a= A*XFE
    1740: 112'h35e40405000a2000005003300000,    // a= A*XF
// EDXOPC.JMPOPC
    1741: 112'he078c755780a2060005043300000,
    1742: 112'h36d20405000aa000005003300016,    // a= EBXOPC.JMPOPC
// EDXE.JMPOPC
    1743: 112'h36260405000a200000520330001c,    // a= EDX
    1744: 112'h362f0405000a200000500330000e,    // a= EDXFE
    1745: 112'h362e0405000a2000005003300000,    // a= EDXF
// EBXOPC.JMPOPC
    1746: 112'he079c755780a2060005043300000,
    1747: 112'h36d70405000aa000005003300016,    // a= OPCEXT.JMPOPC
// EBXE.JMPOPC
    1748: 112'h36330405000a200000520330001c,    // a= EBX
    1749: 112'h36360405000a200000500330000e,    // a= EBXFE
    1750: 112'h36350405000a2000005003300000,    // a= EBXF
// OPCEXT.JMPOPC
    1751: 112'he126c755780a2060005043300000,
    1752: 112'h30020405000a2000005003300016,    // a= EXT/
    1753: 112'h36e40405000a2000005003300000,    // a= NETNR.JMPOPC
// DOF.JMPOPC
    1754: 112'he14dc755780a2060005043300000,
    1755: 112'h34ac0405000a2000005003300016,    // a= A/I
    1756: 112'he14ec755780a2060005043300000,
    1757: 112'h347f0405000a2000005003300016,    // a= A*I
    1758: 112'he080c755780a2060005043300000,
    1759: 112'h363a0405000a2000005003300016,    // a= EDN
    1760: 112'he081c755780a2060005043300000,
    1761: 112'h36440405000a2000005003300016,    // a= EBN
    1762: 112'he127c755780a2060005043300000,
    1763: 112'h36460405000a2000005003300016,    // a= YTA
// NETNR.JMPOPC
    1764: 112'h30060405000a2000005003300000,    // a= EXTDR
// EMEML.JMPOPC
    1765: 112'he069c755780a2060005043300000,
    1766: 112'h36ac0405000a2000005003300016,    // a= ADXE.JMPOPC
    1767: 112'he06ac755780a2060005043300000,
    1768: 112'h36b10405000a2000005003300016,    // a= ABXE.JMPOPC
    1769: 112'he06bc755780a2060005043300000,
    1770: 112'h36b60405000a2000005003300016,    // a= XBAE.JMPOPC
    1771: 112'he06cc755780a2060005043300000,
    1772: 112'h36bb0405000a2000005003300016,    // a= AMXE.JMPOPC
    1773: 112'he071c755780a2060005043300000,
    1774: 112'h36c00405000a2000005003300016,    // a= AVXE.JMPOPC
    1775: 112'he072c755780a2060005043300000,
    1776: 112'h36c50405000a2000005003300016,    // a= A/XE.JMPOPC
    1777: 112'he073c755780a2060005043300000,
    1778: 112'h36ca0405000a2000005003300016,    // a= A*XE.JMPOPC
    1779: 112'he078c755780a2060005043300000,
    1780: 112'h36cf0405000a2000005003300016,    // a= EDXE.JMPOPC
    1781: 112'he079c755780a2060005043300000,
    1782: 112'h36d40405000a2000005003300016,    // a= EBXE.JMPOPC
    1783: 112'he080c755780a2060005043300000,
    1784: 112'h363a0405000a2000005003300016,    // a= EDN
    1785: 112'he081c755780a2060005043300000,
    1786: 112'h36440405000a2000005003300016,    // a= EBN
    1787: 112'he07dc755780a2060005043300000,
    1788: 112'h36460405000a2000005003300016,    // a= YTA
    1789: 112'h30030405000a2000005003300000,    // a= EXT6
// ENDJOP
// RW/IO
    1790: 112'h377c0c76800a2008005003300000,    // a= WMODIF
    1791: 112'h377f0c76800a1b48205003360001,    // a= WPSMEM
    1792: 112'h37810c76800a1b48205003360001,    // a= WBB
    1793: 112'h37830c76800a1b48205003360001,    // a= WMODB
    1794: 112'h37850c76800a1b48205003360001,    // a= WPPM0
    1795: 112'h37870c76800a1b48205003360001,    // a= WPPM1
    1796: 112'h70004c49000a200000510330701e,
    1797: 112'h37890c76800a3680005023300000,    // a= PSWRT3
    1798: 112'h70006445000a200080510330701e,
    1799: 112'h70006445000a200100510330701e,
    1800: 112'h378c0405000a2000005003300000,    // a= PSWMP
    1801: 112'h37912445000a2002005003300000,    // a= PSWCOR
    1802: 112'h70384dd9100a206000510330779e,
    1803: 112'h3796287d800a08482050433002c1,    // a= PSWT
    1804: 112'h379b0445000a2000005043300000,    // a= PSWTT
    1805: 112'h70004405000a20000051033077de,
    1806: 112'h70004405000a200500510330701e,
    1807: 112'h37a40c76800a2008005003300000,    // a= RMODIF
    1808: 112'h37a70c76800a1b48205003360001,    // a= RPSMEM
    1809: 112'h37a90c76800a1b48205003360001,    // a= RBB
    1810: 112'h37ab0c76800a1b48205003360001,    // a= RMODB
    1811: 112'h37ad0c76800a1b48205003360001,    // a= RPPM0
    1812: 112'h37af0c76800a1b48205003360001,    // a= RPPM1
    1813: 112'h70004c48100a200000518330701e,
    1814: 112'h70004e58380a204820518332701f,
    1815: 112'h37b10405000a2000005003300000,    // a= PSRMGN
    1816: 112'h70004e58380a201000518330701e,
    1817: 112'h37b30e5fb00a34800050233002c0,    // a= PSRT
    1818: 112'h37b72a58300a18482050033002c1,    // a= PSRTT
    1819: 112'h37b90405000a2000005003300000,    // a= PSRCMP
    1820: 112'h71a84c78000a206000518330701e,
    1821: 112'h37bd0c76800a2008005003300000,    // a= MMODIF
    1822: 112'h37c20c76800a1b48205003360001,    // a= MPSMEM
    1823: 112'h37c60c76800a1b48205003360001,    // a= MBB
    1824: 112'h37ca0c76800a1b48205003360001,    // a= MMODB
    1825: 112'h37ce0c76800a1b48205003360001,    // a= MPPM0
    1826: 112'h37d20c76800a1b48205003360001,    // a= MPPM1
    1827: 112'h37d6287f780a0f48205003300001,    // a= MCC
    1828: 112'h37e1287f780a0f48205003300001,    // a= MDC
    1829: 112'ha000cc48500a2000005003300280,
    1830: 112'ha000cc48d00a2000005003300280,
    1831: 112'ha000cc49500a2000005003300280,
    1832: 112'h38522c41d00a2004005003300280,    // a= LCWPH
    1833: 112'ha000cc42500a2000005003300280,
    1834: 112'ha000cc42d00a2000005003300280,
    1835: 112'ha000cc4b500a2000005003300280,
    1836: 112'ha000cc4bd00a2000005003300280,
    1837: 112'ha000cc4c500a2000005003300280,
    1838: 112'ha000cc4cd00a2000005003300280,
    1839: 112'ha000c405000a2000005003300280,
    1840: 112'ha000cc4dd00a2000005003300280,
    1841: 112'ha000cc4e500a2000005003300280,
    1842: 112'ha000cc4ed00a2000005003300280,
    1843: 112'ha000cc4f500a2000005003300280,
    1844: 112'ha000c04d500a2000005003300280,
    1845: 112'ha000e44d500a200000500c300280,
    1846: 112'ha000e44d500a200000500d300280,
    1847: 112'ha000e44d500a200000500e300280,
    1848: 112'ha000e44d500a200000500f300280,
    1849: 112'ha000e445500a2000005005320280,
    1850: 112'ha000e445500a2000005006320280,
    1851: 112'h37ec0c76800a3680005023300000,    // a= PSIRT3
    1852: 112'ha000e445500a2004005003300280,
    1853: 112'ha000e445500a2000805003300280,
    1854: 112'ha000e445500a2001005003300280,
    1855: 112'ha000e445500a2002005003300280,
    1856: 112'h37ef2445500a2001805003300000,    // a= PSICNT
    1857: 112'ha000e445500a2004805003300280,
    1858: 112'ha000e445500a2002805003300280,
    1859: 112'h37f22445500020000050c330b000,    // a= PSIN
    1860: 112'ha000e4455000200000508330b280,
    1861: 112'hb7f30405000a20000050033005c0,    // a= PSIMI
    1862: 112'h37f62445500a2002005003300000,    // a= PSICOR
    1863: 112'h37fb2445500a2004005003300000,    // a= PSSS0
    1864: 112'h37fc2445500a2004005003300000,    // a= PSCS0
    1865: 112'h37fd2445500a2004005003300000,    // a= PSSS1
    1866: 112'h37fe2445500a2004005003300000,    // a= PSCS1
    1867: 112'h37ff0e5fb00a2000005003900000,    // a= PSILC
    1868: 112'h38010c7f800a2000005003900000,    // a= PSIRC
    1869: 112'hb8030405000a2000005003300480,    // a= PSRUNL
    1870: 112'hb8060405000a2000005003300480,    // a= PSRUNA
    1871: 112'h38090405000a2000005003300780,    // a= PSPINT
    1872: 112'h380a287dd00a0848205043300001,    // a= PSIT
    1873: 112'h380f0445500a2000005043300000,    // a= PSITT
    1874: 112'h37e80405000a20000050033007c0,    // a= OUTINP
    1875: 112'ha000c405000a2005005003300280,
    1876: 112'h7000cc4d000a2000005203300000,
    1877: 112'h7000cc4d080a2000005203300000,
    1878: 112'h7000cc4d100a2000005203300000,
    1879: 112'h7007ce5d180a2060005203300000,
    1880: 112'h7007ce5d200a2060005203300000,
    1881: 112'h7007ce5d280a2060005203300000,
    1882: 112'h7000cc4d300a2000005203300000,
    1883: 112'h7000cc4d380a2000005203300000,
    1884: 112'h7000cc4d400a2000005203300000,
    1885: 112'h7000cc4d480a2000005203300000,
    1886: 112'h7000c405000a2000005203300000,
    1887: 112'h7000cc4d580a2000005203300000,
    1888: 112'h7000cc4d600a2000005203300000,
    1889: 112'h7000cc4d680a2000005203300000,
    1890: 112'h7000cc4d700a2000005203300000,
    1891: 112'h7000cc2d000a2000005203300000,
    1892: 112'h7000cc7d000a2000005203800000,
    1893: 112'h7000cc7d000a2000005203900000,
    1894: 112'h7000cc7d000a2000005203a00000,
    1895: 112'h7000cc7d000a2000005203b00000,
    1896: 112'h7000ce5d380a2048205201320001,
    1897: 112'h7000ce5d380a2048205202320001,
    1898: 112'h7000ce5d380a2048205203320001,
    1899: 112'h38170c75000a2048205003360001,    // a= PSOADR
    1900: 112'h38180c75000a2008005003300000,    // a= PSOMGN
    1901: 112'h7000ce5d380a2010005203300000,
    1902: 112'h38190c75000a2020005003300000,    // a= PSOPHP
    1903: 112'h381a0c75000a2018005003300000,    // a= PSOCNT
    1904: 112'h381b0c75000a2028005003300000,    // a= PSOARB
    1905: 112'h381c0c75000a200000500330a000,    // a= PSOIND
    1906: 112'h381c0c750010200000500330a000,    // a= PSOIND
    1907: 112'h381d287d000a2058005003300000,    // a= PSOLOS
    1908: 112'h7000e87d000a2048205203300000,
    1909: 112'h7000ce5d380a2050005203300000,
    1910: 112'h7000ce5d300a2040005203300000,
    1911: 112'h381e025d300a3480005023300000,    // a= PSOT
    1912: 112'h38222a5d300a1848205003300001,    // a= PSOTT
    1913: 112'h71a8cc7d000a2060005203300000,
    1914: 112'h70004c42000a200000510330701e,
    1915: 112'h70074e58200a206000518330701e,
// PSRWIO
// WMODIF
    1916: 112'he000c405000a2000805003360000,
    1917: 112'he000e445000a4000005033300000,
    1918: 112'h70006445680a200080510330701e,
// WPSMEM
    1919: 112'he000e445680a2004005003300000,
    1920: 112'h70006445000a200000510339701e,
// WBB
    1921: 112'he000e445680a2002005003306000,
    1922: 112'h70006445000a204820d10330301f,
// WMODB
    1923: 112'he000e445680a2002005003306000,
    1924: 112'h70006445000a204820d10330501f,
// WPPM0
    1925: 112'he000e445680a2002005003306000,
    1926: 112'h70006445000a200000d10330d01e,
// WPPM1
    1927: 112'he000e445680a2002005003307000,
    1928: 112'h70006445000a200000d10330f01e,
// PSWRT3
    1929: 112'he00cce56e80a2060005003300000,
    1930: 112'he00bce56000a2060005003300000,
    1931: 112'h70006596680a368000513732701e,
// PSWMP
    1932: 112'h378c0405000a200000520330002e,    // a= PSWMP
    1933: 112'he000e445000a20000050033b0800,
    1934: 112'he000cc7d000a20482050033a0881,
    1935: 112'he017e5d5500a20600050033b0880,
    1936: 112'h70004405000a200000510330775e,
// PSWCOR
    1937: 112'he067c405000a2060005003305000,
    1938: 112'he000c405000a2000005003300540,
// WELLD.PSRWIO
    1939: 112'h37930405000a2000005203300028,    // a= WELLD.PSRWIO
    1940: 112'he01ae475000a2062005003307000,
    1941: 112'h70006645000a200000d10330d01e,
// PSWT
    1942: 112'h37992c4d800ab48000503f300016,    // a= NZ16.PSRWIO
    1943: 112'he020e4dd020a34e000503f300000,
    1944: 112'he000cc45b00a2000005003300000,
// NZ16.PSRWIO
    1945: 112'h14220c7f800a304820500b300001,    // a= CTWR
    1946: 112'h70006445780a350000513330729e,
// PSWTT
    1947: 112'h37a02c45800a3580005033300016,    // a= PROGW.PSRWIO
    1948: 112'he009c655000a2060005043300000,
    1949: 112'h37a20405000aa000005003300016,    // a= ATCT.PSRWIO
    1950: 112'he020e4d5020a35e0005033300000,
    1951: 112'h37a20c45b00a2000005003300000,    // a= ATCT.PSRWIO
// PROGW.PSRWIO
    1952: 112'he037cdd9100a2060005003300780,
    1953: 112'he000ec45b00a3580005033300000,
// ATCT.PSRWIO
    1954: 112'h143b0405000a20000050033002c0,    // a= CTTWR
    1955: 112'h70004405000a200000510330729e,
// RMODIF
    1956: 112'he000c405000a2000805003360000,
    1957: 112'he000ce58300a40000050a3300000,
    1958: 112'h70006445680a200080510330701e,
// RPSMEM
    1959: 112'he061e87f680a2064005003300000,
    1960: 112'h70004e58700a204820518338701f,
// RBB
    1961: 112'he06be87f680a2062005003307000,
    1962: 112'h70004e58700a200000d18330201e,
// RMODB
    1963: 112'he067e87f680a2062005003307000,
    1964: 112'h70004e58700a200000d18330401e,
// RPPM0
    1965: 112'he059e87f680a2062005003307000,
    1966: 112'h70004e58700a200000d18330c01e,
// RPPM1
    1967: 112'he059e87f680a2062005003307000,
    1968: 112'h70004e58700a200000d18330e01e,
// PSRMGN
    1969: 112'he0ddcc7e800a2060005003300000,
    1970: 112'h70004e58680a200800518330701e,
// PSRT
    1971: 112'he000c405000a3500005023f00000,
    1972: 112'h142e0ddff80a104820500b300001,    // a= CTRD
    1973: 112'he00ace58780a2060005003300000,
    1974: 112'h70004d98580a200000518330729e,
// PSRTT
    1975: 112'h14470e58000a3580005023300000,    // a= CTTRD
    1976: 112'h70004d98580a200000518330729e,
// PSRCMP
    1977: 112'h37bb0405000120000050c330002e,    // a= SWCP.PSRWIO
    1978: 112'h37bc04050005a000005043300000,    // a= WMCP.PSRWIO
// SWCP.PSRWIO
    1979: 112'he000c40500052000005043300000,
// WMCP.PSRWIO
    1980: 112'h70004405000120000051c330701e,
// MMODIF
    1981: 112'h37c00405000aa000805003360016,    // a= OMODIF.PSRWIO
    1982: 112'he000e445500a4000005033300000,
    1983: 112'ha000e445680a2000805003300280,
// OMODIF.PSRWIO
    1984: 112'he000ce5d300a4000005023300000,
    1985: 112'h7000e445680a2000805203300000,
// MPSMEM
    1986: 112'h37c42445680aa004005003300016,    // a= OPSMEM.PSRWIO
    1987: 112'ha000e445500a2000005003390280,
// OPSMEM.PSRWIO
    1988: 112'he061cc7d000a2060005003300000,
    1989: 112'h7000ce5d500a2048205203380001,
// MBB
    1990: 112'h37c82445680aa002005003300016,    // a= OBB.PSRWIO
    1991: 112'ha000e445500a2048205003303281,
// OBB.PSRWIO
    1992: 112'he06be87d680a2062005003300000,
    1993: 112'h7000ce5d500a2000005203302000,
// MMODB
    1994: 112'h37cc2445680aa002005003300016,    // a= OMODB.PSRWIO
    1995: 112'ha000e445500a2048205003305281,
// OMODB.PSRWIO
    1996: 112'he067cc7d000a2060005003300000,
    1997: 112'h7000ce5d500a2000005203304000,
// MPPM0
    1998: 112'h37d02445680aa002005003300016,    // a= OPPM0.PSRWIO
    1999: 112'ha000e445500a200000500330d280,
// OPPM0.PSRWIO
    2000: 112'he059cc7d000a2060005003300000,
    2001: 112'h7000ce5d500a200000520330c000,
// MPPM1
    2002: 112'h37d42445680aa002005003300016,    // a= OPPM1.PSRWIO
    2003: 112'ha000e445500a200000500330f280,
// OPPM1.PSRWIO
    2004: 112'he059cc7d000a2060005003300000,
    2005: 112'h7000ce5d500a200000520330e000,
// MCC
    2006: 112'he000e87f700a3648405003300001,
    2007: 112'he05acedf700a2060005003300000,
    2008: 112'he05ace57f80a2060005003300000,
    2009: 112'h37de2d97f00aa004005003300016,    // a= OCC.PSRWIO
    2010: 112'he000e44d500a200000500d300000,
    2011: 112'he000c405000a200004500c340000,
// WAI.PSRWIO
    2012: 112'h37dc0405000a200000520330002a,    // a= WAI.PSRWIO
    2013: 112'ha000c405000a2000005003300280,
// OCC.PSRWIO
    2014: 112'he000c405000a200002500c340000,
// WAO.PSRWIO
    2015: 112'h37df0405000a200000520330002a,    // a= WAO.PSRWIO
    2016: 112'h7000cc7d000a2000005203900000,
// MDC
    2017: 112'he000e87f700a3648405003300001,
    2018: 112'he05acedf700a2060005003300000,
    2019: 112'he05ace57f80a2060005003300000,
    2020: 112'h37e92d97780aa004005003300016,    // a= ODC.PSRWIO
    2021: 112'he000e44d500a200000500f300000,
    2022: 112'he000c405000a200008500c340000,
// WAID.PSRWIO
    2023: 112'h37e70405000a200000520330002a,    // a= WAID.PSRWIO
// OUTINP
    2024: 112'ha000c405000a2000005003300280,
// ODC.PSRWIO
    2025: 112'he000c405000a200006500c340000,
// WAOD.PSRWIO
    2026: 112'h37ea0405000a200000520330002a,    // a= WAOD.PSRWIO
    2027: 112'h7000cc7d000a2000005203a00000,
// PSIRT3
    2028: 112'he00cce56e80a2060005003300000,
    2029: 112'he00bce56500a2060005003300000,
    2030: 112'ha000e596680a3680005037320280,
// PSICNT
    2031: 112'h37f10405000a2000005003300290,    // a= CNTR.PSRWIO
    2032: 112'ha000c405000a2000005003300480,
// CNTR.PSRWIO
    2033: 112'ha000c405000a20000050033004c0,
// PSIN
    2034: 112'ha000c405000120000050c3300280,
// PSIMI
    2035: 112'hb7f40405000a2000005003300640,    // a= G1.PSRWIO
// G1.PSRWIO
    2036: 112'hc8580405000a2000005003306280,    // a= LCW
    2037: 112'h70004075000a204000d10330021e,
// PSICOR
    2038: 112'he067c405000a2060005003305000,
    2039: 112'he000c405000a2000005003300540,
// WELFLL.PSRWIO
    2040: 112'h37f80405000a2000005203300028,    // a= WELFLL.PSRWIO
    2041: 112'he01ae475000a2062005003300000,
    2042: 112'ha000e645000a200000500330d280,
// PSSS0
    2043: 112'ha001e475000a20600050033d0280,
// PSCS0
    2044: 112'ha067e475000a20600050033d0280,
// PSSS1
    2045: 112'ha001e475000a20600050033f0280,
// PSCS1
    2046: 112'ha067e475000a20600050033f0280,
// PSILC
    2047: 112'he000e87d500a1048205003300001,
// PSLRC.PSRWIO
    2048: 112'ha000e59d780a200000500d300280,
// PSIRC
    2049: 112'he008ce5ff80a2060005003300000,
    2050: 112'h38000e1d300a2000005003300000,    // a= PSLRC.PSRWIO
// PSRUNL
    2051: 112'hb8040405000a2000005003300180,    // a= L1.PSRWIO
// L1.PSRWIO
    2052: 112'hb8050405000a2000005003306640,    // a= L2.PSRWIO
// L2.PSRWIO
    2053: 112'hb0004075000a204000d003300280,
// PSRUNA
    2054: 112'hb8070405000a2000005003306180,    // a= R1.PSRWIO
// R1.PSRWIO
    2055: 112'hb8080405000a2000005003300640,    // a= R2.PSRWIO
// R2.PSRWIO
    2056: 112'hb8522c41d00a2004005003300280,    // a= LCWPH
// PSPINT
    2057: 112'ha038cdd9100a2060005003300280,
// PSIT
    2058: 112'h380d2c4dd00ab48000503f300016,    // a= INZ16.PSRWIO
    2059: 112'he020e4dd520a34e000503f300000,
    2060: 112'he000cc45b00a2000005003300000,
// INZ16.PSRWIO
    2061: 112'h14220c7f800a304820500b300001,    // a= CTWR
    2062: 112'ha000e445780a3500005033300280,
// PSITT
    2063: 112'h38142c45d00a3580005033300016,    // a= PRGP.PSRWIO
    2064: 112'he009c655500a2060005043300000,
    2065: 112'h38160405000aa000005003300016,    // a= PTCT.PSRWIO
    2066: 112'he020e4d5520a35e0005033300000,
    2067: 112'h38160c45b00a2000005003300000,    // a= PTCT.PSRWIO
// PRGP.PSRWIO
    2068: 112'he037cdd9100a2060005003300780,
    2069: 112'he000ec45b00a3580005033300000,
// PTCT.PSRWIO
    2070: 112'h343b0405000a2000005003300280,    // a= CTTWR
// PSOADR
    2071: 112'h7061ce5d500a2060005203300000,
// PSOMGN
    2072: 112'h70ddce5d500a2060005203300000,
// PSOPHP
    2073: 112'h7059ce5d500a2060005203300000,
// PSOCNT
    2074: 112'h70d3ce5d500a2060005203300000,
// PSOARB
    2075: 112'h7073ce5d500a2060005203300000,
// PSOIND
    2076: 112'h70d4ce5d500a2060005203300000,
// PSOLOS
    2077: 112'h7065ce5d500a2060005203300000,
// PSOT
    2078: 112'he000cc77800a3500005023300000,
    2079: 112'h142e29eff80a1048205003300001,    // a= CTRD
    2080: 112'he00ace5d780a2060005003300000,
    2081: 112'h38240c1d580a2000005003300000,    // a= RGTOMP
// PSOTT
    2082: 112'h14470e5d500a3580005023300000,    // a= CTTRD
    2083: 112'h38240d9d580a2000005003300000,    // a= RGTOMP
// RGTOMP
    2084: 112'he000e87d500a24482050033b0bc1,
    2085: 112'he000e87d500a24482050033b0b81,
    2086: 112'he000e87d500a24482050033b0b41,
    2087: 112'he000e87d500a24482050033b0b01,
    2088: 112'he000e87d500a24482050033b0ac1,
    2089: 112'he000e87d500a24482050033b0a81,
    2090: 112'he000e87d500a24482050033b0a41,
    2091: 112'he000e44d500a20000050033b0a00,
    2092: 112'he000cc75000a20482050033a08c1,
    2093: 112'he067e5d5500a20600050033b08c0,
    2094: 112'ha000c405000a2000005003300280,
// SE80
// ENDPS
    2095: 112'he000c405000a2000005003300000,
// SEC0
    2096: 112'he000c405000a2000005003300000,
// SEE8
    2097: 112'he000c405000a2000005003300000,
// /CONT2
    2098: 112'he000c405000a2000005003300000,
// AB1.LOGERG
// LOGERG
    2099: 112'h3844287ff8121e48405003300017,    // a= WO.LOGERG
// WAI.LOGERG
    2100: 112'h38340405000a200000520330002a,    // a= WAI.LOGERG
    2101: 112'h394f0e7a800a2000005003300000,    // a= INT37
// OB1.LOGERG
    2102: 112'ha000e87f70121e48405003300017,
    2103: 112'h394f0405000a2000005003300000,    // a= INT37
// PSNOAN.LOGERG
    2104: 112'ha00ace5f700a2060005003300000,
// LOGER
    2105: 112'he0decedf800a206012504c3405c0,
// LOGER1
    2106: 112'h38400075000a2040005003300014,    // a= PSLOG.LOGERG
    2107: 112'he0cccc7d000a2060005003300200,
    2108: 112'h3833021d000f2000005083300016,    // a= AB1.LOGERG
    2109: 112'he000c70d500a2000005043300000,
    2110: 112'h3844287ff80a1e48405003300017,    // a= WO.LOGERG
    2111: 112'h38440e7f800a2000005003300000,    // a= WO.LOGERG
// PSLOG.LOGERG
    2112: 112'hc858287ff80a1e48405003300201,    // a= LCW
    2113: 112'ha000c405000a2000005003300058,
// WAAN.LOGERG
    2114: 112'h38420405000a200000520330002a,    // a= WAAN.LOGERG
    2115: 112'h38380c7f000a1e4840500a300001,    // a= PSNOAN.LOGERG
// WO.LOGERG
    2116: 112'h48580075000a2040005003300040,    // a= LCW
    2117: 112'hd0decfff000a206000500330002a,
    2118: 112'ha000ce5f700a2000005043a00018,
    2119: 112'h38360e1d700f2000005083300016,    // a= OB1.LOGERG
    2120: 112'he0ccc75d500a2060005043300000,
    2121: 112'ha000e87f700a1e48405003300017,
    2122: 112'ha000ce7f000a2000005003300000,
// YTAMUL
// YTAZER
// YTAPNA
// YTAADD
    2123: 112'h36490405000a2000005003300000,    // a= YTAD
// YTALOG
    2124: 112'h364c0405000a2000005003300000,    // a= YTAL
// JQ
// LCWPRG
    2125: 112'h30004075000a204000d003300000,
// JIQ
    2126: 112'h30004075000a2040005103307200,
// LCWISE
    2127: 112'h38580405000a2000005103306200,    // a= LCW
// LCWJE
    2128: 112'he000cc42180a2000005103306240,
    2129: 112'he0d1ee61800a2064005003300380,
// LCWPH
    2130: 112'he000c405000a200010500c340000,
// LCWWA.LCWPRG
    2131: 112'h38530405000a200000520330002a,    // a= LCWWA.LCWPRG
    2132: 112'h384d0405000a20000051033003c0,    // a= JQ
// UZAADD
    2133: 112'he044c65d000a2060005043300380,
// JNZ
// UZAZER
    2134: 112'h385b0c22800a20000050033005d6,    // a= LCWJMP
// NXTC.LCWPRG
    2135: 112'h30004075000a204000510330739e,
// LCW
    2136: 112'h38522c31820a2004005003300380,    // a= LCWPH
// UIAADD
    2137: 112'he044c65d000a2060005043300380,
// JNNZ
    2138: 112'h38570c22800a20000050033005d6,    // a= NXTC.LCWPRG
// UIAZER
// LCWJMP
    2139: 112'h38500c22800a200000500330048e,    // a= LCWJE
// LCWJ1
    2140: 112'he000cc42180a2000005103306240,
    2141: 112'h38522c21800a2004005003300380,    // a= LCWPH
// UZAMUL
// UZAPNA
    2142: 112'h704fc65d000a2060005243300380,
// UZALOG
    2143: 112'h3856044d000a200000524330038e,    // a= JNZ
    2144: 112'h3856061f800a2000005043300000,    // a= JNZ
// UIAMUL
// UIAPNA
    2145: 112'h704fc65d000a2060005243300380,
// UIALOG
    2146: 112'h385a044d000a200000524330038e,    // a= JNNZ
    2147: 112'h385a061f800a2000005043300000,    // a= JNNZ
// UZSADD
// UZSPNA
    2148: 112'ha044c65d000a2060005083300000,
// UZSZER
    2149: 112'ha000c405000a2000005003300000,
// UZSMUL
    2150: 112'he04fc65d000a2060005083300000,
    2151: 112'ha000c4050002a000005083300000,
// UZSLOG
    2152: 112'ha000c44d000a2000005083300000,
// INT/RE
// ENDUZS
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
