besm6/micro-besm/microcode/optab.v

// ПНА: память начальных адресов машинных инструкций
'h0_00:  107,   // ATX
'h0_01:  116,   // STX
'h0_03:  127,   // XTS
'h0_08:  136,   // XTA
'h0_09:  142,   // AAX
'h0_0a:  148,   // AEX
'h0_0b:  155,   // ARX
'h0_0d:  163,   // AOX
'h0_0e: 1455,   // A/X
'h0_10:  169,   // APX
'h0_11:  181,   // AUX
'h0_12:  195,   // ACX
'h0_13:  209,   // ANX
'h0_14: 1574,   // EDX
'h0_15: 1587,   // EBX
'h0_16:  222,   // ASX
'h0_18:  269,   // JAMP
'h0_19:  270,   // VJM
'h0_1b:  273,   // VLM
'h0_20:  271,   // JMEQ
'h0_21:  272,   // JMNE
'h0_22:  416,   // JMGE
'h0_23:  419,   // JMLT
'h0_24:  422,   // JMLE
'h0_25:  425,   // JMGT
'h0_3b:  253,   // WTC
'h0_3c:  260,   // VTM
'h0_3d:  262,   // UTM
'h0_43:  316,   // UTS
'h0_48:  287,   // UTA
'h0_49:  290,   // AAU
'h0_4a:  293,   // AEU
'h0_4d:  296,   // AOU
'h0_52:  299,   // ACU
'h0_53:  307,   // ANU
'h0_80:    2,   // EXT/
'h0_81:  277,   // ADU
'h0_82:  281,   // ABU
'h0_83:  284,   // UBA
'h0_86: 1164,   // A/U
'h0_87: 1118,   // A*U
'h0_88:  313,   // UTY
'h0_90:  729,   // UTC
'h0_94:  322,   // XTY
'h0_95:  328,   // YAX
'h0_96:  334,   // YEX
'h0_97:  340,   // YOX
'h0_98:  346,   // YTX
'h0_99:  484,   // ADL
'h0_9a:  490,   // ABL
'h0_9b:  496,   // LBA
'h0_9e: 1198,   // A/L
'h0_9f: 1153,   // A*L
'h0_a0:  373,   // VTMH
'h0_a1:  376,   // VTMQ
'h0_a2:  378,   // VTMB
'h0_a3:  380,   // VTMF
'h0_a4:  382,   // UTCS
'h0_a9:  428,   // VRM
'h0_aa:  432,   // UZAS
'h0_ab:  438,   // UIAS
'h0_ac:  442,   // JOVR
'h0_ad:  445,   // JCRY
'h0_ae:  448,   // JAGT
'h0_af:  451,   // JAGE
'h0_b0:  454,   // JALT
'h0_b1:  457,   // JALE
'h0_b2:  460,   // JAEQ
'h0_b3:  463,   // JANE
'h0_b5:  466,   // JMPS
'h0_b6:  502,   // ATH
'h0_b7:  519,   // STH
'h0_b8:  520,   // HTA
'h0_b9:  531,   // HTS
'h0_ba:  536,   // ADH
'h0_bb:  538,   // ABH
'h0_bc:  540,   // HBAC
'h0_bf: 1207,   // A/H
'h0_c0: 1162,   // A*H
'h0_c1:  542,   // AAH
'h0_c2:  544,   // AEH
'h0_c3:  546,   // AOH
'h0_c4:  548,   // ATQ
'h0_c5:  554,   // STQ
'h0_c6:  555,   // QTA
'h0_c7:  562,   // QTS
'h0_c8:  567,   // AEQ
'h0_c9:  569,   // AAQ
'h0_ca:  571,   // AOQ
'h0_cb:  573,   // ATB
'h0_cc:  579,   // STB
'h0_cd:  580,   // BTA
'h0_ce:  587,   // BTS
'h0_cf:  592,   // AEB
'h0_d0:  594,   // AAB
'h0_d1:  596,   // AOB
'h0_d2:  598,   // ATF
'h0_d3:  603,   // STF
'h0_d4:  604,   // FTA
'h0_d5:  613,   // FTS
'h0_d6:  618,   // AEF
'h0_d7:  620,   // AAF
'h0_d8:  622,   // AOF
'h0_d9:  624,   // SETF
'h0_da:  635,   // CLRF
'h0_db:  732,   // XTR
'h0_dc:  665,   // ATD
'h0_dd:  680,   // DTA
'h0_e5: 1209,   // ADX
'h0_e6: 1359,   // ABX
'h0_e7: 1369,   // XBA
'h0_e8: 1379,   // AMX
'h0_e9: 1401,   // AVX
'h0_ea: 1493,   // A*X
'h0_eb:  263,   // UZA
'h0_ec:  266,   // UIA
'h0_f0:  692,   // RMOD
'h0_f1:  876,   // WMOD
'h0_f2:  880,   // SETR
'h0_f3:  888,   // CLRR
'h0_f4:  891,   // SEMR
'h0_f5:  945,   // TTX
'h0_f6:  958,   // TTA
'h0_f7:  904,   // SEMW
'h0_f8:  913,   // SMON
'h0_f9:  928,   // CMON
'h1_00: 2390,   // ADDC
'h1_01: 2390,   // ADDC
'h1_02: 2390,   // ADDC
'h1_03: 2390,   // ADDC
'h1_04: 2390,   // ADDC
'h1_05: 2390,   // ADDC
'h1_06: 2390,   // ADDC
'h1_07: 2390,   // ADDC
'h1_08: 2390,   // ADDC
'h1_09: 2390,   // ADDC
'h1_0a: 2390,   // ADDC
'h1_0b: 2390,   // ADDC
'h1_0c: 2390,   // ADDC
'h1_0d: 2390,   // ADDC
'h1_0e: 2390,   // ADDC
'h1_0f: 2390,   // ADDC
'h1_10: 2390,   // ADDC
'h1_11: 2390,   // ADDC
'h1_12: 2390,   // ADDC
'h1_13: 2390,   // ADDC
'h1_14: 2390,   // ADDC
'h1_15: 2390,   // ADDC
'h1_16: 2390,   // ADDC
'h1_17: 2390,   // ADDC
'h1_18: 2390,   // ADDC
'h1_19: 2390,   // ADDC
'h1_1a: 2390,   // ADDC
'h1_1b: 2390,   // ADDC
'h1_1c: 2390,   // ADDC
'h1_1d: 2390,   // ADDC
'h1_1e: 2390,   // ADDC
'h1_1f: 2390,   // ADDC
'h1_20: 2390,   // ADDC
'h1_21: 2390,   // ADDC
'h1_22: 2390,   // ADDC
'h1_23: 2390,   // ADDC
'h1_24: 2390,   // ADDC
'h1_25: 2390,   // ADDC
'h1_26: 2390,   // ADDC
'h1_27: 2390,   // ADDC
'h1_28: 2390,   // ADDC
'h1_29: 2390,   // ADDC
'h1_2a: 2390,   // ADDC
'h1_2b: 2390,   // ADDC
'h1_2c: 2390,   // ADDC
'h1_2d: 2390,   // ADDC
'h1_2e: 2390,   // ADDC
'h1_2f: 2390,   // ADDC
'h1_30: 2390,   // ADDC
'h1_31: 2390,   // ADDC
'h1_32: 2390,   // ADDC
'h1_33: 2390,   // ADDC
'h1_34: 2390,   // ADDC
'h1_35: 2390,   // ADDC
'h1_36: 2390,   // ADDC
'h1_37: 2390,   // ADDC
'h1_38: 2390,   // ADDC
'h1_39: 2390,   // ADDC
'h1_3a: 2390,   // ADDC
'h1_3b: 2390,   // ADDC
'h1_3c: 2390,   // ADDC
'h1_3d: 2390,   // ADDC
'h1_3e: 2390,   // ADDC
'h1_3f: 2390,   // ADDC
'h1_40: 2390,   // ADDC
'h1_41: 2390,   // ADDC
'h1_42: 2390,   // ADDC
'h1_43: 2390,   // ADDC
'h1_44: 2390,   // ADDC
'h1_45: 2390,   // ADDC
'h1_46: 2390,   // ADDC
'h1_47: 2390,   // ADDC
'h1_48: 2390,   // ADDC
'h1_49: 2390,   // ADDC
'h1_4a: 2390,   // ADDC
'h1_4b: 2390,   // ADDC
'h1_4c: 2390,   // ADDC
'h1_4d: 2390,   // ADDC
'h1_4e: 2390,   // ADDC
'h1_4f: 2390,   // ADDC
'h1_50: 2390,   // ADDC
'h1_51: 2390,   // ADDC
'h1_52: 2390,   // ADDC
'h1_53: 2390,   // ADDC
'h1_54: 2390,   // ADDC
'h1_55: 2390,   // ADDC
'h1_56: 2390,   // ADDC
'h1_57: 2390,   // ADDC
'h1_58: 2390,   // ADDC
'h1_59: 2390,   // ADDC
'h1_5a: 2390,   // ADDC
'h1_5b: 2390,   // ADDC
'h1_5c: 2390,   // ADDC
'h1_5d: 2390,   // ADDC
'h1_5e: 2390,   // ADDC
'h1_5f: 2390,   // ADDC
'h1_60: 2390,   // ADDC
'h1_61: 2390,   // ADDC
'h1_62: 2390,   // ADDC
'h1_63: 2390,   // ADDC
'h1_64: 2390,   // ADDC
'h1_65: 2390,   // ADDC
'h1_66: 2390,   // ADDC
'h1_67: 2390,   // ADDC
'h1_68: 2390,   // ADDC
'h1_69: 2390,   // ADDC
'h1_6a: 2390,   // ADDC
'h1_6b: 2390,   // ADDC
'h1_6c: 2390,   // ADDC
'h1_6d: 2390,   // ADDC
'h1_6e: 2390,   // ADDC
'h1_6f: 2390,   // ADDC
'h1_70: 2390,   // ADDC
'h1_71: 2390,   // ADDC
'h1_72: 2390,   // ADDC
'h1_73: 2390,   // ADDC
'h1_74: 2390,   // ADDC
'h1_75: 2390,   // ADDC
'h1_76: 2390,   // ADDC
'h1_77: 2390,   // ADDC
'h1_78: 2390,   // ADDC
'h1_79: 2390,   // ADDC
'h1_7a: 2390,   // ADDC
'h1_7b: 2390,   // ADDC
'h1_7c: 2390,   // ADDC
'h1_7d: 2390,   // ADDC
'h1_7e: 2390,   // ADDC
'h1_7f: 2390,   // ADDC
'h1_80: 2390,   // ADDC
'h1_81: 2390,   // ADDC
'h1_82: 2390,   // ADDC
'h1_83: 2390,   // ADDC
'h1_84: 2390,   // ADDC
'h1_85: 2390,   // ADDC
'h1_86: 2390,   // ADDC
'h1_87: 2390,   // ADDC
'h1_88: 2390,   // ADDC
'h1_89: 2390,   // ADDC
'h1_8a: 2390,   // ADDC
'h1_8b: 2390,   // ADDC
'h1_8c: 2390,   // ADDC
'h1_8d: 2390,   // ADDC
'h1_8e: 2390,   // ADDC
'h1_8f: 2390,   // ADDC
'h1_90: 2390,   // ADDC
'h1_91: 2390,   // ADDC
'h1_92: 2390,   // ADDC
'h1_93: 2390,   // ADDC
'h1_94: 2390,   // ADDC
'h1_95: 2390,   // ADDC
'h1_96: 2390,   // ADDC
'h1_97: 2390,   // ADDC
'h1_98: 2390,   // ADDC
'h1_99: 2390,   // ADDC
'h1_9a: 2390,   // ADDC
'h1_9b: 2390,   // ADDC
'h1_9c: 2390,   // ADDC
'h1_9d: 2390,   // ADDC
'h1_9e: 2390,   // ADDC
'h1_9f: 2390,   // ADDC
'h1_a0: 2390,   // ADDC
'h1_a1: 2390,   // ADDC
'h1_a2: 2390,   // ADDC
'h1_a3: 2390,   // ADDC
'h1_a4: 2390,   // ADDC
'h1_a5: 2390,   // ADDC
'h1_a6: 2390,   // ADDC
'h1_a7: 2390,   // ADDC
'h1_a8: 2390,   // ADDC
'h1_a9: 2390,   // ADDC
'h1_aa: 2390,   // ADDC
'h1_ab: 2390,   // ADDC
'h1_ac: 2390,   // ADDC
'h1_ad: 2390,   // ADDC
'h1_ae: 2390,   // ADDC
'h1_af: 2390,   // ADDC
'h1_b0: 2390,   // ADDC
'h1_b1: 2390,   // ADDC
'h1_b2: 2390,   // ADDC
'h1_b3: 2390,   // ADDC
'h1_b4: 2390,   // ADDC
'h1_b5: 2390,   // ADDC
'h1_b6: 2390,   // ADDC
'h1_b7: 2390,   // ADDC
'h1_b8: 2390,   // ADDC
'h1_b9: 2390,   // ADDC
'h1_ba: 2390,   // ADDC
'h1_bb: 2390,   // ADDC
'h1_bc: 2390,   // ADDC
'h1_bd: 2390,   // ADDC
'h1_be: 2390,   // ADDC
'h1_bf: 2390,   // ADDC
'h1_c0: 2390,   // ADDC
'h1_c1: 2390,   // ADDC
'h1_c2: 2390,   // ADDC
'h1_c3: 2390,   // ADDC
'h1_c4: 2390,   // ADDC
'h1_c5: 2390,   // ADDC
'h1_c6: 2390,   // ADDC
'h1_c7: 2390,   // ADDC
'h1_c8: 2390,   // ADDC
'h1_c9: 2390,   // ADDC
'h1_ca: 2390,   // ADDC
'h1_cb: 2390,   // ADDC
'h1_cc: 2390,   // ADDC
'h1_cd: 2390,   // ADDC
'h1_ce: 2390,   // ADDC
'h1_cf: 2390,   // ADDC
'h1_d0: 2390,   // ADDC
'h1_d1: 2390,   // ADDC
'h1_d2: 2390,   // ADDC
'h1_d3: 2390,   // ADDC
'h1_d4: 2390,   // ADDC
'h1_d5: 2390,   // ADDC
'h1_d6: 2390,   // ADDC
'h1_d7: 2390,   // ADDC
'h1_d8: 2390,   // ADDC
'h1_d9: 2390,   // ADDC
'h1_da: 2390,   // ADDC
'h1_db: 2390,   // ADDC
'h1_dc: 2390,   // ADDC
'h1_dd: 2390,   // ADDC
'h1_de: 2390,   // ADDC
'h1_df: 2390,   // ADDC
'h1_e0: 2390,   // ADDC
'h1_e1: 2390,   // ADDC
'h1_e2: 2390,   // ADDC
'h1_e3: 2390,   // ADDC
'h1_e4: 2390,   // ADDC
'h1_e5: 2390,   // ADDC
'h1_e6: 2390,   // ADDC
'h1_e7: 2390,   // ADDC
'h1_e8: 2390,   // ADDC
'h1_e9: 2390,   // ADDC
'h1_ea: 2390,   // ADDC
'h1_eb: 2390,   // ADDC
'h1_ec: 2390,   // ADDC
'h1_ed: 2390,   // ADDC
'h1_ee: 2390,   // ADDC
'h1_ef: 2390,   // ADDC
'h1_f0: 2390,   // ADDC
'h1_f1: 2390,   // ADDC
'h1_f2: 2390,   // ADDC
'h1_f3: 2390,   // ADDC
'h1_f4: 2390,   // ADDC
'h1_f5: 2390,   // ADDC
'h1_f6: 2390,   // ADDC
'h1_f7: 2390,   // ADDC
'h1_f8: 2390,   // ADDC
'h1_f9: 2390,   // ADDC
'h1_fa: 2390,   // ADDC
'h1_fb: 2390,   // ADDC
'h1_fc: 2390,   // ADDC
'h1_fd: 2390,   // ADDC
'h1_fe: 2390,   // ADDC
'h1_ff: 2390,   // ADDC
'h2_00:  111,   // ATXF
'h2_01:  116,   // STX
'h2_03:  127,   // XTS
'h2_08:  138,   // XTAF
'h2_09:  144,   // AAXF
'h2_0a:  151,   // AEXF
'h2_0b:  158,   // ARXF
'h2_0d:  165,   // AOXF
'h2_0e: 1488,   // A/XF
'h2_10:  178,   // APXF
'h2_11:  192,   // AUXF
'h2_12:  204,   // ACXF
'h2_13:  218,   // ANXF
'h2_14: 1582,   // EDXF
'h2_15: 1589,   // EBXF
'h2_16:  231,   // ASXF
'h2_18:  269,   // JAMP
'h2_19:  270,   // VJM
'h2_1b:  273,   // VLM
'h2_20:  271,   // JMEQ
'h2_21:  272,   // JMNE
'h2_22:  416,   // JMGE
'h2_23:  419,   // JMLT
'h2_24:  422,   // JMLE
'h2_25:  425,   // JMGT
'h2_3b:  255,   // WTCF
'h2_3c:  260,   // VTM
'h2_3d:  262,   // UTM
'h2_43:  316,   // UTS
'h2_48:  287,   // UTA
'h2_49:  290,   // AAU
'h2_4a:  293,   // AEU
'h2_4d:  296,   // AOU
'h2_52:  299,   // ACU
'h2_53:  307,   // ANU
'h2_80:    2,   // EXT/
'h2_81:  277,   // ADU
'h2_82:  281,   // ABU
'h2_83:  284,   // UBA
'h2_86: 1164,   // A/U
'h2_87: 1118,   // A*U
'h2_88:  313,   // UTY
'h2_90:  729,   // UTC
'h2_94:  324,   // XTYF
'h2_95:  330,   // YAXF
'h2_96:  336,   // YEXF
'h2_97:  342,   // YOXF
'h2_98:  350,   // YTXF
'h2_99:  486,   // ADLF
'h2_9a:  492,   // ABLF
'h2_9b:  498,   // LBAF
'h2_9e: 1202,   // A/LF
'h2_9f: 1157,   // A*LF
'h2_a0:  373,   // VTMH
'h2_a1:  376,   // VTMQ
'h2_a2:  378,   // VTMB
'h2_a3:  380,   // VTMF
'h2_a4:  382,   // UTCS
'h2_a9:  428,   // VRM
'h2_aa:  432,   // UZAS
'h2_ab:  438,   // UIAS
'h2_ac:  442,   // JOVR
'h2_ad:  445,   // JCRY
'h2_ae:  448,   // JAGT
'h2_af:  451,   // JAGE
'h2_b0:  454,   // JALT
'h2_b1:  457,   // JALE
'h2_b2:  460,   // JAEQ
'h2_b3:  463,   // JANE
'h2_b5:  466,   // JMPS
'h2_b6:  502,   // ATH
'h2_b7:  519,   // STH
'h2_b8:  520,   // HTA
'h2_b9:  531,   // HTS
'h2_ba:  536,   // ADH
'h2_bb:  538,   // ABH
'h2_bc:  540,   // HBAC
'h2_bf: 1207,   // A/H
'h2_c0: 1162,   // A*H
'h2_c1:  542,   // AAH
'h2_c2:  544,   // AEH
'h2_c3:  546,   // AOH
'h2_c4:  548,   // ATQ
'h2_c5:  554,   // STQ
'h2_c6:  555,   // QTA
'h2_c7:  562,   // QTS
'h2_c8:  567,   // AEQ
'h2_c9:  569,   // AAQ
'h2_ca:  571,   // AOQ
'h2_cb:  573,   // ATB
'h2_cc:  579,   // STB
'h2_cd:  580,   // BTA
'h2_ce:  587,   // BTS
'h2_cf:  592,   // AEB
'h2_d0:  594,   // AAB
'h2_d1:  596,   // AOB
'h2_d2:  598,   // ATF
'h2_d3:  603,   // STF
'h2_d4:  604,   // FTA
'h2_d5:  613,   // FTS
'h2_d6:  618,   // AEF
'h2_d7:  620,   // AAF
'h2_d8:  622,   // AOF
'h2_d9:  624,   // SETF
'h2_da:  635,   // CLRF
'h2_db:  739,   // XTRF
'h2_dc:  672,   // ATDF
'h2_dd:  684,   // DTAF
'h2_e5: 1213,   // ADXF
'h2_e6: 1364,   // ABXF
'h2_e7: 1374,   // XBAF
'h2_e8: 1391,   // AMXF
'h2_e9: 1403,   // AVXF
'h2_ea: 1508,   // A*XF
'h2_eb:  263,   // UZA
'h2_ec:  266,   // UIA
'h2_f0:  692,   // RMOD
'h2_f1:  876,   // WMOD
'h2_f2:  880,   // SETR
'h2_f3:  888,   // CLRR
'h2_f4:  891,   // SEMR
'h2_f5:  951,   // TTXF
'h2_f6:  963,   // TTAF
'h2_f7:  904,   // SEMW
'h2_f8:  913,   // SMON
'h2_f9:  928,   // CMON
'h3_00: 2390,   // ADDC
'h3_01: 2390,   // ADDC
'h3_02: 2390,   // ADDC
'h3_03: 2390,   // ADDC
'h3_04: 2390,   // ADDC
'h3_05: 2390,   // ADDC
'h3_06: 2390,   // ADDC
'h3_07: 2390,   // ADDC
'h3_08: 2390,   // ADDC
'h3_09: 2390,   // ADDC
'h3_0a: 2390,   // ADDC
'h3_0b: 2390,   // ADDC
'h3_0c: 2390,   // ADDC
'h3_0d: 2390,   // ADDC
'h3_0e: 2390,   // ADDC
'h3_0f: 2390,   // ADDC
'h3_10: 2390,   // ADDC
'h3_11: 2390,   // ADDC
'h3_12: 2390,   // ADDC
'h3_13: 2390,   // ADDC
'h3_14: 2390,   // ADDC
'h3_15: 2390,   // ADDC
'h3_16: 2390,   // ADDC
'h3_17: 2390,   // ADDC
'h3_18: 2390,   // ADDC
'h3_19: 2390,   // ADDC
'h3_1a: 2390,   // ADDC
'h3_1b: 2390,   // ADDC
'h3_1c: 2390,   // ADDC
'h3_1d: 2390,   // ADDC
'h3_1e: 2390,   // ADDC
'h3_1f: 2390,   // ADDC
'h3_20: 2390,   // ADDC
'h3_21: 2390,   // ADDC
'h3_22: 2390,   // ADDC
'h3_23: 2390,   // ADDC
'h3_24: 2390,   // ADDC
'h3_25: 2390,   // ADDC
'h3_26: 2390,   // ADDC
'h3_27: 2390,   // ADDC
'h3_28: 2390,   // ADDC
'h3_29: 2390,   // ADDC
'h3_2a: 2390,   // ADDC
'h3_2b: 2390,   // ADDC
'h3_2c: 2390,   // ADDC
'h3_2d: 2390,   // ADDC
'h3_2e: 2390,   // ADDC
'h3_2f: 2390,   // ADDC
'h3_30: 2390,   // ADDC
'h3_31: 2390,   // ADDC
'h3_32: 2390,   // ADDC
'h3_33: 2390,   // ADDC
'h3_34: 2390,   // ADDC
'h3_35: 2390,   // ADDC
'h3_36: 2390,   // ADDC
'h3_37: 2390,   // ADDC
'h3_38: 2390,   // ADDC
'h3_39: 2390,   // ADDC
'h3_3a: 2390,   // ADDC
'h3_3b: 2390,   // ADDC
'h3_3c: 2390,   // ADDC
'h3_3d: 2390,   // ADDC
'h3_3e: 2390,   // ADDC
'h3_3f: 2390,   // ADDC
'h3_40: 2390,   // ADDC
'h3_41: 2390,   // ADDC
'h3_42: 2390,   // ADDC
'h3_43: 2390,   // ADDC
'h3_44: 2390,   // ADDC
'h3_45: 2390,   // ADDC
'h3_46: 2390,   // ADDC
'h3_47: 2390,   // ADDC
'h3_48: 2390,   // ADDC
'h3_49: 2390,   // ADDC
'h3_4a: 2390,   // ADDC
'h3_4b: 2390,   // ADDC
'h3_4c: 2390,   // ADDC
'h3_4d: 2390,   // ADDC
'h3_4e: 2390,   // ADDC
'h3_4f: 2390,   // ADDC
'h3_50: 2390,   // ADDC
'h3_51: 2390,   // ADDC
'h3_52: 2390,   // ADDC
'h3_53: 2390,   // ADDC
'h3_54: 2390,   // ADDC
'h3_55: 2390,   // ADDC
'h3_56: 2390,   // ADDC
'h3_57: 2390,   // ADDC
'h3_58: 2390,   // ADDC
'h3_59: 2390,   // ADDC
'h3_5a: 2390,   // ADDC
'h3_5b: 2390,   // ADDC
'h3_5c: 2390,   // ADDC
'h3_5d: 2390,   // ADDC
'h3_5e: 2390,   // ADDC
'h3_5f: 2390,   // ADDC
'h3_60: 2390,   // ADDC
'h3_61: 2390,   // ADDC
'h3_62: 2390,   // ADDC
'h3_63: 2390,   // ADDC
'h3_64: 2390,   // ADDC
'h3_65: 2390,   // ADDC
'h3_66: 2390,   // ADDC
'h3_67: 2390,   // ADDC
'h3_68: 2390,   // ADDC
'h3_69: 2390,   // ADDC
'h3_6a: 2390,   // ADDC
'h3_6b: 2390,   // ADDC
'h3_6c: 2390,   // ADDC
'h3_6d: 2390,   // ADDC
'h3_6e: 2390,   // ADDC
'h3_6f: 2390,   // ADDC
'h3_70: 2390,   // ADDC
'h3_71: 2390,   // ADDC
'h3_72: 2390,   // ADDC
'h3_73: 2390,   // ADDC
'h3_74: 2390,   // ADDC
'h3_75: 2390,   // ADDC
'h3_76: 2390,   // ADDC
'h3_77: 2390,   // ADDC
'h3_78: 2390,   // ADDC
'h3_79: 2390,   // ADDC
'h3_7a: 2390,   // ADDC
'h3_7b: 2390,   // ADDC
'h3_7c: 2390,   // ADDC
'h3_7d: 2390,   // ADDC
'h3_7e: 2390,   // ADDC
'h3_7f: 2390,   // ADDC
'h3_80: 2390,   // ADDC
'h3_81: 2390,   // ADDC
'h3_82: 2390,   // ADDC
'h3_83: 2390,   // ADDC
'h3_84: 2390,   // ADDC
'h3_85: 2390,   // ADDC
'h3_86: 2390,   // ADDC
'h3_87: 2390,   // ADDC
'h3_88: 2390,   // ADDC
'h3_89: 2390,   // ADDC
'h3_8a: 2390,   // ADDC
'h3_8b: 2390,   // ADDC
'h3_8c: 2390,   // ADDC
'h3_8d: 2390,   // ADDC
'h3_8e: 2390,   // ADDC
'h3_8f: 2390,   // ADDC
'h3_90: 2390,   // ADDC
'h3_91: 2390,   // ADDC
'h3_92: 2390,   // ADDC
'h3_93: 2390,   // ADDC
'h3_94: 2390,   // ADDC
'h3_95: 2390,   // ADDC
'h3_96: 2390,   // ADDC
'h3_97: 2390,   // ADDC
'h3_98: 2390,   // ADDC
'h3_99: 2390,   // ADDC
'h3_9a: 2390,   // ADDC
'h3_9b: 2390,   // ADDC
'h3_9c: 2390,   // ADDC
'h3_9d: 2390,   // ADDC
'h3_9e: 2390,   // ADDC
'h3_9f: 2390,   // ADDC
'h3_a0: 2390,   // ADDC
'h3_a1: 2390,   // ADDC
'h3_a2: 2390,   // ADDC
'h3_a3: 2390,   // ADDC
'h3_a4: 2390,   // ADDC
'h3_a5: 2390,   // ADDC
'h3_a6: 2390,   // ADDC
'h3_a7: 2390,   // ADDC
'h3_a8: 2390,   // ADDC
'h3_a9: 2390,   // ADDC
'h3_aa: 2390,   // ADDC
'h3_ab: 2390,   // ADDC
'h3_ac: 2390,   // ADDC
'h3_ad: 2390,   // ADDC
'h3_ae: 2390,   // ADDC
'h3_af: 2390,   // ADDC
'h3_b0: 2390,   // ADDC
'h3_b1: 2390,   // ADDC
'h3_b2: 2390,   // ADDC
'h3_b3: 2390,   // ADDC
'h3_b4: 2390,   // ADDC
'h3_b5: 2390,   // ADDC
'h3_b6: 2390,   // ADDC
'h3_b7: 2390,   // ADDC
'h3_b8: 2390,   // ADDC
'h3_b9: 2390,   // ADDC
'h3_ba: 2390,   // ADDC
'h3_bb: 2390,   // ADDC
'h3_bc: 2390,   // ADDC
'h3_bd: 2390,   // ADDC
'h3_be: 2390,   // ADDC
'h3_bf: 2390,   // ADDC
'h3_c0: 2390,   // ADDC
'h3_c1: 2390,   // ADDC
'h3_c2: 2390,   // ADDC
'h3_c3: 2390,   // ADDC
'h3_c4: 2390,   // ADDC
'h3_c5: 2390,   // ADDC
'h3_c6: 2390,   // ADDC
'h3_c7: 2390,   // ADDC
'h3_c8: 2390,   // ADDC
'h3_c9: 2390,   // ADDC
'h3_ca: 2390,   // ADDC
'h3_cb: 2390,   // ADDC
'h3_cc: 2390,   // ADDC
'h3_cd: 2390,   // ADDC
'h3_ce: 2390,   // ADDC
'h3_cf: 2390,   // ADDC
'h3_d0: 2390,   // ADDC
'h3_d1: 2390,   // ADDC
'h3_d2: 2390,   // ADDC
'h3_d3: 2390,   // ADDC
'h3_d4: 2390,   // ADDC
'h3_d5: 2390,   // ADDC
'h3_d6: 2390,   // ADDC
'h3_d7: 2390,   // ADDC
'h3_d8: 2390,   // ADDC
'h3_d9: 2390,   // ADDC
'h3_da: 2390,   // ADDC
'h3_db: 2390,   // ADDC
'h3_dc: 2390,   // ADDC
'h3_dd: 2390,   // ADDC
'h3_de: 2390,   // ADDC
'h3_df: 2390,   // ADDC
'h3_e0: 2390,   // ADDC
'h3_e1: 2390,   // ADDC
'h3_e2: 2390,   // ADDC
'h3_e3: 2390,   // ADDC
'h3_e4: 2390,   // ADDC
'h3_e5: 2390,   // ADDC
'h3_e6: 2390,   // ADDC
'h3_e7: 2390,   // ADDC
'h3_e8: 2390,   // ADDC
'h3_e9: 2390,   // ADDC
'h3_ea: 2390,   // ADDC
'h3_eb: 2390,   // ADDC
'h3_ec: 2390,   // ADDC
'h3_ed: 2390,   // ADDC
'h3_ee: 2390,   // ADDC
'h3_ef: 2390,   // ADDC
'h3_f0: 2390,   // ADDC
'h3_f1: 2390,   // ADDC
'h3_f2: 2390,   // ADDC
'h3_f3: 2390,   // ADDC
'h3_f4: 2390,   // ADDC
'h3_f5: 2390,   // ADDC
'h3_f6: 2390,   // ADDC
'h3_f7: 2390,   // ADDC
'h3_f8: 2390,   // ADDC
'h3_f9: 2390,   // ADDC
'h3_fa: 2390,   // ADDC
'h3_fb: 2390,   // ADDC
'h3_fc: 2390,   // ADDC
'h3_fd: 2390,   // ADDC
'h3_fe: 2390,   // ADDC
'h3_ff: 2390,   // ADDC
'h4_00:  107,   // ATX
'h4_01:  116,   // STX
'h4_03:  127,   // XTS
'h4_04: 1209,   // ADX
'h4_05: 1359,   // ABX
'h4_06: 1369,   // XBA
'h4_07: 1379,   // AMX
'h4_08:  136,   // XTA
'h4_09:  759,   // AAXE
'h4_0a:  766,   // AEXE
'h4_0b:  774,   // ARXE
'h4_0c: 1401,   // AVX
'h4_0d:  783,   // AOXE
'h4_0e: 1455,   // A/X
'h4_0f: 1493,   // A*X
'h4_10:  789,   // APXE
'h4_11:  803,   // AUXE
'h4_12:  816,   // ACXE
'h4_13:  826,   // ANXE
'h4_14: 1574,   // EDX
'h4_15: 1587,   // EBX
'h4_16:  836,   // ASXE
'h4_17:  732,   // XTR
'h4_18:  749,   // RTE
'h4_19: 1606,   // YTA
'h4_1c: 1594,   // EDN
'h4_1d: 1604,   // EBN
'h4_1e:  851,   // ASNE
'h4_1f:  744,   // NTR
'h4_20:  855,   // ATIE
'h4_21:  698,   // STI
'h4_22:  858,   // ITAE
'h4_23:  719,   // ITS
'h4_24:  247,   // MTJ
'h4_25:  250,   // JDM
'h4_28:    3,   // EXT6
'h4_29:    3,   // EXT6
'h4_2a:    3,   // EXT6
'h4_2b:    3,   // EXT6
'h4_2c:    3,   // EXT6
'h4_2d:    3,   // EXT6
'h4_2e:    3,   // EXT6
'h4_2f:    3,   // EXT6
'h4_30:    3,   // EXT6
'h4_31:    3,   // EXT6
'h4_32:    3,   // EXT6
'h4_33:    3,   // EXT6
'h4_34:    3,   // EXT6
'h4_35:    3,   // EXT6
'h4_36:    3,   // EXT6
'h4_37:    3,   // EXT6
'h4_38:    3,   // EXT6
'h4_39:    3,   // EXT6
'h4_3a:    3,   // EXT6
'h4_3b:    3,   // EXT6
'h4_3c:    3,   // EXT6
'h4_3d:    3,   // EXT6
'h4_3e:    3,   // EXT6
'h4_3f:    3,   // EXT6
'h4_90:  729,   // UTC
'h4_98:  863,   // WTCE
'h4_a0:  260,   // VTM
'h4_a8:  262,   // UTM
'h4_b0:  263,   // UZA
'h4_b8:  266,   // UIA
'h4_c0:  269,   // JAMP
'h4_c8:  270,   // VJM
'h4_e0:  870,   // JMEQE
'h4_e8:  872,   // JMNEE
'h4_f8:  874,   // VLME
'h5_00: 2390,   // ADDC
'h5_01: 2390,   // ADDC
'h5_02: 2390,   // ADDC
'h5_03: 2390,   // ADDC
'h5_04: 2390,   // ADDC
'h5_05: 2390,   // ADDC
'h5_06: 2390,   // ADDC
'h5_07: 2390,   // ADDC
'h5_08: 2390,   // ADDC
'h5_09: 2390,   // ADDC
'h5_0a: 2390,   // ADDC
'h5_0b: 2390,   // ADDC
'h5_0c: 2390,   // ADDC
'h5_0d: 2390,   // ADDC
'h5_0e: 2390,   // ADDC
'h5_0f: 2390,   // ADDC
'h5_10: 2390,   // ADDC
'h5_11: 2390,   // ADDC
'h5_12: 2390,   // ADDC
'h5_13: 2390,   // ADDC
'h5_14: 2390,   // ADDC
'h5_15: 2390,   // ADDC
'h5_16: 2390,   // ADDC
'h5_17: 2390,   // ADDC
'h5_18: 2390,   // ADDC
'h5_19: 2390,   // ADDC
'h5_1a: 2390,   // ADDC
'h5_1b: 2390,   // ADDC
'h5_1c: 2390,   // ADDC
'h5_1d: 2390,   // ADDC
'h5_1e: 2390,   // ADDC
'h5_1f: 2390,   // ADDC
'h5_20: 2390,   // ADDC
'h5_21: 2390,   // ADDC
'h5_22: 2390,   // ADDC
'h5_23: 2390,   // ADDC
'h5_24: 2390,   // ADDC
'h5_25: 2390,   // ADDC
'h5_26: 2390,   // ADDC
'h5_27: 2390,   // ADDC
'h5_28: 2390,   // ADDC
'h5_29: 2390,   // ADDC
'h5_2a: 2390,   // ADDC
'h5_2b: 2390,   // ADDC
'h5_2c: 2390,   // ADDC
'h5_2d: 2390,   // ADDC
'h5_2e: 2390,   // ADDC
'h5_2f: 2390,   // ADDC
'h5_30: 2390,   // ADDC
'h5_31: 2390,   // ADDC
'h5_32: 2390,   // ADDC
'h5_33: 2390,   // ADDC
'h5_34: 2390,   // ADDC
'h5_35: 2390,   // ADDC
'h5_36: 2390,   // ADDC
'h5_37: 2390,   // ADDC
'h5_38: 2390,   // ADDC
'h5_39: 2390,   // ADDC
'h5_3a: 2390,   // ADDC
'h5_3b: 2390,   // ADDC
'h5_3c: 2390,   // ADDC
'h5_3d: 2390,   // ADDC
'h5_3e: 2390,   // ADDC
'h5_3f: 2390,   // ADDC
'h5_40: 2390,   // ADDC
'h5_41: 2390,   // ADDC
'h5_42: 2390,   // ADDC
'h5_43: 2390,   // ADDC
'h5_44: 2390,   // ADDC
'h5_45: 2390,   // ADDC
'h5_46: 2390,   // ADDC
'h5_47: 2390,   // ADDC
'h5_48: 2390,   // ADDC
'h5_49: 2390,   // ADDC
'h5_4a: 2390,   // ADDC
'h5_4b: 2390,   // ADDC
'h5_4c: 2390,   // ADDC
'h5_4d: 2390,   // ADDC
'h5_4e: 2390,   // ADDC
'h5_4f: 2390,   // ADDC
'h5_50: 2390,   // ADDC
'h5_51: 2390,   // ADDC
'h5_52: 2390,   // ADDC
'h5_53: 2390,   // ADDC
'h5_54: 2390,   // ADDC
'h5_55: 2390,   // ADDC
'h5_56: 2390,   // ADDC
'h5_57: 2390,   // ADDC
'h5_58: 2390,   // ADDC
'h5_59: 2390,   // ADDC
'h5_5a: 2390,   // ADDC
'h5_5b: 2390,   // ADDC
'h5_5c: 2390,   // ADDC
'h5_5d: 2390,   // ADDC
'h5_5e: 2390,   // ADDC
'h5_5f: 2390,   // ADDC
'h5_60: 2390,   // ADDC
'h5_61: 2390,   // ADDC
'h5_62: 2390,   // ADDC
'h5_63: 2390,   // ADDC
'h5_64: 2390,   // ADDC
'h5_65: 2390,   // ADDC
'h5_66: 2390,   // ADDC
'h5_67: 2390,   // ADDC
'h5_68: 2390,   // ADDC
'h5_69: 2390,   // ADDC
'h5_6a: 2390,   // ADDC
'h5_6b: 2390,   // ADDC
'h5_6c: 2390,   // ADDC
'h5_6d: 2390,   // ADDC
'h5_6e: 2390,   // ADDC
'h5_6f: 2390,   // ADDC
'h5_70: 2390,   // ADDC
'h5_71: 2390,   // ADDC
'h5_72: 2390,   // ADDC
'h5_73: 2390,   // ADDC
'h5_74: 2390,   // ADDC
'h5_75: 2390,   // ADDC
'h5_76: 2390,   // ADDC
'h5_77: 2390,   // ADDC
'h5_78: 2390,   // ADDC
'h5_79: 2390,   // ADDC
'h5_7a: 2390,   // ADDC
'h5_7b: 2390,   // ADDC
'h5_7c: 2390,   // ADDC
'h5_7d: 2390,   // ADDC
'h5_7e: 2390,   // ADDC
'h5_7f: 2390,   // ADDC
'h5_80: 2390,   // ADDC
'h5_81: 2390,   // ADDC
'h5_82: 2390,   // ADDC
'h5_83: 2390,   // ADDC
'h5_84: 2390,   // ADDC
'h5_85: 2390,   // ADDC
'h5_86: 2390,   // ADDC
'h5_87: 2390,   // ADDC
'h5_88: 2390,   // ADDC
'h5_89: 2390,   // ADDC
'h5_8a: 2390,   // ADDC
'h5_8b: 2390,   // ADDC
'h5_8c: 2390,   // ADDC
'h5_8d: 2390,   // ADDC
'h5_8e: 2390,   // ADDC
'h5_8f: 2390,   // ADDC
'h5_90: 2390,   // ADDC
'h5_91: 2390,   // ADDC
'h5_92: 2390,   // ADDC
'h5_93: 2390,   // ADDC
'h5_94: 2390,   // ADDC
'h5_95: 2390,   // ADDC
'h5_96: 2390,   // ADDC
'h5_97: 2390,   // ADDC
'h5_98: 2390,   // ADDC
'h5_99: 2390,   // ADDC
'h5_9a: 2390,   // ADDC
'h5_9b: 2390,   // ADDC
'h5_9c: 2390,   // ADDC
'h5_9d: 2390,   // ADDC
'h5_9e: 2390,   // ADDC
'h5_9f: 2390,   // ADDC
'h5_a0: 2390,   // ADDC
'h5_a1: 2390,   // ADDC
'h5_a2: 2390,   // ADDC
'h5_a3: 2390,   // ADDC
'h5_a4: 2390,   // ADDC
'h5_a5: 2390,   // ADDC
'h5_a6: 2390,   // ADDC
'h5_a7: 2390,   // ADDC
'h5_a8: 2390,   // ADDC
'h5_a9: 2390,   // ADDC
'h5_aa: 2390,   // ADDC
'h5_ab: 2390,   // ADDC
'h5_ac: 2390,   // ADDC
'h5_ad: 2390,   // ADDC
'h5_ae: 2390,   // ADDC
'h5_af: 2390,   // ADDC
'h5_b0: 2390,   // ADDC
'h5_b1: 2390,   // ADDC
'h5_b2: 2390,   // ADDC
'h5_b3: 2390,   // ADDC
'h5_b4: 2390,   // ADDC
'h5_b5: 2390,   // ADDC
'h5_b6: 2390,   // ADDC
'h5_b7: 2390,   // ADDC
'h5_b8: 2390,   // ADDC
'h5_b9: 2390,   // ADDC
'h5_ba: 2390,   // ADDC
'h5_bb: 2390,   // ADDC
'h5_bc: 2390,   // ADDC
'h5_bd: 2390,   // ADDC
'h5_be: 2390,   // ADDC
'h5_bf: 2390,   // ADDC
'h5_c0: 2390,   // ADDC
'h5_c1: 2390,   // ADDC
'h5_c2: 2390,   // ADDC
'h5_c3: 2390,   // ADDC
'h5_c4: 2390,   // ADDC
'h5_c5: 2390,   // ADDC
'h5_c6: 2390,   // ADDC
'h5_c7: 2390,   // ADDC
'h5_c8: 2390,   // ADDC
'h5_c9: 2390,   // ADDC
'h5_ca: 2390,   // ADDC
'h5_cb: 2390,   // ADDC
'h5_cc: 2390,   // ADDC
'h5_cd: 2390,   // ADDC
'h5_ce: 2390,   // ADDC
'h5_cf: 2390,   // ADDC
'h5_d0: 2390,   // ADDC
'h5_d1: 2390,   // ADDC
'h5_d2: 2390,   // ADDC
'h5_d3: 2390,   // ADDC
'h5_d4: 2390,   // ADDC
'h5_d5: 2390,   // ADDC
'h5_d6: 2390,   // ADDC
'h5_d7: 2390,   // ADDC
'h5_d8: 2390,   // ADDC
'h5_d9: 2390,   // ADDC
'h5_da: 2390,   // ADDC
'h5_db: 2390,   // ADDC
'h5_dc: 2390,   // ADDC
'h5_dd: 2390,   // ADDC
'h5_de: 2390,   // ADDC
'h5_df: 2390,   // ADDC
'h5_e0: 2390,   // ADDC
'h5_e1: 2390,   // ADDC
'h5_e2: 2390,   // ADDC
'h5_e3: 2390,   // ADDC
'h5_e4: 2390,   // ADDC
'h5_e5: 2390,   // ADDC
'h5_e6: 2390,   // ADDC
'h5_e7: 2390,   // ADDC
'h5_e8: 2390,   // ADDC
'h5_e9: 2390,   // ADDC
'h5_ea: 2390,   // ADDC
'h5_eb: 2390,   // ADDC
'h5_ec: 2390,   // ADDC
'h5_ed: 2390,   // ADDC
'h5_ee: 2390,   // ADDC
'h5_ef: 2390,   // ADDC
'h5_f0: 2390,   // ADDC
'h5_f1: 2390,   // ADDC
'h5_f2: 2390,   // ADDC
'h5_f3: 2390,   // ADDC
'h5_f4: 2390,   // ADDC
'h5_f5: 2390,   // ADDC
'h5_f6: 2390,   // ADDC
'h5_f7: 2390,   // ADDC
'h5_f8: 2390,   // ADDC
'h5_f9: 2390,   // ADDC
'h5_fa: 2390,   // ADDC
'h5_fb: 2390,   // ADDC
'h5_fc: 2390,   // ADDC
'h5_fd: 2390,   // ADDC
'h5_fe: 2390,   // ADDC
'h5_ff: 2390,   // ADDC
'h6_00:  689,   // ATXFE
'h6_01:  116,   // STX
'h6_03:  127,   // XTS
'h6_04: 1214,   // ADXFE
'h6_05: 1365,   // ABXFE
'h6_06: 1375,   // XBAFE
'h6_07: 1392,   // AMXFE
'h6_08:  696,   // XTAFE
'h6_09:  762,   // AAXFE
'h6_0a:  769,   // AEXFE
'h6_0b:  779,   // ARXFE
'h6_0c: 1404,   // AVXFE
'h6_0d:  785,   // AOXFE
'h6_0e: 1489,   // A/XFE
'h6_0f: 1509,   // A*XFE
'h6_10:  799,   // APXFE
'h6_11:  812,   // AUXFE
'h6_12:  822,   // ACXFE
'h6_13:  832,   // ANXFE
'h6_14: 1583,   // EDXFE
'h6_15: 1590,   // EBXFE
'h6_16:  847,   // ASXFE
'h6_17:  739,   // XTRF
'h6_18:  749,   // RTE
'h6_19: 1606,   // YTA
'h6_1c: 1594,   // EDN
'h6_1d: 1604,   // EBN
'h6_1e:  851,   // ASNE
'h6_1f:  744,   // NTR
'h6_20:  855,   // ATIE
'h6_21:  698,   // STI
'h6_22:  858,   // ITAE
'h6_23:  719,   // ITS
'h6_24:  247,   // MTJ
'h6_25:  250,   // JDM
'h6_28:    3,   // EXT6
'h6_29:    3,   // EXT6
'h6_2a:    3,   // EXT6
'h6_2b:    3,   // EXT6
'h6_2c:    3,   // EXT6
'h6_2d:    3,   // EXT6
'h6_2e:    3,   // EXT6
'h6_2f:    3,   // EXT6
'h6_30:    3,   // EXT6
'h6_31:    3,   // EXT6
'h6_32:    3,   // EXT6
'h6_33:    3,   // EXT6
'h6_34:    3,   // EXT6
'h6_35:    3,   // EXT6
'h6_36:    3,   // EXT6
'h6_37:    3,   // EXT6
'h6_38:    3,   // EXT6
'h6_39:    3,   // EXT6
'h6_3a:    3,   // EXT6
'h6_3b:    3,   // EXT6
'h6_3c:    3,   // EXT6
'h6_3d:    3,   // EXT6
'h6_3e:    3,   // EXT6
'h6_3f:    3,   // EXT6
'h6_90:  729,   // UTC
'h6_98:  866,   // WTCFE
'h6_a0:  260,   // VTM
'h6_a8:  262,   // UTM
'h6_b0:  263,   // UZA
'h6_b8:  266,   // UIA
'h6_c0:  269,   // JAMP
'h6_c8:  270,   // VJM
'h6_e0:  870,   // JMEQE
'h6_e8:  872,   // JMNEE
'h6_f8:  874,   // VLME
'h7_00: 2390,   // ADDC
'h7_01: 2390,   // ADDC
'h7_02: 2390,   // ADDC
'h7_03: 2390,   // ADDC
'h7_04: 2390,   // ADDC
'h7_05: 2390,   // ADDC
'h7_06: 2390,   // ADDC
'h7_07: 2390,   // ADDC
'h7_08: 2390,   // ADDC
'h7_09: 2390,   // ADDC
'h7_0a: 2390,   // ADDC
'h7_0b: 2390,   // ADDC
'h7_0c: 2390,   // ADDC
'h7_0d: 2390,   // ADDC
'h7_0e: 2390,   // ADDC
'h7_0f: 2390,   // ADDC
'h7_10: 2390,   // ADDC
'h7_11: 2390,   // ADDC
'h7_12: 2390,   // ADDC
'h7_13: 2390,   // ADDC
'h7_14: 2390,   // ADDC
'h7_15: 2390,   // ADDC
'h7_16: 2390,   // ADDC
'h7_17: 2390,   // ADDC
'h7_18: 2390,   // ADDC
'h7_19: 2390,   // ADDC
'h7_1a: 2390,   // ADDC
'h7_1b: 2390,   // ADDC
'h7_1c: 2390,   // ADDC
'h7_1d: 2390,   // ADDC
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
'h7_ce: 2390,   // ADDC
'h7_cf: 2390,   // ADDC
'h7_d0: 2390,   // ADDC
'h7_d1: 2390,   // ADDC
'h7_d2: 2390,   // ADDC
'h7_d3: 2390,   // ADDC
'h7_d4: 2390,   // ADDC
'h7_d5: 2390,   // ADDC
'h7_d6: 2390,   // ADDC
'h7_d7: 2390,   // ADDC
'h7_d8: 2390,   // ADDC
'h7_d9: 2390,   // ADDC
'h7_da: 2390,   // ADDC
'h7_db: 2390,   // ADDC
'h7_dc: 2390,   // ADDC
'h7_dd: 2390,   // ADDC
'h7_de: 2390,   // ADDC
'h7_df: 2390,   // ADDC
'h7_e0: 2390,   // ADDC
'h7_e1: 2390,   // ADDC
'h7_e2: 2390,   // ADDC
'h7_e3: 2390,   // ADDC
'h7_e4: 2390,   // ADDC
'h7_e5: 2390,   // ADDC
'h7_e6: 2390,   // ADDC
'h7_e7: 2390,   // ADDC
'h7_e8: 2390,   // ADDC
'h7_e9: 2390,   // ADDC
'h7_ea: 2390,   // ADDC
'h7_eb: 2390,   // ADDC
'h7_ec: 2390,   // ADDC
'h7_ed: 2390,   // ADDC
'h7_ee: 2390,   // ADDC
'h7_ef: 2390,   // ADDC
'h7_f0: 2390,   // ADDC
'h7_f1: 2390,   // ADDC
'h7_f2: 2390,   // ADDC
'h7_f3: 2390,   // ADDC
'h7_f4: 2390,   // ADDC
'h7_f5: 2390,   // ADDC
'h7_f6: 2390,   // ADDC
'h7_f7: 2390,   // ADDC
'h7_f8: 2390,   // ADDC
'h7_f9: 2390,   // ADDC
'h7_fa: 2390,   // ADDC
'h7_fb: 2390,   // ADDC
'h7_fc: 2390,   // ADDC
'h7_fd: 2390,   // ADDC
'h7_fe: 2390,   // ADDC
'h7_ff: 2390,   // ADDC
'h8_00:    4,   // EXTC
'h8_16:  236,   // ASN
'h8_1c: 1594,   // EDN
'h8_1d: 1604,   // EBN
'h8_20:  243,   // ATI
'h8_21:  698,   // STI
'h8_22:  719,   // ITS
'h8_24:  247,   // MTJ
'h8_25:  250,   // JDM
'h8_27:  370,   // JBM
'h8_80:  245,   // ITA
'h8_81: 1606,   // YTA
'h8_82:  744,   // NTR
'h8_83:  749,   // RTE
'h8_84:  355,   // AAY
'h8_85:  357,   // AEY
'h8_86:  359,   // AOY
'h8_87:  474,   // RETS
'h8_90:  361,   // MCJ
'h8_91:  365,   // MSN
'h8_94:  385,   // MPAC
'h8_95:  395,   // MUNP
'h8_96:  481,   // ASNA
'h8_a1:  638,   // EXTF
'h8_a2:  404,   // ADI
'h8_a3:  406,   // ABI
'h8_a4:  408,   // IBA
'h8_a7: 1196,   // A/I
'h8_a8: 1151,   // A*I
'h8_a9:  410,   // AAI
'h8_aa:  412,   // AEI
'h8_ab:  414,   // AOI
'h8_b0:  644,   // NTA
'h8_b1:  654,   // NTSC
'h8_b2:  659,   // AEN
'h8_b3:  661,   // AAN
'h8_b4:  663,   // AON
'h8_fd: 1031,   // IJP
'h8_fe:  979,   // RET
'h8_ff:  969,   // HLT
'h9_00: 2390,   // ADDC
'h9_01: 2390,   // ADDC
'h9_02: 2390,   // ADDC
'h9_03: 2390,   // ADDC
'h9_04: 2390,   // ADDC
'h9_05: 2390,   // ADDC
'h9_06: 2390,   // ADDC
'h9_07: 2390,   // ADDC
'h9_08: 2390,   // ADDC
'h9_09: 2390,   // ADDC
'h9_0a: 2390,   // ADDC
'h9_0b: 2390,   // ADDC
'h9_0c: 2390,   // ADDC
'h9_0d: 2390,   // ADDC
'h9_0e: 2390,   // ADDC
'h9_0f: 2390,   // ADDC
'h9_10: 2390,   // ADDC
'h9_11: 2390,   // ADDC
'h9_12: 2390,   // ADDC
'h9_13: 2390,   // ADDC
'h9_14: 2390,   // ADDC
'h9_15: 2390,   // ADDC
'h9_16: 2390,   // ADDC
'h9_17: 2390,   // ADDC
'h9_18: 2390,   // ADDC
'h9_19: 2390,   // ADDC
'h9_1a: 2390,   // ADDC
'h9_1b: 2390,   // ADDC
'h9_1c: 2390,   // ADDC
'h9_1d: 2390,   // ADDC
'h9_1e: 2390,   // ADDC
'h9_1f: 2390,   // ADDC
'h9_20: 2390,   // ADDC
'h9_21: 2390,   // ADDC
'h9_22: 2390,   // ADDC
'h9_23: 2390,   // ADDC
'h9_24: 2390,   // ADDC
'h9_25: 2390,   // ADDC
'h9_26: 2390,   // ADDC
'h9_27: 2390,   // ADDC
'h9_28: 2390,   // ADDC
'h9_29: 2390,   // ADDC
'h9_2a: 2390,   // ADDC
'h9_2b: 2390,   // ADDC
'h9_2c: 2390,   // ADDC
'h9_2d: 2390,   // ADDC
'h9_2e: 2390,   // ADDC
'h9_2f: 2390,   // ADDC
'h9_30: 2390,   // ADDC
'h9_31: 2390,   // ADDC
'h9_32: 2390,   // ADDC
'h9_33: 2390,   // ADDC
'h9_34: 2390,   // ADDC
'h9_35: 2390,   // ADDC
'h9_36: 2390,   // ADDC
'h9_37: 2390,   // ADDC
'h9_38: 2390,   // ADDC
'h9_39: 2390,   // ADDC
'h9_3a: 2390,   // ADDC
'h9_3b: 2390,   // ADDC
'h9_3c: 2390,   // ADDC
'h9_3d: 2390,   // ADDC
'h9_3e: 2390,   // ADDC
'h9_3f: 2390,   // ADDC
'h9_40: 2390,   // ADDC
'h9_41: 2390,   // ADDC
'h9_42: 2390,   // ADDC
'h9_43: 2390,   // ADDC
'h9_44: 2390,   // ADDC
'h9_45: 2390,   // ADDC
'h9_46: 2390,   // ADDC
'h9_47: 2390,   // ADDC
'h9_48: 2390,   // ADDC
'h9_49: 2390,   // ADDC
'h9_4a: 2390,   // ADDC
'h9_4b: 2390,   // ADDC
'h9_4c: 2390,   // ADDC
'h9_4d: 2390,   // ADDC
'h9_4e: 2390,   // ADDC
'h9_4f: 2390,   // ADDC
'h9_50: 2390,   // ADDC
'h9_51: 2390,   // ADDC
'h9_52: 2390,   // ADDC
'h9_53: 2390,   // ADDC
'h9_54: 2390,   // ADDC
'h9_55: 2390,   // ADDC
'h9_56: 2390,   // ADDC
'h9_57: 2390,   // ADDC
'h9_58: 2390,   // ADDC
'h9_59: 2390,   // ADDC
'h9_5a: 2390,   // ADDC
'h9_5b: 2390,   // ADDC
'h9_5c: 2390,   // ADDC
'h9_5d: 2390,   // ADDC
'h9_5e: 2390,   // ADDC
'h9_5f: 2390,   // ADDC
'h9_60: 2390,   // ADDC
'h9_61: 2390,   // ADDC
'h9_62: 2390,   // ADDC
'h9_63: 2390,   // ADDC
'h9_64: 2390,   // ADDC
'h9_65: 2390,   // ADDC
'h9_66: 2390,   // ADDC
'h9_67: 2390,   // ADDC
'h9_68: 2390,   // ADDC
'h9_69: 2390,   // ADDC
'h9_6a: 2390,   // ADDC
'h9_6b: 2390,   // ADDC
'h9_6c: 2390,   // ADDC
'h9_6d: 2390,   // ADDC
'h9_6e: 2390,   // ADDC
'h9_6f: 2390,   // ADDC
'h9_70: 2390,   // ADDC
'h9_71: 2390,   // ADDC
'h9_72: 2390,   // ADDC
'h9_73: 2390,   // ADDC
'h9_74: 2390,   // ADDC
'h9_75: 2390,   // ADDC
'h9_76: 2390,   // ADDC
'h9_77: 2390,   // ADDC
'h9_78: 2390,   // ADDC
'h9_79: 2390,   // ADDC
'h9_7a: 2390,   // ADDC
'h9_7b: 2390,   // ADDC
'h9_7c: 2390,   // ADDC
'h9_7d: 2390,   // ADDC
'h9_7e: 2390,   // ADDC
'h9_7f: 2390,   // ADDC
'h9_80: 2390,   // ADDC
'h9_81: 2390,   // ADDC
'h9_82: 2390,   // ADDC
'h9_83: 2390,   // ADDC
'h9_84: 2390,   // ADDC
'h9_85: 2390,   // ADDC
'h9_86: 2390,   // ADDC
'h9_87: 2390,   // ADDC
'h9_88: 2390,   // ADDC
'h9_89: 2390,   // ADDC
'h9_8a: 2390,   // ADDC
'h9_8b: 2390,   // ADDC
'h9_8c: 2390,   // ADDC
'h9_8d: 2390,   // ADDC
'h9_8e: 2390,   // ADDC
'h9_8f: 2390,   // ADDC
'h9_90: 2390,   // ADDC
'h9_91: 2390,   // ADDC
'h9_92: 2390,   // ADDC
'h9_93: 2390,   // ADDC
'h9_94: 2390,   // ADDC
'h9_95: 2390,   // ADDC
'h9_96: 2390,   // ADDC
'h9_97: 2390,   // ADDC
'h9_98: 2390,   // ADDC
'h9_99: 2390,   // ADDC
'h9_9a: 2390,   // ADDC
'h9_9b: 2390,   // ADDC
'h9_9c: 2390,   // ADDC
'h9_9d: 2390,   // ADDC
'h9_9e: 2390,   // ADDC
'h9_9f: 2390,   // ADDC
'h9_a0: 2390,   // ADDC
'h9_a1: 2390,   // ADDC
'h9_a2: 2390,   // ADDC
'h9_a3: 2390,   // ADDC
'h9_a4: 2390,   // ADDC
'h9_a5: 2390,   // ADDC
'h9_a6: 2390,   // ADDC
'h9_a7: 2390,   // ADDC
'h9_a8: 2390,   // ADDC
'h9_a9: 2390,   // ADDC
'h9_aa: 2390,   // ADDC
'h9_ab: 2390,   // ADDC
'h9_ac: 2390,   // ADDC
'h9_ad: 2390,   // ADDC
'h9_ae: 2390,   // ADDC
'h9_af: 2390,   // ADDC
'h9_b0: 2390,   // ADDC
'h9_b1: 2390,   // ADDC
'h9_b2: 2390,   // ADDC
'h9_b3: 2390,   // ADDC
'h9_b4: 2390,   // ADDC
'h9_b5: 2390,   // ADDC
'h9_b6: 2390,   // ADDC
'h9_b7: 2390,   // ADDC
'h9_b8: 2390,   // ADDC
'h9_b9: 2390,   // ADDC
'h9_ba: 2390,   // ADDC
'h9_bb: 2390,   // ADDC
'h9_bc: 2390,   // ADDC
'h9_bd: 2390,   // ADDC
'h9_be: 2390,   // ADDC
'h9_bf: 2390,   // ADDC
'h9_c0: 2390,   // ADDC
'h9_c1: 2390,   // ADDC
'h9_c2: 2390,   // ADDC
'h9_c3: 2390,   // ADDC
'h9_c4: 2390,   // ADDC
'h9_c5: 2390,   // ADDC
'h9_c6: 2390,   // ADDC
'h9_c7: 2390,   // ADDC
'h9_c8: 2390,   // ADDC
'h9_c9: 2390,   // ADDC
'h9_ca: 2390,   // ADDC
'h9_cb: 2390,   // ADDC
'h9_cc: 2390,   // ADDC
'h9_cd: 2390,   // ADDC
'h9_ce: 2390,   // ADDC
'h9_cf: 2390,   // ADDC
'h9_d0: 2390,   // ADDC
'h9_d1: 2390,   // ADDC
'h9_d2: 2390,   // ADDC
'h9_d3: 2390,   // ADDC
'h9_d4: 2390,   // ADDC
'h9_d5: 2390,   // ADDC
'h9_d6: 2390,   // ADDC
'h9_d7: 2390,   // ADDC
'h9_d8: 2390,   // ADDC
'h9_d9: 2390,   // ADDC
'h9_da: 2390,   // ADDC
'h9_db: 2390,   // ADDC
'h9_dc: 2390,   // ADDC
'h9_dd: 2390,   // ADDC
'h9_de: 2390,   // ADDC
'h9_df: 2390,   // ADDC
'h9_e0: 2390,   // ADDC
'h9_e1: 2390,   // ADDC
'h9_e2: 2390,   // ADDC
'h9_e3: 2390,   // ADDC
'h9_e4: 2390,   // ADDC
'h9_e5: 2390,   // ADDC
'h9_e6: 2390,   // ADDC
'h9_e7: 2390,   // ADDC
'h9_e8: 2390,   // ADDC
'h9_e9: 2390,   // ADDC
'h9_ea: 2390,   // ADDC
'h9_eb: 2390,   // ADDC
'h9_ec: 2390,   // ADDC
'h9_ed: 2390,   // ADDC
'h9_ee: 2390,   // ADDC
'h9_ef: 2390,   // ADDC
'h9_f0: 2390,   // ADDC
'h9_f1: 2390,   // ADDC
'h9_f2: 2390,   // ADDC
'h9_f3: 2390,   // ADDC
'h9_f4: 2390,   // ADDC
'h9_f5: 2390,   // ADDC
'h9_f6: 2390,   // ADDC
'h9_f7: 2390,   // ADDC
'h9_f8: 2390,   // ADDC
'h9_f9: 2390,   // ADDC
'h9_fa: 2390,   // ADDC
'h9_fb: 2390,   // ADDC
'h9_fc: 2390,   // ADDC
'h9_fd: 2390,   // ADDC
'h9_fe: 2390,   // ADDC
'h9_ff: 2390,   // ADDC
'ha_00:    4,   // EXTC
'ha_16:  236,   // ASN
'ha_1c: 1594,   // EDN
'ha_1d: 1604,   // EBN
'ha_20:  243,   // ATI
'ha_21:  698,   // STI
'ha_22:  719,   // ITS
'ha_24:  247,   // MTJ
'ha_25:  250,   // JDM
'ha_27:  370,   // JBM
'ha_80:  245,   // ITA
'ha_81: 1606,   // YTA
'ha_82:  744,   // NTR
'ha_83:  749,   // RTE
'ha_84:  355,   // AAY
'ha_85:  357,   // AEY
'ha_86:  359,   // AOY
'ha_87:  474,   // RETS
'ha_90:  361,   // MCJ
'ha_91:  365,   // MSN
'ha_94:  385,   // MPAC
'ha_95:  395,   // MUNP
'ha_96:  481,   // ASNA
'ha_a1:  638,   // EXTF
'ha_a2:  404,   // ADI
'ha_a3:  406,   // ABI
'ha_a4:  408,   // IBA
'ha_a7: 1196,   // A/I
'ha_a8: 1151,   // A*I
'ha_a9:  410,   // AAI
'ha_aa:  412,   // AEI
'ha_ab:  414,   // AOI
'ha_b0:  644,   // NTA
'ha_b1:  654,   // NTSC
'ha_b2:  659,   // AEN
'ha_b3:  661,   // AAN
'ha_b4:  663,   // AON
'ha_fd: 1031,   // IJP
'ha_fe:  979,   // RET
'ha_ff:  969,   // HLT
'hb_00: 2390,   // ADDC
'hb_01: 2390,   // ADDC
'hb_02: 2390,   // ADDC
'hb_03: 2390,   // ADDC
'hb_04: 2390,   // ADDC
'hb_05: 2390,   // ADDC
'hb_06: 2390,   // ADDC
'hb_07: 2390,   // ADDC
'hb_08: 2390,   // ADDC
'hb_09: 2390,   // ADDC
'hb_0a: 2390,   // ADDC
'hb_0b: 2390,   // ADDC
'hb_0c: 2390,   // ADDC
'hb_0d: 2390,   // ADDC
'hb_0e: 2390,   // ADDC
'hb_0f: 2390,   // ADDC
'hb_10: 2390,   // ADDC
'hb_11: 2390,   // ADDC
'hb_12: 2390,   // ADDC
'hb_13: 2390,   // ADDC
'hb_14: 2390,   // ADDC
'hb_15: 2390,   // ADDC
'hb_16: 2390,   // ADDC
'hb_17: 2390,   // ADDC
'hb_18: 2390,   // ADDC
'hb_19: 2390,   // ADDC
'hb_1a: 2390,   // ADDC
'hb_1b: 2390,   // ADDC
'hb_1c: 2390,   // ADDC
'hb_1d: 2390,   // ADDC
'hb_1e: 2390,   // ADDC
'hb_1f: 2390,   // ADDC
'hb_20: 2390,   // ADDC
'hb_21: 2390,   // ADDC
'hb_22: 2390,   // ADDC
'hb_23: 2390,   // ADDC
'hb_24: 2390,   // ADDC
'hb_25: 2390,   // ADDC
'hb_26: 2390,   // ADDC
'hb_27: 2390,   // ADDC
'hb_28: 2390,   // ADDC
'hb_29: 2390,   // ADDC
'hb_2a: 2390,   // ADDC
'hb_2b: 2390,   // ADDC
'hb_2c: 2390,   // ADDC
'hb_2d: 2390,   // ADDC
'hb_2e: 2390,   // ADDC
'hb_2f: 2390,   // ADDC
'hb_30: 2390,   // ADDC
'hb_31: 2390,   // ADDC
'hb_32: 2390,   // ADDC
'hb_33: 2390,   // ADDC
'hb_34: 2390,   // ADDC
'hb_35: 2390,   // ADDC
'hb_36: 2390,   // ADDC
'hb_37: 2390,   // ADDC
'hb_38: 2390,   // ADDC
'hb_39: 2390,   // ADDC
'hb_3a: 2390,   // ADDC
'hb_3b: 2390,   // ADDC
'hb_3c: 2390,   // ADDC
'hb_3d: 2390,   // ADDC
'hb_3e: 2390,   // ADDC
'hb_3f: 2390,   // ADDC
'hb_40: 2390,   // ADDC
'hb_41: 2390,   // ADDC
'hb_42: 2390,   // ADDC
'hb_43: 2390,   // ADDC
'hb_44: 2390,   // ADDC
'hb_45: 2390,   // ADDC
'hb_46: 2390,   // ADDC
'hb_47: 2390,   // ADDC
'hb_48: 2390,   // ADDC
'hb_49: 2390,   // ADDC
'hb_4a: 2390,   // ADDC
'hb_4b: 2390,   // ADDC
'hb_4c: 2390,   // ADDC
'hb_4d: 2390,   // ADDC
'hb_4e: 2390,   // ADDC
'hb_4f: 2390,   // ADDC
'hb_50: 2390,   // ADDC
'hb_51: 2390,   // ADDC
'hb_52: 2390,   // ADDC
'hb_53: 2390,   // ADDC
'hb_54: 2390,   // ADDC
'hb_55: 2390,   // ADDC
'hb_56: 2390,   // ADDC
'hb_57: 2390,   // ADDC
'hb_58: 2390,   // ADDC
'hb_59: 2390,   // ADDC
'hb_5a: 2390,   // ADDC
'hb_5b: 2390,   // ADDC
'hb_5c: 2390,   // ADDC
'hb_5d: 2390,   // ADDC
'hb_5e: 2390,   // ADDC
'hb_5f: 2390,   // ADDC
'hb_60: 2390,   // ADDC
'hb_61: 2390,   // ADDC
'hb_62: 2390,   // ADDC
'hb_63: 2390,   // ADDC
'hb_64: 2390,   // ADDC
'hb_65: 2390,   // ADDC
'hb_66: 2390,   // ADDC
'hb_67: 2390,   // ADDC
'hb_68: 2390,   // ADDC
'hb_69: 2390,   // ADDC
'hb_6a: 2390,   // ADDC
'hb_6b: 2390,   // ADDC
'hb_6c: 2390,   // ADDC
'hb_6d: 2390,   // ADDC
'hb_6e: 2390,   // ADDC
'hb_6f: 2390,   // ADDC
'hb_70: 2390,   // ADDC
'hb_71: 2390,   // ADDC
'hb_72: 2390,   // ADDC
'hb_73: 2390,   // ADDC
'hb_74: 2390,   // ADDC
'hb_75: 2390,   // ADDC
'hb_76: 2390,   // ADDC
'hb_77: 2390,   // ADDC
'hb_78: 2390,   // ADDC
'hb_79: 2390,   // ADDC
'hb_7a: 2390,   // ADDC
'hb_7b: 2390,   // ADDC
'hb_7c: 2390,   // ADDC
'hb_7d: 2390,   // ADDC
'hb_7e: 2390,   // ADDC
'hb_7f: 2390,   // ADDC
'hb_80: 2390,   // ADDC
'hb_81: 2390,   // ADDC
'hb_82: 2390,   // ADDC
'hb_83: 2390,   // ADDC
'hb_84: 2390,   // ADDC
'hb_85: 2390,   // ADDC
'hb_86: 2390,   // ADDC
'hb_87: 2390,   // ADDC
'hb_88: 2390,   // ADDC
'hb_89: 2390,   // ADDC
'hb_8a: 2390,   // ADDC
'hb_8b: 2390,   // ADDC
'hb_8c: 2390,   // ADDC
'hb_8d: 2390,   // ADDC
'hb_8e: 2390,   // ADDC
'hb_8f: 2390,   // ADDC
'hb_90: 2390,   // ADDC
'hb_91: 2390,   // ADDC
'hb_92: 2390,   // ADDC
'hb_93: 2390,   // ADDC
'hb_94: 2390,   // ADDC
'hb_95: 2390,   // ADDC
'hb_96: 2390,   // ADDC
'hb_97: 2390,   // ADDC
'hb_98: 2390,   // ADDC
'hb_99: 2390,   // ADDC
'hb_9a: 2390,   // ADDC
'hb_9b: 2390,   // ADDC
'hb_9c: 2390,   // ADDC
'hb_9d: 2390,   // ADDC
'hb_9e: 2390,   // ADDC
'hb_9f: 2390,   // ADDC
'hb_a0: 2390,   // ADDC
'hb_a1: 2390,   // ADDC
'hb_a2: 2390,   // ADDC
'hb_a3: 2390,   // ADDC
'hb_a4: 2390,   // ADDC
'hb_a5: 2390,   // ADDC
'hb_a6: 2390,   // ADDC
'hb_a7: 2390,   // ADDC
'hb_a8: 2390,   // ADDC
'hb_a9: 2390,   // ADDC
'hb_aa: 2390,   // ADDC
'hb_ab: 2390,   // ADDC
'hb_ac: 2390,   // ADDC
'hb_ad: 2390,   // ADDC
'hb_ae: 2390,   // ADDC
'hb_af: 2390,   // ADDC
'hb_b0: 2390,   // ADDC
'hb_b1: 2390,   // ADDC
'hb_b2: 2390,   // ADDC
'hb_b3: 2390,   // ADDC
'hb_b4: 2390,   // ADDC
'hb_b5: 2390,   // ADDC
'hb_b6: 2390,   // ADDC
'hb_b7: 2390,   // ADDC
'hb_b8: 2390,   // ADDC
'hb_b9: 2390,   // ADDC
'hb_ba: 2390,   // ADDC
'hb_bb: 2390,   // ADDC
'hb_bc: 2390,   // ADDC
'hb_bd: 2390,   // ADDC
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
'hf_e5: 2390,   // ADDC
'hf_e6: 2390,   // ADDC
'hf_e7: 2390,   // ADDC
'hf_e8: 2390,   // ADDC
'hf_e9: 2390,   // ADDC
'hf_ea: 2390,   // ADDC
'hf_eb: 2390,   // ADDC
'hf_ec: 2390,   // ADDC
'hf_ed: 2390,   // ADDC
'hf_ee: 2390,   // ADDC
'hf_ef: 2390,   // ADDC
'hf_f0: 2390,   // ADDC
'hf_f1: 2390,   // ADDC
'hf_f2: 2390,   // ADDC
'hf_f3: 2390,   // ADDC
'hf_f4: 2390,   // ADDC
'hf_f5: 2390,   // ADDC
'hf_f6: 2390,   // ADDC
'hf_f7: 2390,   // ADDC
'hf_f8: 2390,   // ADDC
'hf_f9: 2390,   // ADDC
'hf_fa: 2390,   // ADDC
'hf_fb: 2390,   // ADDC
'hf_fc: 2390,   // ADDC
'hf_fd: 2390,   // ADDC
'hf_fe: 2390,   // ADDC
'hf_ff: 2390,   // ADDC
default:   6    // EXTDR
