besm6/micro-besm/microcode/rwiotab.v

// ПНА: память начальных адресов операций обмена с пультовым процессором
'h000: 1807,    // RW/IO + 17
'h001: 1807,    // RW/IO + 17
'h002: 1807,    // RW/IO + 17
'h003: 1807,    // RW/IO + 17
'h004: 1807,    // RW/IO + 17
'h005: 1807,    // RW/IO + 17
'h006: 1807,    // RW/IO + 17
'h007: 1807,    // RW/IO + 17
'h008: 1807,    // RW/IO + 17
'h009: 1807,    // RW/IO + 17
'h00a: 1807,    // RW/IO + 17
'h00b: 1807,    // RW/IO + 17
'h00c: 1807,    // RW/IO + 17
'h00d: 1807,    // RW/IO + 17
'h00e: 1807,    // RW/IO + 17
'h00f: 1807,    // RW/IO + 17
'h010: 1807,    // RW/IO + 17
'h011: 1807,    // RW/IO + 17
'h012: 1807,    // RW/IO + 17
'h013: 1807,    // RW/IO + 17
'h014: 1807,    // RW/IO + 17
'h015: 1807,    // RW/IO + 17
'h016: 1807,    // RW/IO + 17
'h017: 1807,    // RW/IO + 17
'h018: 1807,    // RW/IO + 17
'h019: 1807,    // RW/IO + 17
'h01a: 1807,    // RW/IO + 17
'h01b: 1807,    // RW/IO + 17
'h01c: 1807,    // RW/IO + 17
'h01d: 1807,    // RW/IO + 17
'h01e: 1807,    // RW/IO + 17
'h01f: 1807,    // RW/IO + 17
'h020: 1808,    // RW/IO + 18
'h021: 1808,    // RW/IO + 18
'h022: 1808,    // RW/IO + 18
'h023: 1808,    // RW/IO + 18
'h024: 1808,    // RW/IO + 18
'h025: 1808,    // RW/IO + 18
'h026: 1808,    // RW/IO + 18
'h027: 1808,    // RW/IO + 18
'h028: 1808,    // RW/IO + 18
'h029: 1808,    // RW/IO + 18
'h02a: 1808,    // RW/IO + 18
'h02b: 1808,    // RW/IO + 18
'h02c: 1808,    // RW/IO + 18
'h02d: 1808,    // RW/IO + 18
'h02e: 1808,    // RW/IO + 18
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
'h7f7: 1828,    // RW/IO + 38
'h7f8: 1828,    // RW/IO + 38
'h7f9: 1828,    // RW/IO + 38
'h7fa: 1828,    // RW/IO + 38
'h7fb: 1828,    // RW/IO + 38
'h7fc: 1828,    // RW/IO + 38
'h7fd: 1828,    // RW/IO + 38
'h7fe: 1828,    // RW/IO + 38
'h7ff: 1828,    // RW/IO + 38
