besm6/micro-besm/microcode/constants.v

       0: 64'h0000000000000001,    // CSERN
       1: 64'h0000000000000000,    // ZER
       2: 64'hffffffffffffffff,    // CFFF
       3: 64'haaaaaaaaaaaaaaaa,    // CAAA
       4: 64'h5555555555555555,    // C555
       5: 64'hf0f0f0f0f0f0f0f0,    // CF0
       6: 64'h0f0f0f0f0f0f0f0f,    // C0F
       7: 64'h00000000ffffffff,    // MH
       8: 64'hffffffff00000000,    // MNH
       9: 64'h000000000000ffff,    // MQ
      10: 64'hffffffffffff0000,    // MNQ
      11: 64'h00000000000000ff,    // MB
      12: 64'hffffffffffffff00,    // MNB
      13: 64'h0000000000000001,    // MF
      14: 64'hfffffffffffffffe,    // MNF
      15: 64'h000fffffffffffff,    // MM12
      16: 64'hfff0000000000000,    // MNM12
      17: 64'h0000000000000002,    // B2
      18: 64'h0000000000000004,    // B3
      19: 64'h0000000000000008,    // B4
      20: 64'h0000000000000010,    // B5
      21: 64'h0000000000000020,    // B6
      22: 64'h0000000000000040,    // B7
      23: 64'h0000000000000080,    // B8
      24: 64'h0000000000000100,    // B9
      25: 64'h0000000000000200,    // B10
      26: 64'h0000000000000400,    // B11
      27: 64'h0000000000000800,    // B12
      28: 64'h0000000000001000,    // B13
      29: 64'h0000000000002000,    // B14
      30: 64'h0000000000004000,    // B15
      31: 64'h0000000000008000,    // B16
      32: 64'h0000000000010000,    // B17
      33: 64'h0000000000020000,    // B18
      34: 64'h0000000000040000,    // B19
      35: 64'h0000000000080000,    // B20
      36: 64'h0000000000100000,    // B21
      37: 64'h0000000000200000,    // B22
      38: 64'h0000000000400000,    // B23
      39: 64'h0000000000800000,    // B24
      40: 64'h0000000001000000,    // B25
      41: 64'h0000000002000000,    // B26
      42: 64'h0000000004000000,    // B27
      43: 64'h0000000008000000,    // B28
      44: 64'h0000000010000000,    // B29
      45: 64'h0000000020000000,    // B30
      46: 64'h0000000040000000,    // B31
      47: 64'h0000000080000000,    // B32
      48: 64'h0000000100000000,    // B33
      49: 64'h0000000200000000,    // B34
      50: 64'h0000000400000000,    // B35
      51: 64'h0000000800000000,    // B36
      52: 64'h0000001000000000,    // B37
      53: 64'h0000002000000000,    // B38
      54: 64'h0000004000000000,    // B39
      55: 64'h0000008000000000,    // B40
      56: 64'h0000010000000000,    // B41
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
      80: 64'h0000000000000800,    // S0ZZZZ
      81: 64'h000000000000080c,    // SR12ZZ
      82: 64'h00000000000007f4,    // SL12ZZ
      83: 64'h0000000000000805,    // SR5ZZZ
      84: 64'h00000000000007fb,    // SL5ZZZ
      85: 64'h000000000000ff00,    // MB2ZZZ
      86: 64'h0000000000ff0000,    // MB3
      87: 64'h0000000000ffff00,    // MB23
      88: 64'h00000000ff0000ff,    // MNB23
      89: 64'h00000000000ffc00,    // MPG
      90: 64'h00000000000003ff,    // MWN
      91: 64'h00000000ffdff7ff,    // NTS
      92: 64'h0000000000200800,    // CTSZZZ
      93: 64'h0000000003c0b000,    // CEXTZZ
      94: 64'h0000000003e2b000,    // CINTZZ
      95: 64'h0000000000000003,    // C3
      96: 64'h000000000000000d,    // C13
      97: 64'h00000000000fffff,    // MADR
      98: 64'hfffffffffff00000,    // MNADR
      99: 64'h0000000000000401,    // PG1W1
     100: 64'h000000000000003f,    // M6B
     101: 64'h000000000000007f,    // M7B
     102: 64'hfffffffffffffc00,    // MIN1PG
     103: 64'h0000000000000001,    // C1
     104: 64'h0000000000000002,    // C2
     105: 64'h0000000000000004,    // C4
     106: 64'h0000000000000005,    // C5
     107: 64'h0000000000000006,    // C6
     108: 64'h0000000000000007,    // C7
     109: 64'h0000000000000008,    // C8
     110: 64'h0000000000000009,    // C9
     111: 64'h000000000000000a,    // C10
     112: 64'h000000000000000b,    // C11
     113: 64'h000000000000000c,    // C12
     114: 64'h000000000000000e,    // C14
     115: 64'h000000000000000f,    // C15
     116: 64'h0000000000000010,    // C16
     117: 64'h0000000000000011,    // C17
     118: 64'h0000000000000012,    // C18
     119: 64'h0000000000000013,    // C19
     120: 64'h0000000000000014,    // C20
     121: 64'h0000000000000015,    // C21
     122: 64'h0000000000000016,    // C22
     123: 64'h0000000000000017,    // C23
     124: 64'h0000000000000018,    // C24
     125: 64'h0000000000000019,    // C25
     126: 64'h000000000000001a,    // C26
     127: 64'h000000000000001b,    // C27
     128: 64'h000000000000001c,    // C28
     129: 64'h000000000000001d,    // C29
     130: 64'h000000000000001e,    // C30
     131: 64'h000000000000001f,    // C31
     132: 64'h0000000000000020,    // C32
     133: 64'h0000000000000021,    // C33
     134: 64'h0000000000000022,    // C34
     135: 64'h0000000000000023,    // C35
     136: 64'h0000000000000024,    // C36
     137: 64'h0000000000000025,    // C37
     138: 64'h0000000000000026,    // C38
     139: 64'h0000000000000027,    // C39
     140: 64'h0000000000000028,    // C40
     141: 64'h0000000000000029,    // C41
     142: 64'h000000000000002a,    // C42
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
     165: 64'h0000000007c5e000,    // CTEST
     166: 64'hfffffffffffffbff,    // CBFF
     167: 64'h00000000000000f8,    // CF8
     168: 64'h1010080310103009,    // COPC
     169: 64'h0000000000007000,    // CAK
     170: 64'h000000000001ffff,    // MAXA1
     171: 64'h00000000fffffffd,    // RSTA
     172: 64'h0000000000ff00ff,    // MTIME
     173: 64'h000000000000ff00,    // MB2
     174: 64'h00000000ffff0000,    // MQ2
     175: 64'h0000ffff00000000,    // MQ3
     176: 64'hffff000000000000,    // MQ4
     177: 64'hfffffffffffffffe,    // CFFFE
     178: 64'hfffffffffffffffc,    // CFFFC
     179: 64'hfffffffffffffff8,    // CFFF8
     180: 64'hffffffffffffffe0,    // CFFE0
     181: 64'hffffffffffffffc0,    // CFFC0
     182: 64'h0202020202020202,    // C0202
     183: 64'h0303030303030303,    // C0303
     184: 64'h3333333355555555,    // C3355
     185: 64'h0001000100010001,    // C0001
     186: 64'h0003000300030003,    // C0003
     187: 64'h8000800080008000,    // C8000
     188: 64'h0000000100000001,    // C0101
     189: 64'haaaaaaaa00000000,    // CAA00
     190: 64'h55555555ffffffff,    // C55FF
     191: 64'h000000005555aaaa,    // C005A
     192: 64'hffff555533330000,    // CF530
     193: 64'h0000000000400040,    // COPC1
     194: 64'h0000000000800080,    // COPC2
     195: 64'h0000000000300030,    // R0CH0
     196: 64'h0000000000700070,    // R0CH1
     197: 64'h0000000000b000b0,    // R0CH2
     198: 64'h0000000000340034,    // R2CH0
     199: 64'h0000000000740074,    // R2CH1
     200: 64'h0000000000b400b4,    // R2CH2
     201: 64'h0000000000360036,    // R3CH0
     202: 64'h0000000000760076,    // R3CH1
     203: 64'h0000000000b600b6,    // R3CH2
     204: 64'h7800000000000000,    // MD
     205: 64'h87ffffffffffffff,    // MND
     206: 64'h001fffffffffffff,    // MM
     207: 64'hffe0000000000000,    // MNM
     208: 64'h87fffffffffffc00,    // M48ZZZ
     209: 64'h0000000000007fff,    // M15
     210: 64'hffffffffffff8000,    // MN15
     211: 64'h000000003800001c,    // MFLFL
     212: 64'h00000000000003c0,    // MIND
     213: 64'h00000000c7fffc23,    // MCRR
     214: 64'h0000000038000000,    // MTG
     215: 64'h00000000c7fffc00,    // MXTR
     216: 64'hf000000000000000,    // IR15L
     217: 64'h00000000f0000000,    // IR15R
     218: 64'h8700000000000000,    // IR15LE
     219: 64'h0000000f00000000,    // IR15RE
     220: 64'h00000000000007e0,    // MGN
     221: 64'h00000000000003e0,    // MGN5
     222: 64'h0000000000000fff,    // MPP
     223: 64'h0000000003c41004,    // CEXTYY
     224: 64'h0000000003e63004,    // CINTYY
     225: 64'h0000000000220800,    // CTS
     226: 64'h0000000000000420,    // SR32
     227: 64'h00000000000003e0,    // SL32
     228: 64'h00000000fff80800,    // JMPI
     229: 64'h00000000fff80840,    // ASEM
     230: 64'h00000000fff80850,    // JMPEXT
     231: 64'h0000000000000041,    // H41
     232: 64'h0000000000000042,    // H42
     233: 64'h0000000000000043,    // H43
     234: 64'h0000000000000044,    // H44
     235: 64'h0000000000000045,    // H45
     236: 64'h0000000000000046,    // H46
     237: 64'h0000000000000047,    // H47
     238: 64'h0000000000000048,    // H48
     239: 64'h0000000000000049,    // H49
     240: 64'h000000000000004a,    // H4A
     241: 64'h000000000000004b,    // H4B
     242: 64'h000000000000004c,    // H4C
     243: 64'h000000000000004d,    // H4D
     244: 64'h000000000000004e,    // H4E
     245: 64'h000000000000004f,    // H4F
     246: 64'h0000000000000050,    // H50
     247: 64'h0000000000000051,    // H51
     248: 64'h0000000000000052,    // H52
     249: 64'h0000000000000053,    // H53
     250: 64'h0000000000000054,    // H54
     251: 64'h0000000000000055,    // H55
     252: 64'h0000000000000056,    // H56
     253: 64'h0000000000000057,    // H57
     254: 64'h0000000000000058,    // H58
     255: 64'h0000000000000059,    // H59
     256: 64'h000000000000005a,    // H5A
     257: 64'h000000000000005b,    // H5B
     258: 64'h000000000000005c,    // H5C
     259: 64'h000000000000005d,    // H5D
     260: 64'h000000000000005e,    // H5E
     261: 64'h000000000000005f,    // H5F
     262: 64'h0000000000000060,    // H60
     263: 64'h0000000000000061,    // H61
     264: 64'h0000000000000062,    // H62
     265: 64'h0000000000000063,    // H63
     266: 64'h0000000000000064,    // H64
     267: 64'h0000000000000065,    // H65
     268: 64'h0000000000000066,    // H66
     269: 64'h0000000000000067,    // H67
     270: 64'h0000000000000068,    // H68
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
     326: 64'h00000000000000a0,    // HA0
     327: 64'h00000000000000a1,    // HA1
     328: 64'h00000000000000a2,    // HA2
     329: 64'h00000000000000a3,    // HA3
     330: 64'h00000000000000a4,    // HA4
     331: 64'h00000000000000a5,    // HA5
     332: 64'h00000000000000a6,    // HA6
     333: 64'h00000000000000a7,    // HA7
     334: 64'h00000000000000a8,    // HA8
     335: 64'h00000000000000a9,    // HA9
     336: 64'h00000000000000aa,    // HAA
     337: 64'h00000000000000ab,    // HAB
     338: 64'h00000000000000ac,    // HAC
     339: 64'h00000000000000ad,    // HAD
     340: 64'h00000000000000ae,    // HAE
     341: 64'h00000000000000af,    // HAF
     342: 64'h00000000000000b0,    // HB0
     343: 64'h00000000000000b1,    // HB1
     344: 64'h00000000000000b2,    // HB2
     345: 64'h00000000000000b3,    // HB3
     346: 64'h00000000000000b4,    // HB4
     347: 64'h00000000000000b5,    // HB5
     348: 64'h00000000000000b6,    // HB6
     349: 64'h00000000000000b7,    // HB7
     350: 64'h00000000000000b8,    // HB8
     351: 64'h00000000000000b9,    // HB9
     352: 64'h00000000000000ba,    // HBA
     353: 64'h00000000000000bb,    // HBB
     354: 64'h00000000000000bc,    // HBC
     355: 64'h00000000000000bd,    // HBD
     356: 64'h00000000000000be,    // HBE
     357: 64'h00000000000000bf,    // HBF
     358: 64'h00000000000000c0,    // HC0
     359: 64'h00000000000000c1,    // HC1
     360: 64'h00000000000000c2,    // HC2
     361: 64'h00000000000000c3,    // HC3
     362: 64'h00000000000000c4,    // HC4
     363: 64'h00000000000000c5,    // HC5
     364: 64'h00000000000000c6,    // HC6
     365: 64'h00000000000000c7,    // HC7
     366: 64'h00000000000000c8,    // HC8
     367: 64'h00000000000000c9,    // HC9
     368: 64'h00000000000000ca,    // HCA
     369: 64'h00000000000000cb,    // HCB
     370: 64'h00000000000000cc,    // HCC
     371: 64'h00000000000000cd,    // HCD
     372: 64'h00000000000000ce,    // HCE
     373: 64'h00000000000000cf,    // HCF
     374: 64'h00000000000000d0,    // HD0
     375: 64'h00000000000000d1,    // HD1
     376: 64'h00000000000000d2,    // HD2
     377: 64'h00000000000000d3,    // HD3
     378: 64'h00000000000000d4,    // HD4
     379: 64'h00000000000000d5,    // HD5
     380: 64'h00000000000000d6,    // HD6
     381: 64'h00000000000000d7,    // HD7
     382: 64'h00000000000000d8,    // HD8
     383: 64'h00000000000000d9,    // HD9
     384: 64'h00000000000000da,    // HDA
     385: 64'h00000000000000db,    // HDB
     386: 64'h00000000000000dc,    // HDC
     387: 64'h00000000000000dd,    // HDD
     388: 64'h00000000000000de,    // HDE
     389: 64'h00000000000000df,    // HDF
     390: 64'h00000000000000e0,    // HE0
     391: 64'h00000000000000e1,    // HE1
     392: 64'h00000000000000e2,    // HE2
     393: 64'h00000000000000e3,    // HE3
     394: 64'h00000000000000e4,    // HE4
     395: 64'h00000000000000e5,    // HE5
     396: 64'h00000000000000e6,    // HE6
     397: 64'h00000000000000e7,    // HE7
     398: 64'h00000000000000e8,    // HE8
     399: 64'h00000000000000e9,    // HE9
     400: 64'h00000000000000ea,    // HEA
     401: 64'h00000000000000eb,    // HEB
     402: 64'h00000000000000ec,    // HEC
     403: 64'h00000000000000ed,    // HED
     404: 64'h00000000000000ee,    // HEE
     405: 64'h00000000000000ef,    // HEF
     406: 64'h00000000000000f0,    // HF0
     407: 64'h00000000000000f1,    // HF1
     408: 64'h00000000000000f2,    // HF2
     409: 64'h00000000000000f3,    // HF3
     410: 64'h00000000000000f4,    // HF4
     411: 64'h00000000000000f5,    // HF5
     412: 64'h00000000000000f6,    // HF6
     413: 64'h00000000000000f7,    // HF7
     414: 64'h00000000000000f8,    // HF8
     415: 64'h00000000000000f9,    // HF9
     416: 64'h00000000000000fa,    // HFA
     417: 64'h00000000000000fb,    // HFB
     418: 64'h00000000000000fc,    // HFC
     419: 64'h00000000000000fd,    // HFD
     420: 64'h00000000000000fe,    // HFE
     421: 64'h0000000003c7f000,    // CINI
     422: 64'h00000000fff80860,    // JMPINI
     423: 64'h87fffffffffff000,    // M48
     424: 64'h0000000000000000,    // CPN
     425: 64'h0000018000000000,    // PROGR
     426: 64'h0000000003e41000,    // CMONO
     427: 64'h0000000021003004,    // CEXT
     428: 64'h0000000021043004,    // CEXTW
     429: 64'h0000000023227004,    // CINT
     430: 64'hffffffffffffe000,    // M51L
     431: 64'hfffffffffffff000,    // M52L
     432: 64'hfffffffffffff800,    // M53L
     433: 64'hfffffffffffffc00,    // M54L
     434: 64'hfffffffffffffe00,    // M55L
     435: 64'h003fffffffffffff,    // M54R
     436: 64'hffffffffffffff99,    // MN103
     437: 64'hffffffffffffff98,    // MN104
     438: 64'hffffffffffffff97,    // MN105
     439: 64'hffffffffffffffc3,    // MN61
     440: 64'hffffffffffffffc2,    // MN62
     441: 64'hffffffffffffffc1,    // MN63
