besm6/micro-besm/rtl/extbus.sv

//
// External bus interface, based on K1802BB1 four-port 4-bit RAM chip.
//
// Copyright (c) 2016 Serge Vakulenko
//
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
`default_nettype none

module extbus(
    input  wire         clk,
    input  wire  [63:0] DA,     // A data bus input...
    output logic [63:0] oDA,    // ...and output (tag from RG2)
    input  wire  [71:0] DB,     // B data bus input...
    output logic [71:0] oDB,    // ...and output
    input  wire  [71:0] DX,     // X data bus input...
    output logic [71:0] oDX,    // ...and output

    input  wire   [1:0] AA,     // A address input
    input  wire   [1:0] AB,     // B address input
    input  wire   [1:0] AX,     // X address input

    input  wire         ECA,    // A port enable
    input  wire         ECB,    // B data port enable
    input  wire         ECBTAG, // B tag port enable
    input  wire         ECX,    // X port enable

    input  wire         WA,     // A write enable
    input  wire         WB,     // B write enable
    input  wire         WX,     // X write enable

    output logic [63:0] iword,  // RG1 data output
    output logic  [7:0] itag,   // RG1 tag output
    output logic  [7:0] dtag    // RG2 tag output
);
timeunit 1ns / 10ps;

wire [1:0] AC  = 2'b01;         // C address: select RG1
wire       ECC = '1;            // C port always enabled
wire       WC  = '0;            // no write on C port

// Inverted output data
logic [71:0] onDA;
logic [71:0] onDB;
logic [71:0] onDC;
logic [71:0] onDX;

assign oDA   = ~onDA[63:0];
assign dtag  = ~onDA[71:64];

assign oDB   = ~onDB;

assign iword = ~onDC[63:0];
assign itag  = ~onDC[71:64];

assign oDX   = ~onDX;

//
// Data bus 63:0
//
k1802bb1 b0_3  (clk,
                ~DA[3:0],   onDA[3:0],
                ~DB[3:0],   onDB[3:0],
                4'b1111,    onDC[3:0],
                ~DX[3:0],   onDX[3:0],
                AA,   AB,   AC,   AX,
                ~ECA, ~ECB, ~ECC, ~ECX,
                ~WA,  ~WB,  ~WC,  ~WX,
                WA,   WB,   WC,   WX,
                '0, , );
k1802bb1 b4_7  (clk,
                ~DA[7:4],   onDA[7:4],
                ~DB[7:4],   onDB[7:4],
                4'b1111,    onDC[7:4],
                ~DX[7:4],   onDX[7:4],
                AA,   AB,   AC,   AX,
                ~ECA, ~ECB, ~ECC, ~ECX,
                ~WA,  ~WB,  ~WC,  ~WX,
                WA,   WB,   WC,   WX,
                '0, , );
k1802bb1 b8_11 (clk,
                ~DA[11:8],  onDA[11:8],
                ~DB[11:8],  onDB[11:8],
                4'b1111,    onDC[11:8],
                ~DX[11:8],  onDX[11:8],
                AA,   AB,   AC,   AX,
                ~ECA, ~ECB, ~ECC, ~ECX,
                ~WA,  ~WB,  ~WC,  ~WX,
                WA,   WB,   WC,   WX,
                '0, , );
k1802bb1 b12_15(clk,
                ~DA[15:12], onDA[15:12],
                ~DB[15:12], onDB[15:12],
                4'b1111,    onDC[15:12],
                ~DX[15:12], onDX[15:12],
                AA,   AB,   AC,   AX,
                ~ECA, ~ECB, ~ECC, ~ECX,
                ~WA,  ~WB,  ~WC,  ~WX,
                WA,   WB,   WC,   WX,
                '0, , );
k1802bb1 b16_19(clk,
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
                4'b1111,    onDC[63:60],
                ~DX[63:60], onDX[63:60],
                AA,   AB,   AC,   AX,
                ~ECA, ~ECB, ~ECC, ~ECX,
                ~WA,  ~WB,  ~WC,  ~WX,
                WA,   WB,   WC,   WX,
                '0, , );

//
// Tag 71:64
// On port A, always read a tag from RG2.
//
k1802bb1 b64_67(clk,
                4'b1111,    onDA[67:64],
                ~DB[67:64], onDB[67:64],
                4'b1111,    onDC[67:64],
                ~DX[67:64], onDX[67:64],
                2'd2, AB,      AC,   AX,
                '0,   ~ECBTAG, ~ECC, ~ECX,
                '1,   ~WB,     ~WC,  ~WX,
                '0,   WB,      WC,   WX,
                '0, , );
k1802bb1 b68_71(clk,
                4'b1111,    onDA[71:68],
                ~DB[71:68], onDB[71:68],
                4'b1111,    onDC[71:68],
                ~DX[71:68], onDX[71:68],
                2'd2, AB,      AC,   AX,
                '0,   ~ECBTAG, ~ECC, ~ECX,
                '1,   ~WB,     ~WC,  ~WX,
                '0,   WB,      WC,   WX,
                '0, , );

endmodule
