besm6/micro-besm/rtl/datapath.sv

//
// 64-bit wide datapath based on Am2901, Am2902 and Am2904
//
// Copyright (c) 2016 Serge Vakulenko
//
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
`default_nettype none

module datapath(
    // Signals for am2901
    input  wire         clk,    // Clock
    input  wire   [8:0] Ialu,   // ALU instruction, from ALUD, FUNC and ALUS
    input  wire   [3:0] A,      // A register address, from RA
    input  wire   [3:0] B,      // B register address, from RB
    input  wire  [63:0] D,      // D bus input
    input  wire         Cin,    // Carry input, from COND mux
    input  wire         mode64, // 64-bit mode flag, from H
    output logic [63:0] oYalu,  // Y bus output from ALU

    // Signals for am2904
    input  wire  [12:0] Iss,    // Status/Shift instruction, from SHMUX and STOPC
    input  wire         nCEM,   // Machine status register enable, from CEM
    input  wire         nCEN,   // Micro status register enable, from CEN
    input  wire   [3:0] Yss,    // Y bus input
    output logic  [3:0] oYss,   // Y bus output from Status/Shift
    output logic        CT      // Conditional test output
);
timeunit 1ns / 10ps;

// Internal carry signals
logic c0, c4, c8, c12, c16, c20, c24, c28, c32, c36, c40, c44, c48, c52, c56, c60, c64;

// Internal shift signals
logic r3, r7, r11, r15, r19, r23, r27, r31, r35, r39, r43, r47, r51, r55, r59, r63;
logic r4, r8, r12, r16, r20, r24, r28, r32, r36, r40, r44, r48, r52, r56, r60;
logic q3, q7, q11, q15, q19, q23, q27, q31, q35, q39, q43, q47, q51, q55, q59, q63;
logic q4, q8, q12, q16, q20, q24, q28, q32, q36, q40, q44, q48, q52, q56, q60;

// Internal zero signals
logic z3_0, z7_4, z11_8, z15_12, z19_16, z23_20, z27_24, z31_28;
logic z35_32, z39_36, z43_40, z47_44, z51_48, z55_52, z59_56, z63_60;
logic z32, z64;

// Internal sign signals
logic n32, n64;

// Internal overflow signals
logic v32, v64;

// Status signals for am2904
logic C, V, N, Z;

// Shift signals for am2904
logic PR0, PQ0, PRH, PQH, PR31, PQ31, oR0, oQ0, oRH, oQH;

// Generate and propagate signals for Am2902
logic nG0,  nG4,  nG8,  nG12, nG16, nG20, nG24, nG28,
      nG32, nG36, nG40, nG44, nG48, nG52, nG56, nG60;
logic nP0,  nP4,  nP8,  nP12, nP16, nP20, nP24, nP28,
      nP32, nP36, nP40, nP44, nP48, nP52, nP56, nP60;
logic nGx0, nGx1, nGx2, nGx3, nPx0, nPx1, nPx2, nPx3;

// Data signals for am2904
logic Yz, Yn, Yovr, Yc, oYz, oYn, oYovr, oYc;

// Disable modification of upper half in 32-bit mode
logic [8:0] Ihi;
assign Ihi = { mode64 ? Ialu[8:6] : 3'b001, Ialu[5:0] };

// Сигналами I0-I8, А0-А3, В0-В3, /ОЕ, С0 управляет
// микропрограмма; сигналы D0-D3 поступают с входной шины D ЦП;
// У0-У3 выходят на шину У ЦП; сигналы С4, F3, OVR, Z, R0, R3,
// Q0, Q3 передаются на схему управления состоянием и сдвигами
// К1804ВР2, и далее - на мультиплексор условий; /Р и G
// используются для формирования ускоренного переноса.
am2901 p3_0  (Ialu, A, B, D[3:0],   oYalu[3:0],   PR0, r4,  PQ0, q4,  oR0, r3,  oQ0, q3,  clk, c0,  ,    nG0,  nP0,  ,    ,    z3_0);
am2901 p7_4  (Ialu, A, B, D[7:4],   oYalu[7:4],   r3,  r8,  q3,  q8,  r4,  r7,  q4,  q7,  clk, c4,  ,    nG4,  nP4,  ,    ,    z7_4);
am2901 p11_8 (Ialu, A, B, D[11:8],  oYalu[11:8],  r7,  r12, q7,  q12, r8,  r11, q8,  q11, clk, c8,  ,    nG8,  nP8,  ,    ,    z11_8);
am2901 p15_12(Ialu, A, B, D[15:12], oYalu[15:12], r11, r16, q11, q16, r12, r15, q12, q15, clk, c12, ,    nG12, nP12, ,    ,    z15_12);
am2901 p19_16(Ialu, A, B, D[19:16], oYalu[19:16], r15, r20, q15, q20, r16, r19, q16, q19, clk, c16, ,    nG16, nP16, ,    ,    z19_16);
am2901 p23_20(Ialu, A, B, D[23:20], oYalu[23:20], r19, r24, q19, q24, r20, r23, q20, q23, clk, c20, ,    nG20, nP20, ,    ,    z23_20);
am2901 p27_24(Ialu, A, B, D[27:24], oYalu[27:24], r23, r28, q23, q28, r24, r27, q24, q27, clk, c24, ,    nG24, nP24, ,    ,    z27_24);
am2901 p31_28(Ialu, A, B, D[31:28], oYalu[31:28], r27, PR31,q27, PQ31,r28, r31, q28, q31, clk, c28, ,    nG28, nP28, v32, n32, z31_28);
am2901 p35_32(Ihi,  A, B, D[35:32], oYalu[35:32], r31, r36, q31, q36, r32, r35, q32, q35, clk, c32, ,    nG32, nP32, ,    ,    z35_32);
am2901 p39_36(Ihi,  A, B, D[39:36], oYalu[39:36], r35, r40, q35, q40, r36, r39, q36, q39, clk, c36, ,    nG36, nP36, ,    ,    z39_36);
am2901 p43_40(Ihi,  A, B, D[43:40], oYalu[43:40], r39, r44, q39, q44, r40, r43, q40, q43, clk, c40, ,    nG40, nP40, ,    ,    z43_40);
am2901 p47_44(Ihi,  A, B, D[47:44], oYalu[47:44], r43, r48, q43, q48, r44, r47, q44, q47, clk, c44, ,    nG44, nP44, ,    ,    z47_44);
am2901 p51_48(Ihi,  A, B, D[51:48], oYalu[51:48], r47, r52, q47, q52, r48, r51, q48, q51, clk, c48, ,    nG48, nP48, ,    ,    z51_48);
am2901 p55_52(Ihi,  A, B, D[55:52], oYalu[55:52], r51, r56, q51, q56, r52, r55, q52, q55, clk, c52, ,    nG52, nP52, ,    ,    z55_52);
am2901 p59_56(Ihi,  A, B, D[59:56], oYalu[59:56], r55, r60, q55, q60, r56, r59, q56, q59, clk, c56, ,    nG56, nP56, ,    ,    z59_56);
am2901 p63_60(Ihi,  A, B, D[63:60], oYalu[63:60], r59, PRH, q59, PQH, r60, r63, q60, q63, clk, c60, c64, nG60, nP60, v64, n64, z63_60);

// Global zero flag
assign z32 = z3_0   & z7_4   & z11_8  & z15_12 &
             z19_16 & z23_20 & z27_24 & z31_28;
assign z64 = z32 &
             z35_32 & z39_36 & z43_40 & z47_44 &
             z51_48 & z55_52 & z59_56 & z63_60;

// Carry lookahead
am2902 s0(c0,  nG0,  nP0,  nG4,  nP4,  nG8,  nP8,  nG12, nP12, c4,  c8,  c12, nGx0, nPx0);
am2902 s1(c16, nG16, nP16, nG20, nP20, nG24, nP24, nG28, nP28, c20, c24, c28, nGx1, nPx1);
am2902 s2(c32, nG32, nP32, nG36, nP36, nG40, nP40, nG44, nP44, c36, c40, c44, nGx2, nPx2);
am2902 s3(c48, nG48, nP48, nG52, nP52, nG56, nP56, nG60, nP60, c52, c56, c60, nGx3, nPx3);
am2902 sx(c0,  nGx0, nPx0, nGx1, nPx1, nGx2, nPx2, nGx3, nPx3, c16, c32, c48, ,     );

// Выход кода условия СТ подается
// на мультиплексор условий. Входы /OEy, /EZ, /ЕС, /EN, /EV, СХ,
// /ОЕСТ заземлены. Управление входом /SE осуществляется инверсным
// сигналом I8 МПС, I10 соединяется со входом I7 МПС. Сигналами
// /СЕМ и /CEN управляет микропрограмма.
am2904 status(
    Iss, clk, nCEM, nCEN,
    C, V, N, Z, '0, '0, '0, '0,
    Yz, Yc, Yn, Yovr, oYz, oYc, oYn, oYovr,
    CT,
    Cin, c0,
    !Ialu[8],
    oR0, oRH, oQ0, oQH, PR0, PRH, PQ0, PQH);

// Выходы признаков состояния старшей МПС С4, OVR, F3, Z соединены
// с соответствующими входами признаков состояния СУСС. При этом
// старшей может считаться МПС, содержащая 32-28 или 64-60 разряды
// в зависимости от типа операций, производимых в АЛУ.
assign Z = mode64 ? z64 : z32;
assign N = mode64 ? n64 : n32;
assign V = mode64 ? v64 : v32;
assign C = mode64 ? c64 : c32;

// Switch shift signals based on 32/64 bit mode
assign oRH  = mode64 ? r63 : r31;
assign oQH  = mode64 ? q63 : q31;
assign PR31 = mode64 ? r32 : PRH;
assign PQ31 = mode64 ? q32 : PQH;

// Двунаправленная шина У (УС, YN, YV, YZ) соединена через ШФ со
// входной шиной D ЦП для выдачи информации из СУСС, и с выходной
// шиной У для чтения информации.
assign Yovr = Yss[0];
assign Yc   = Yss[1];
assign Yn   = Yss[2];
assign Yz   = Yss[3];

assign oYss[0] = oYovr;
assign oYss[1] = oYc;
assign oYss[2] = oYn;
assign oYss[3] = oYz;

endmodule
