besm6/micro-besm/rtl/tmemory.sv

//
// 1Mword of tagged RAM
//
// Copyright (c) 2016 Serge Vakulenko
//
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
`default_nettype none

module tmemory(
    input  wire         clk,            // clock
    input  wire  [63:0] i_ad,           // address/data input
    input  wire   [7:0] i_tag,          // tag bus input
    input  wire         i_astb,         // address strobe
    input  wire         i_rd,           // read op
    input  wire         i_wr,           // write op
    input  wire         i_wforce,       // ignore write protection TODO
    output logic [63:0] o_data,         // data bus input
    output logic  [7:0] o_tag           // tag output
);
timeunit 1ns / 10ps;

logic [63:0] mem[1024*1024];            // main RAM
logic  [7:0] tag[1024*1024];            // tags
logic [19:0] waddr;                     // latched word address
logic [19:0] laddr;                     // last r/w address

function [7:0] get_tag(input [19:0] addr);
    case (addr)
    'hfffff: return 0;                  // read Hamming syndrome
    'hffffe: return 0;                  // read address latch
    'hffffd: return 0;                  // error correction mode
    default: return tag[addr];          // memory load
    endcase
endfunction

always @(posedge clk) begin
    if (i_astb) begin
        //
        // Address latch.
        //
        laddr = waddr;                  // remember address of last r/w
        waddr = i_ad[19:0];             // address latch
        o_tag = get_tag(waddr);         // update tag early, for write protection

    end else if (i_rd) begin
        //
        // Memory load.
        //
        case (waddr)
        'hfffff: o_data = 0;            // read Hamming syndrome
        'hffffe: o_data = laddr;        // read address latch
        'hffffd: o_data = 0;            // error correction mode
        default: begin                  // memory load
                o_data = mem[waddr];
                o_tag = get_tag(waddr);

                waddr = waddr + 1;      // increment address for batch mode
            end
        endcase

    end else if (i_wr & (i_wforce | !o_tag[3])) begin
        //
        // Memory store.
        // Tag bit 3 protects the word from write.
        // Signal i_wforce overrides the protection.
        //
        mem[waddr] = i_ad;              // memory store
        tag[waddr] = i_tag;

        waddr = waddr + 1;              // increment address for batch mode
        o_tag = get_tag(waddr);         // get next tag, for write protection
    end
end

endmodule
