besm6/micro-besm/microcode/grouptab.v

// ПНА групп: память начальных адресов для условных операций
'h00: 2149,     // UZSZER
'h01: 2152,     // UZSLOG
'h02: 2150,     // UZSMUL
'h03: 2150,     // UZSMUL
'h04: 2148,     // UZSADD
'h05: 2148,     // UZSADD
'h06: 2148,     // UZSADD
'h07: 2148,     // UZSADD
'h08: 2134,     // JNZ
'h09: 2143,     // UZALOG
'h0a: 2142,     // UZAMUL
'h0b: 2142,     // UZAMUL
'h0c: 2133,     // UZAADD
'h0d: 2133,     // UZAADD
'h0e: 2133,     // UZAADD
'h0f: 2133,     // UZAADD
'h10: 2139,     // UIAZER
'h11: 2146,     // UIALOG
'h12: 2145,     // UIAMUL
'h13: 2145,     // UIAMUL
'h14: 2137,     // UIAADD
'h15: 2137,     // UIAADD
'h16: 2137,     // UIAADD
'h17: 2137,     // UIAADD
'h18: 2123,     // YTAMUL
'h19: 2124,     // YTALOG
'h1a: 2123,     // YTAMUL
'h1b: 2123,     // YTAMUL
'h1c: 2123,     // YTAMUL
'h1d: 2123,     // YTAMUL
'h1e: 2123,     // YTAMUL
'h1f: 2123,     // YTAMUL
