besm6/micro-besm/microcode/intrtab.v

// ПНА прерываний: память начальных адресов для переходов при внешних прерываниях
'h00: 2154,     // INT/RE + 1
'h01: 2156,     // INT/RE + 3
'h02: 2158,     // INT/RE + 5
'h03: 2160,     // INT/RE + 7
'h04: 2162,     // INT/RE + 9
'h05: 2164,     // INT/RE + 11
'h06: 2166,     // INT/RE + 13
'h07: 2168,     // INT/RE + 15
'h08: 2170,     // INT/RE + 17
'h09: 2172,     // INT/RE + 19
'h0a: 2174,     // INT/RE + 21
'h0b: 2176,     // INT/RE + 23
'h0c: 2178,     // INT/RE + 25
'h0d: 2180,     // INT/RE + 27
'h0e: 2182,     // INT/RE + 29
'h0f: 2184,     // INT/RE + 31
'h10: 2186,     // INT/RE + 33
'h11: 2188,     // INT/RE + 35
'h12: 2190,     // INT/RE + 37
'h13: 2192,     // INT/RE + 39
'h14: 2194,     // INT/RE + 41
'h15: 2196,     // INT/RE + 43
'h16: 2198,     // INT/RE + 45
'h17: 2200,     // INT/RE + 47
'h18: 2202,     // INT/RE + 49
'h19: 2204,     // INT/RE + 51
'h1a: 2206,     // INT/RE + 53
'h1b: 2208,     // INT/RE + 55
'h1c: 2210,     // INT/RE + 57
'h1d: 2212,     // INT/RE + 59
'h1e: 2214,     // INT/RE + 61
'h1f: 2216,     // INT/RE + 63
