besm6/micro-besm/microcode/tests/intrtest.v

// INTRPT
       0: 112'h30030405000a2000005003300000,    // a= CMEM1.INTRPT
       1: 112'h14490405000a20000050033002c0,    // a= ADRF00
// OЗY1
       2: 112'h30030405000a2000005003300000,    // a= CMEM1.INTRPT
// CMEM1.INTRPT
       3: 112'he127e475000a20600050033b0800,
       4: 112'h13640e7e800a20000050033002c0,    // a= INITSM
       5: 112'he0a5cc74800a2060005003300000,
       6: 112'he001cdd4c80a2060005003300000,
       7: 112'he001ef54c80a2061805003300000,
       8: 112'h13b50405000a2000005003300000,    // a= RDADR
       9: 112'h13ac0405000a2000005003300000,    // a= RDDAT
// CCM1.INTRPT
      10: 112'he000e445180a2004005003300640,
      11: 112'he000e44d280a200000500f300000,
      12: 112'he000e445300a2000005007320000,
      13: 112'he000c405000a200014500c340000,
// WAM1.INTRPT
      14: 112'h300e0405000a200000520330002a,    // a= WAM1.INTRPT
      15: 112'h40022c3e820a20000050033b08c0,
      16: 112'h8000c405000a2000005003300000,
      17: 112'h300a0405000a2000005003300026,    // a= CCM1.INTRPT
// STPM1.INTRPT
      18: 112'h30120405000a2000005023300000,    // a= STPM1.INTRPT
// OЗY2
      19: 112'h30140405000a2000005003300000,    // a= CMEM2.INTRPT
// CMEM2.INTRPT
      20: 112'he128e475000a20600050033b0800,
      21: 112'h13640e7e800a20000050033002c0,    // a= INITSM
      22: 112'he0a5cc74800a2060005003300000,
      23: 112'he001cdd4c80a2060005003300000,
      24: 112'he001ef54c80a2061805003300000,
      25: 112'h13b50405000a2005005003300000,    // a= RDADR
// CCM2.INTRPT
      26: 112'he000e445180a2004005003300640,
      27: 112'he00bcc7b800a206012500c340000,
// WAM2.INTRPT
      28: 112'h301c0405000a200000520330002a,    // a= WAM2.INTRPT
      29: 112'he000cc78000a2005005003a00000,
      30: 112'h13b00e58b80a2048205002320001,    // a= OUTDAT
      31: 112'h40022c3e820a20000050033b08c0,
      32: 112'h8000c405000a2000005003300000,
      33: 112'h301a0405000a2000005003300026,    // a= CCM2.INTRPT
// STPM2.INTRPT
      34: 112'h30220405000a2000005023300000,    // a= STPM2.INTRPT
// OЗY3
      35: 112'h30240405000a2000005003300000,    // a= CMEM3.INTRPT
// CMEM3.INTRPT
      36: 112'he129e475000a20600050033b0800,
      37: 112'h13640e7e800a20000050033002c0,    // a= INITSM
      38: 112'he0a5cc74800a2060005003300000,
      39: 112'he001cdd4c80a2060005003300000,
      40: 112'he001ef54c80a2061805003300000,
      41: 112'h13b50405000a2005005003300000,    // a= RDADR
// CCM3.INTRPT
      42: 112'he000e445180a2004005003300640,
      43: 112'he00bcc7b800a206010500c340000,
// WAM3.INTRPT
      44: 112'h302c0e7a000a200000520330002a,    // a= WAM3.INTRPT
      45: 112'he000cc78000a2005005003900000,
      46: 112'h13b00e58b80a2048205001320001,    // a= OUTDAT
      47: 112'h40022c3e820a20000050033b08c0,
      48: 112'h8000c405000a2000005003300000,
      49: 112'h302a0405000a2000005003300026,    // a= CCM3.INTRPT
// STPM3.INTRPT
      50: 112'h30320405000a2000005023300000,    // a= STPM3.INTRPT
// OЗY4
      51: 112'h30340405000a2000005003300000,    // a= CMEM4.INTRPT
// CMEM4.INTRPT
      52: 112'he12ae475000a20600050033b0800,
      53: 112'h13640e7e800a2000005003300000,    // a= INITSM
      54: 112'he0a5cc74800a2060005003300000,
      55: 112'he001cdd4c80a2060005003300000,
      56: 112'he001ef54c80a2061805003300000,
      57: 112'h13b50405000a2000005003300000,    // a= RDADR
      58: 112'h13ac0405000a2000005003300000,    // a= RDDAT
// CCM4.INTRPT
      59: 112'he000e445180a2004005003300640,
      60: 112'he000e44d280a200000500f300280,
      61: 112'he000e445300a2000005007320000,
      62: 112'he000ce7f800a2000005003300000,
      63: 112'he000ce7f000a200014500c340000,
// WAM4.INTRPT
      64: 112'h30400c3f020a200000520330002a,    // a= WAM4.INTRPT
      65: 112'h40092c3e820a20000050033b08c0,
      66: 112'h8000c405000a2000005003300000,
      67: 112'he000c445780a2000005043300000,
      68: 112'he000c405000aa000005003300000,
      69: 112'h303b0405000aa000005003300016,    // a= CCM4.INTRPT
// STPM4.INTRPT
      70: 112'h30460405000a2000005023300000,    // a= STPM4.INTRPT
// OЗY5
      71: 112'h30480405000a2000005003300000,    // a= CMEM5.INTRPT
// CMEM5.INTRPT
      72: 112'he12be475000a20600050033b0800,
      73: 112'h13640e7e800a2000005003300000,    // a= INITSM
      74: 112'he0a5cc74800a2060005003300000,
      75: 112'he001cdd4c80a2060005003300000,
      76: 112'he001ef54c80a2061805003300000,
      77: 112'h13b50405000a2005005003300000,    // a= RDADR
// CCM5.INTRPT
      78: 112'he000e445180a2004005003300640,
      79: 112'he000ce7f800a2000005003300280,
      80: 112'he000ce7f000a2000005003300000,
      81: 112'he00bcc7b800a206012500c340000,
// WAM5.INTRPT
      82: 112'h30520c3f020a200000520330002a,    // a= WAM5.INTRPT
      83: 112'he000cc78000a2005005003a00000,
      84: 112'h13b00e58b80a2048205002320001,    // a= OUTDAT
      85: 112'h40092c3e820a20000050033b08c0,
      86: 112'h8000c405000a2000005003300000,
      87: 112'he000c445780a2000005043300000,
      88: 112'he000c405000aa000005003300000,
      89: 112'h304e0405000aa000005003300016,    // a= CCM5.INTRPT
// STPM5.INTRPT
      90: 112'h305a0405000a2000005023300000,    // a= STPM5.INTRPT
// OЗY6
      91: 112'h305c0405000a2000005003300000,    // a= CMEM6.INTRPT
// CMEM6.INTRPT
      92: 112'he12ce475000a20600050033b0800,
      93: 112'h13640e7e800a2000005003300000,    // a= INITSM
      94: 112'he0a5cc74800a2060005003300000,
      95: 112'he001cdd4c80a2060005003300000,
      96: 112'he001ef54c80a2061805003300000,
      97: 112'h13b50405000a2005005003300000,    // a= RDADR
// CCM6.INTRPT
      98: 112'he000e445180a2004005003300640,
      99: 112'he000ce7f800a2000005003300280,
     100: 112'he000ce7f000a2000005003300000,
     101: 112'he00bcc7b800a206010500c340000,
// WAM6.INTRPT
     102: 112'h30660c3f020a200000520330002a,    // a= WAM6.INTRPT
     103: 112'he000cc78000a2005005003900000,
     104: 112'h13b00e58b80a2048205001320001,    // a= OUTDAT
     105: 112'h40092c3e820a20000050033b08c0,
     106: 112'h8000c405000a2000005003300000,
     107: 112'he000c445780a2000005043300000,
     108: 112'he000c405000aa000005003300000,
     109: 112'h30620405000aa000005003300016,    // a= CCM6.INTRPT
// STPM6.INTRPT
     110: 112'h306e0405000a2000005023300000,    // a= STPM6.INTRPT
// П1
     111: 112'h30700405000a2000005003300000,    // a= CONT1.INTRPT
// CONT1.INTRPT
     112: 112'he067ec7c000a20600050033b0800,
     113: 112'he000ee7e800a20000050033b08c0,
     114: 112'h143f0405000a2000005003300000,    // a= CTTSTP
// CC1.INTRPT
     115: 112'h107b0405000a2000005003300000,    // a= BEGINT
     116: 112'he022ec79800a2062005003300000,
     117: 112'h10852445180a2004005003300000,    // a= CH
     118: 112'he008ec7b020a206000500f320000,
     119: 112'h10cc0c4ab00a2000005003300000,    // a= INTAW
     120: 112'h10bd0405000a2005005003300640,    // a= INTAR
     121: 112'h10c80405000a2005005003300640,    // a= INTAF
     122: 112'h30732c3e820a20000050033b08c0,    // a= CC1.INTRPT
// BEGINT
     123: 112'he000c405000a20000050033002c0,
     124: 112'he000c405000a2000005003300440,
     125: 112'he000c405000a2000005003300640,
     126: 112'he000e675000a20000050033b0880,
     127: 112'he000ec3e820a20000050033b08c0,
     128: 112'he067ec79000a20600050033b0840,
     129: 112'h10830405000a2000005003300026,    // a= ERRINT
     130: 112'ha0a5ec7c800a2061805003300000,
// ERRINT
     131: 112'h13b00405000a2000005023300000,    // a= OUTDAT
     132: 112'h33670405000a2000005003300000,    // a= ERRTST
// CH
     133: 112'he001c405000a2060005003305000,
     134: 112'he06de475000a2062805003300000,
     135: 112'he067e475000a20600050033d0000,
     136: 112'he067e475000a20600050033f0000,
     137: 112'he06ee475000a2062805003300000,
     138: 112'he067e475000a20600050033d0000,
     139: 112'he067e475000a20600050033f0000,
     140: 112'he06fe475000a2062805003300000,
     141: 112'he067e475000a20600050033d0000,
     142: 112'ha067e475000a20600050033f0000,
// SUBWD
     143: 112'he000c405000a200014500c340000,
     144: 112'he000cc72000a2000005003800000,
     145: 112'he000c312180a2000005003300000,
     146: 112'he061c66d000a2060005043300000,
     147: 112'he000c405000aa000005003300000,
     148: 112'h10832c39020aa0000050033b0856,    // a= ERRINT
     149: 112'h10832c39020a20000050033b0866,    // a= ERRINT
// WAOK.INTRPT
     150: 112'h30960405000a200000520330002a,    // a= WAOK.INTRPT
     151: 112'ha000c405000a2000005003300000,
// SUBRD
     152: 112'he000c405000a200012500c340000,
     153: 112'he000cc72000a2000005003800000,
     154: 112'he000c312180a2000005003300000,
     155: 112'he061c66d000a2060005043300000,
     156: 112'he000c405000aa000005003300000,
     157: 112'h10832c39020aa0000050033b0856,    // a= ERRINT
     158: 112'h10832c39020a20000050033b0866,    // a= ERRINT
// WAOKR.INTRPT
     159: 112'h309f0405000a200000520330002a,    // a= WAOKR.INTRPT
// CMPDAT
     160: 112'he000cc78000a2000005003a00000,
     161: 112'he000c718280a2000005043300000,
     162: 112'he000ec39020aa0000050033b0840,
     163: 112'h10830c70800aa048205002320017,    // a= ERRINT
     164: 112'he000c313080a2000005003300000,
// PSCMP.INTRPT
     165: 112'he00bc26d000a2060005043300000,
     166: 112'he000ec39020aa0000050033b0840,
     167: 112'h10830405000aa000005003300016,    // a= ERRINT
     168: 112'ha000c405000a2000005003300000,
// SUBRC
     169: 112'he000c405000a200010500c340000,
     170: 112'he000cc72000a2000005003800000,
     171: 112'he000c312180a2000005003300000,
     172: 112'he061c66d000a2060005043300000,
     173: 112'he000c405000aa000005003300000,
     174: 112'h10832c39020aa0000050033b0856,    // a= ERRINT
     175: 112'h10832c39020a20000050033b0866,    // a= ERRINT
// WAOKP.INTRPT
     176: 112'h30b00405000a200000520330002a,    // a= WAOKP.INTRPT
// CMPCOM
     177: 112'he000cc78000a2000005003900000,
     178: 112'he000c718280a2000005043300000,
     179: 112'he000ec39020aa0000050033b0840,
     180: 112'h10830c70800aa048205001320017,    // a= ERRINT
     181: 112'h30a50313080a2000005003300000,    // a= PSCMP.INTRPT
// INTPSR
     182: 112'h10db0405000a200012500c340000,    // a= INTPS.INTRPT
     183: 112'h30d20e7f000a200012500c340000,    // a= WTNI.INTRPT
// INTMR
     184: 112'he000c405000a200012500c340000,
// WAPSR.INTRPT
     185: 112'h30b90405000a200000520330002a,    // a= WAPSR.INTRPT
     186: 112'h10dc0405000a2000005103300000,    // a= INTMAS
     187: 112'h10a00405000a2000005003300000,    // a= CMPDAT
// INTMRN
     188: 112'h30d20e7f000a200012500c340000,    // a= WTNI.INTRPT
// INTAR
     189: 112'he000c405000a200012500c340000,
// WAAR.INTRPT
     190: 112'h30be0405000a200000520330002a,    // a= WAAR.INTRPT
     191: 112'h10dc0405000a2000005103300000,    // a= INTMAS
     192: 112'h30d20e7f000a200012500c340000,    // a= WTNI.INTRPT
// INTPSF
     193: 112'h10db0405000a200010500c340000,    // a= INTPS.INTRPT
     194: 112'h30d20e7f000a200010500c340000,    // a= WTNI.INTRPT
// INTMF
     195: 112'he000c405000a200010500c340000,
// WAPSF.INTRPT
     196: 112'h30c40405000a200000520330002a,    // a= WAPSF.INTRPT
     197: 112'h10dc0405000a2000005103300000,    // a= INTMAS
     198: 112'h10b10405000a2000005003300000,    // a= CMPCOM
// INTMFN
     199: 112'h30d20e7f000a200010500c340000,    // a= WTNI.INTRPT
// INTAF
     200: 112'he000c405000a200010500c340000,
// WAAF.INTRPT
     201: 112'h30c90405000a200000520330002a,    // a= WAAF.INTRPT
     202: 112'h10dc0405000a2000005103300000,    // a= INTMAS
     203: 112'h30d20e7f000a200010500c340000,    // a= WTNI.INTRPT
// INTMW
// INTAW
     204: 112'he000c405000a200014500c340000,
// WAPSW.INTRPT
     205: 112'h30cd0405000a200000520330002a,    // a= WAPSW.INTRPT
     206: 112'h30dd0405000a2000005103300000,    // a= INTMAS1
// INTMWN
     207: 112'h30d20e7f000a200014500c340000,    // a= WTNI.INTRPT
// INTPSW
     208: 112'h10db0405000a200014500c340000,    // a= INTPS.INTRPT
     209: 112'he000ce7f000a200014500c340000,
// INTWAT
// WTNI.INTRPT
     210: 112'h40090c3f020a2000005103300000,
     211: 112'h8000cc3f020a2000005003300000,
// RPWT.INTRPT
     212: 112'he000c44d780a2000005043300000,
     213: 112'he000c405000a2000005003300000,
     214: 112'h30d40405000a2000005003300016,    // a= RPWT.INTRPT
     215: 112'he000c31c780a2000005043300000,
     216: 112'he000ec39020aa0000050033b0840,
     217: 112'h10830405000aa000005003300016,    // a= ERRINT
     218: 112'ha000c405000a2000005003300000,
// INTPS.INTRPT
     219: 112'h10832c39020a20000052033b086a,    // a= ERRINT
// INTMAS
     220: 112'h10832c39020a20000053033b0866,    // a= ERRINT
// INTMAS1
     221: 112'h40020405000a2000005003300640,
     222: 112'h8000c405000a2000005003300000,
     223: 112'h10832c39020a20000050033b0866,    // a= ERRINT
     224: 112'he000ee7f800a20000050033b0900,
     225: 112'he000e445780a20000050033b0940,
     226: 112'ha000c405000a2000005003300280,
// П2
     227: 112'h30e40405000a2000005003300000,    // a= CONT2.INTRPT
// CONT2.INTRPT
     228: 112'he068ec7c000a20600050033b0800,
     229: 112'he000ee7e800a20000050033b08c0,
// CKL2.INTRPT
     230: 112'h107b0405000a2000005003300000,    // a= BEGINT
     231: 112'he011efff000a2062005003300000,
     232: 112'h10852445700a2004005003300000,    // a= CH
     233: 112'he001c405000a206014500cf40000,
// WASX2.INTRPT
     234: 112'h30ea0405000a200000520330002a,    // a= WASX2.INTRPT
     235: 112'he01aec79800a2062005003300000,
     236: 112'h10852445180a2004005003300000,    // a= CH
     237: 112'he003ec7b000a206000500f320000,
     238: 112'h108f0c4ab00a2000005003300000,    // a= SUBWD
     239: 112'h10980405000a2005005003300000,    // a= SUBRD
     240: 112'he011e7f5000a2064005003300000,
     241: 112'he067c405000a206014500cf40000,
// WACX2.INTRPT
     242: 112'h30f20405000a200000520330002a,    // a= WACX2.INTRPT
     243: 112'he05fef5aa80a206000500f300000,
     244: 112'h108f2445180a2004005003300000,    // a= SUBWD
     245: 112'he011e7f5000a2064005003300000,
     246: 112'he001c405000a206514500cf40000,
// WASSX2.INTRPT
     247: 112'h30f70405000a200000520330002a,    // a= WASSX2.INTRPT
     248: 112'h10b82445180a2004005003300000,    // a= INTMR
     249: 112'h10c30405000a2005005003300640,    // a= INTMF
     250: 112'h30e62c3e820a20000050033b08c0,    // a= CKL2.INTRPT
// П3
     251: 112'h30fc0405000a2000005003300000,    // a= CONT3.INTRPT
// CONT3.INTRPT
     252: 112'he070ec7c000a20600050033b0800,
     253: 112'he000ee7e800a20000050033b08c0,
// CKL3.INTRPT
     254: 112'h107b0405000a2000005003300000,    // a= BEGINT
     255: 112'he01aec79800a2062005003300000,
     256: 112'h10852445180a2004005003300000,    // a= CH
     257: 112'he017ec7b000a206000500f320000,
     258: 112'h108f0c4ab00a2000005003300000,    // a= SUBWD
     259: 112'h10980405000a2000005003300000,    // a= SUBRD
     260: 112'he020ef54c80a2061805003300000,
     261: 112'h10b80405000a2000005003300000,    // a= INTMR
     262: 112'h30fe2c3e820a20000050033b08c0,    // a= CKL3.INTRPT
// П4
     263: 112'h31080405000a2000005003300000,    // a= CONT4.INTRPT
// CONT4.INTRPT
     264: 112'he07aec7c000a20600050033b0800,
     265: 112'he000ee7e800a20000050033b08c0,
     266: 112'he011cc7b800a2060005003300000,
// CC4.INTRPT
     267: 112'h107b0405000a2005005003300000,    // a= BEGINT
     268: 112'he01aec79800a2062005003300000,
     269: 112'h10852445180a2004005003300000,    // a= CH
     270: 112'he000ec4b3a0a200000500f320000,
     271: 112'h108f0c4ab00a2000005003300000,    // a= SUBWD
     272: 112'he011e755300a2060005007320000,
     273: 112'h10a90405000a2000005003300000,    // a= SUBRC
     274: 112'he01fef54c80a2061805003300000,
     275: 112'h10c30405000a2000005003300000,    // a= INTMF
     276: 112'he011cf5bb80a2060005003300000,
     277: 112'h310b2c3e820a20000050033b08c0,    // a= CC4.INTRPT
// П5
     278: 112'h31170405000a2000005003300000,    // a= CONT5.INTRPT
// CONT5.INTRPT
     279: 112'he07bec7c000a20600050033b0800,
     280: 112'he000ee7e800a20000050033b08c0,
     281: 112'he011cc7b800a2060005003300000,
// CC5.INTRPT
     282: 112'h107b0405000a2000005003300000,    // a= BEGINT
     283: 112'he01aec79800a2062005003300000,
     284: 112'h10852445180a2004005003300000,    // a= CH
     285: 112'he000ec4b380a200000500f320000,
     286: 112'h108f0c4ab00a2000005003300000,    // a= SUBWD
     287: 112'he011e755380a2060005007320000,
     288: 112'h10980405000a2000005003300000,    // a= SUBRD
     289: 112'he01def5cc80a2061805003300000,
     290: 112'h10b80405000a2000005003300000,    // a= INTMR
     291: 112'he011cf5bb80a2060005003300000,
     292: 112'h311a2c3e820a20000050033b08c0,    // a= CC5.INTRPT
// П6
     293: 112'h31260405000a2000005003300000,    // a= CONT6.INTRPT
// CONT6.INTRPT
     294: 112'he071ec7c000a20600050033b0800,
     295: 112'he000ee7e800a20000050033b08c0,
// CC6.INTRPT
     296: 112'h107b0405000a2000005003300000,    // a= BEGINT
     297: 112'he01aec79800a2062005003300000,
     298: 112'h10852445180a2004005003300000,    // a= CH
     299: 112'he012ec7b000a206000500f320000,
     300: 112'h108f0c4ab00a2000005003300000,    // a= SUBWD
     301: 112'h10980405000a2000005003300000,    // a= SUBRD
     302: 112'he01eef5cc80a2061805003300000,
     303: 112'h10b80405000a2000005003300000,    // a= INTMR
     304: 112'h31282c3e820a20000050033b08c0,    // a= CC6.INTRPT
// П7
     305: 112'h31320405000a2000005003300000,    // a= CONT7.INTRPT
// CONT7.INTRPT
     306: 112'he060ec7c000a20600050033b0800,
     307: 112'he000ee7e800a20000050033b08c0,
// CC7.INTRPT
     308: 112'h107b0405000a2005005003300000,    // a= BEGINT
     309: 112'he01aec79800a2062005003300000,
     310: 112'h10852445180a2004005003300000,    // a= CH
     311: 112'he002ec7a800a206000500f300000,
     312: 112'h108f2e4b000a2000005007320000,    // a= SUBWD
     313: 112'h10c30405000a2005005003300000,    // a= INTMF
     314: 112'h31342c3e820a20000050033b08c0,    // a= CC7.INTRPT
// П8
     315: 112'h313c0405000a2000005003300000,    // a= CONT8.INTRPT
// CONT8.INTRPT
     316: 112'he077ec7c000a20600050033b0800,
     317: 112'he000ee7e800a20000050033b08c0,
// CC8.INTRPT
     318: 112'h107b0405000a2005005003300000,    // a= BEGINT
     319: 112'he01aec79800a2062005003300000,
     320: 112'h10852445180a2004005003300000,    // a= CH
     321: 112'he014ec7b020a206000500f320000,
     322: 112'h108f0c4ab00a2000005003300000,    // a= SUBWD
     323: 112'h10c30405000a2005005003300000,    // a= INTMF
     324: 112'h313e2c3e820a20000050033b08c0,    // a= CC8.INTRPT
// П9
     325: 112'h31460405000a2000005003300000,    // a= CONT9.INTRPT
// CONT9.INTRPT
     326: 112'he078ec7c000a20600050033b0800,
     327: 112'he000ee7e800a20000050033b08c0,
// CC9.INTRPT
     328: 112'h107b0405000a2005005003300000,    // a= BEGINT
     329: 112'he01aec79800a2062005003300000,
     330: 112'h10852445180a2004005003300000,    // a= CH
     331: 112'he015ec7b020a206000500f320000,
     332: 112'h108f0c4ab00a2000005003300000,    // a= SUBWD
     333: 112'h10a90405000a2000005003300000,    // a= SUBRC
     334: 112'he02deddcc80a2061805003300000,
     335: 112'h10a90405000a2000005003300200,    // a= SUBRC
     336: 112'he000c405000a2000005003300240,
     337: 112'h10c30405000a2000005003300000,    // a= INTMF
     338: 112'he02deddcc80a2061805003300000,
     339: 112'h10c30405000a2000005003300000,    // a= INTMF
     340: 112'h31482c3e820a20000050033b08c0,    // a= CC9.INTRPT
// П10
     341: 112'h31560405000a2000005003300000,    // a= CONT10.INTRPT
// CONT10.INTRPT
     342: 112'he06fec7c000a20600050033b0800,
     343: 112'he000ee7e800a20000050033b08c0,
// CC10.INTRPT
     344: 112'h107b0405000a2005005003300000,    // a= BEGINT
     345: 112'he01aec79800a2062005003300000,
     346: 112'h10852445180a2004005003300000,    // a= CH
     347: 112'he017ec7b020a206000500f320000,
     348: 112'h108f0c4ab00a2000005003300000,    // a= SUBWD
     349: 112'h10a90405000a2000005003300000,    // a= SUBRC
     350: 112'he020ef54c80a2061805003300000,
     351: 112'h10c30405000a2000005003300000,    // a= INTMF
     352: 112'h31582c3e820a20000050033b08c0,    // a= CC10.INTRPT
// П11
     353: 112'h31620405000a2000005003300000,    // a= CONT11.INTRPT
// CONT11.INTRPT
     354: 112'he079ec7c000a20600050033b0800,
     355: 112'he000ee7e800a20000050033b08c0,
// CC11.INTRPT
     356: 112'h107b0405000a2000005003300000,    // a= BEGINT
     357: 112'he01aec79800a2062005003300000,
     358: 112'h10852445180a2004005003300000,    // a= CH
     359: 112'he013ec7b000a206000500f320000,
     360: 112'h108f0405000a2000005003300000,    // a= SUBWD
     361: 112'he002ec7a800a206000500f300000,
     362: 112'h108f0405000a2000005003300000,    // a= SUBWD
     363: 112'h10980405000a2005005003300000,    // a= SUBRD
     364: 112'he022ef5cc80a2061805003300000,
     365: 112'he003c405000a2060005003f00000,
     366: 112'h10cc0405000a2000005003300000,    // a= INTMW
     367: 112'h10980405000a2000005003300640,    // a= SUBRD
     368: 112'h31642c3e820a20000050033b08c0,    // a= CC11.INTRPT
// П12
     369: 112'h31720405000a2000005003300000,    // a= CONT12.INTRPT
// CONT12.INTRPT
     370: 112'he05fec7c000a20600050033b0800,
     371: 112'he000ee7e800a20000050033b08c0,
// CC12.INTRPT
     372: 112'h107b0405000a2000005003300000,    // a= BEGINT
     373: 112'he01fec79800a2062005003300000,
     374: 112'h10852445180a2004005003300000,    // a= CH
     375: 112'he008ec7b020a206000500f320000,
     376: 112'he000cc4ab00a200014500c340000,
// WA12.INTRPT
     377: 112'h31790405000a200000520330002a,    // a= WA12.INTRPT
     378: 112'h10dc0405000a2000005003300000,    // a= INTMAS
     379: 112'h10d20e7f000a200014500c340000,    // a= INTWAT
     380: 112'h31742c3e820a20000050033b08c0,    // a= CC12.INTRPT
// П14
     381: 112'h317e0405000a2000005003300000,    // a= CONT14.INTRPT
// CONT14.INTRPT
     382: 112'he072ec7c000a20600050033b0800,
     383: 112'he000ee7e800a20000050033b08c0,
// CC14.INTRPT
     384: 112'h107b0405000a2000005003300000,    // a= BEGINT
     385: 112'he001ec79800a2062005003300000,
     386: 112'h10852445180a2004005003300000,    // a= CH
     387: 112'he008ec7b020a206000500f320000,
     388: 112'h10d00c4ab00a2000005003300000,    // a= INTPSW
     389: 112'h10b60405000a2000005003300640,    // a= INTPSR
     390: 112'h10c10405000a2000005003300640,    // a= INTPSF
     391: 112'he02aef5cc80a2061805003300000,
     392: 112'he01eec7a000a2062005003300640,
     393: 112'h10852445180a2004005003300000,    // a= CH
     394: 112'he000e445200a2000005003390000,
     395: 112'h10d00405000a2000005003300000,    // a= INTPSW
     396: 112'h10b60405000a2000005003300640,    // a= INTPSR
     397: 112'h10c10405000a2000005003300640,    // a= INTPSF
     398: 112'h31802c3e820a20000050033b08c0,    // a= CC14.INTRPT
// П15
     399: 112'h31900405000a2000005003300000,    // a= CONT15.INTRPT
// CONT15.INTRPT
     400: 112'he073ec7c000a20600050033b0800,
     401: 112'he000ee7e800a20000050033b08c0,
// CC15.INTRPT
     402: 112'h107b0405000a2000005003300000,    // a= BEGINT
     403: 112'he01ccc7f800a2060005003300000,
     404: 112'he00bcc7f000a2060005003300000,
     405: 112'he01ecc7d800a2060005003300000,
     406: 112'he00bcc7e000a2060005003300000,
     407: 112'he000e19f780a2002005003300000,
     408: 112'h10852c29800a2004005003300000,    // a= CH
     409: 112'he000c19e580a2000005003300000,
     410: 112'he018c1ed000a2060005003300000,
     411: 112'he019e5ed000a2060005003390000,
     412: 112'he008ec7a820a206000500f300000,
     413: 112'h108f2e7b000a2000005007320000,    // a= SUBWD
     414: 112'h10980405000a2000005003300000,    // a= SUBRD
     415: 112'he02aef5cc80a2061805003300000,
     416: 112'h1085219f580a2002005003300000,    // a= CH
     417: 112'h108f0c29800a2000005003300000,    // a= SUBWD
     418: 112'h10980405000a2000005003300000,    // a= SUBRD
     419: 112'he029ef5cc80a2061805003300000,
     420: 112'h108f2c3a820a200000500f300000,    // a= SUBWD
     421: 112'h10980405000a2000005003300000,    // a= SUBRD
     422: 112'he084cc7e000a2060005003300000,
     423: 112'he018c05d600a2060005003300000,
     424: 112'he019c06d000a2060005003300000,
     425: 112'he000e405580a2001005003390000,
     426: 112'h108f2c3a820a200000500f300000,    // a= SUBWD
     427: 112'h10980405000a2000005003300000,    // a= SUBRD
     428: 112'he06ce75d600a2061005003300000,
     429: 112'h10d00405000a2000005003300000,    // a= INTPSW
     430: 112'h10b60405000a2000005003300640,    // a= INTPSR
     431: 112'h31922c3e820a20000050033b08c0,    // a= CC15.INTRPT
// П16
     432: 112'h31b10405000a2000005003300000,    // a= CONT16.INTRPT
// CONT16.INTRPT
     433: 112'he074ec7c000a20600050033b0800,
     434: 112'he000ee7e800a20000050033b08c0,
// CC16.INTRPT
     435: 112'h107b0405000a2000005003300000,    // a= BEGINT
     436: 112'he01ccc7f800a2060005003300000,
     437: 112'he00bcc7f000a2060005003300000,
     438: 112'he01ecc7d800a2060005003300000,
     439: 112'he00bcc7e000a2060005003300000,
     440: 112'he000e19f780a2002005003300000,
     441: 112'h10852c29800a2004005003300000,    // a= CH
     442: 112'he000c19e580a2000005003300000,
     443: 112'he018c1ed000a2060005003300000,
     444: 112'he019e5ed000a2060005003390000,
     445: 112'he008ec7b020a206000500f320000,
     446: 112'h108f0c4ab00a2000005003300000,    // a= SUBWD
     447: 112'h10a90405000a2005005003300000,    // a= SUBRC
     448: 112'he02aef5cc80a2061805003300000,
     449: 112'h1085219f580a2002005003300000,    // a= CH
     450: 112'h108f0c29800a2000005003300000,    // a= SUBWD
     451: 112'h10a90405000a2005005003300000,    // a= SUBRC
     452: 112'he029ef5cc80a2061805003300000,
     453: 112'h108f2c3a820a200000500f300000,    // a= SUBWD
     454: 112'h10a90405000a2005005003300000,    // a= SUBRC
     455: 112'he084cc7e000a2060005003300000,
     456: 112'he018c05d600a2060005003300000,
     457: 112'he019c06d000a2060005003300000,
     458: 112'he000e405580a2001005003390000,
     459: 112'h108f2c3a820a200000500f300000,    // a= SUBWD
     460: 112'h10a90405000a2005005003300000,    // a= SUBRC
     461: 112'he06ce75d600a2061005003300000,
     462: 112'h10c10405000a2000005003300000,    // a= INTPSF
     463: 112'h31b32c3e820a20000050033b08c0,    // a= CC16.INTRPT
// П17
     464: 112'h31d10405000a2000005003300000,    // a= CONT17.INTRPT
// CONT17.INTRPT
     465: 112'he075ec7c000a20600050033b0800,
     466: 112'he000ee7e800a20000050033b08c0,
// CC17.INTRPT
     467: 112'h107b0405000a2000005003300000,    // a= BEGINT
     468: 112'he02acf5cc80a2060005003300000,
     469: 112'he027ef5cc80a2061805003300000,
     470: 112'he01ccc7f800a2060005003300000,
     471: 112'he00bcc7f000a2060005003300000,
     472: 112'he01ecc7d800a2060005003300000,
     473: 112'he000e19f780a2004005003300000,
     474: 112'he000e19f580a2002005003300000,
     475: 112'h10850c29800a2000005003300000,    // a= CH
     476: 112'he018cdde580a2060005003300000,
     477: 112'he019e5dd600a2060005003390000,
     478: 112'he008ec7a820a206000500f300000,
     479: 112'h108f2e7b000a2000005007320000,    // a= SUBWD
     480: 112'h10980405000a2000005003300000,    // a= SUBRD
     481: 112'h108f2c33020a2000005007320000,    // a= SUBWD
     482: 112'h10a90405000a2005005003300000,    // a= SUBRC
     483: 112'he027ef5cc80a2061805003300000,
     484: 112'he018e45d580a2060005003390000,
     485: 112'h108f2c3a820a200000500f300000,    // a= SUBWD
     486: 112'h10a90405000a2005005003300000,    // a= SUBRC
     487: 112'h108f2e7b000a2000005007320000,    // a= SUBWD
     488: 112'h10980405000a2000005003300000,    // a= SUBRD
     489: 112'he027ef54c80a2061805003300000,
     490: 112'h10d00405000a2000005003300000,    // a= INTPSW
     491: 112'h10b60405000a2000005003300000,    // a= INTPSR
     492: 112'h10c10405000a2005005003300000,    // a= INTPSF
     493: 112'h31d32c3e820a20000050033b08c0,    // a= CC17.INTRPT
// П18
     494: 112'h31ef0405000a2000005003300000,    // a= CONT18.INTRPT
// CONT18.INTRPT
     495: 112'he076ec7c000a20600050033b0800,
     496: 112'he000ee7e800a20000050033b08c0,
// CC18.INTRPT
     497: 112'h107b0405000a2000005003300000,    // a= BEGINT
     498: 112'he02acf5cc80a2060005003300000,
     499: 112'he026ef5cc80a2061805003300000,
     500: 112'he01ccc7f800a2060005003300000,
     501: 112'he00bcc7f000a2060005003300000,
     502: 112'he01ecc7d800a2060005003300000,
     503: 112'he000e19f780a2004005003300000,
     504: 112'he000c19f580a2002005003300000,
     505: 112'h10850c29800a2000005003300000,    // a= CH
     506: 112'he018cdde580a2060005003300000,
     507: 112'he019e5dd600a2060005003390000,
     508: 112'he008ec7a820a206000500f300000,
     509: 112'h108f2e7b000a2000005007320000,    // a= SUBWD
     510: 112'h10980405000a2000005003300000,    // a= SUBRD
     511: 112'he026ef5cc80a2061805003300000,
     512: 112'he019e45d580a2060005003390000,
     513: 112'h108f2c3a820a200000500f300000,    // a= SUBWD
     514: 112'h10980405000a2000005003300000,    // a= SUBRD
     515: 112'he026ef54c80a2061805003300000,
     516: 112'h10d00405000a2000005003300000,    // a= INTPSW
     517: 112'h31f12c3e820a20000050033b08c0,    // a= CC18.INTRPT
// П19
     518: 112'h32070405000a2000005003300000,    // a= CONT19.INTRPT
// CONT19.INTRPT
     519: 112'he06dec7c000a20600050033b0800,
     520: 112'he000ee7e800a20000050033b08c0,
// CC19.INTRPT
     521: 112'h107b0405000a2000005003300000,    // a= BEGINT
     522: 112'he02acf5cc80a2060005003300000,
     523: 112'he028ef5cc80a2061805003300000,
     524: 112'he01ccc7f800a2060005003300000,
     525: 112'he00bcc7f000a2060005003300000,
     526: 112'he01ecc7d800a2060005003300000,
     527: 112'he000e19f780a2004005003300000,
     528: 112'he000c19f580a2002005003300000,
     529: 112'h10850c29800a2000005003300000,    // a= CH
     530: 112'he000e44d580a2000005003390000,
     531: 112'he008ec7a820a206000500f300000,
     532: 112'he067ec7b000a2060005007320000,
     533: 112'h108f0405000a2000005003300000,    // a= SUBWD
     534: 112'h10a90405000a2005005003300000,    // a= SUBRC
     535: 112'he028ef5cc80a2061805003300000,
     536: 112'he01dccf7820a2060005003300000,
     537: 112'he000e597780a2004005003300000,
     538: 112'he000e445580a2000005003390000,
     539: 112'h108f2c3a820a200000500f300000,    // a= SUBWD
     540: 112'h10a90405000a2005005003300000,    // a= SUBRC
     541: 112'he028ef54c80a2061805003300000,
     542: 112'h10c10405000a2005005003300000,    // a= INTPSF
     543: 112'h32092c3e820a20000050033b08c0,    // a= CC19.INTRPT
// П20
     544: 112'h32210405000a2000005003300000,    // a= CONT20.INTRPT
// CONT20.INTRPT
     545: 112'he06eec7c000a20600050033b0800,
     546: 112'he000ee7e800a20000050033b08c0,
// CC20.INTRPT
     547: 112'h107b0405000a2000005003300000,    // a= BEGINT
     548: 112'he02acf5cc80a2060005003300000,
     549: 112'he028ef5cc80a2061805003300000,
     550: 112'he01ccc7f800a2060005003300000,
     551: 112'he00bcc7f000a2060005003300000,
     552: 112'he01ecc7d800a2060005003300000,
     553: 112'he000e19f780a2004005003300000,
     554: 112'he000c19f580a2002005003300000,
     555: 112'h10850c29800a2000005003300000,    // a= CH
     556: 112'he000e44d580a2000005003390000,
     557: 112'he008ec7a820a206000500f300000,
     558: 112'h108f2e7b000a2000005007320000,    // a= SUBWD
     559: 112'h10980405000a2000005003300000,    // a= SUBRD
     560: 112'he028ef5cc80a2061805003300000,
     561: 112'he01dccf7820a2060005003300000,
     562: 112'he000e597780a2004005003300000,
     563: 112'he000e445580a2000005003390000,
     564: 112'h108f2c3a820a200000500f300000,    // a= SUBWD
     565: 112'h10980405000a2000005003300000,    // a= SUBRD
     566: 112'he028ef54c80a2061805003300000,
     567: 112'h10d00405000a2000005003300000,    // a= INTPSW
     568: 112'h10b60405000a2000005003300000,    // a= INTPSR
     569: 112'h32232c3e820a20000050033b08c0,    // a= CC20.INTRPT
// П22
     570: 112'h323b0405000a2000005003300000,    // a= CONT22.INTRPT
// CONT22.INTRPT
     571: 112'he06cec7c000a20600050033b0800,
     572: 112'he000ee7e800a20000050033b08c0,
// CC22.INTRPT
     573: 112'h107b0405000a2000005003300000,    // a= BEGINT
     574: 112'he025ec79820a2062005003300000,
     575: 112'h10852445180a2004005003300000,    // a= CH
     576: 112'h10d00405000a2000005003300000,    // a= INTPSW
     577: 112'h10b60405000a2000005003300640,    // a= INTPSR
     578: 112'h10c10405000a2000005003300640,    // a= INTPSF
     579: 112'he05bec79820a2062005003300640,
     580: 112'h10852445180a2004005003300000,    // a= CH
     581: 112'h10d00405000a2000005003300000,    // a= INTPSW
     582: 112'h10b60405000a2000005003300640,    // a= INTPSR
     583: 112'h10c10405000a2000005003300640,    // a= INTPSF
     584: 112'he02aef5cc80a2061805003300000,
     585: 112'he020ec7a000a2062005003300640,
     586: 112'he025ec79820a2064005003300000,
     587: 112'h10852445200a2000005003390000,    // a= CH
     588: 112'h10d00405000a2000005003300000,    // a= INTPSW
     589: 112'h10b60405000a2000005003300640,    // a= INTPSR
     590: 112'h10c10405000a2000005003300640,    // a= INTPSF
     591: 112'he05bec79820a2064005003300640,
     592: 112'h10d02445200a2000005003390000,    // a= INTPSW
     593: 112'h10b60405000a2000005003300640,    // a= INTPSR
     594: 112'h10c10405000a2000005003300640,    // a= INTPSF
     595: 112'h323d2c3e820a20000050033b08c0,    // a= CC22.INTRPT
// П24
     596: 112'h32550405000a2000005003300000,    // a= CONT24.INTRPT
// CONT24.INTRPT
     597: 112'he07cec7c000a20600050033b0800,
     598: 112'he000ee7e800a20000050033b08c0,
// CC24.INTRPT
     599: 112'h107b0405000a2000005003300000,    // a= BEGINT
     600: 112'he003ec7a800a206000500f300000,
     601: 112'he001ec7b000a2060005007320000,
     602: 112'he01cec79820a2062005003300000,
     603: 112'h10850405000a2000005003300000,    // a= CH
     604: 112'he067e445180a2064005003305000,
     605: 112'h10cf0405000a2000005003300280,    // a= INTMWN
     606: 112'he067c405000a2060005003305640,
     607: 112'h10bc0405000a2000005003300280,    // a= INTMRN
     608: 112'he067c405000a2060005003305640,
     609: 112'h10cf2c3b020a2000005007320280,    // a= INTMWN
     610: 112'he067c405000a2060005003305640,
     611: 112'h10c70405000a2005005003300280,    // a= INTMFN
     612: 112'he02aef5cc80a2061805003300000,
     613: 112'he0a4eff9800a2064005003300000,
     614: 112'he01ce47d020a2060005003390000,
     615: 112'he067c405000a2060005003305640,
     616: 112'h10cf0405000a2000005003300280,    // a= INTMWN
     617: 112'he067c405000a2060005003305640,
     618: 112'h10c70405000a2005005003300280,    // a= INTMFN
     619: 112'he067c405000a2060005003305640,
     620: 112'h10cf2e7b000a2000005004320280,    // a= INTMWN
     621: 112'he067c405000a2060005003305640,
     622: 112'h10bc0405000a2000005003300280,    // a= INTMRN
     623: 112'h32572c3e820a20000050033b08c0,    // a= CC24.INTRPT
// П26
     624: 112'h32710405000a2000005003300000,    // a= CONT26.INTRPT
// CONT26.INTRPT
     625: 112'he084ec7c000a20600050033b0800,
     626: 112'he000ee7e800a20000050033b08c0,
// CC26.INTRPT
     627: 112'h107b0405000a2000005003300000,    // a= BEGINT
     628: 112'he014cc78000a2060005003300000,
     629: 112'h14310405000a2000005003300000,    // a= CTTWR
     630: 112'h42bc2c39020a20000050033b0840,
     631: 112'hb27a0405000a2000005003300026,    // a= OK26.INTRPT
     632: 112'h8000c405000a2000005003300000,
     633: 112'h10830405000a2000005203300026,    // a= ERRINT
// OK26.INTRPT
     634: 112'h40020405000a2000005003300440,
     635: 112'h8000ec3e820a20000050033b08c0,
     636: 112'h10832c39020a20000050033b0866,    // a= ERRINT
     637: 112'he000ee7f800a20000050033b0900,
     638: 112'he000e445780a20000050033b0940,
     639: 112'he000c405000a2000005003300280,
     640: 112'he06ccc78000a2060005003300000,
     641: 112'h14310e7f000a2000005003300000,    // a= CTTWR
     642: 112'h41000c3f020a2000005003300000,
     643: 112'h8000cc3f020a2000005103300000,
     644: 112'h10d22c3e820a20000050033b08c0,    // a= INTWAT
     645: 112'h32732c3e820a20000050033b08c0,    // a= CC26.INTRPT
// П27
     646: 112'h32870405000a2000005003300000,    // a= CONT27.INTRPT
// CONT27.INTRPT
     647: 112'he07eec7c000a20600050033b0800,
     648: 112'he000ee7e800a20000050033b08c0,
// CC27.INTRPT
     649: 112'h107b0405000a2000005003300000,    // a= BEGINT
     650: 112'he021eddcc80a2061805003300000,
     651: 112'he000ce7d800a2000005003300000,
// CWAIT.INTRPT
     652: 112'he027c75d580a2060005143300000,
     653: 112'h328f0c3d820aa000005103300026,    // a= OKINT.INTRPT
     654: 112'h328c0405000aa000005003300016,    // a= CWAIT.INTRPT
// OKINT.INTRPT
     655: 112'h10dc0405000a2000005103300000,    // a= INTMAS
     656: 112'he021ef5cc80a2061805003300000,
     657: 112'he021ef5cc80a2061805003300000,
// WT27.INTRPT
     658: 112'he000c445780a2000005043300000,
     659: 112'he000c405000a2000005103300000,
     660: 112'h32920405000a2000005003300016,    // a= WT27.INTRPT
     661: 112'he000c714780a2000005043300000,
     662: 112'he000c405000aa000005003300000,
     663: 112'h10832c39020aa0000050033b0856,    // a= ERRINT
     664: 112'h32892c3e820a20000050033b08c0,    // a= CC27.INTRPT
// П28
     665: 112'h329a0405000a2000005003300000,    // a= CONT28.INTRPT
// CONT28.INTRPT
     666: 112'he082ec7c000a20600050033b0800,
     667: 112'he0a5e475000a2061805003300000,
     668: 112'he000ee7e800a20000050033b0980,
// CC28.INTRPT
     669: 112'he000c405000a2000005003300640,
     670: 112'he000e675000a20000050033b0880,
     671: 112'he067ec79000a20600050033b0840,
     672: 112'h10830405000a2000005003300026,    // a= ERRINT
// WA28.INTRPT
     673: 112'h32a10405000a2000005303300026,    // a= WA28.INTRPT
     674: 112'he000c47d000a04482050433a08c1,
     675: 112'h32a60405000aa000005003300016,    // a= RR28.INTRPT
     676: 112'he011e475000a20600050033b08c0,
     677: 112'h32a70405000a2000005003300000,    // a= MAS28.INTRPT
// RR28.INTRPT
     678: 112'he067e475000a20600050033b08c0,
// MAS28.INTRPT
     679: 112'h10dc0405000a2000005103300000,    // a= INTMAS
// WT28.INTRPT
     680: 112'he000c445780a2000005043300000,
     681: 112'he000c405000a2000005103300000,
     682: 112'h32a80405000a2000005003300016,    // a= WT28.INTRPT
     683: 112'he000c47d000a04482050433a08c1,
     684: 112'h32af0405000aa000005003300016,    // a= RRI28.INTRPT
     685: 112'he011e475000a20600050033b08c0,
     686: 112'h32b00405000a2000005003300000,    // a= NMB28.INTRPT
// RRI28.INTRPT
     687: 112'he067e475000a20600050033b08c0,
// NMB28.INTRPT
     688: 112'he000c31c780a2000005043300000,
     689: 112'he000c405000aa000005003300000,
     690: 112'h10832c39020aa0000050033b0856,    // a= ERRINT
     691: 112'h329d2c3e820a20000050033b0980,    // a= CC28.INTRPT
// П29
     692: 112'h32b50405000a2000005003300000,    // a= CONT29.INTRPT
// CONT29.INTRPT
     693: 112'he081ec7c000a20600050033b0800,
     694: 112'he000ee7e800a20000050033b08c0,
// CC29.INTRPT
     695: 112'h107b0405000a2000005003300000,    // a= BEGINT
     696: 112'he024eddcc80a2061805003300000,
     697: 112'h10dc0405000a2000005103300000,    // a= INTMAS
     698: 112'h10d20e7f000a2000005003300000,    // a= INTWAT
     699: 112'h32b72c3e820a20000050033b08c0,    // a= CC29.INTRPT
// П30
     700: 112'h32bd0405000a2000005003300000,    // a= CONT30.INTRPT
// CONT30.INTRPT
     701: 112'he07fec7c000a20600050033b0800,
     702: 112'he000ee7e800a20000050033b08c0,
// CC30.INTRPT
     703: 112'h107b0405000a2000005003300000,    // a= BEGINT
// WA30.INTRPT
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
