besm6/micro-besm/(commit log)

2016-10-03 Fix test status: pass/fail.
    [gen-test-vectors.c, test_2901.sv]
2016-10-09 Mclink: replace startup routine. Fix bug in symbol table.
    [microcode.v]
2016-10-09 Mclink: print referenced labels.
2016-10-19 Cpu test: print all opcode fields.
2016-10-19 Cpu test: move tracer to a separate module.
2016-10-19 Tracer: print changed state.
2016-10-19 Tracer: correctly print opcode at execution stage.
    [tracer.sv]
2016-10-19 Enhance tracer output.
2016-10-20 Fix undefines in ALU.
    [am2901.sv, am2902.sv, am2904.sv, am2910.sv, cpu.sv, datapath.sv, extbus.sv, k1802bb1.sv]
2016-10-22 Fix reset state of arbiter.
    [cpu.sv, tracer.sv]
2016-10-23 Fix bugs in standardizer.
    [decoder.sv, gen-test.c, gen.sv, standardizer.sv]
2016-10-24 Mcasm: generate separate files for rwio, groups and interrupt ROM tables.
2016-10-27 Fix bug in pc_f in tracer.
    [cpu.sv, initest.sv, tracer.sv]
2016-10-27 Fix status 'yes' in cpu.
    [cpu.sv]
2016-10-27 Fix a couple of issues in cpu and tracer. Use op names in am2910.
    [am2910.sv, cpu.sv, initest.sv, tracer.sv]
2016-10-27 Fix pc value in tracer.
    [initest.sv, tracer.sv]
2016-10-29 Fix bug in initest pass routine.
    [initest.sv]
2016-11-02 Fix bug in uSR.Z status bit.
    [datapath.sv, tracer.sv]
2016-11-02 Properly assign ALU status bits. Keep carry bit zero when undefined. Implement ddev=STATUS case.
2016-11-02 Fix carry-in signal in ALU.
    [cpu.sv, datapath.sv]
2016-11-03 Fix writing alu.MSR from Y bus.
    [am2904.sv, cpu.sv, datapath.sv]
2016-11-03 Fix shift issues in ALU.
    [am2904.sv, cpu.sv, datapath.sv]
2016-11-03 Fix 32-bit ALU mode.
    [cpu.sv, datapath.sv]
2016-11-03 Fix D input for am2910.
    [cpu.sv]
2016-11-04 Fix shifter: initest passed.
    [cpu.sv, shifter.sv]
2016-11-04 Fix ncsim issues. Build sectest.
    [sectest.v, shifter.sv, tracer.sv]
2016-11-04 Fix issues with ncsim and vcs.
    [am2901.sv, tracer.sv]
2016-11-05 Move tracer to rtl directory.
2016-11-05 Update tracer.
2016-11-05 Fix a few verilog warnings.
    [am2901.sv, cpu.sv, tracer.sv]
2016-11-05 Fix reading modifier memory.
    [cpu.sv, tracer.sv]
2016-11-05 Fix modifier index width.
    [cpu.sv]
2016-11-06 Fix bug in sectest: missing DSRC=PROM parameter when loading constant.
    [sectest.sv, sectest.v]
2016-11-06 Trace changed page access modes.
2016-11-06 Fix reading page access bits.
    [cpu.sv]
2016-11-06 Implement automatic filling of reprio memory. Fix bug in sectest (actually a workaround for old hardware bug).
    [cpu.sv, sectest.v, tracer.sv]
2016-11-06 Fix extbus nRD signal.
    [extbus.sv]
2016-11-08 Add code for i8253 timer.
2016-11-09 Tracer: print timer registers.
2016-11-10 Use 1:2 clock for timer0 and 1:20 clock for timer2.
2016-11-11 Add BCD mode to the i8253 timer. Also have to reduce a delay in the sectest to make the timer test pass with 2MHz system clock and 1MHz/100kHz timer clocks.
2016-11-11 Fix out signals and clean undefined state in i8253.
    [i8253.sv]
2016-11-11 Modify sectest to correctly compare time intervals.
    [i8253.sv, sectest.sv, sectest.v]
2016-11-11 Timer: always update counter on write, even when counting.
2016-11-11 Implement halt signal. Fix bugs in sectest.
    [cpu.sv, sectest.sv, sectest.v, tracer.sv]
2016-11-11 Fix races in tracer. Update i8253 timer.
    [i8253.sv, sectest.sv, tracer.sv]
2016-11-12 Fix writing to RGi registers. Make k1802bb1 chip purely synchronous.
    [cpu.sv, extbus.sv, k1802bb1.sv, octtest.sv, octtest.v, sectest.sv, tracer.sv]
2016-11-12 Sign extend address field of instruction. Trace tkk bit.
2016-11-12 Fix bug in test CST13: missing register inversion.
    [octtest.sv, octtest.v]
2016-11-13 Fix bug in octtest: need bit ALU to write a constant from prom to ureg (via alu).
    [cpu.sv, octtest.v, tracer.sv]
2016-11-13 Print MODGN correctly.
2016-11-13 Fix bug in test CST15 (instruction decoder).
    [octtest.sv, octtest.v]
2016-11-17 Fix page mapping. Fix bug in octtest: incorrect check for bobr, bizm.
    [cpu.sv, octtest.v]
2016-11-17 Fix another bug in octtest: the test passed.
    [octtest.sv, octtest.v]
2016-11-18 Memtest: fix arithmetic expressions in address.
    [memtest.sv, memtest.v]
2016-11-18 Arbiter: add reset signal.
    [arbiter.sv, cpu.sv]
2016-11-19 Fix r/w operations in arbiter.
    [arbiter.sv, memtest.sv, tracer.sv]
2016-11-20 Arbiter: fix r-m-w mode. Memtest passed.
    [arbiter.sv, memtest.sv]
2016-11-21 Add a database of all instruction opcodes. Tracer: print disassembled opcode.
2016-11-21 Arbiter: fix stray memory store. Need to latch the opcode.
    [arbiter.sv, memtest.sv, tracer.sv]
2016-11-21 Cpu test: fix waddr reference.
    [test_cpu.sv, tracer.sv]
2016-11-21 Fix trace=0 option.
2016-11-27 Implement rwio ROM for RMOD, WMOD instructions. Cpu test: print chanded state in trace=1 mode.
2016-11-28 Latch rwio_addr instead of instr_addr. Fix tracing instruction opcodes.
    [cpu.sv, tracer.sv]
2016-12-01 Switch besm6 mode based on fetch tag.
2016-12-01 Tracer: print besm6 opcodes.
2016-12-06 Add interrupt flags.
2016-12-07 Print simulation speed.
2016-12-07 Print virtual addresses for memory transactions. Fix wrong paddr for fetch.
    [cpu.sv, initest.sv, intrtest.sv, memtest.sv, octtest.sv, sectest.sv, test_cpu.sv, tracer.sv]
2016-12-08 Tracer: print interrupt flags.
2016-12-09 Tracer: print RRR change.
2016-12-09 Intrtest: add interrupt handler.
2016-12-09 Jump to address 001 on interrupt.
2016-12-09 Implement jump to interrupt vector.
2016-12-10 Fix interrupt numbering. Implement 'foreign accumulator' interrupt.
    [cpu.sv, intrtest.sv]
2016-12-10 Implement interrupt 22: foreign operand.
2016-12-10 Implement interrupt 11: load inhibit.
2016-12-10 Implement interrupt 12: instruction check.
2016-12-10 Implement interrupt 18: fetch inhibit.
2016-12-10 Implement interrupt 19: jump projection.
2016-12-11 Implement interrupt 20: address write protection.
2016-12-11 Fix bug in octtest: undefined besm6 mode as a result of wrong fetch.
    [octtest.v]
2016-12-11 Fix Xes in octtest.
    [octtest.sv, tracer.sv]
2016-12-11 Skip int12,13 step in intrtest. Revert change in octtest.
    [intrtest.sv, octtest.v]
2016-12-12 Implement int14 and int15: process number mismatch for current page.
2016-12-12 Implement int30 and int31: clock and timer. Fix timer interrupt clear in intrtest.
    [cpu.sv, intrtest.v]
2016-12-15 Implement single-step interrupt.
2016-12-15 Add signals for external interrupts.
2016-12-15 Intrtest: fix intmas+1 address.
    [intrtest.v]
2016-12-16 Implement int4: soft interrupt.
2016-12-18 Don't print instruction in case of interrupt.
2016-12-19 Print besm instruction properly.
2016-12-19 Split up internal interrupts (exceptions) and external interrupts.
2016-12-19 Invert CEMLRG option: whether to check format of accumulator in BESM-6 mode.
    [cpu.sv]
2016-12-20 Fix MD constant: microcode assembler does not tolerate spaces inside numbers.
    [constants.v]
2016-12-20 Fix bug in XTS with zero virtual address.
    [cpu.sv]
2016-12-21 Fix bug in besm6 instruction decoder.
    [decoder.sv]
2016-12-22 Fix bug in ACX instruction: zero executive address causes exception, which clobbers alu.MSR register, used in the counting loop.
    [grouptab.v, intrtab.v, microcode.v, optab.v, rwiotab.v]
2016-12-22 Print opcode correctly in besm6 mode. Update test.asm.
    [tracer.sv]
2016-12-22 Fix encoding of RETS instruction.
    [optab.v]
2016-12-23 Stop simulation on HLT instruction. Move tracing stuff from arbiter to tracer.
2016-12-23 Initest: invert bit CEMLRG.
    [initest.v]
2016-12-30 Fix bug in IJP instruction: incorrect restore of RR.
    [cpu.sv]
2016-12-31 Do not copy ТКК to ППК when interrupt is active.
2017-01-01 Don't clear ПИА flag on interrupt.
2017-01-03 Fix '15 wtc' issue: don't set ПИА flag on interrupt.
    [cpu.sv]
2017-01-07 Initest: get rid of stray single-step interrupt. Keep interrupts disabled.
2017-01-07 Fix sign extension of short addresses for besm6 instructions.
    [decoder.sv]
2017-01-08 Update octtest to match changes in arbiter for short-address besm6 instructions: clear sign bit in opcode and sign extend the address to 32 bits.
    [octtest.sv, octtest.v]
2017-01-08 Fix octtest: uninitialized map for page #0.
    [octtest.sv]
2017-01-08 Print correct virtual address of memory transactions.
    [test_cpu.sv]
2017-01-09 Fix write protection tag bit.
    [arbiter.sv, cpu.sv, tracer.sv]
2017-01-11 Update the complex test to halt on error. Fix write protection by address (tag bit).
    [cpu.sv]
2017-01-11 Write protection on address (tag bit): take exception, not interrupt.
2017-01-20 Macro50: print image in octal.
2017-01-21 Whetstone test: save and restore accumulator on extracode interrupt.
2017-01-27 Memtest modified to match the implementation. Arbiter operation RDMWR is no longer expected to modify bit 56 of the target word. Current microcode of istructions SEMR and SMON does not require it.
    [memtest.sv, memtest.v]
2017-01-28 Modify intrtest to match RTL: handle write protection bit in tag as exception, not interrupt.
2017-02-06 Add schematics.
2017-07-14 Add schematics pages 5-9.
2018-02-02 Fix multiple drivers issue for signals cb, rcb, flag_jump, no_intr, grp.
    [cpu.sv]
2025-03-01 Fix issues in assembler.
2026-09-09 Added Verilator flow
    Converted DPI-C to acceptable for Verilator.
